vankxr/icyradio/software/driver/README.md

# Kernel driver
This folder contains the Linux kernel driver sources
