vankxr/icyradio/software/pmc/README.md

# Power Management Controller
This folder contains the software for the UPD301C power management controller
