vankxr/icyradio/software/exp/template/README.md

# Expansion Board Template Controller
This folder contains the software for the SAMD21 MCU in the expansion board template PCB
