vankxr/icyradio/docs/pm-block-diagram.png

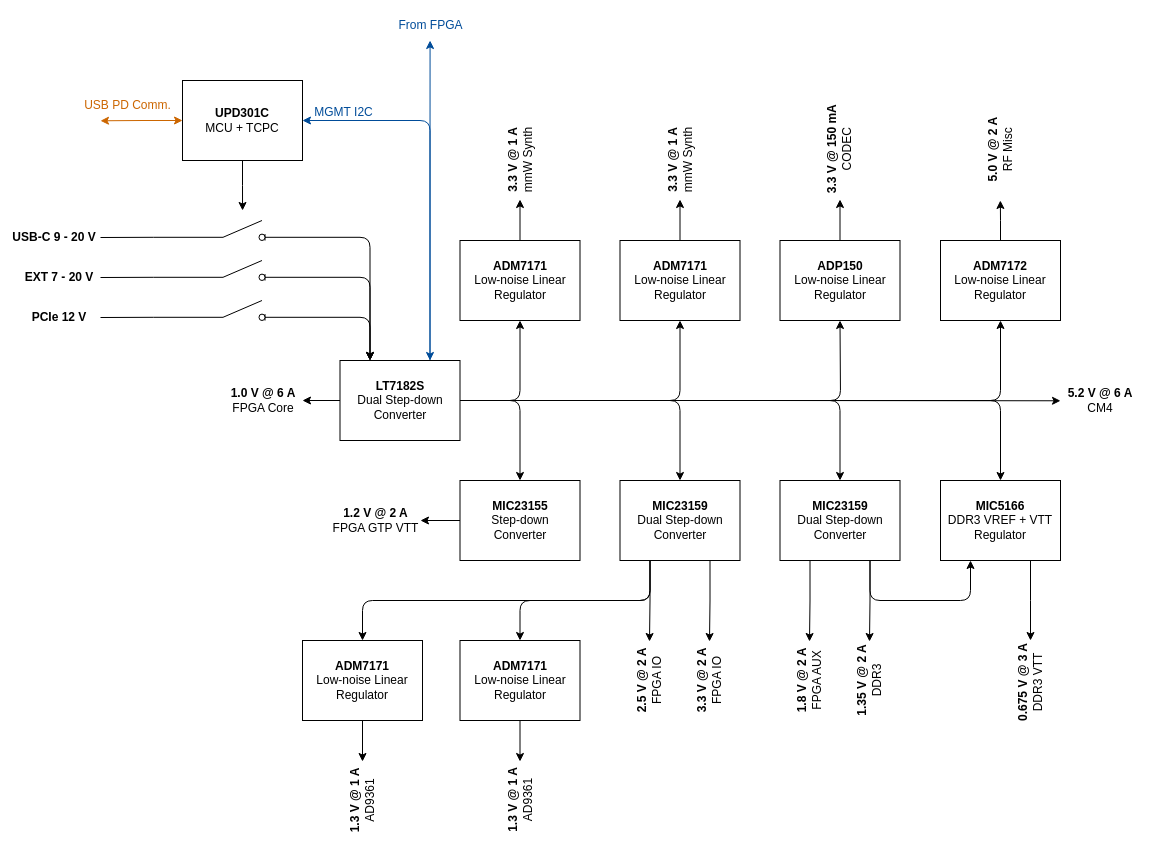
docs/pm-block-diagram.png
