vankxr/icyradio/pcb/exp-template/icyradio-exp-template-bot.png

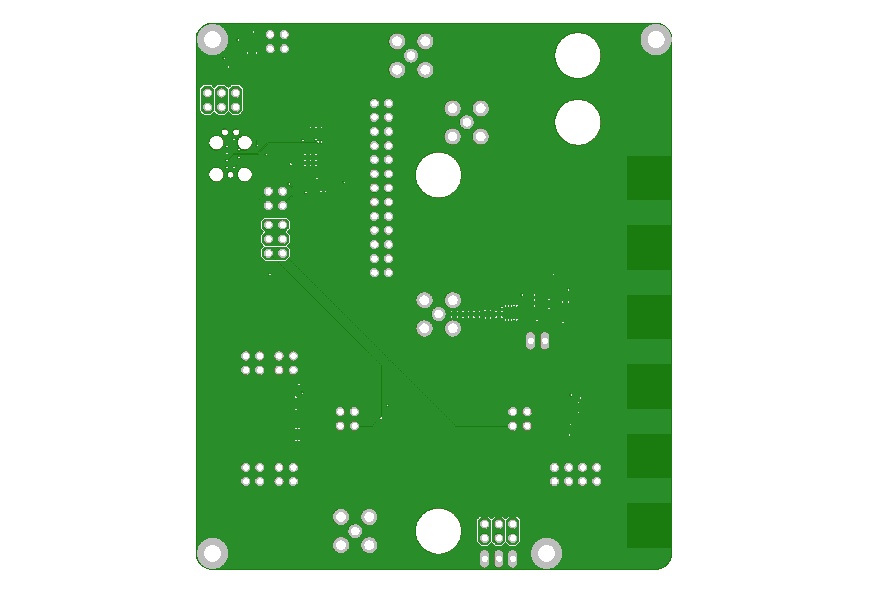
pcb/exp-template/icyradio-exp-template-bot.png
