vankxr/icyradio/pcb/exp-template/icyradio-exp-template-top.png

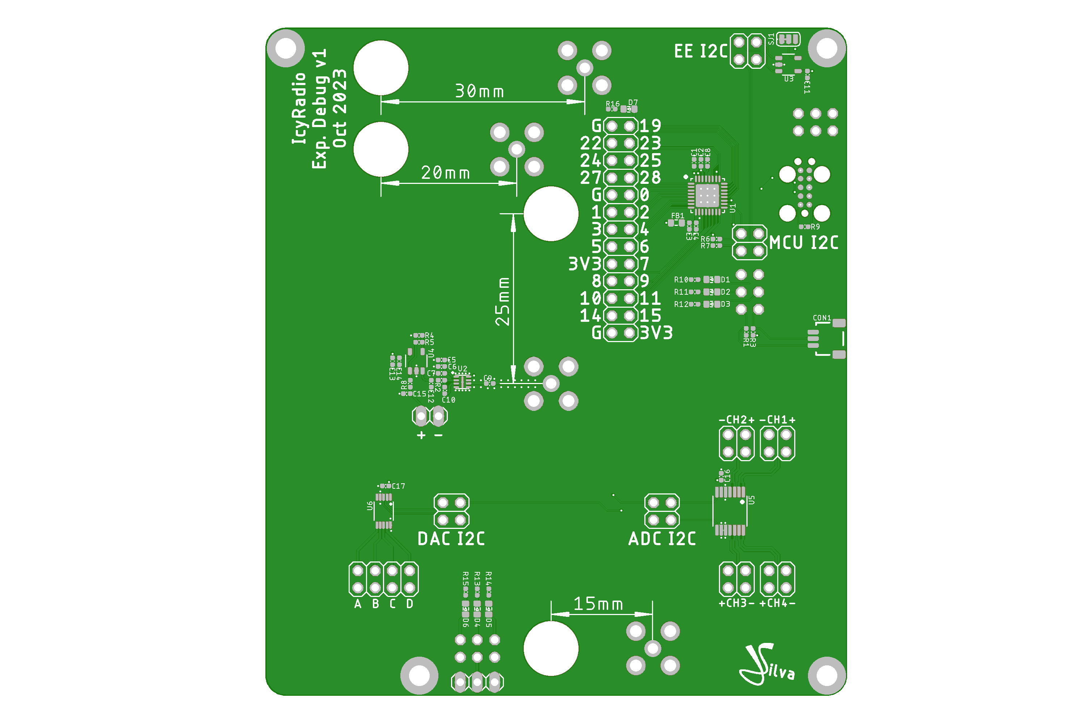
pcb/exp-template/icyradio-exp-template-top.png
