vankxr/icyradio/pcb/lna/icyradio-lna.bot.png

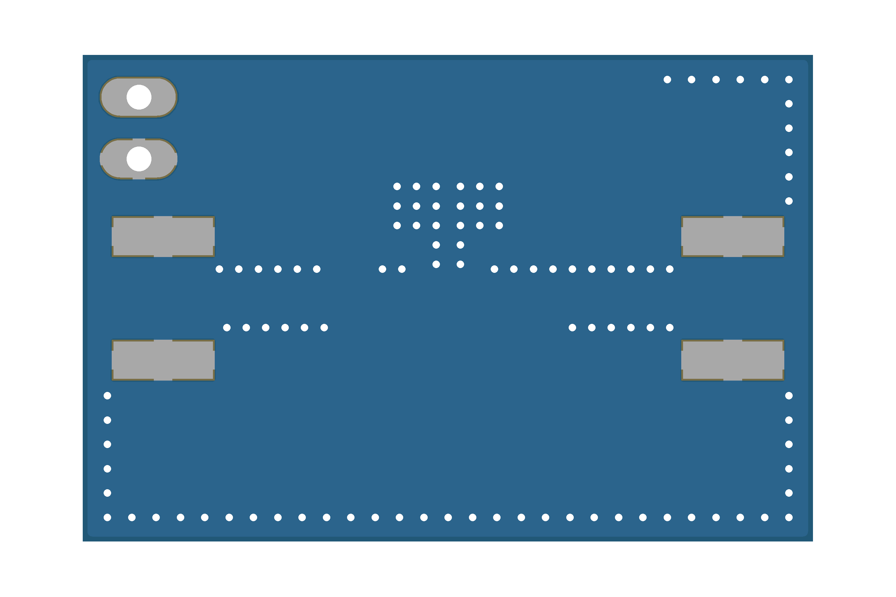
pcb/lna/icyradio-lna.bot.png
