vankxr/icyradio/pcb/lna/icyradio-lna.top.png

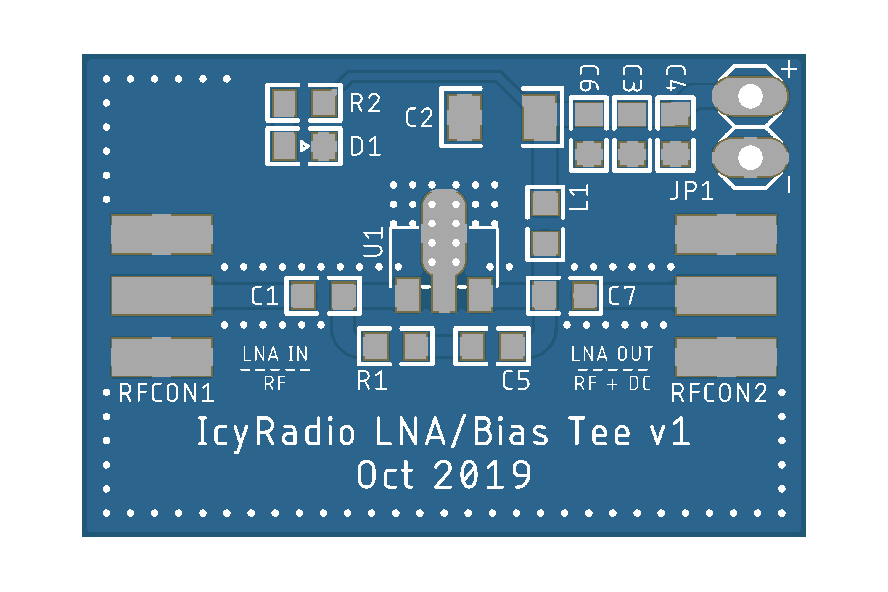
pcb/lna/icyradio-lna.top.png
