vankxr/icyradio/pcb/main/icyradio-main.bot.png

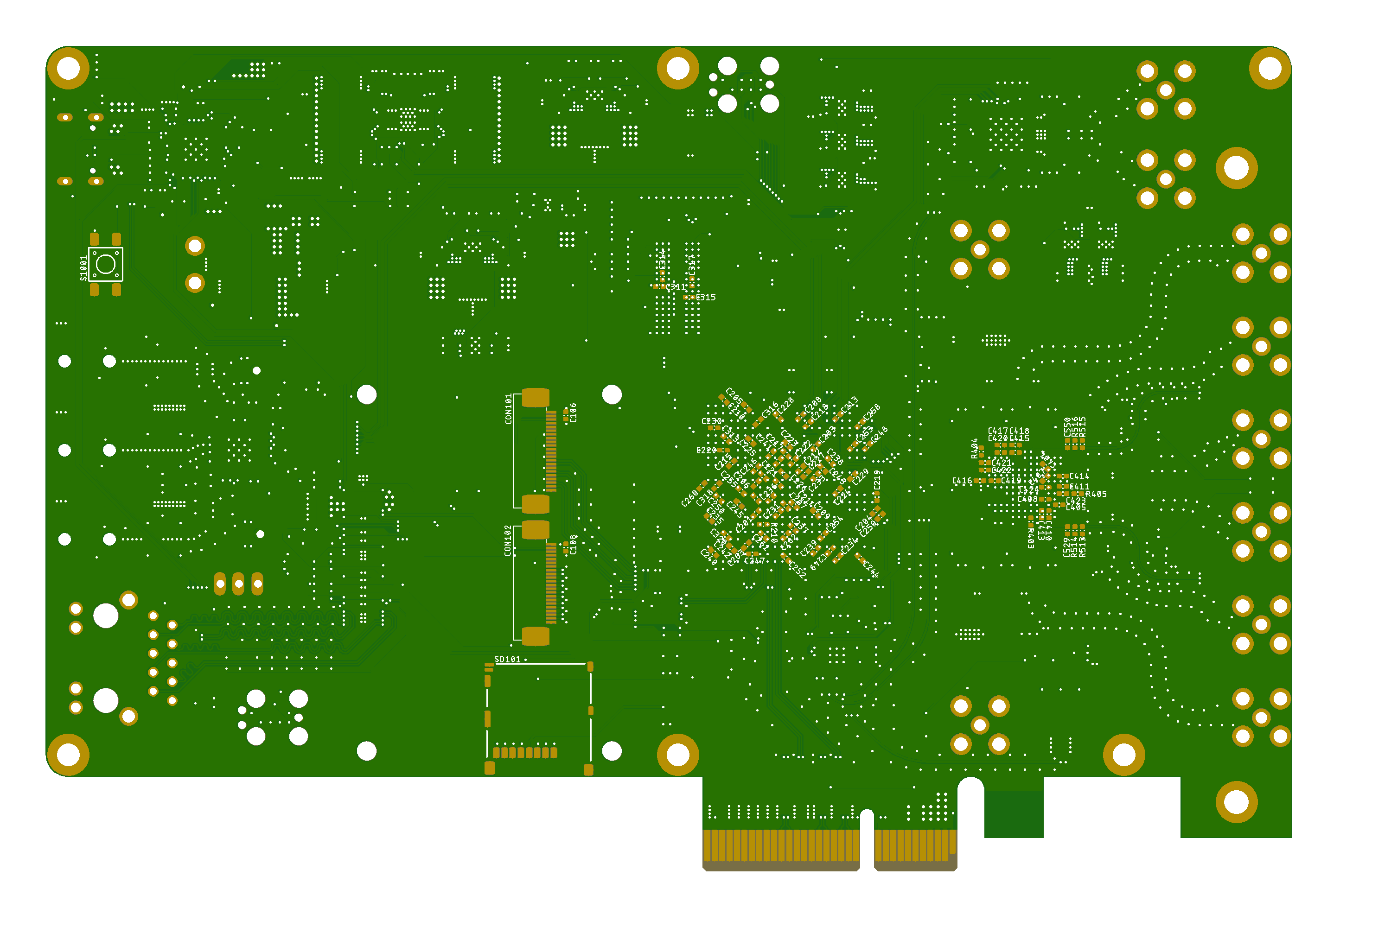
pcb/main/icyradio-main.bot.png
