vankxr/icyradio/pcb/main/icyradio-main.pdf

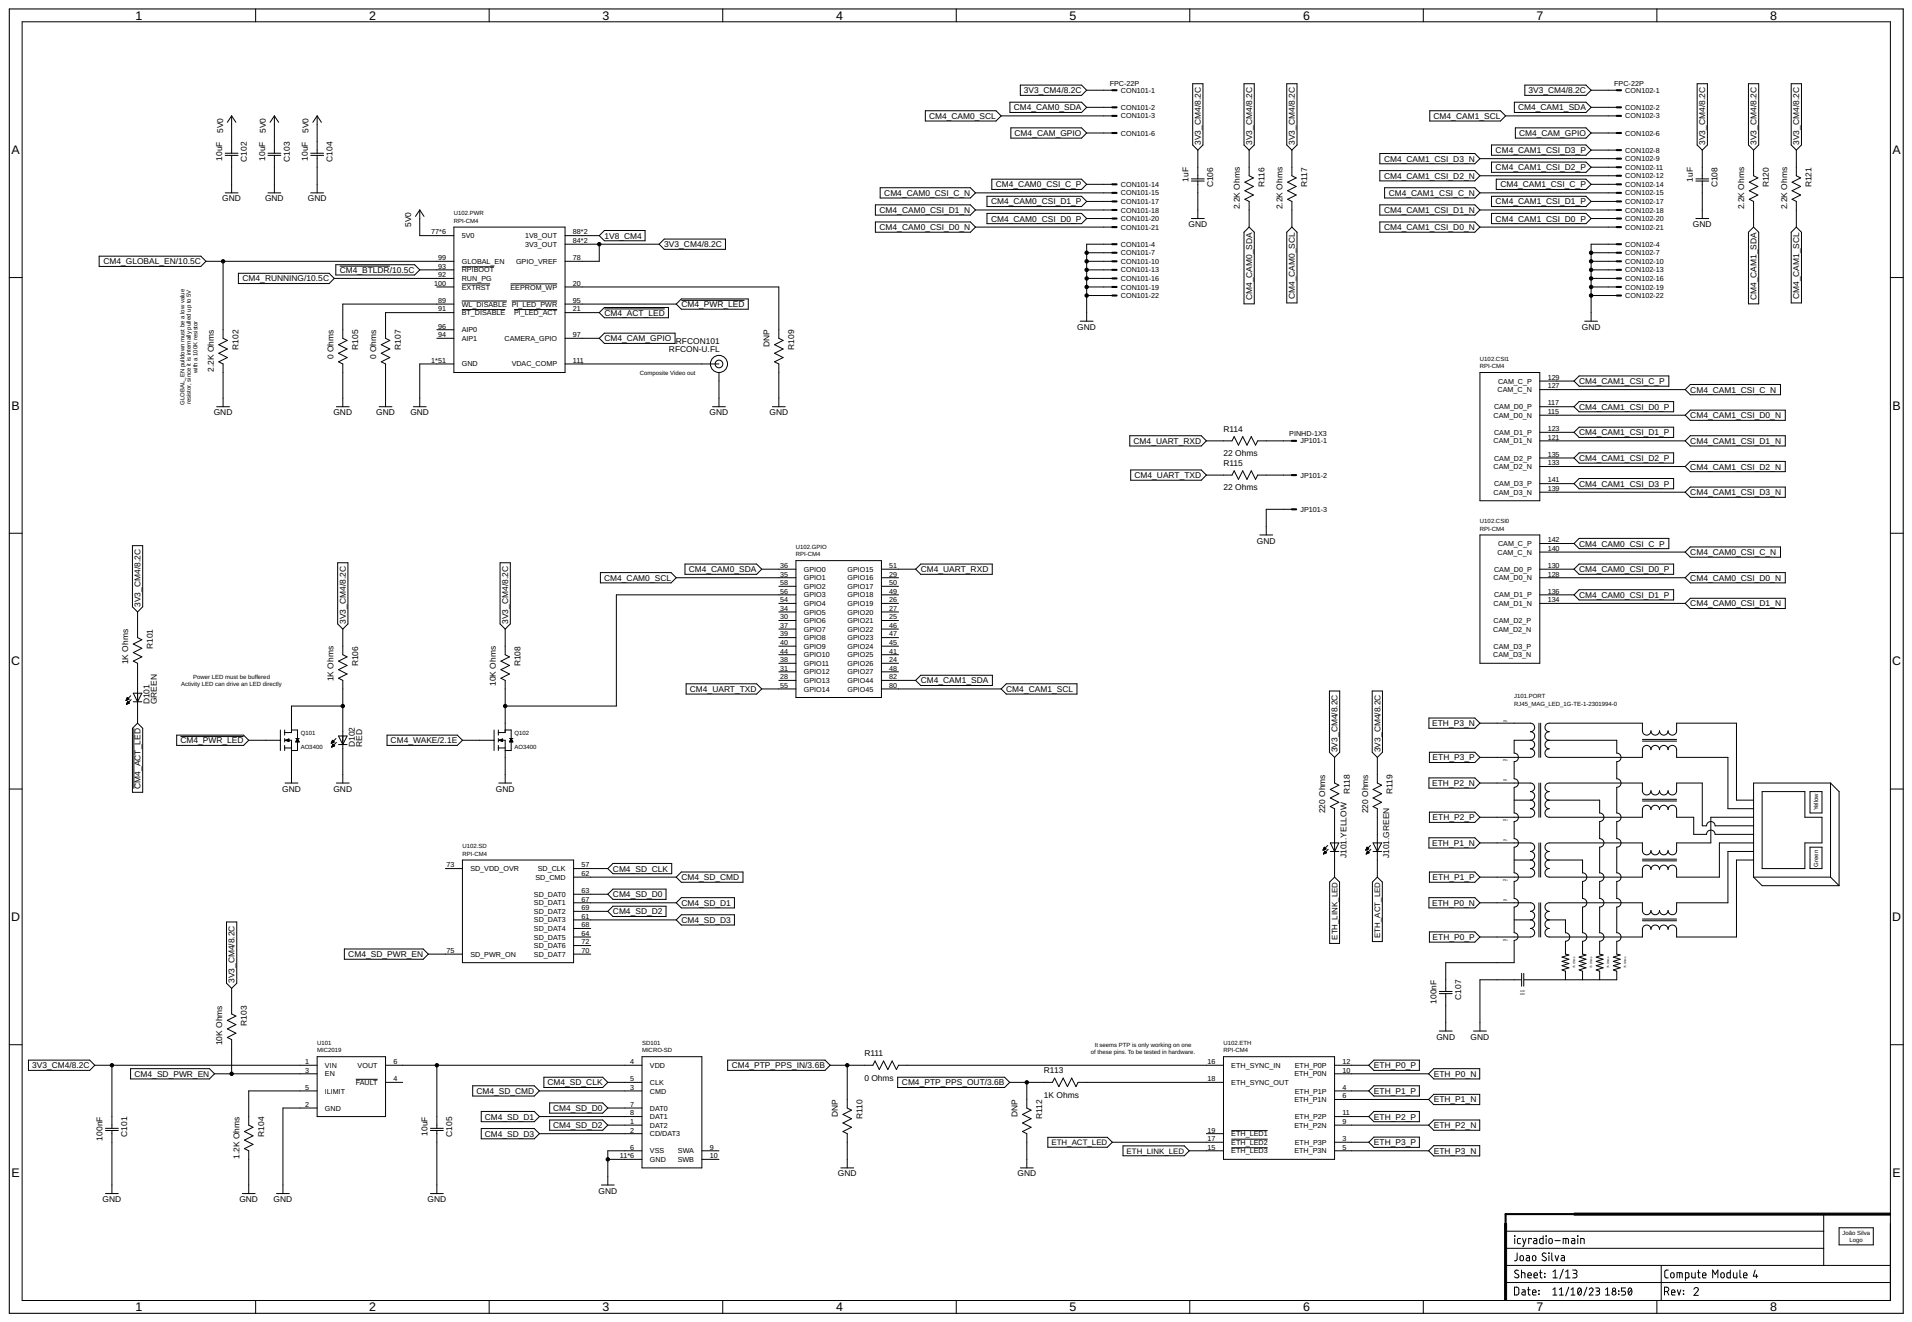
[picture p11: page 1]

GLOBAL_EN pulldown must be a low value

resistor, since it is internally pulled up to 5V with a 100K resistor

Power LED must be buffered Activity LED can drive an LED directly

It seems PTP is only working on one
of these pins. To be tested in hardware.

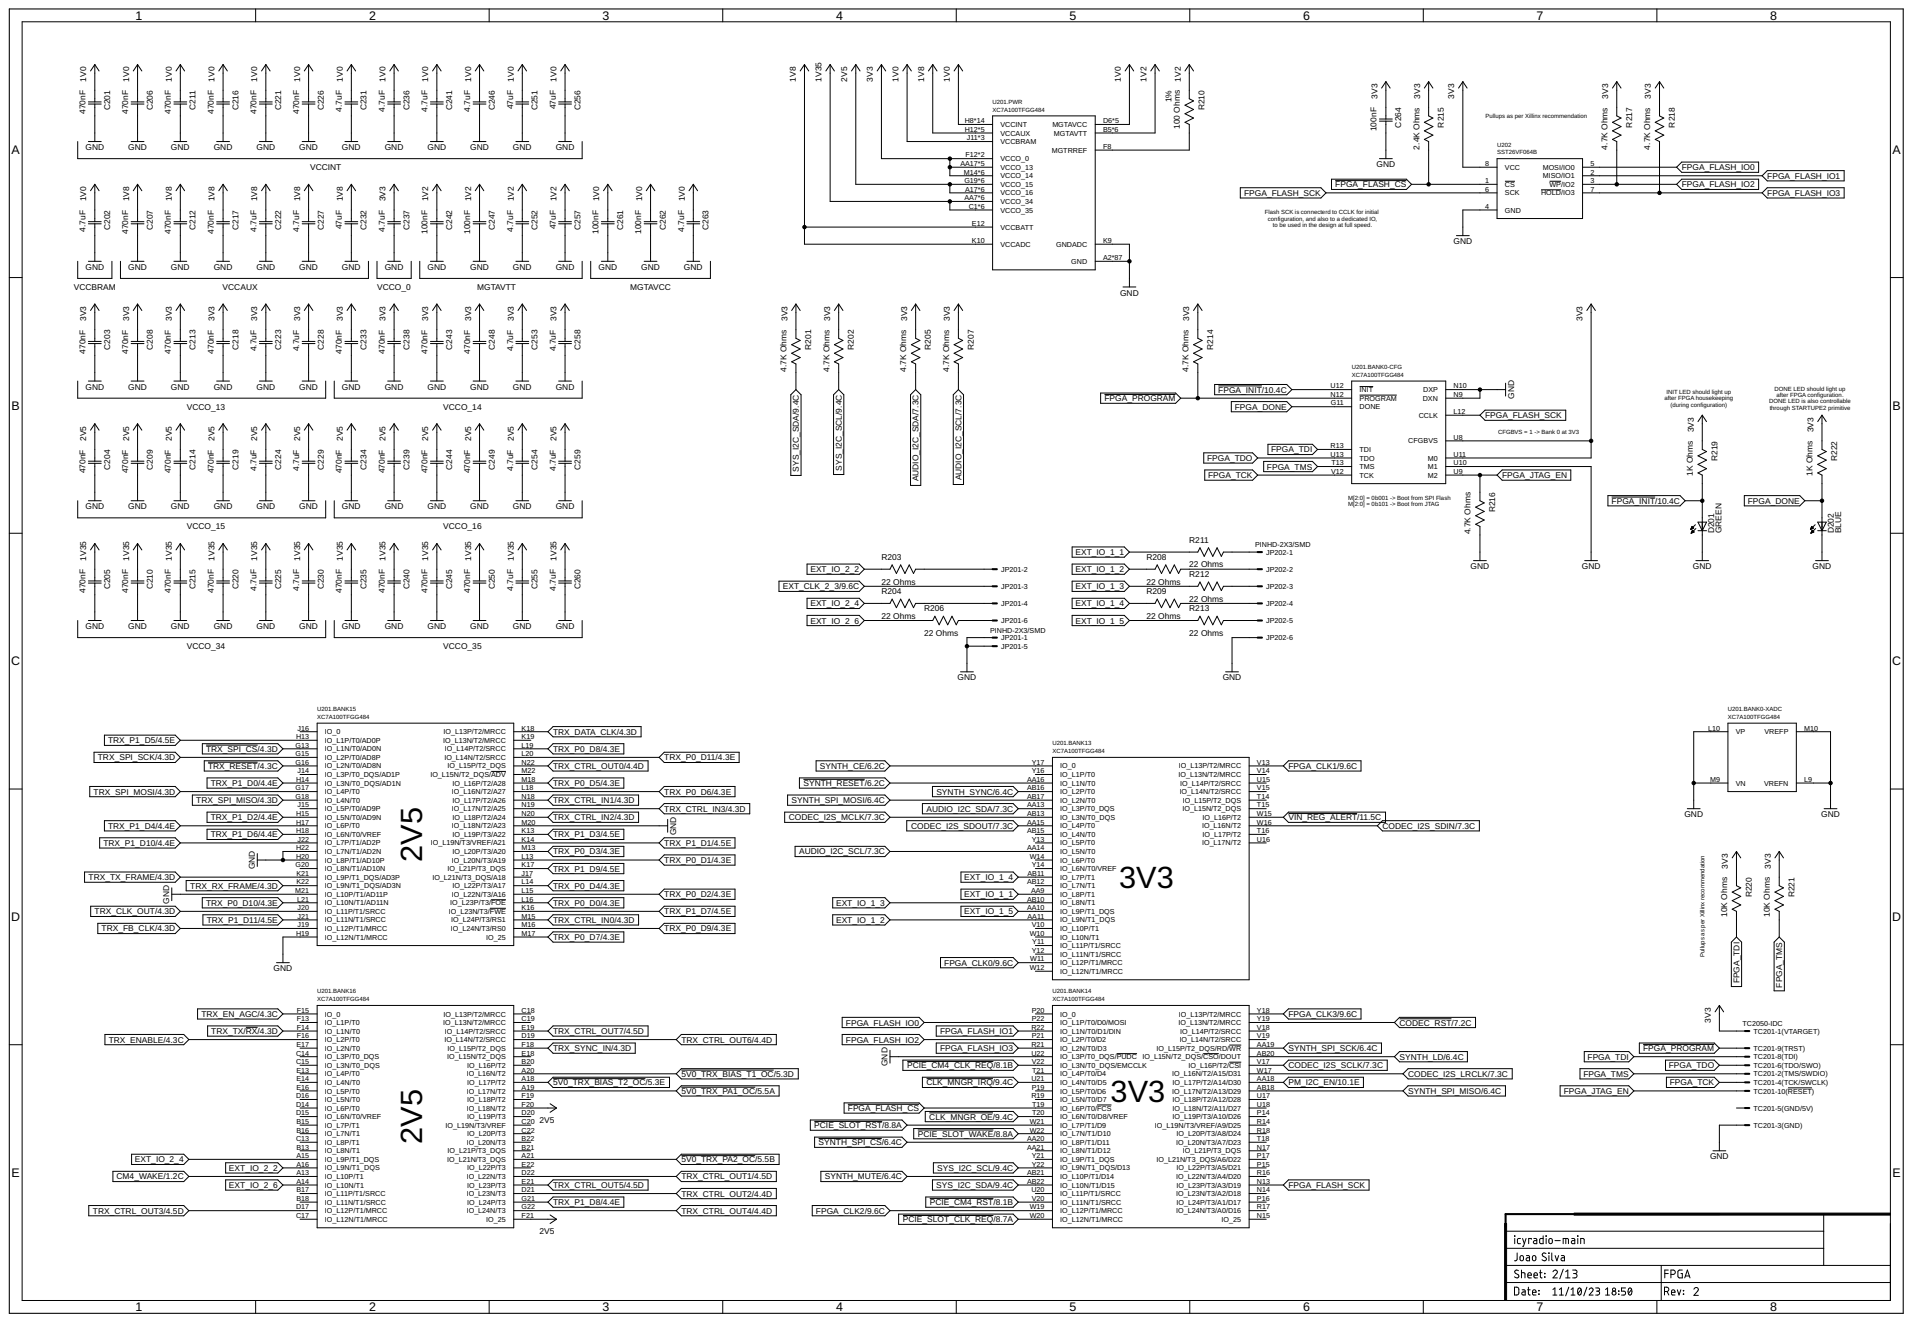
[picture p12: page 2]

Pullups as per Xillinx recommendation

Flash SCK is connecterd to CCLK for initial configuration, and also to a dedicated IO,

to be used in the design at full speed.

INIT LED should light up
after FPGA housekeeping

after FPGA configuration. DONE LED is also controllable

M[2:0] = 0b001 -> Boot from SPI Flash M[2:0] = 0b101 -> Boot from JTAG

22 Ohms 22 Ohms 22 Ohms 22 Ohms 22 Ohms GND

TC2050-IDC
TC201-1(VTARGET) TC201-2(TMS/SWDIO) TC201-3(GND)

TC201-9(TRST)
TC201-6(TDO/SWO) TC201-10(RESET) TC201-8(TDI)

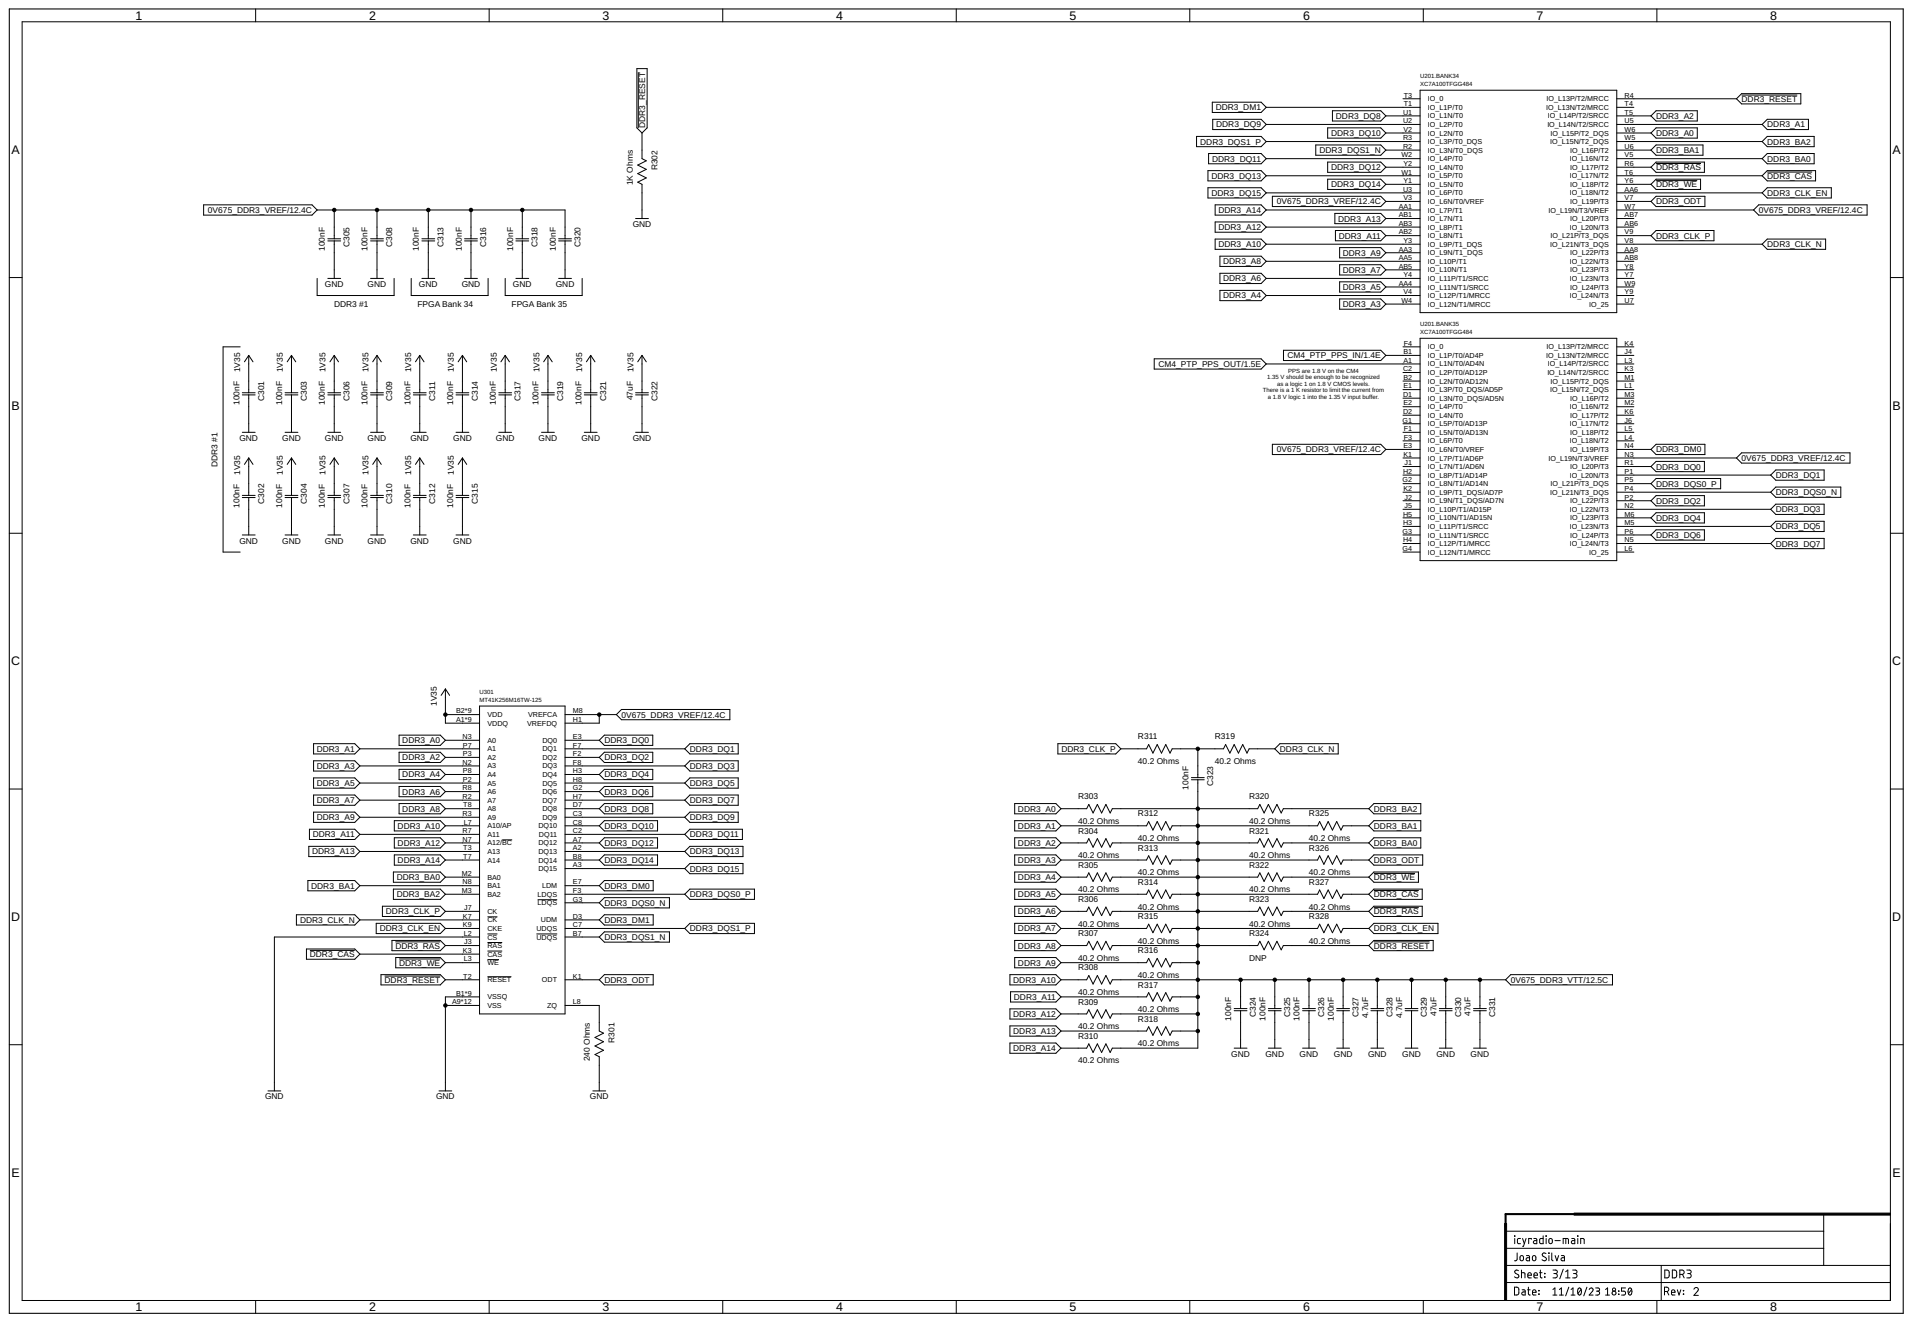
[picture p13: page 3]

1.35 V should be enough to be recognized
as a logic 1 on 1.8 V CMOS levels. There is a 1 K resistor to limit the current from

PPS are 1.8 V on the CM4

a 1.8 V logic 1 into the 1.35 V input buffer.

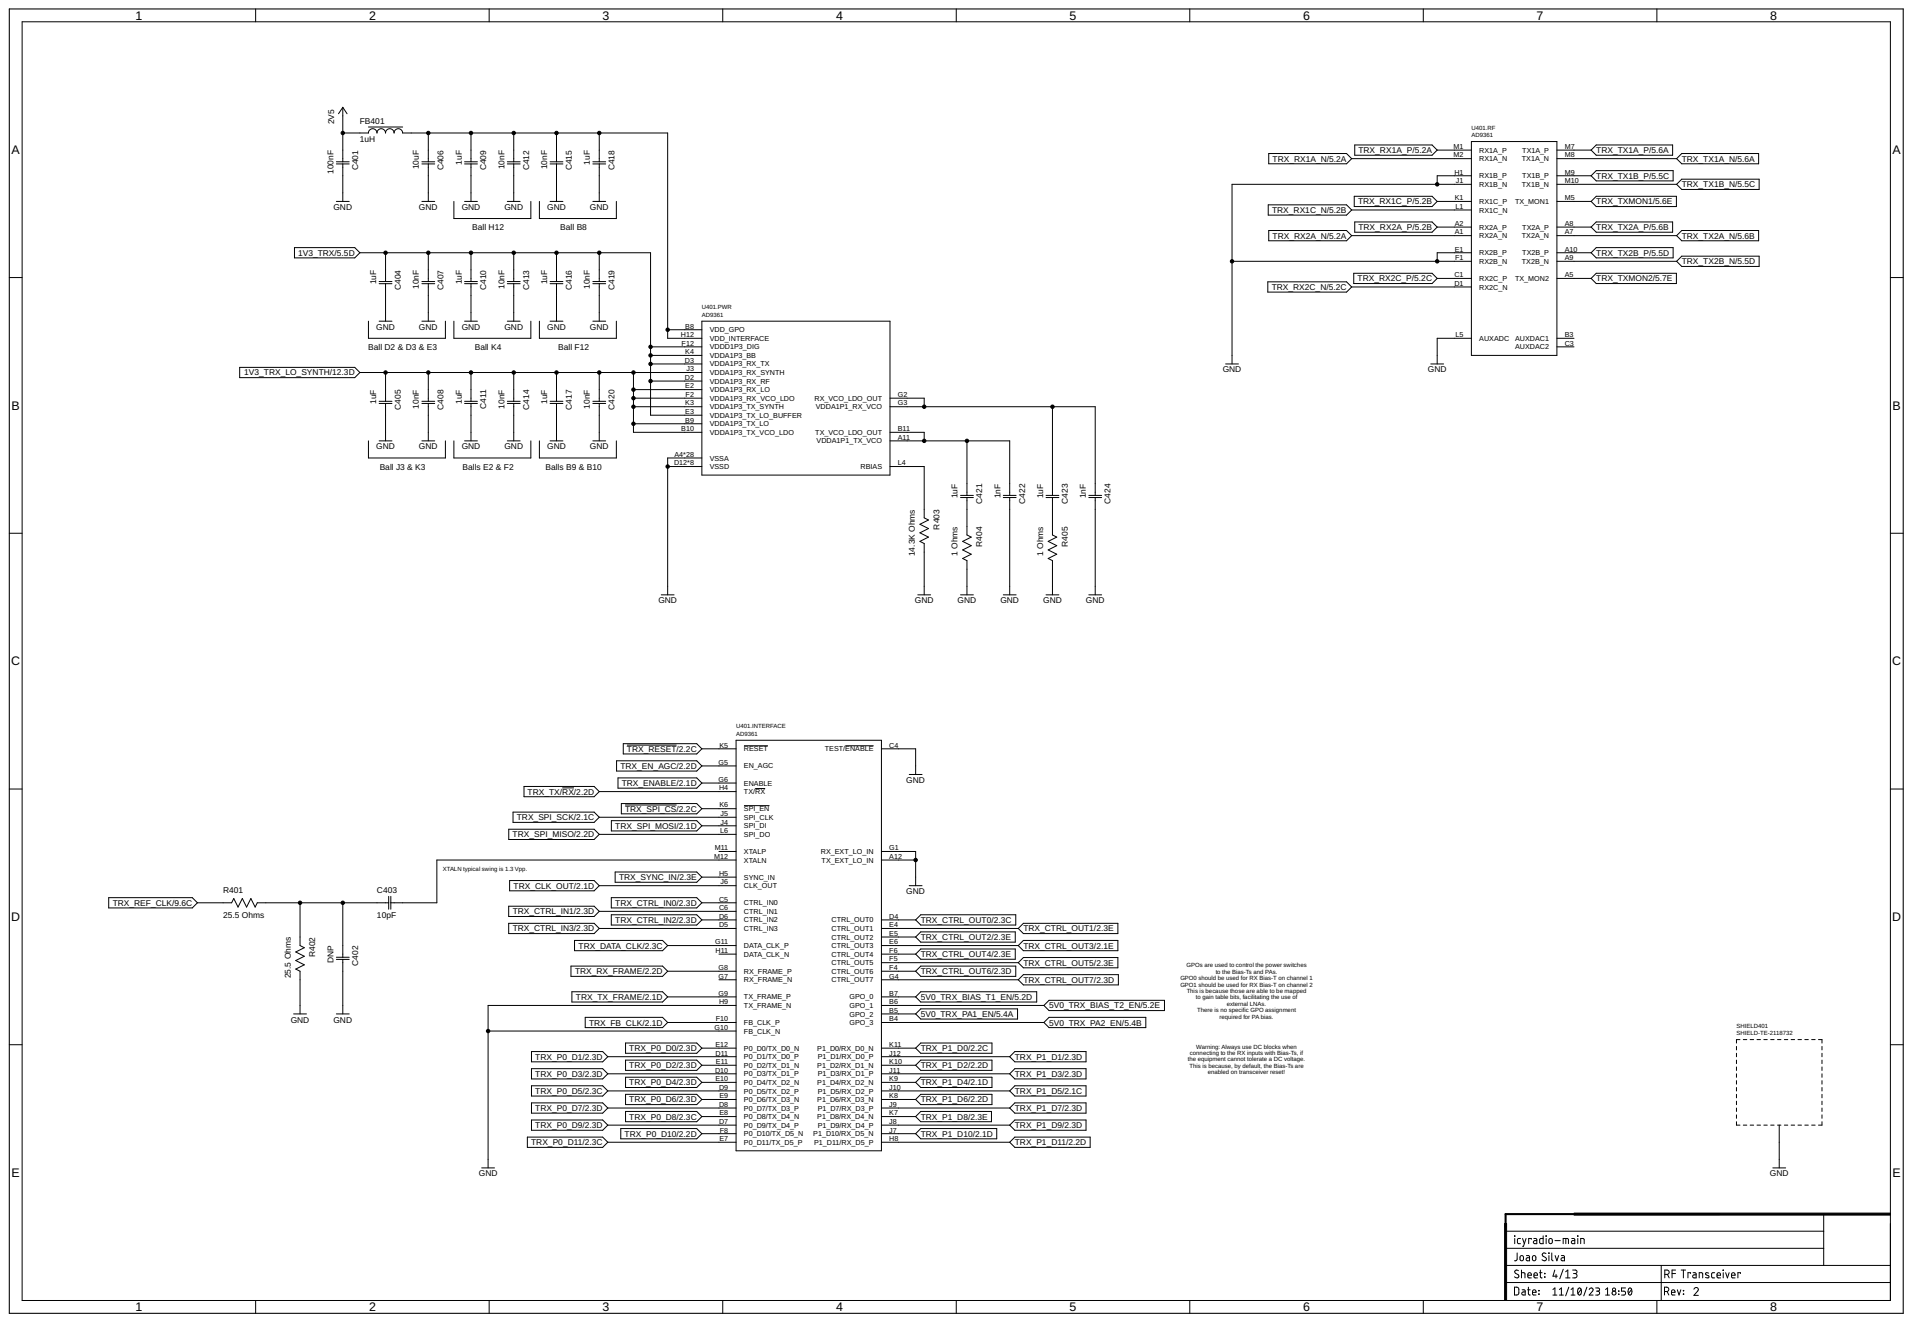
[picture p14: page 4]

XTALN typical swing is 1.3 Vpp.

GPOs are used to control the power switches
to the Bias-Ts and PAs. GPO0 should be used for RX Bias-T on channel 1 GPO1 should be used for RX Bias-T on channel 2 This is because those are able to be mapped

to gain table bits, facilitating the use of external LNAs. There is no specific GPO assignment required for PA bias. Warning: Always use DC blocks when

connecting to the RX inputs with Bias-Ts, if
the equipment cannot tolerate a DC voltage. This is because, by default, the Bias-Ts are

enabled on transceiver reset!

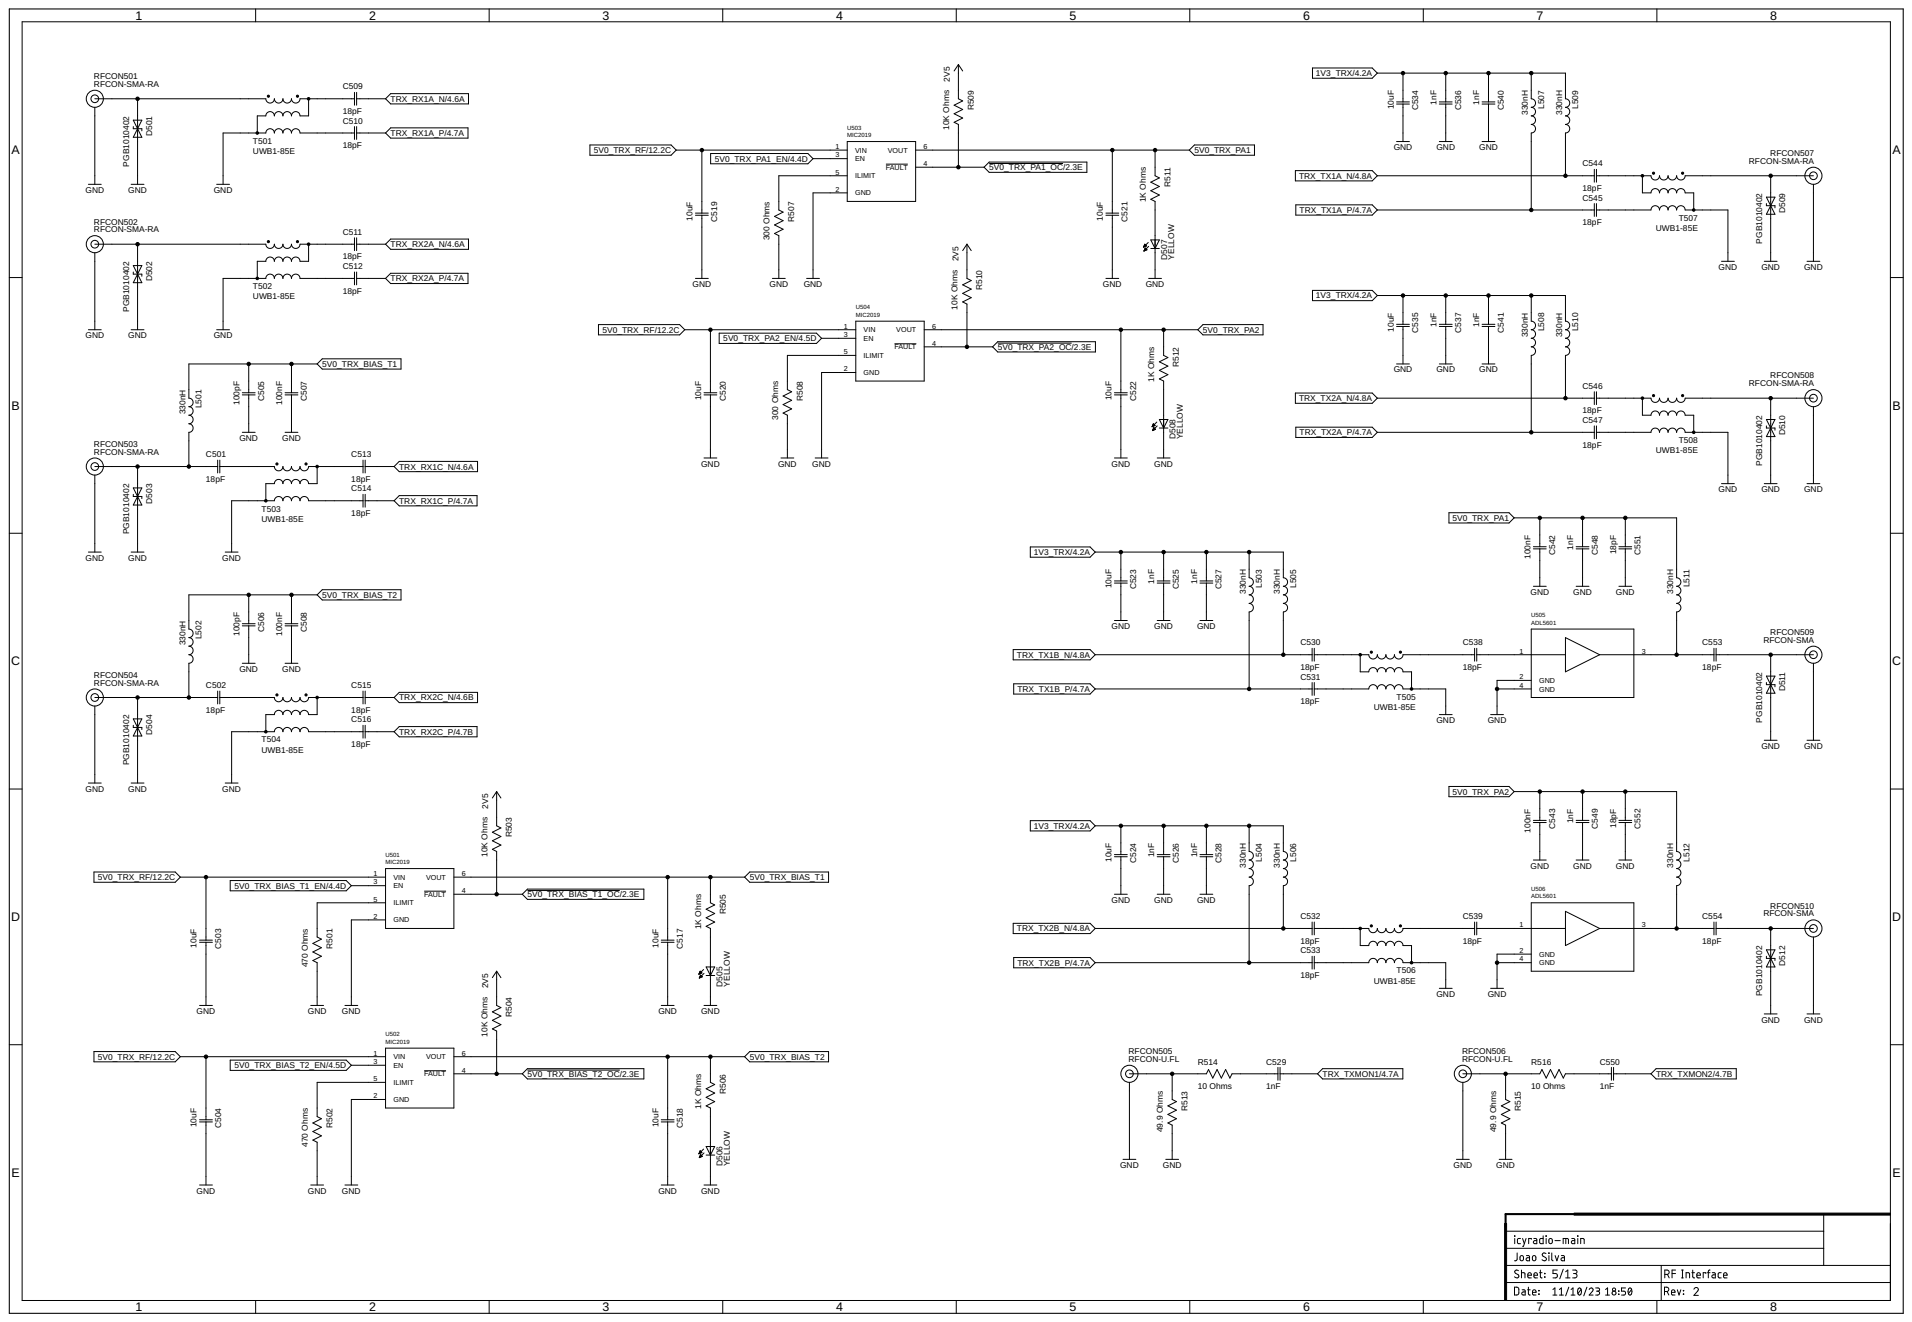
[picture p15: page 5]

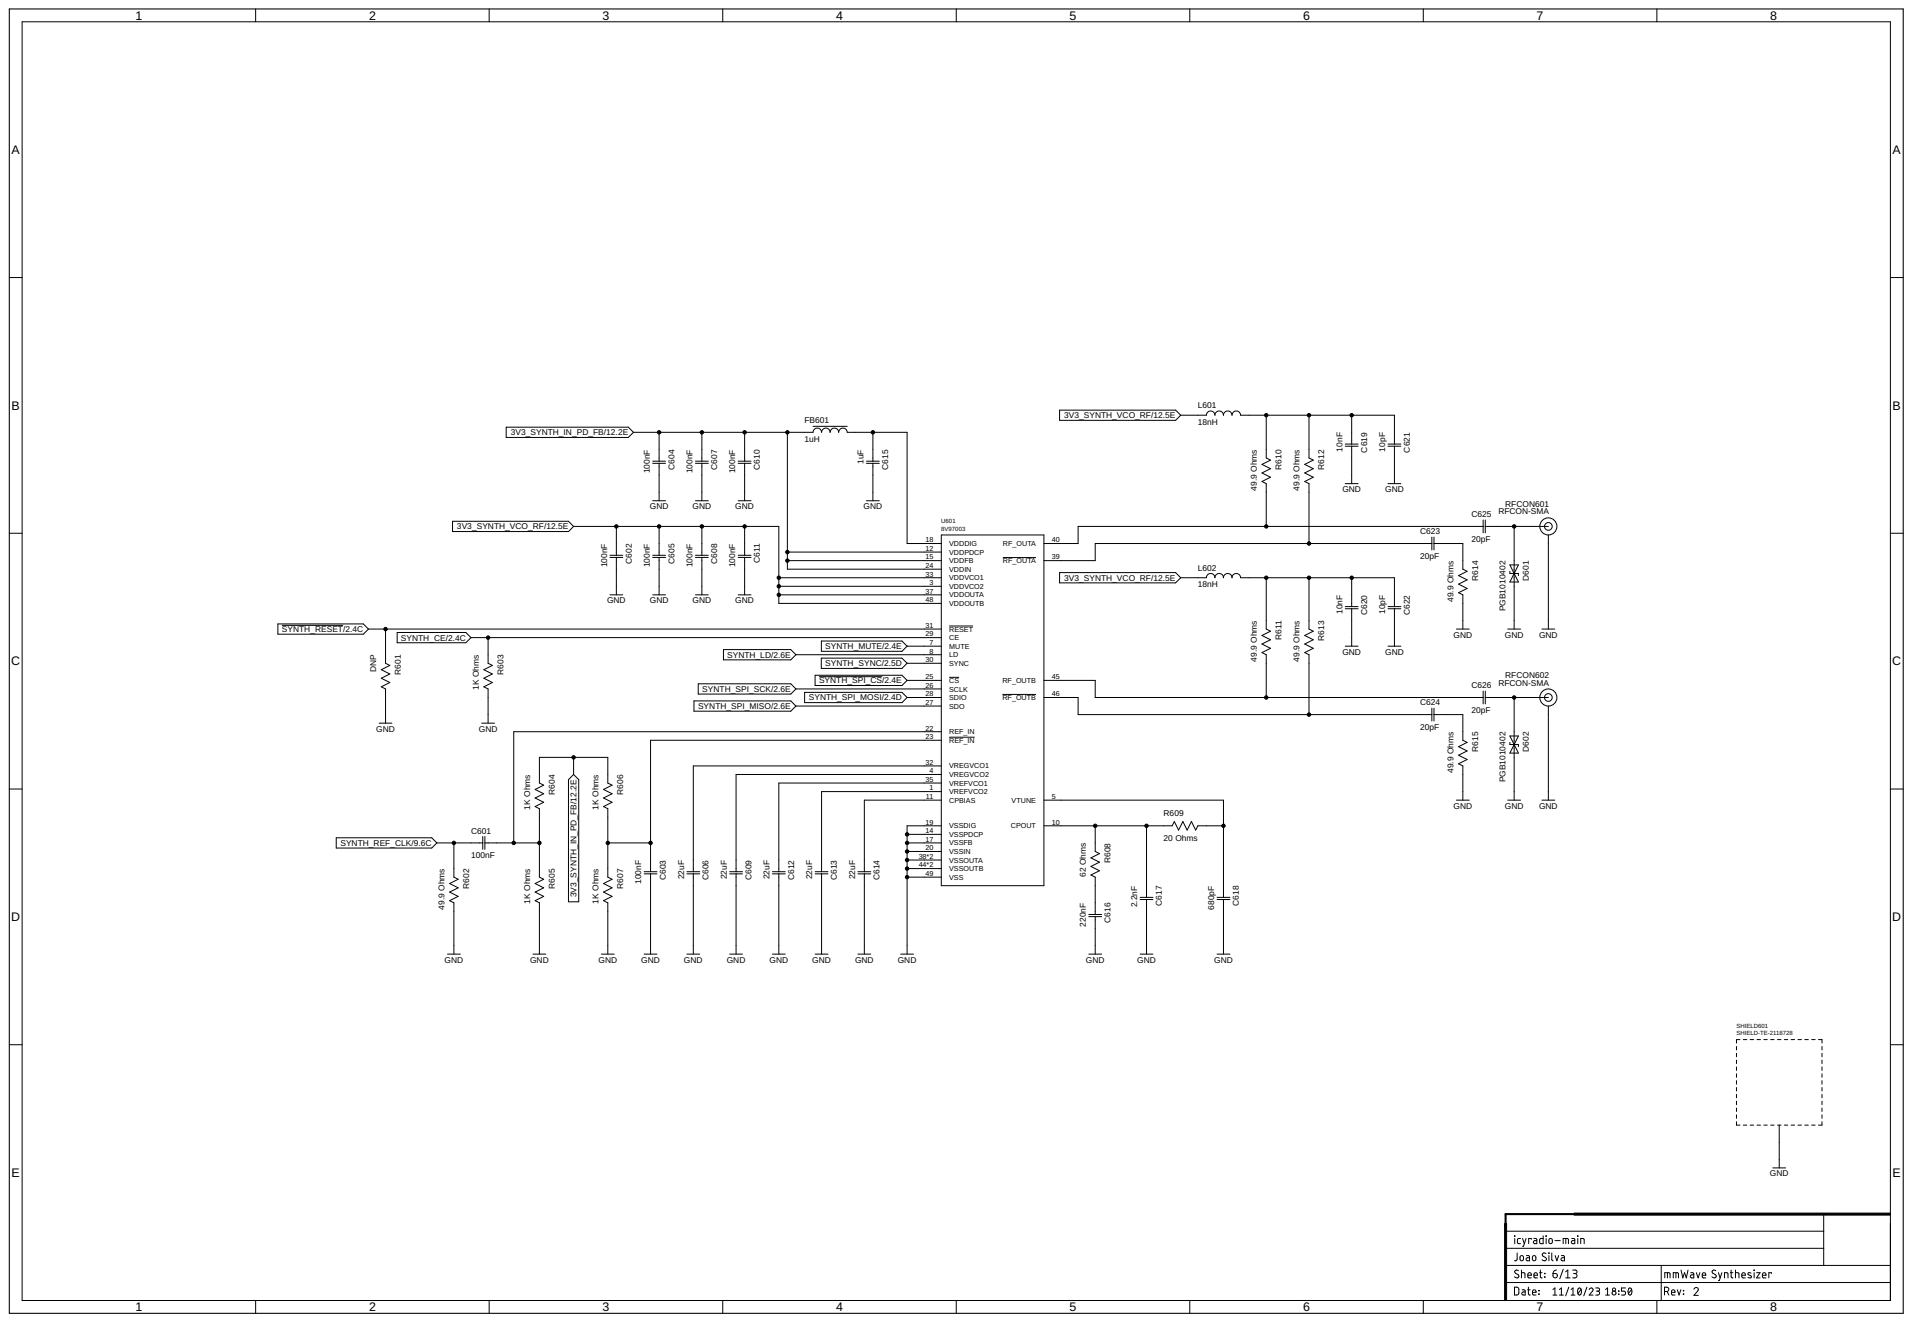
[picture p16: page 6]

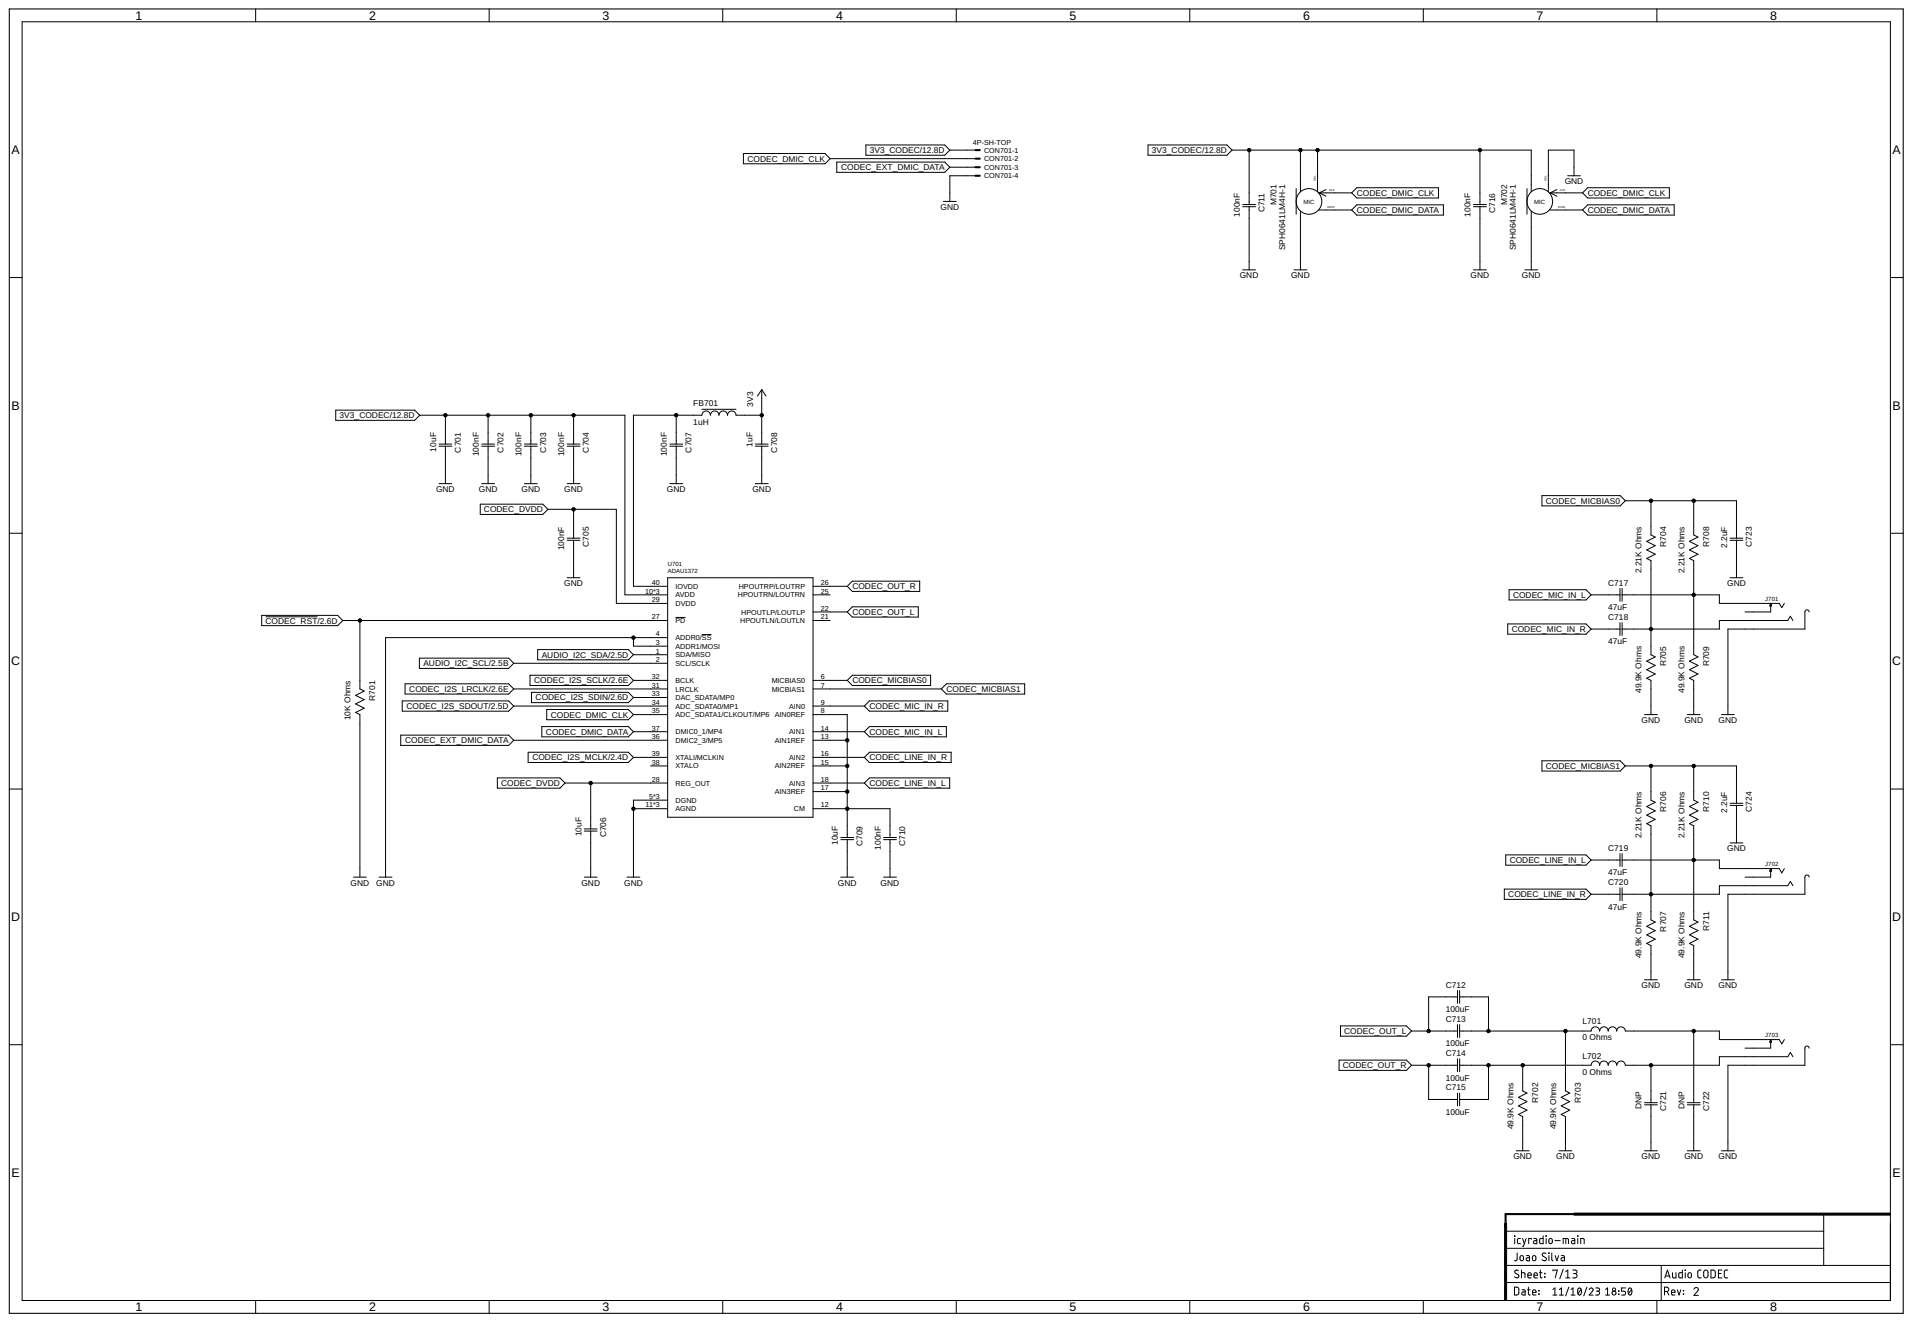
[picture p17: page 7]

100nF GND GND GND GND

49.9K Ohms GND GND GND

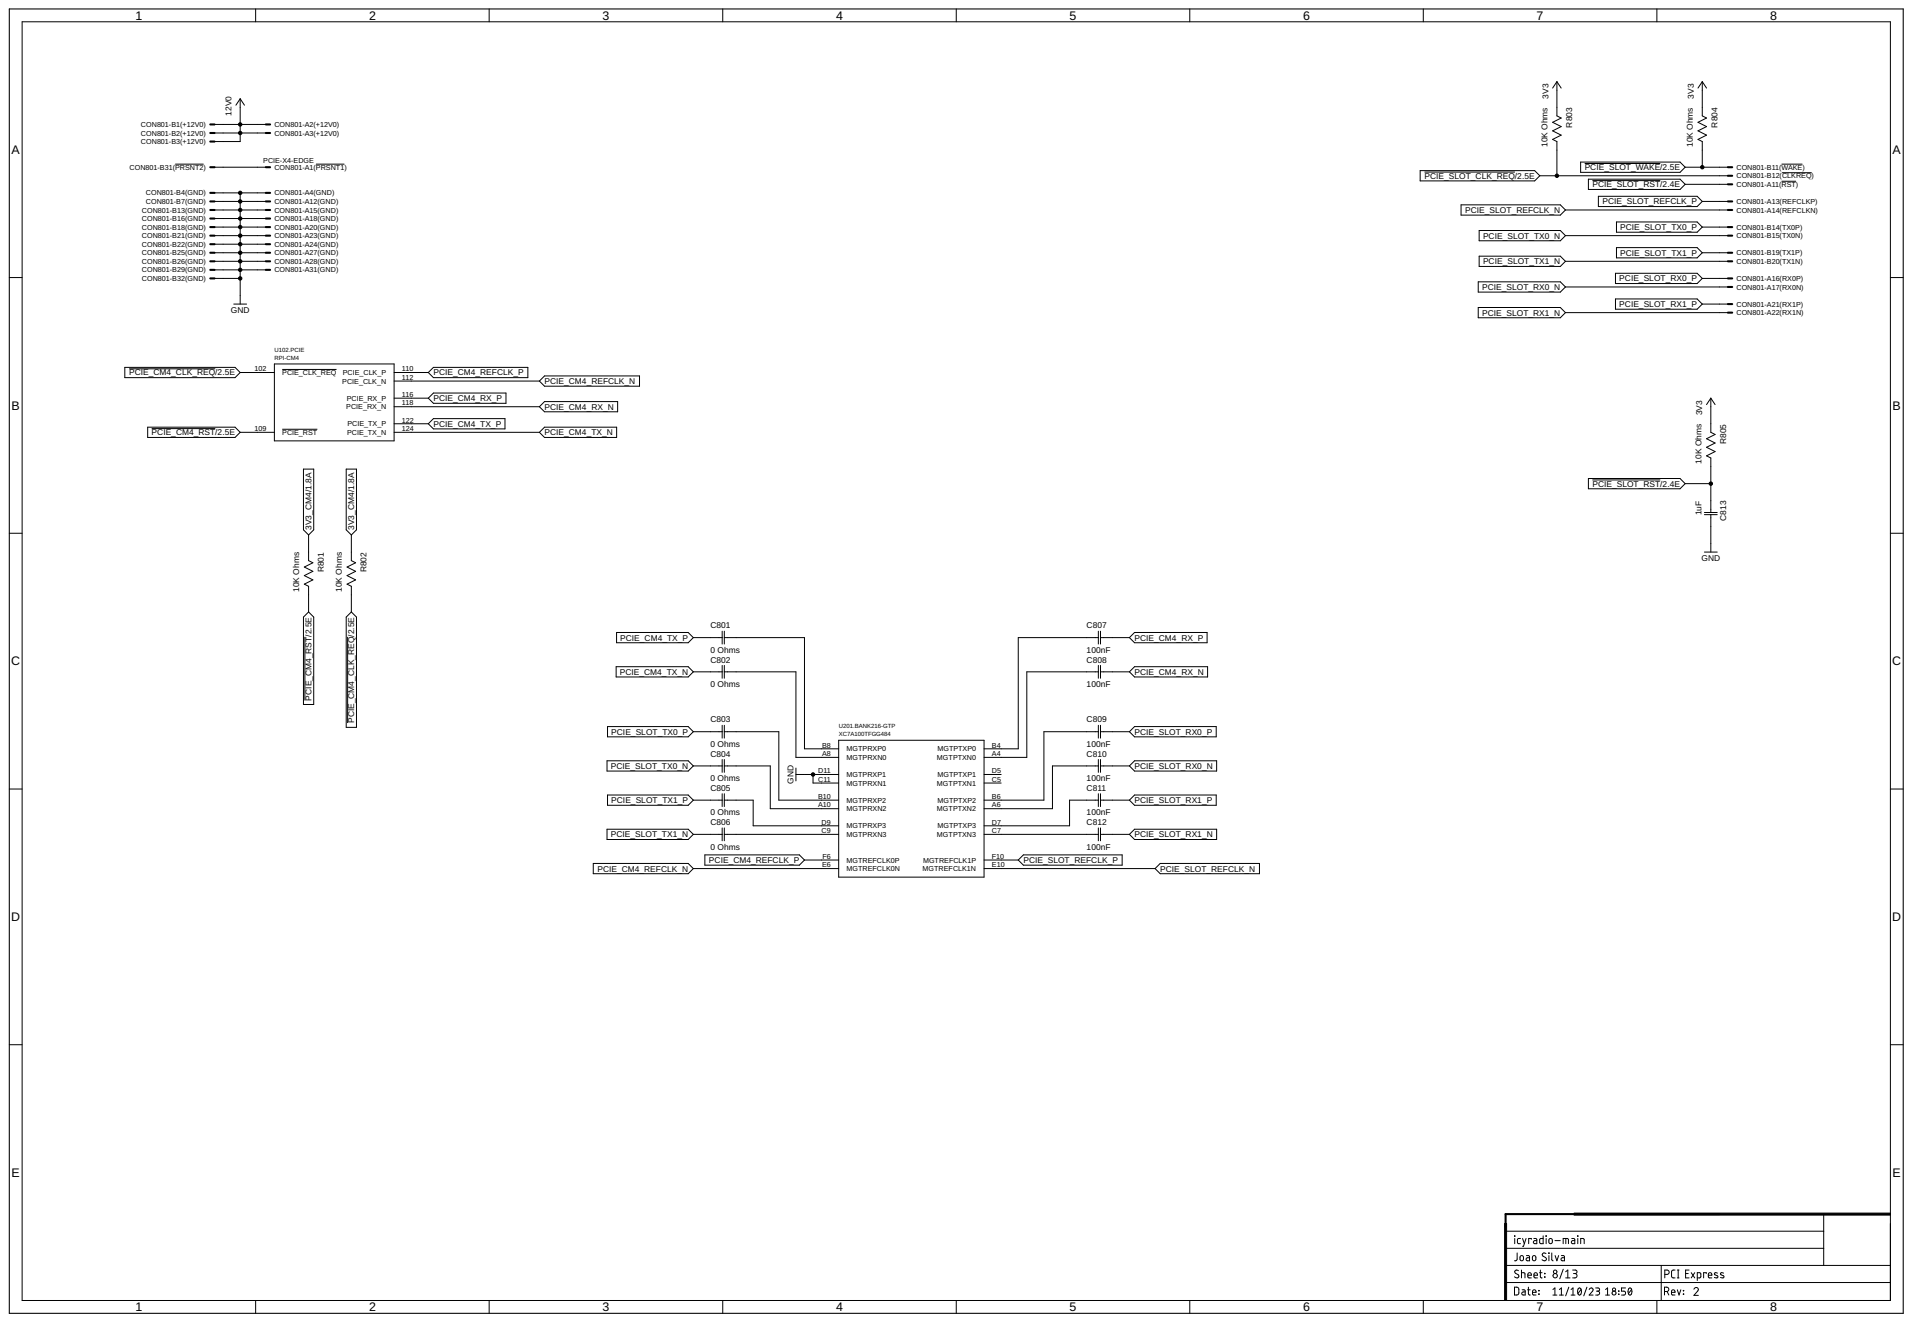
[picture p18: page 8]

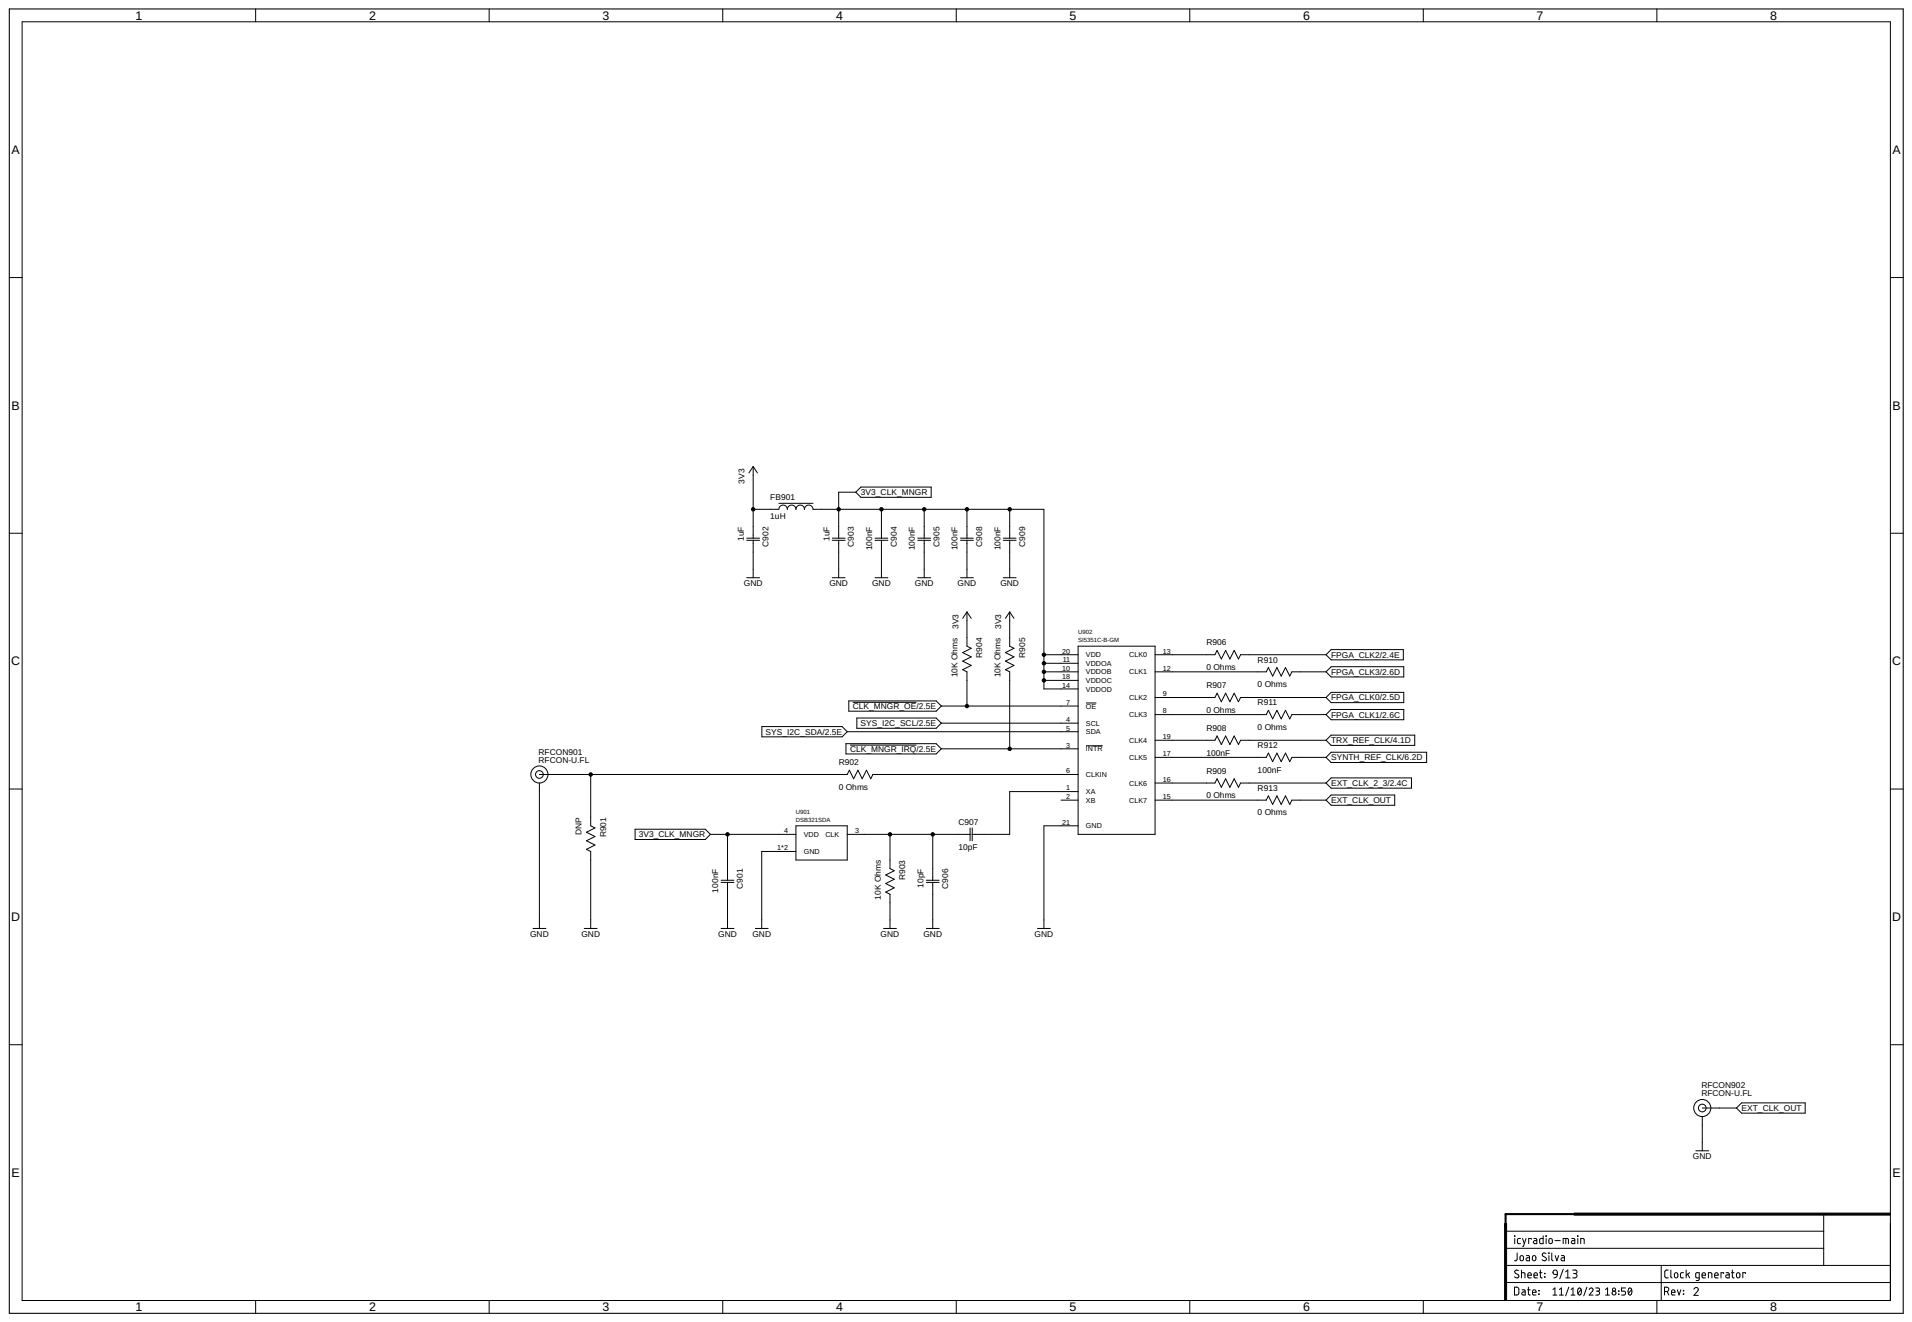
[picture p19: page 9]

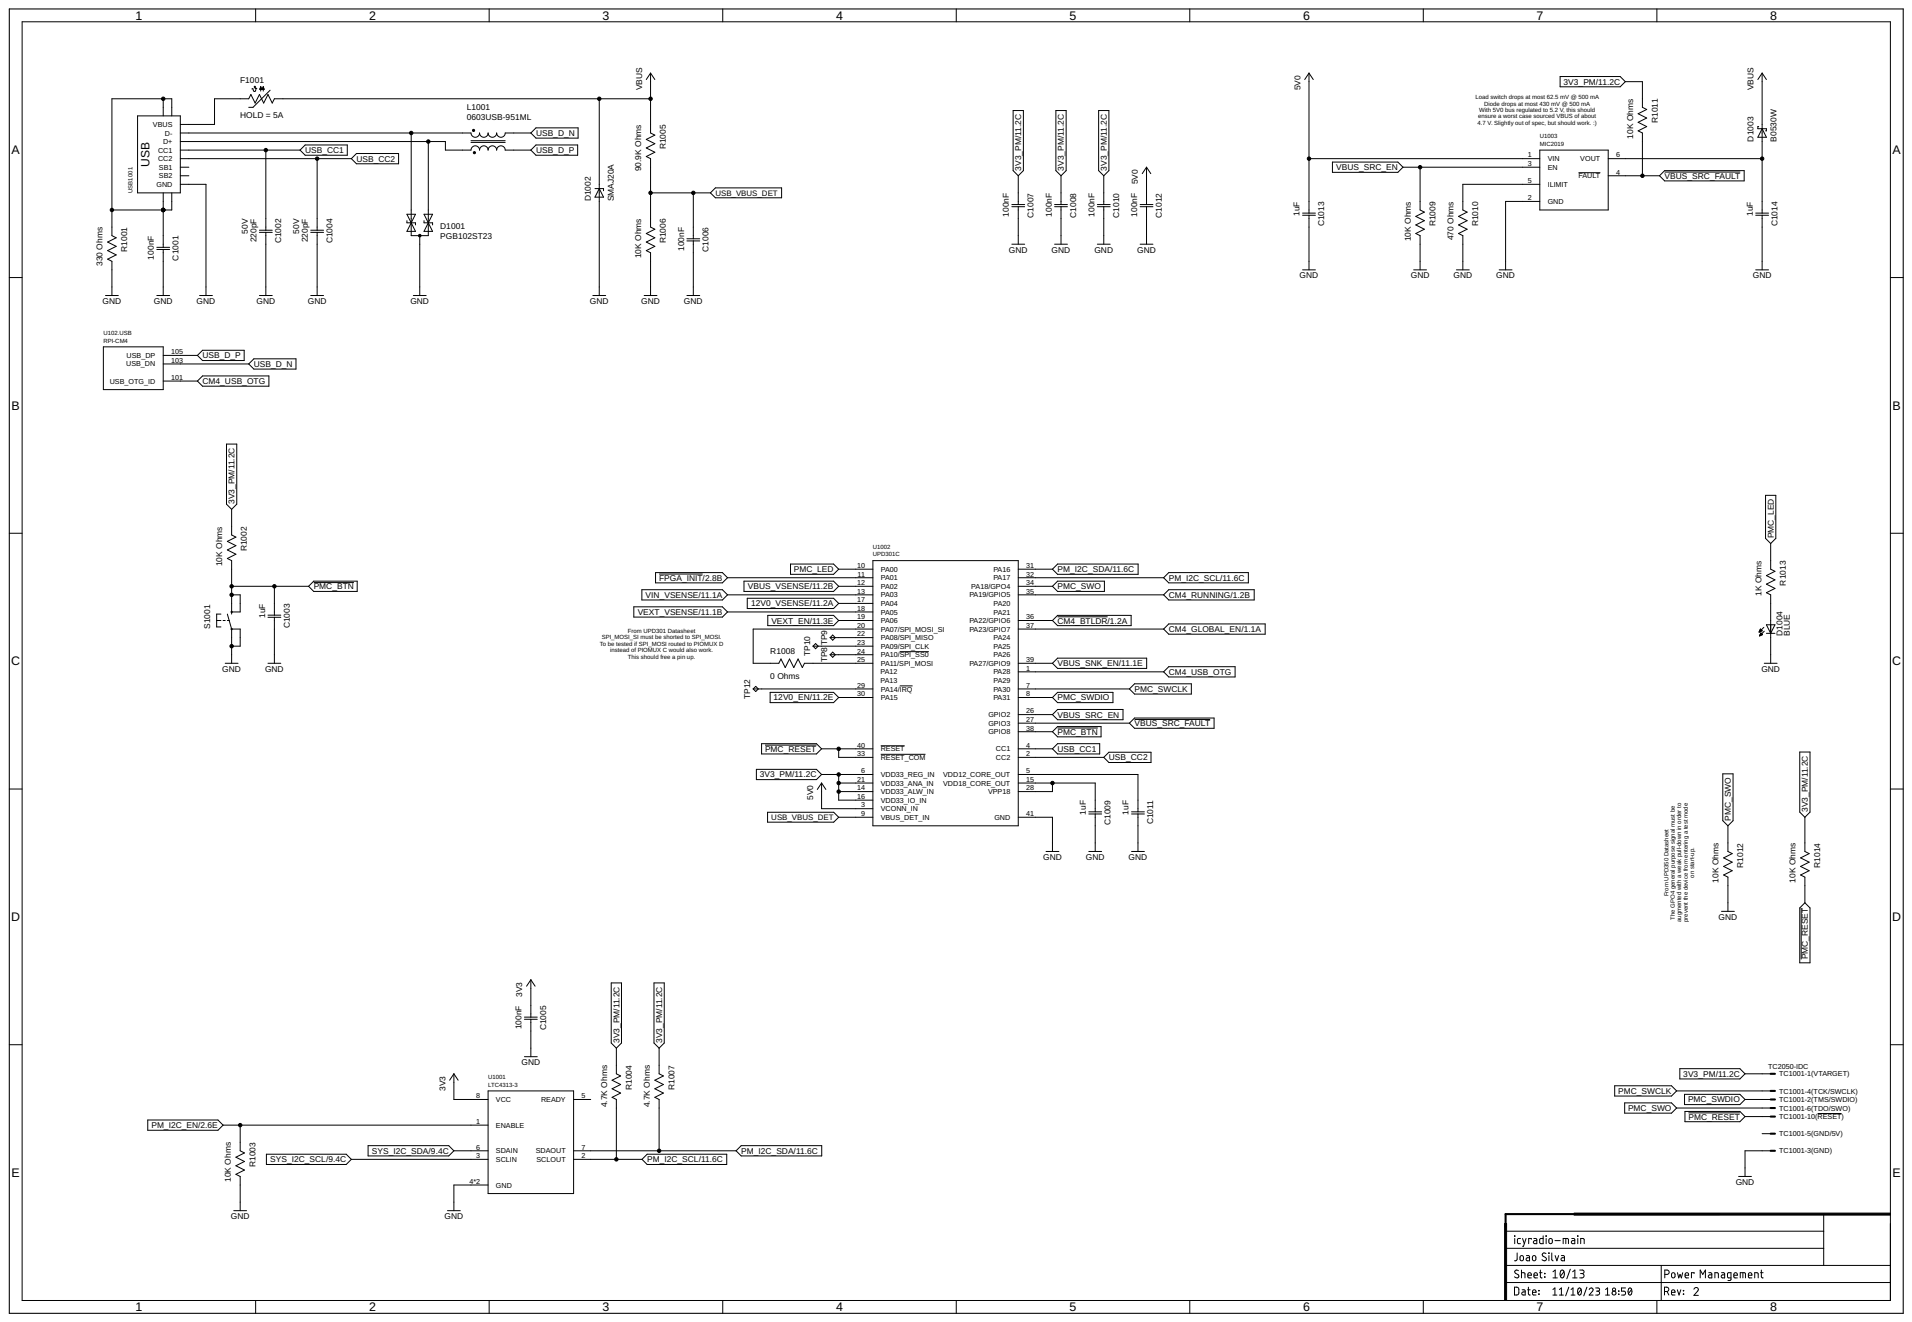
[picture p20: page 10]

Load switch drops at most 62.5 mV @ 500 mA Diode drops at most 430 mV @ 500 mA With 5V0 bus regulated to 5.2 V, this should

ensure a worst case sourced VBUS of about 4.7 V. Slightly out of spec, but should work. :)

From UPD301 Datasheet SPI_MOSI_SI must be shorted to SPI_MOSI. To be tested if SPI_MOSI routed to PIOMUX D

instead of PIOMUX C would also work. This should free a pin up.

augmented with a weak pull-down in order to

prevent the device from entering a test mode

From UPD350 Datasheet The GPO4 general purpose signal must be

TC2050-IDC
TC1001-1(VTARGET) TC1001-2(TMS/SWDIO) TC1001-3(GND)

TC1001-4(TCK/SWCLK) TC1001-5(GND/5V) TC1001-6(TDO/SWO) TC1001-10(RESET)

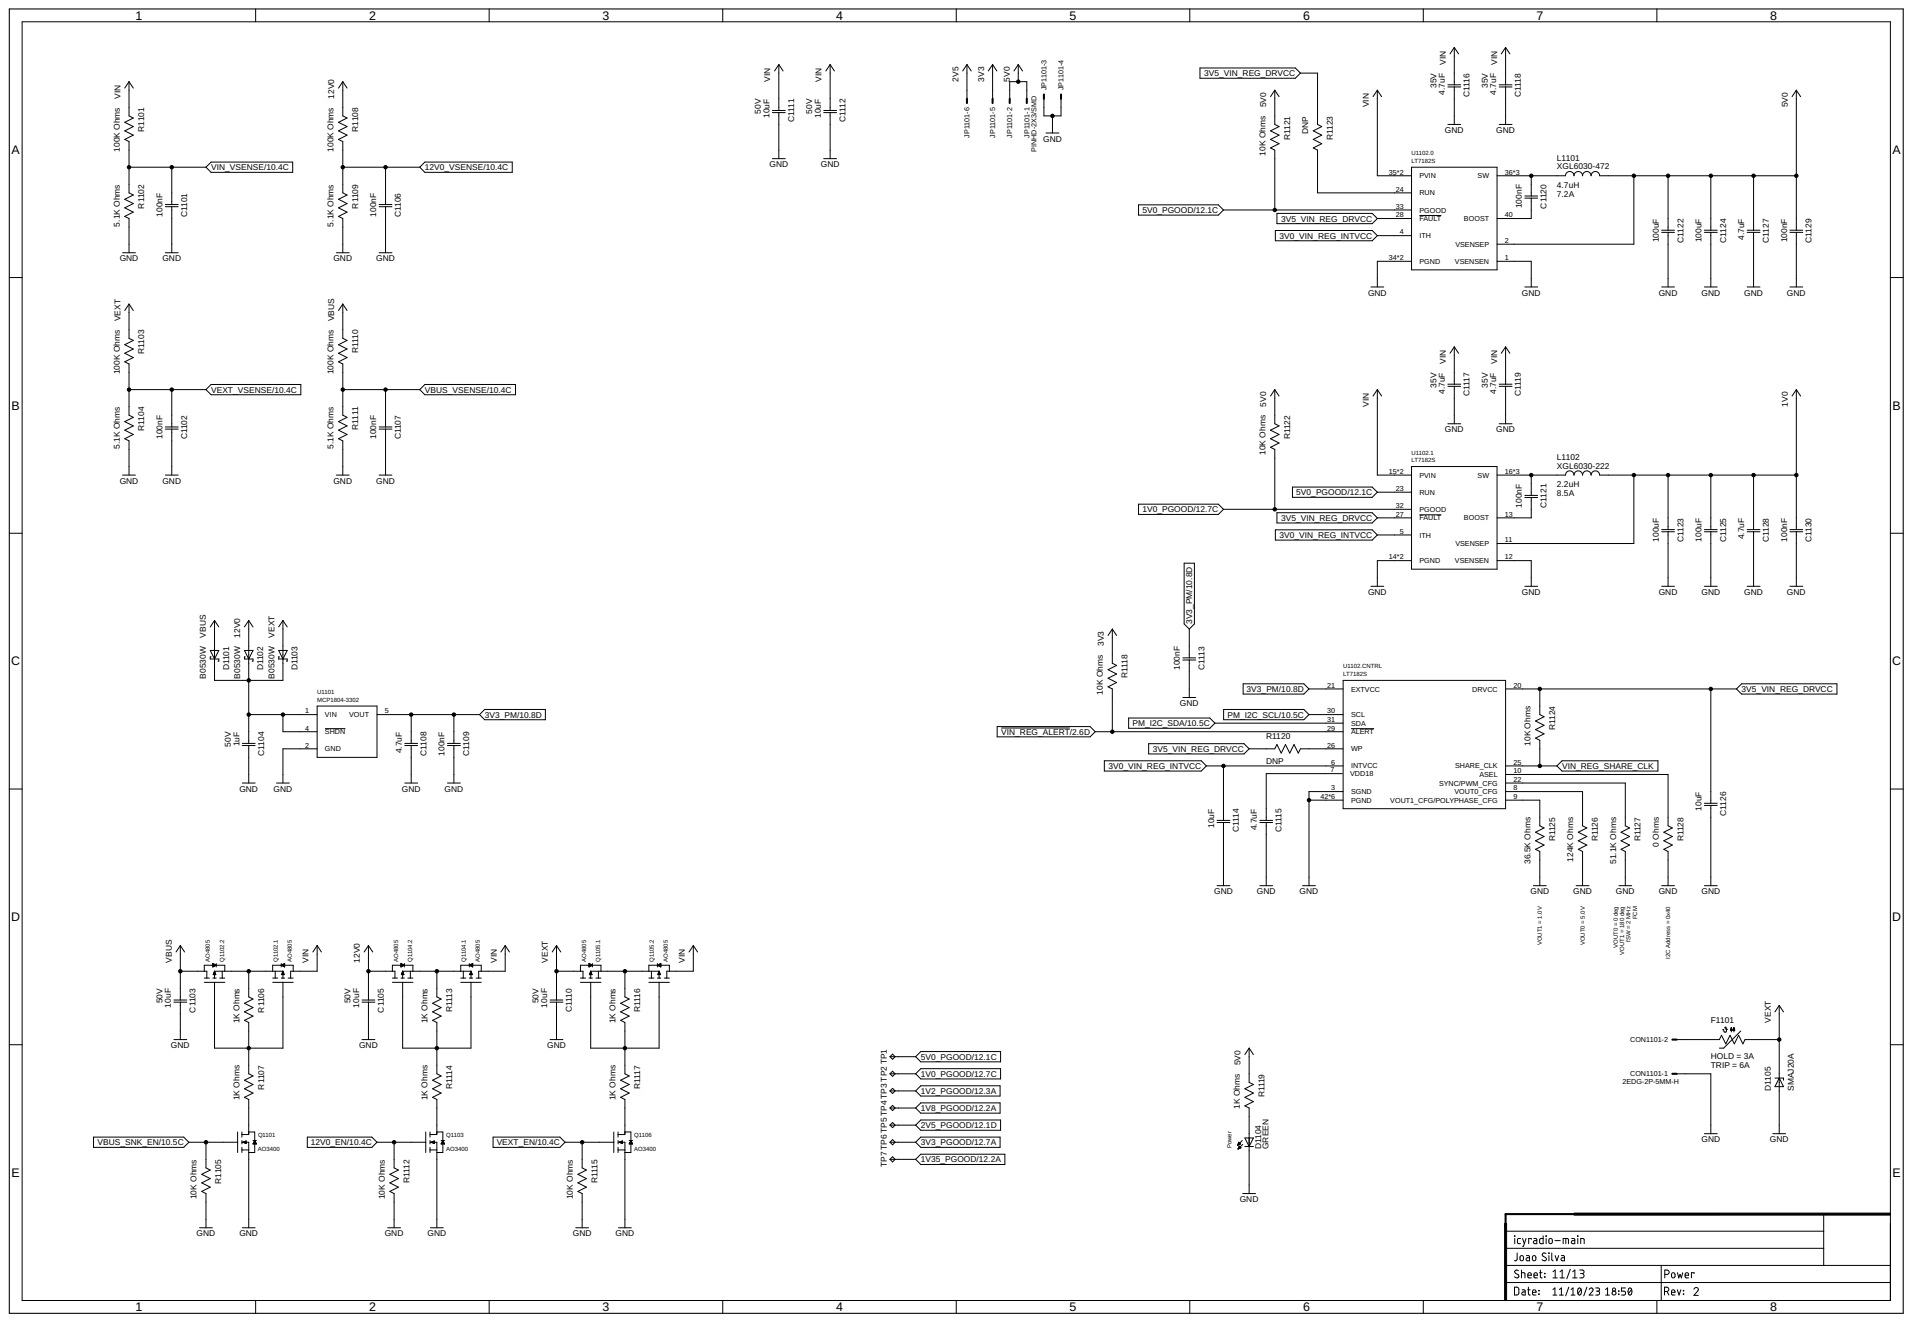
[picture p21: page 11]

VIN 100K Ohms 5.1K Ohms GND

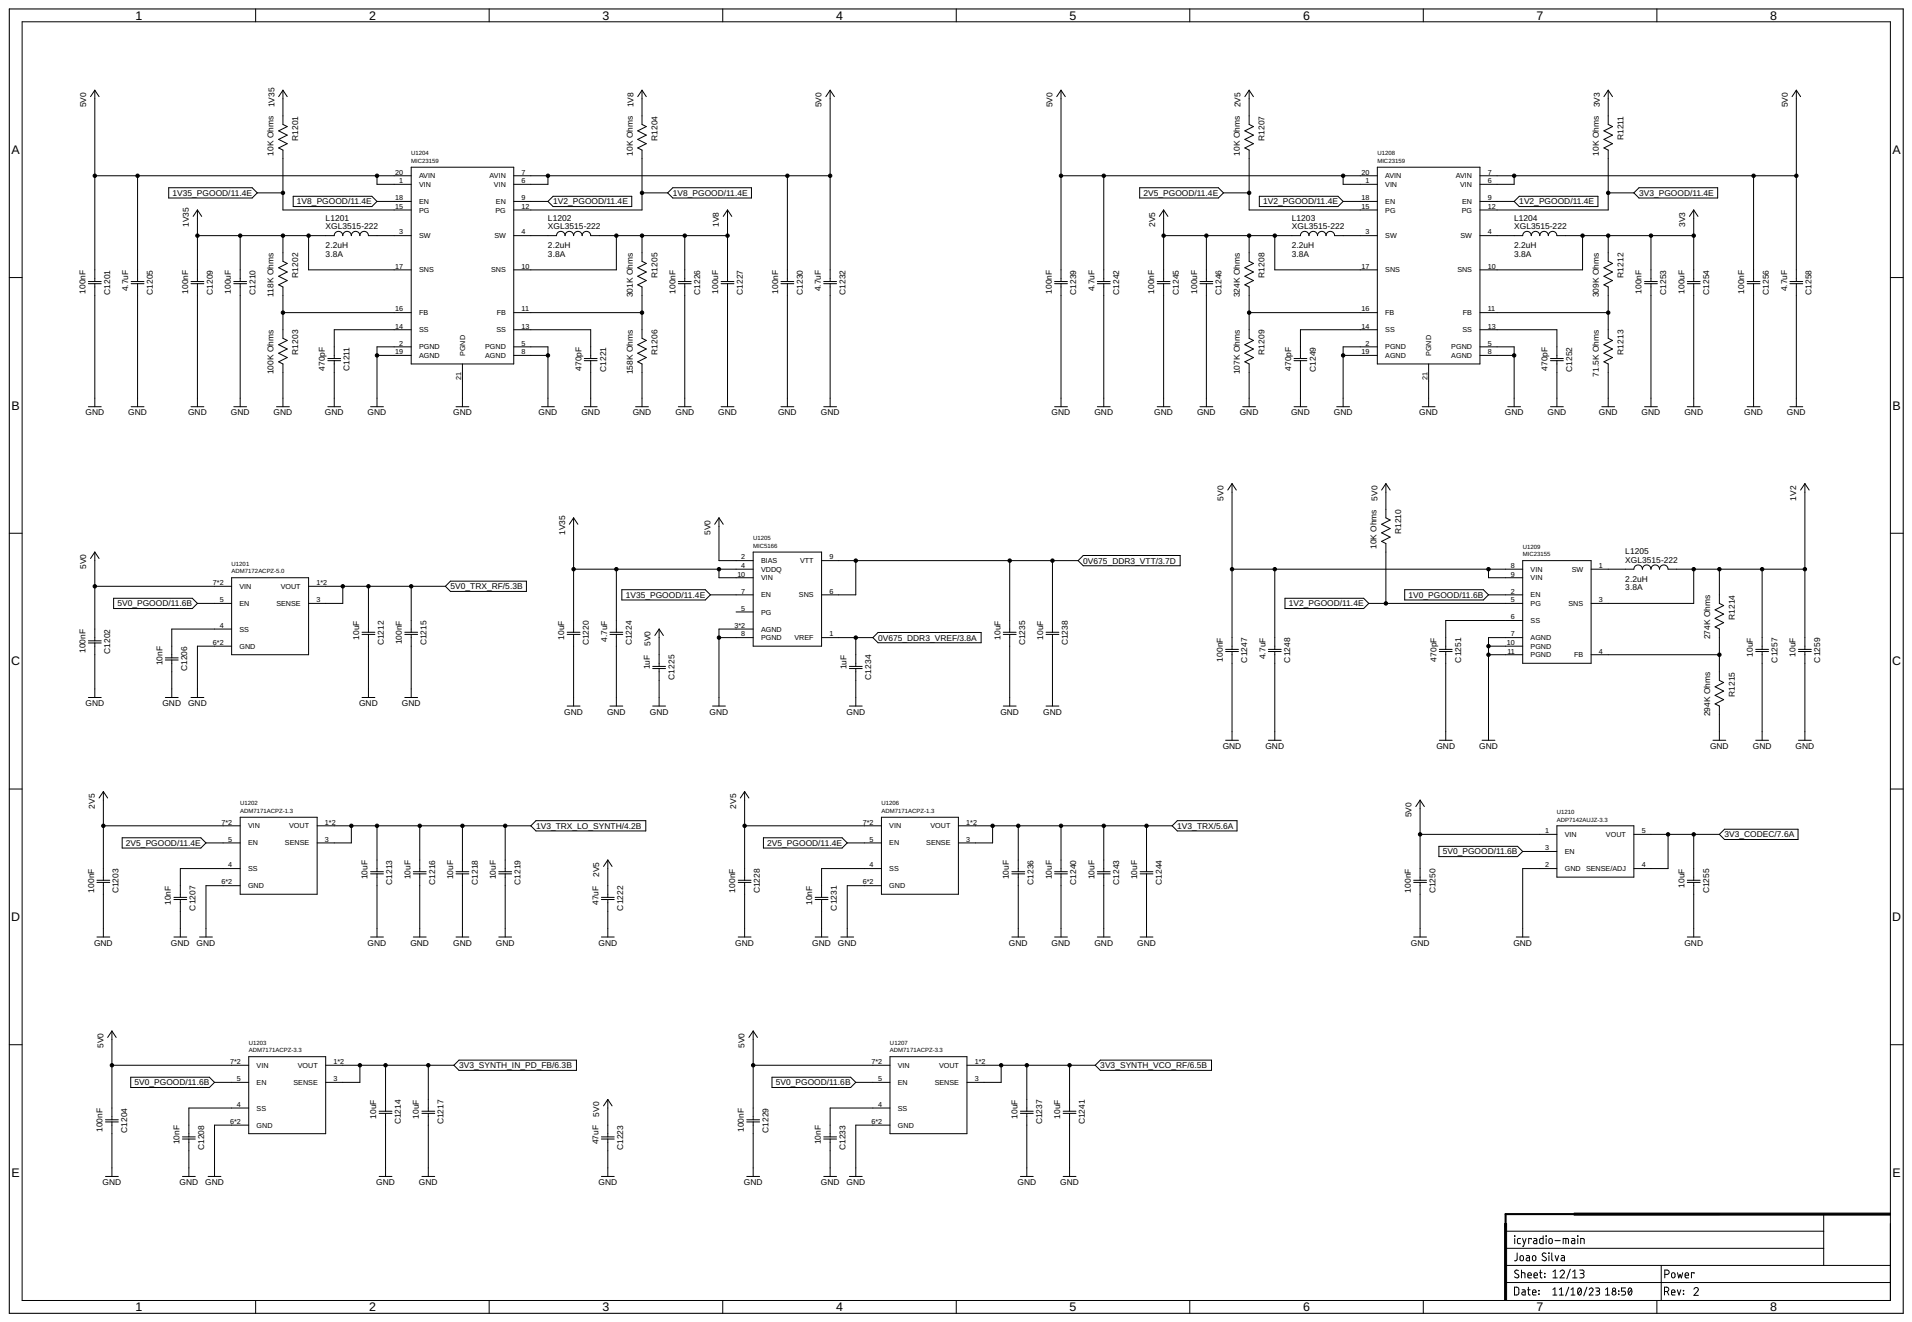
[picture p22: page 12]

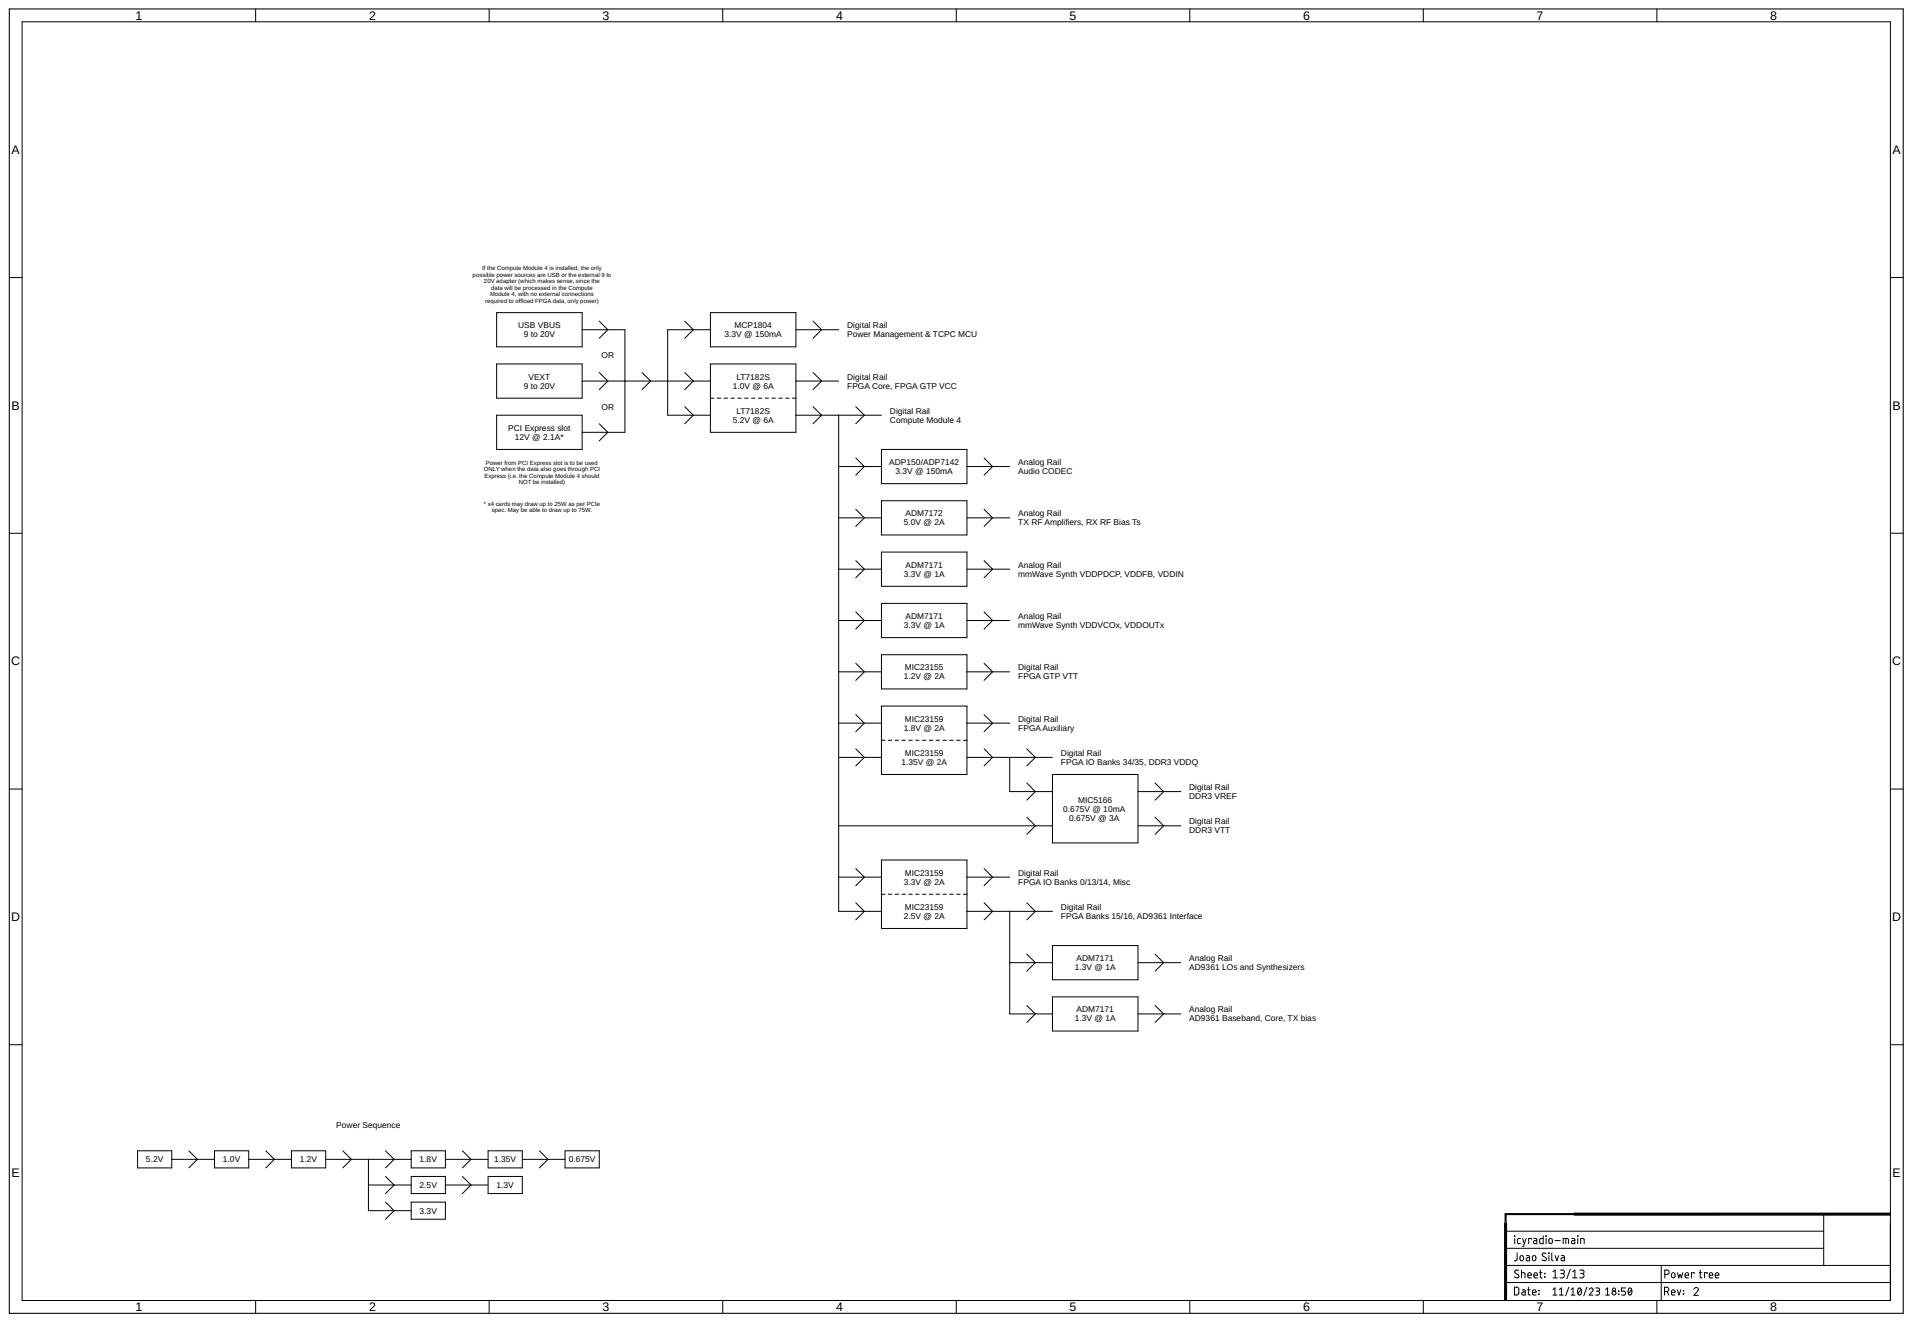
[picture p23: page 13]

If the Compute Module 4 is installed, the only possible power sources are USB or the external 9 to

20V adapter (which makes sense, since the
data will be processed in the Compute Module 4, with no external connections

required to offload FPGA data, only power)

Digital Rail
Power Management & TCPC MCU

FPGA Core, FPGA GTP VCC

Power from PCI Express slot is to be used ONLY when the data also goes through PCI Express (i.e. the Compute Module 4 should NOT be installed) * x4 cards may draw up to 25W as per PCIe

spec. May be able to draw up to 75W.

Analog Rail
TX RF Amplifiers, RX RF Bias Ts

Analog Rail mmWave Synth VDDPDCP, VDDFB, VDDIN

Analog Rail mmWave Synth VDDVCOx, VDDOUTx

FPGA IO Banks 34/35, DDR3 VDDQ

FPGA IO Banks 0/13/14, Misc

AD9361 Baseband, Core, TX bias
