vankxr/icyradio/pcb/exp-template/icyradio-exp-template.pdf

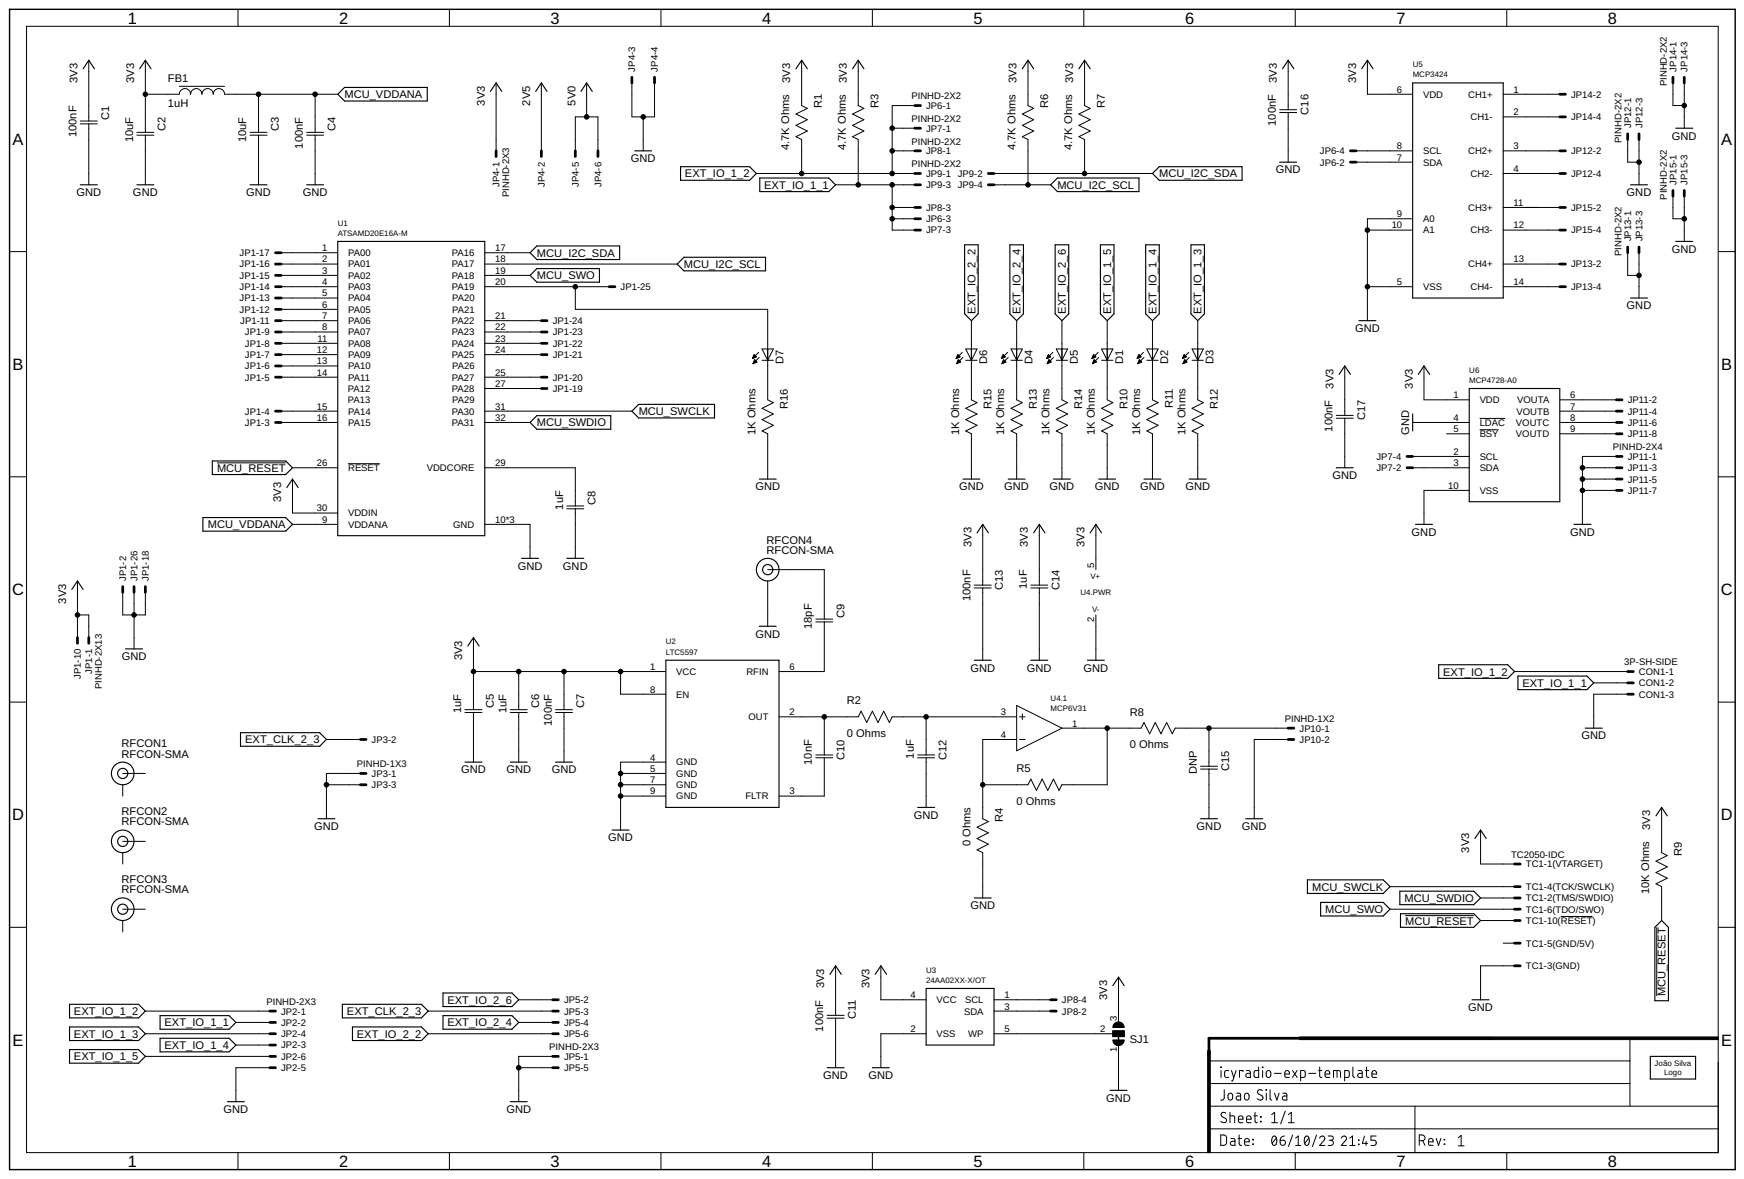
[picture p24: page 1]

PINHD-2X2 PINHD-2X2 PINHD-2X2 PINHD-2X2 GND

TC2050-IDC
TC1-1(VTARGET) TC1-2(TMS/SWDIO) TC1-3(GND)

TC1-4(TCK/SWCLK) TC1-5(GND/5V) TC1-6(TDO/SWO) TC1-10(RESET) C11
