vankxr/icyradio/pcb/lna/icyradio-lna.pdf

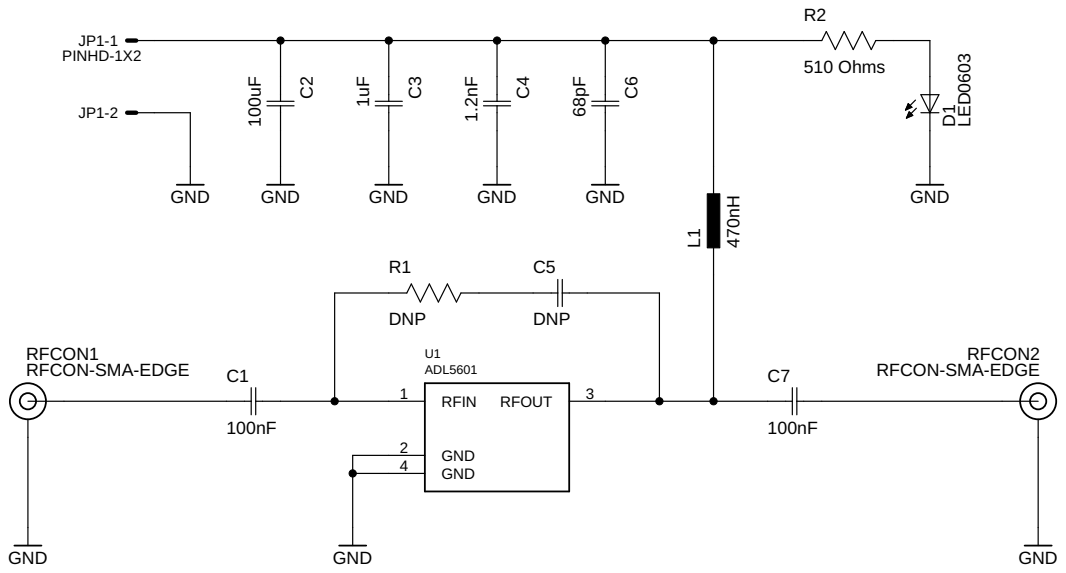
[picture p25: page 1]
