vankxr/icyradio/pcb/exp-template/icyradio-exp-template.brd

## EAGLE design pcb/exp-template/icyradio-exp-template.brd (2023-10-06)

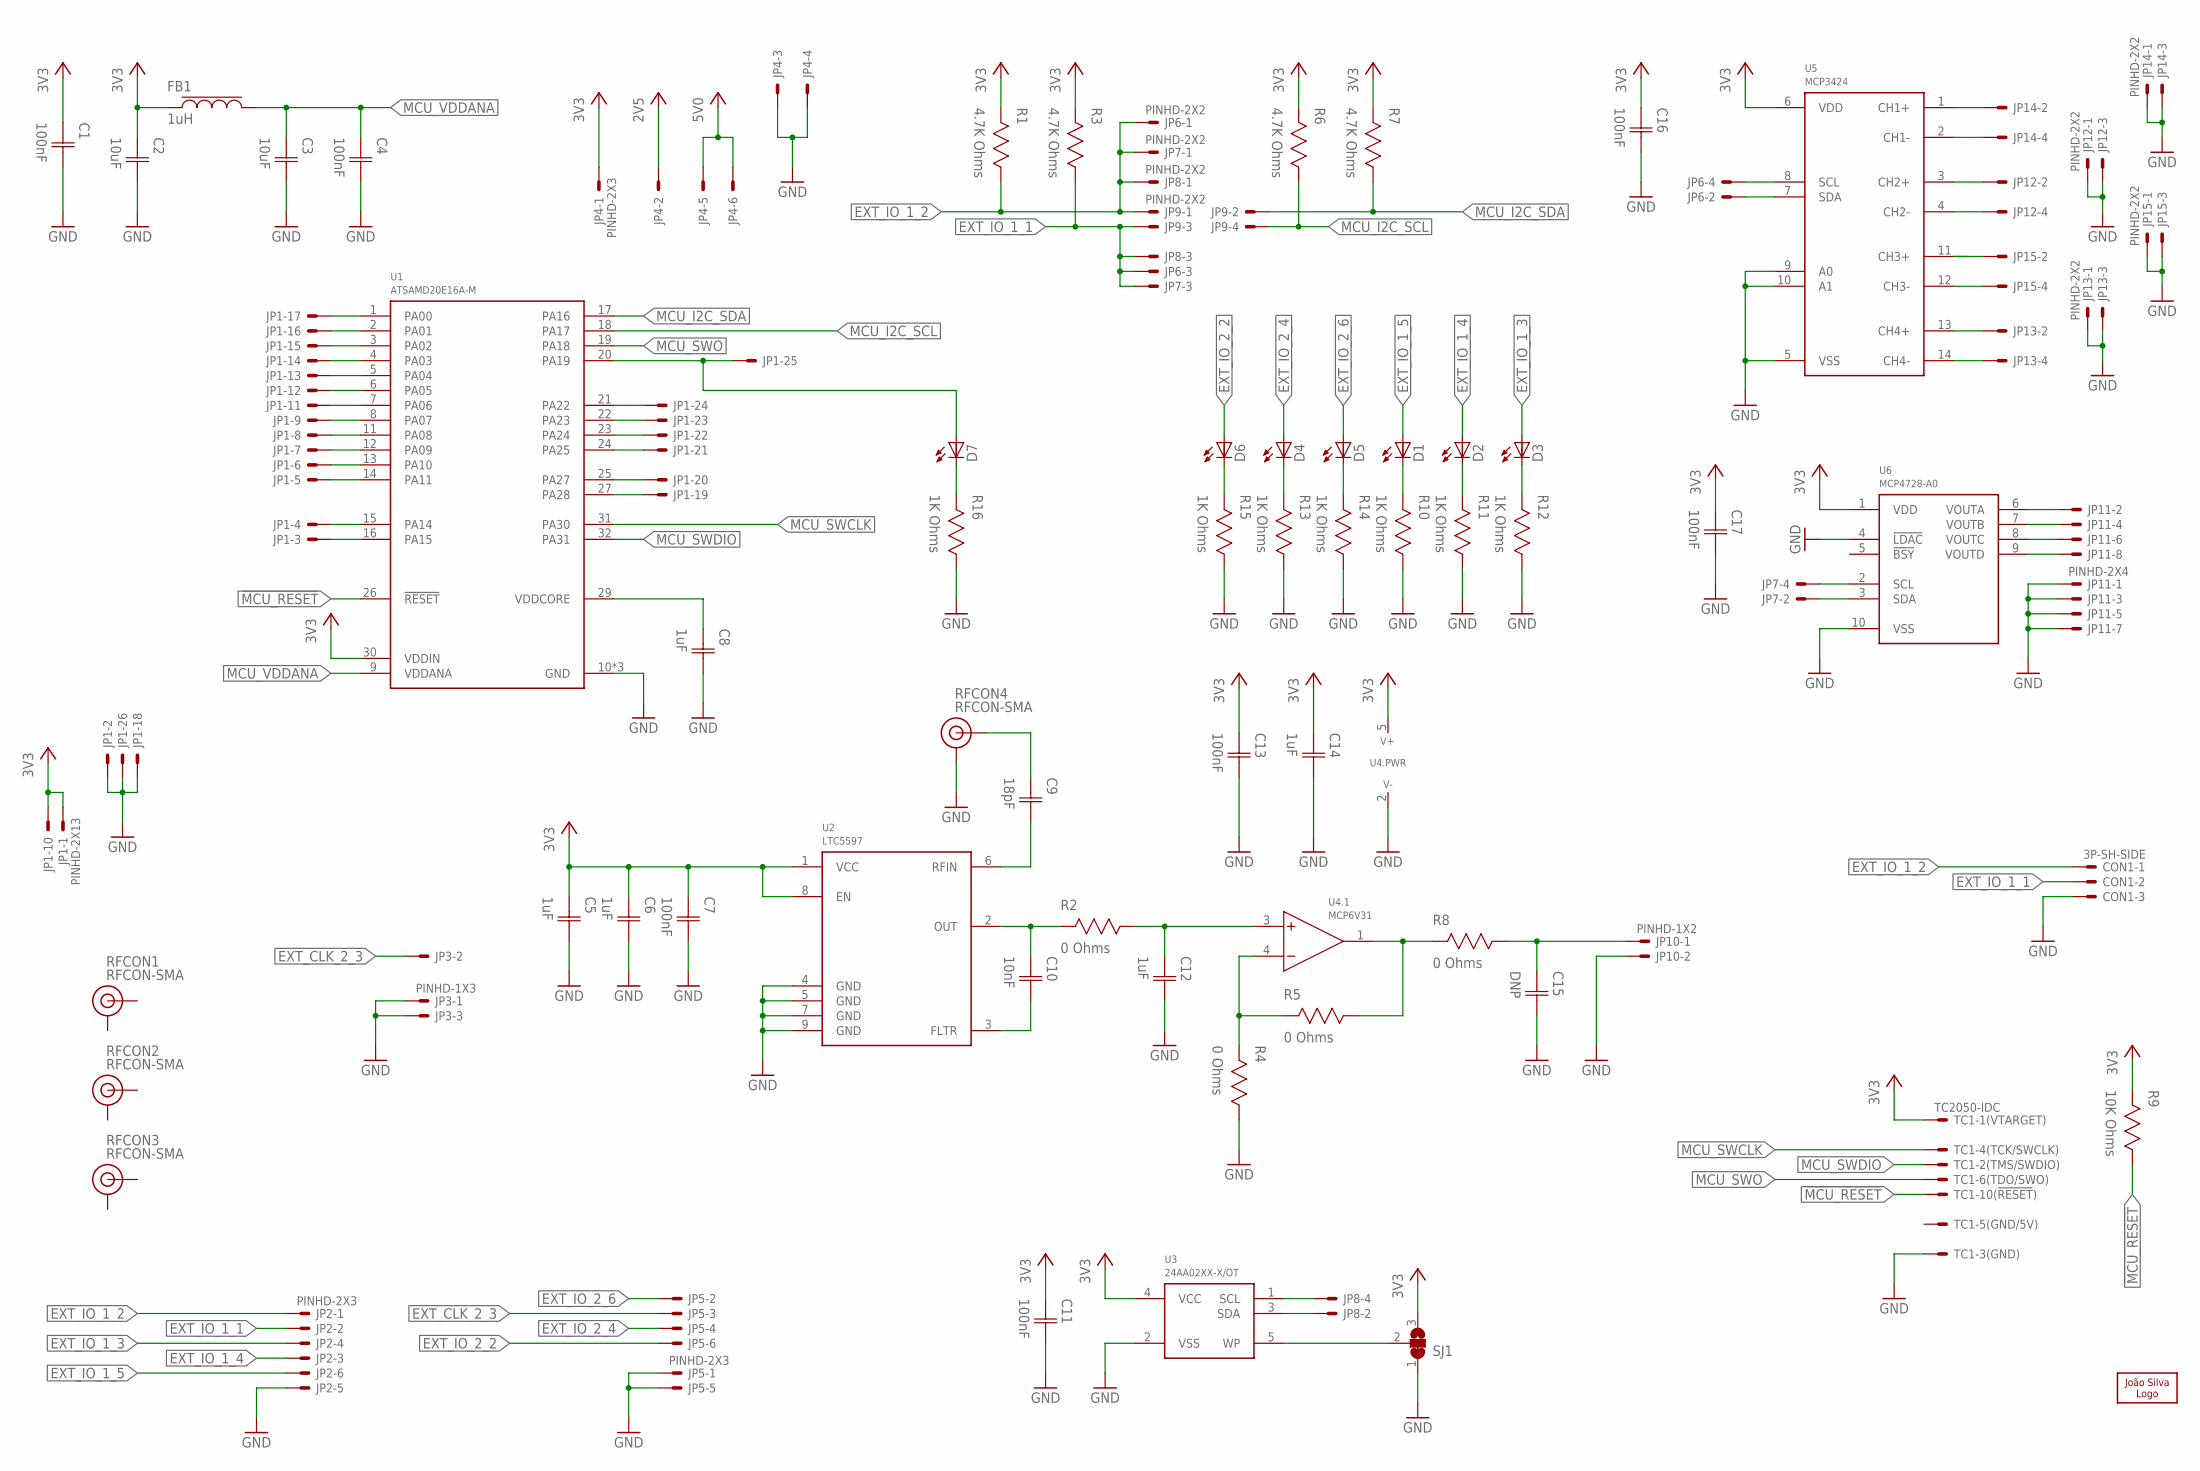
[picture p26: schematic icyradio-exp-template.sch]

Parts:
C1, C4, C7, C11, C13, C16, C17: 100nF; CAP0402
C2, C3: 10uF; CAP0402
C5, C6, C8, C12, C14: 1uF; CAP0402
C9: 18pF; CAP0402
C10: 10nF; CAP0402
C15: DNP; CAP0402
CON1: 3P-SH-SIDE; SH-03-SIDE
D1, D2, D3, D4, D5, D6, D7: LED0603; 0603
FB1: 1uH; IND0603
JP1: PINHD-2X13; 2X13
JP2, JP4, JP5: PINHD-2X3; 2X03
JP3: PINHD-1X3; 1X03
JP6, JP7, JP8, JP9, JP12, JP13, JP14, JP15: PINHD-2X2; 2X02
JP10: PINHD-1X2; 1X02
JP11: PINHD-2X4; 2X04
LOGO1: JSILVA-5MM; JSILVA_5MM
R1, R3, R6, R7: 4.7K Ohms; RES0402
R2, R4, R5, R8: 0 Ohms; RES0402
R9: 10K Ohms; RES0402
R10, R11, R12, R13, R14, R15, R16: 1K Ohms; RES0402
RFCON1, RFCON2, RFCON3, RFCON4: RFCON-SMA; SMA
SJ1: SJ2CS; SJ2C_S
TC1: TC2050-IDC
U1: ATSAMD20E16A-M; QFN32
U2: LTC5597; DFN8_2X2
U3: 24AA02XX-X/OT; SOT23-5
U4: MCP6V31; SOT23-5
U5: MCP3424; TSSOP14
U6: MCP4728-A0; MSOP10

Connections:
2V5: JP4.2
3V3: C1.1 (C1), C2.1 (C1), C5.1 (C1), C6.1 (C1), C7.1 (C1), C11.1 (C1), C13.1 (C1), C14.1 (C1), C16.1 (C1), C17.1 (C1), FB1.1, JP1.1, JP1.10, JP4.1, R1.2, R3.2, R6.2, R7.2, R9.2, SJ1.3, TC1.1, U1.30 (VDDIN), U2.1 (VCC), U2.8 (EN), U3.4 (VCC), U4.5 (V+), U5.6 (VDD), U6.1 (VDD)
5V0: JP4.5, JP4.6
!MCU_RESET: R9.1, TC1.10, U1.26 (!RESET)
ADC_C1_N: JP14.4, U5.2 (CH1-)
ADC_C1_P: JP14.2, U5.1 (CH1+)
ADC_C2_N: JP12.4, U5.4 (CH2-)
ADC_C2_P: JP12.2, U5.3 (CH2+)
ADC_C3_N: JP15.4, U5.12 (CH3-)
ADC_C3_P: JP15.2, U5.11 (CH3+)
ADC_C4_N: JP13.4, U5.14 (CH4-)
ADC_C4_P: JP13.2, U5.13 (CH4+)
ADC_I2C_SCL: JP6.4, U5.8 (SCL)
ADC_I2C_SDA: JP6.2, U5.7 (SDA)
DAC_I2C_SCL: JP7.4, U6.2 (SCL)
DAC_I2C_SDA: JP7.2, U6.3 (SDA)
DAC_VA: JP11.2, U6.6 (VOUTA)
DAC_VB: JP11.4, U6.7 (VOUTB)
DAC_VC: JP11.6, U6.8 (VOUTC)
DAC_VD: JP11.8, U6.9 (VOUTD)
EE_I2C_SCL: JP8.4, U3.1 (SCL)
EE_I2C_SDA: JP8.2, U3.3 (SDA)
EE_WP: SJ1.2, U3.5 (WP)
EXT_CLK_2_3: JP3.2, JP5.3
EXT_IO_1_1: CON1.2, JP2.2, JP6.3, JP7.3, JP8.3, JP9.3, R3.1
EXT_IO_1_2: CON1.1, JP2.1, JP6.1, JP7.1, JP8.1, JP9.1, R1.1
EXT_IO_1_3: D3.A, JP2.4
EXT_IO_1_4: D2.A, JP2.3
EXT_IO_1_5: D1.A, JP2.6
EXT_IO_2_2: D6.A, JP5.6
EXT_IO_2_4: D4.A, JP5.4
EXT_IO_2_6: D5.A, JP5.2
GND: C1.2 (C2), C2.2 (C2), C3.2 (C2), C4.2 (C2), C5.2 (C2), C6.2 (C2), C7.2 (C2), C8.2 (C2), C11.2 (C2), C12.2 (C2), C13.2 (C2), C14.2 (C2), C15.2 (C2), C16.2 (C2), C17.2 (C2), CON1.3, JP1.2, JP1.18, JP1.26, JP2.5, JP3.1, JP3.3, JP4.3, JP4.4, JP5.1, JP5.5, JP10.2, JP11.1, JP11.3, JP11.5, JP11.7, JP12.1, JP12.3, JP13.1, JP13.3, JP14.1, JP14.3, JP15.1, JP15.3, R4.1, R10.1, R11.1, R12.1, R13.1, R14.1, R15.1, R16.1, RFCON4.GND@0 (GND), RFCON4.GND@1 (GND), RFCON4.GND@2 (GND), RFCON4.GND@3 (GND), SJ1.1, TC1.3, U1.10 (GND), U1.28 (GND), U1.33 (GND), U2.4 (GND), U2.5 (GND), U2.7 (GND), U2.9 (GND), U3.2 (VSS), U4.2 (V-), U5.5 (VSS), U5.9 (A0), U5.10 (A1), U6.4 (!LDAC), U6.10 (VSS)
MCU_I2C_SCL: JP9.4, R6.1, U1.18 (PA17)
MCU_I2C_SDA: JP9.2, R7.1, U1.17 (PA16)
MCU_SWCLK: TC1.4, U1.31 (PA30)
MCU_SWDIO: TC1.2, U1.32 (PA31)
MCU_SWO: TC1.6, U1.19 (PA18)
MCU_VDDANA: C3.1 (C1), C4.1 (C1), FB1.2, U1.9 (VDDANA)
unnamed: C8.1 (C1), U1.29 (VDDCORE)
unnamed: D1.C, R10.2
unnamed: D2.C, R11.2
unnamed: D3.C, R12.2
unnamed: D4.C, R13.2
unnamed: D5.C, R14.2
unnamed: D6.C, R15.2
unnamed: D7.C, R16.2
unnamed: R5.1, R8.2, U4.1 (OUT)
unnamed: C10.2 (C2), U2.3 (FLTR)
unnamed: C10.1 (C1), R2.2, U2.2 (OUT)
unnamed: C12.1 (C1), R2.1, U4.3 (+IN)
unnamed: R4.2, R5.2, U4.4 (-IN)
unnamed: C9.1 (C1), RFCON4.SIGNAL
unnamed: C9.2 (C2), U2.6 (RFIN)
unnamed: C15.1 (C1), JP10.1, R8.1
P0: JP1.17, U1.1 (PA00)
P1: JP1.16, U1.2 (PA01)
P2: JP1.15, U1.3 (PA02)
P3: JP1.14, U1.4 (PA03)
P4: JP1.13, U1.5 (PA04)
P5: JP1.12, U1.6 (PA05)
P6: JP1.11, U1.7 (PA06)
P7: JP1.9, U1.8 (PA07)
P8: JP1.8, U1.11 (PA08)
P9: JP1.7, U1.12 (PA09)
P10: JP1.6, U1.13 (PA10)
P11: JP1.5, U1.14 (PA11)
P14: JP1.4, U1.15 (PA14)
P15: JP1.3, U1.16 (PA15)
P19: D7.A, JP1.25, U1.20 (PA19)
P22: JP1.24, U1.21 (PA22)
P23: JP1.23, U1.22 (PA23)
P24: JP1.22, U1.23 (PA24)
P25: JP1.21, U1.24 (PA25)
P27: JP1.20, U1.25 (PA27)
P28: JP1.19, U1.27 (PA28)

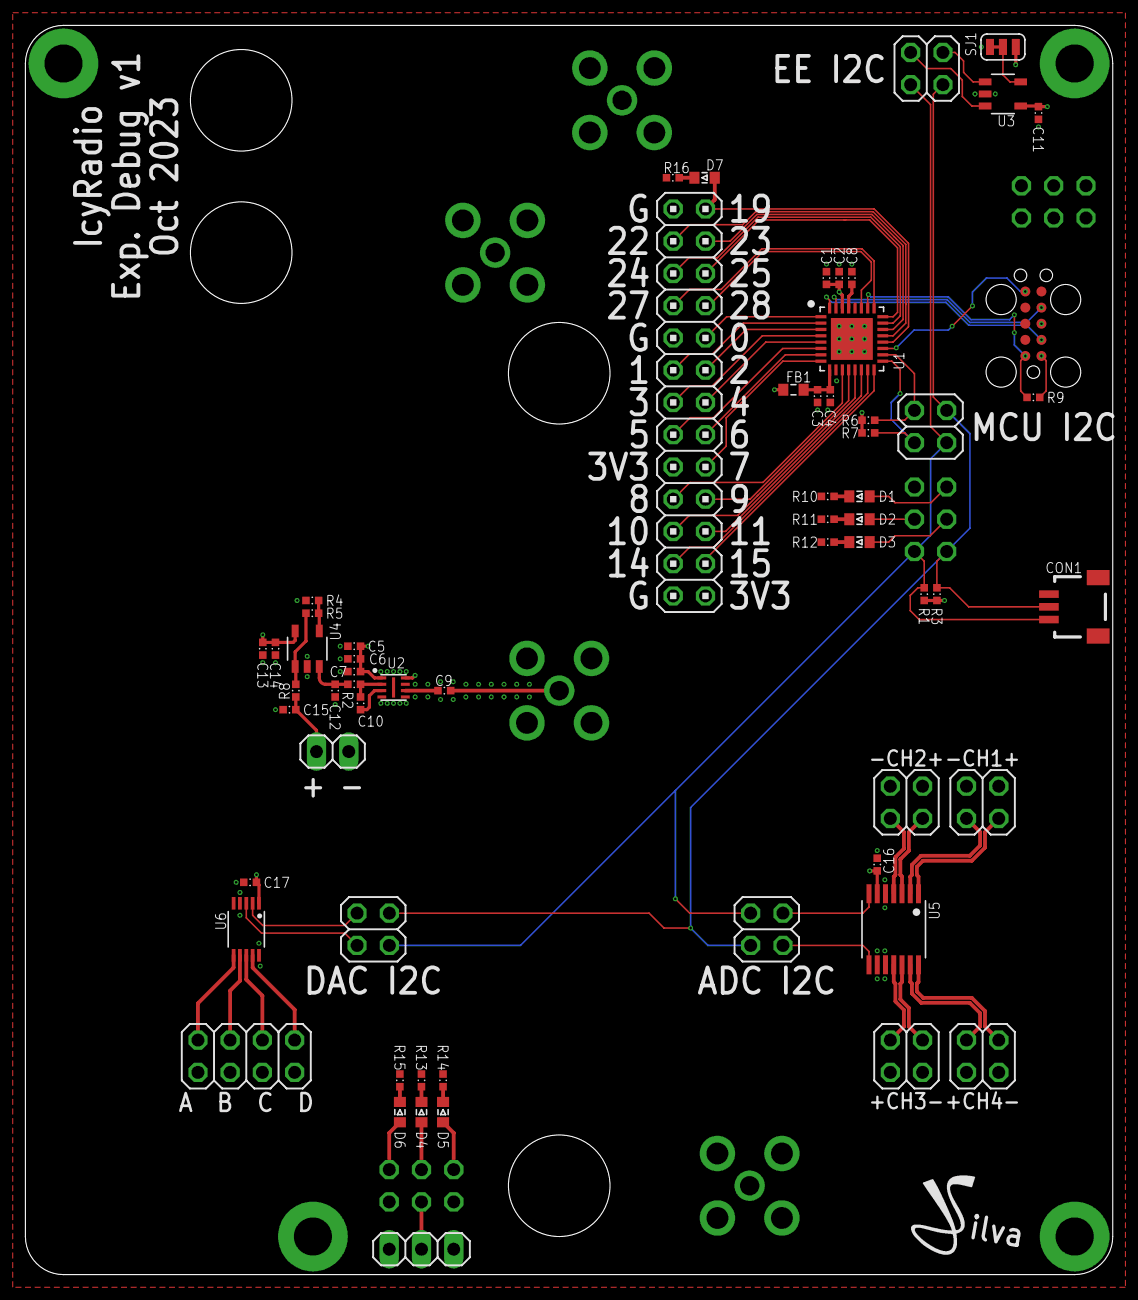
[picture p27: board icyradio-exp-template.brd from above]

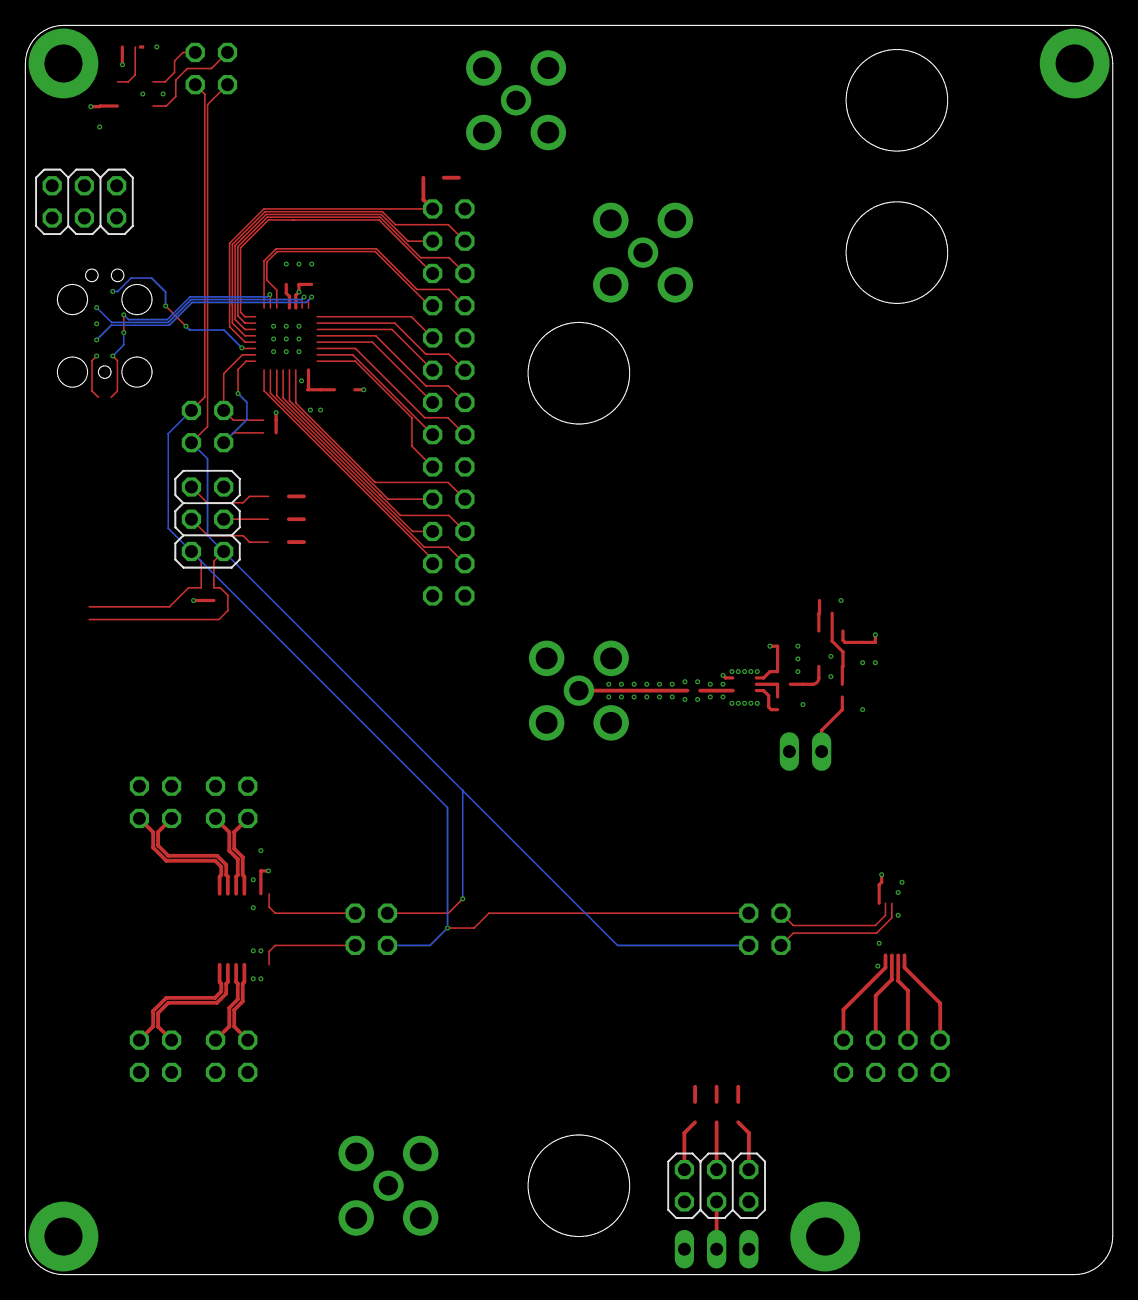
[picture p28: board icyradio-exp-template.brd from below]

Board: 4 copper layers, 85.7 x 98.4 mm, 70 parts (3 on the bottom side), 75 nets.
