vankxr/icyradio/pcb/main/icyradio-main.brd

## EAGLE design pcb/main/icyradio-main.brd (2023-10-06)

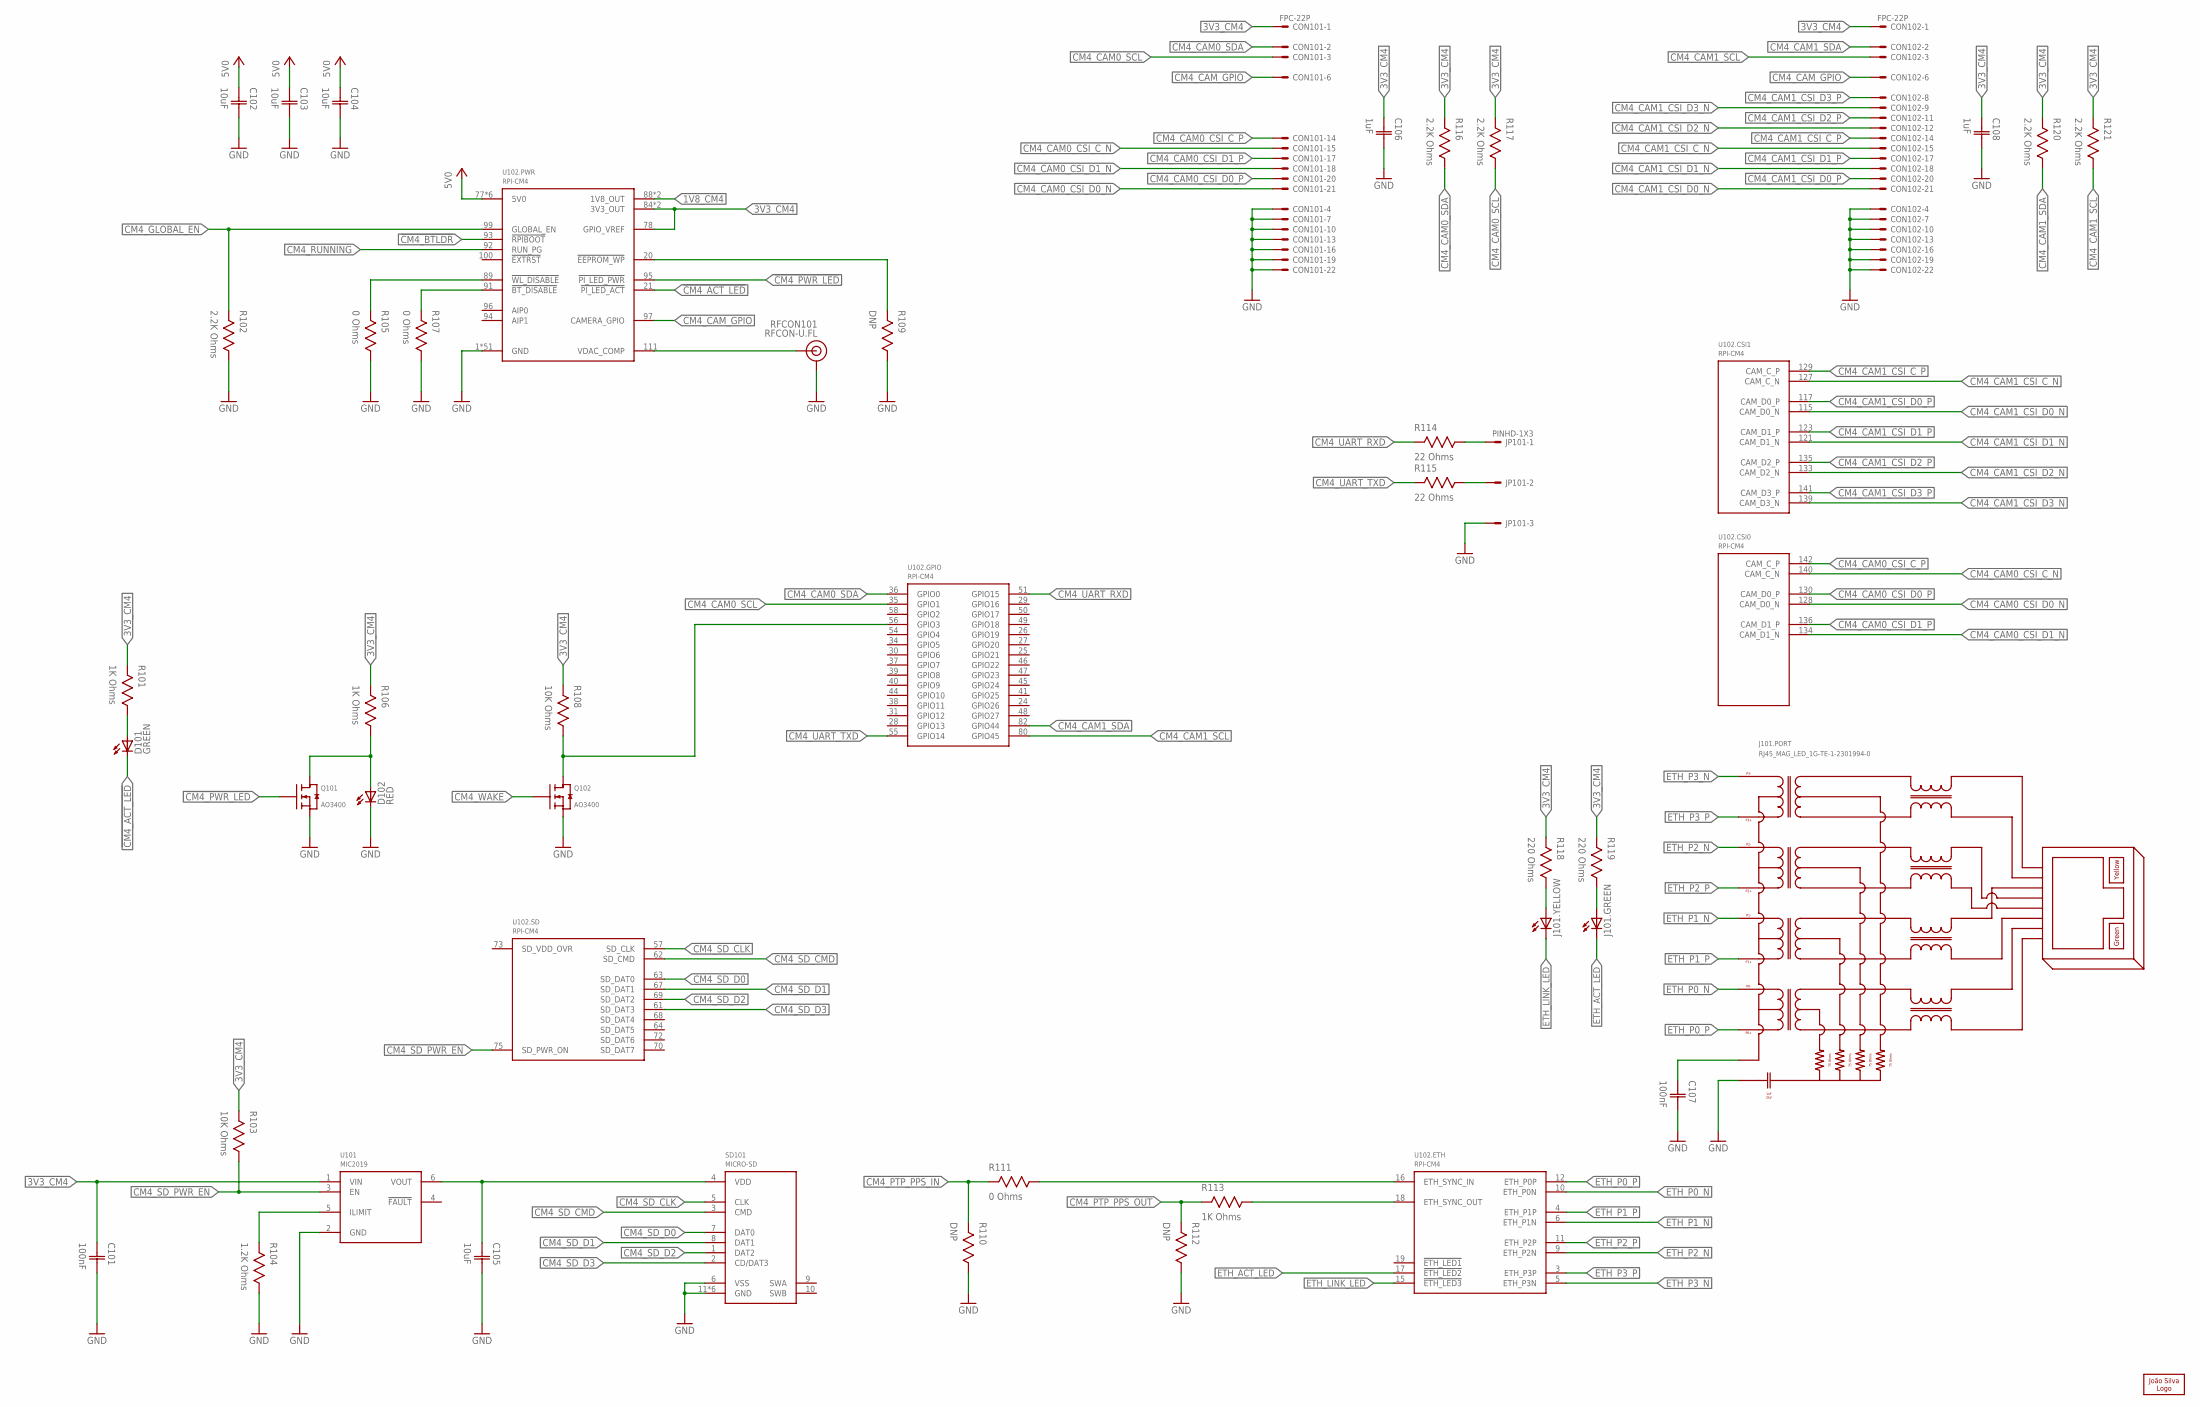
[picture p29: schematic icyradio-main.sch, sheet 1, Compute Module 4]

Parts:
C101, C107: 100nF; CAP0402
C102, C103, C104: 10uF; CAP0603
C105: 10uF; CAP0402
C106, C108: 1uF; CAP0402
CON101, CON102: FPC-22P
D101, D102: LED0603; 0603
J101: RJ45_MAG_LED_1G-TE-1-2301994-0; TE-1-2301994-0
JP101: PINHD-1X3; 1X03
LOGO101: JS-10MM; JS_10MM
Q101, Q102: AO3400; SOT23
R101, R106, R113: 1K Ohms; RES0402
R102, R116, R117, R120, R121: 2.2K Ohms; RES0402
R103, R108: 10K Ohms; RES0402
R104: 1.2K Ohms; RES0402
R105, R107, R111: 0 Ohms; RES0402
R109, R110, R112: DNP; RES0402
R114, R115: 22 Ohms; RES0402
R118, R119: 220 Ohms; RES0402
RFCON101: RFCON-U.FL; U.FL
SD101: MICRO-SD; TE-2201778-1
U101: MIC2019; SOT23-6
U102: RPI-CM4

Connections:
1V8_CM4: U102.88 (1V8_OUT), U102.90 (1V8_OUT)
3V3_CM4: C101.1 (C1), C106.1 (C1), C108.1 (C1), CON101.1, CON102.1, R101.2, R103.2, R106.2, R108.2, R116.2, R117.2, R118.2, R119.2, R120.2, R121.2, U101.1 (VIN), U102.78 (GPIO_VREF), U102.84 (3V3_OUT), U102.86 (3V3_OUT); also elsewhere on the board
3V3_CM4_SD: C105.1 (C1), SD101.4 (VDD), U101.6 (VOUT)
5V0: C102.1 (C1), C103.1 (C1), C104.1 (C1), U102.77 (5V0), U102.79 (5V0), U102.81 (5V0), U102.83 (5V0), U102.85 (5V0), U102.87 (5V0); also elsewhere on the board
!CM4_ACT_LED: D101.C, U102.21 (!PI_LED_ACT)
!CM4_BTLDR: U102.93 (!RPIBOOT); also elsewhere on the board
!CM4_BT_DIS: R107.2, U102.91 (!BT_DISABLE)
!CM4_EE_WP: R109.2, U102.20 (!EEPROM_WP)
!CM4_PWR_LED: Q101.1 (G), U102.95 (!PI_LED_PWR)
!CM4_WL_DIS: R105.2, U102.89 (!WL_DISABLE)
CM4_CAM0_CSI_C_N: CON101.15, U102.140 (CAM_C_N)
CM4_CAM0_CSI_C_P: CON101.14, U102.142 (CAM_C_P)
CM4_CAM0_CSI_D0_N: CON101.21, U102.128 (CAM_D0_N)
CM4_CAM0_CSI_D0_P: CON101.20, U102.130 (CAM_D0_P)
CM4_CAM0_CSI_D1_N: CON101.18, U102.134 (CAM_D1_N)
CM4_CAM0_CSI_D1_P: CON101.17, U102.136 (CAM_D1_P)
CM4_CAM0_SCL: CON101.3, R117.1, U102.35 (GPIO1)
CM4_CAM0_SDA: CON101.2, R116.1, U102.36 (GPIO0)
CM4_CAM1_CSI_C_N: CON102.15, U102.127 (CAM_C_N)
CM4_CAM1_CSI_C_P: CON102.14, U102.129 (CAM_C_P)
CM4_CAM1_CSI_D0_N: CON102.21, U102.115 (CAM_D0_N)
CM4_CAM1_CSI_D0_P: CON102.20, U102.117 (CAM_D0_P)
CM4_CAM1_CSI_D1_N: CON102.18, U102.121 (CAM_D1_N)
CM4_CAM1_CSI_D1_P: CON102.17, U102.123 (CAM_D1_P)
CM4_CAM1_CSI_D2_N: CON102.12, U102.133 (CAM_D2_N)
CM4_CAM1_CSI_D2_P: CON102.11, U102.135 (CAM_D2_P)
CM4_CAM1_CSI_D3_N: CON102.9, U102.139 (CAM_D3_N)
CM4_CAM1_CSI_D3_P: CON102.8, U102.141 (CAM_D3_P)
CM4_CAM1_SCL: CON102.3, R121.1, U102.80 (GPIO45)
CM4_CAM1_SDA: CON102.2, R120.1, U102.82 (GPIO44)
CM4_CAM_GPIO: CON101.6, CON102.6, U102.97 (CAMERA_GPIO)
CM4_CVBS: RFCON101.P$3 (SIGNAL), U102.111 (VDAC_COMP)
CM4_GLOBAL_EN: R102.2, U102.99 (GLOBAL_EN); also elsewhere on the board
CM4_GPIO3: Q102.3 (D), R108.1, U102.56 (GPIO3)
CM4_PTP_PPS_IN: R110.2, R111.2; also elsewhere on the board
CM4_PTP_PPS_OUT: R112.2, R113.2; also elsewhere on the board
CM4_RUNNING: U102.92 (RUN_PG); also elsewhere on the board
CM4_SD_CLK: SD101.5 (CLK), U102.57 (SD_CLK)
CM4_SD_CMD: SD101.3 (CMD), U102.62 (SD_CMD)
CM4_SD_D0: SD101.7 (DAT0), U102.63 (SD_DAT0)
CM4_SD_D1: SD101.8 (DAT1), U102.67 (SD_DAT1)
CM4_SD_D2: SD101.1 (DAT2), U102.69 (SD_DAT2)
CM4_SD_D3: SD101.2 (CD/DAT3), U102.61 (SD_DAT3)
CM4_SD_PWR_EN: R103.1, U101.3 (EN), U102.75 (SD_PWR_ON)
CM4_UART_RXD: R114.2, U102.51 (GPIO15)
CM4_UART_TXD: R115.2, U102.55 (GPIO14)
CM4_WAKE: Q102.1 (G); also elsewhere on the board
ETH_ACT_LED: J101.12 (C), U102.17 (!ETH_LED2)
ETH_LINK_LED: J101.14 (C), U102.15 (!ETH_LED3)
ETH_P0_N: J101.3 (P0-), U102.10 (ETH_P0N)
ETH_P0_P: J101.2 (P0+), U102.12 (ETH_P0P)
ETH_P1_N: J101.7 (P1-), U102.6 (ETH_P1N)
ETH_P1_P: J101.4 (P1+), U102.4 (ETH_P1P)
ETH_P2_N: J101.6 (P2-), U102.9 (ETH_P2N)
ETH_P2_P: J101.5 (P2+), U102.11 (ETH_P2P)
ETH_P3_N: J101.9 (P3-), U102.5 (ETH_P3N)
ETH_P3_P: J101.8 (P3+), U102.3 (ETH_P3P)
ETH_SYNC_IN: R111.1, U102.16 (ETH_SYNC_IN)
ETH_SYNC_OUT: R113.1, U102.18 (ETH_SYNC_OUT)
GND: C101.2 (C2), C102.2 (C2), C103.2 (C2), C104.2 (C2), C105.2 (C2), C106.2 (C2), C107.2 (C2), C108.2 (C2), CON101.4, CON101.7, CON101.10, CON101.13, CON101.16, CON101.19, CON101.22, CON102.4, CON102.7, CON102.10, CON102.13, CON102.16, CON102.19, CON102.22, D102.C, J101.10 (CHS_GND), J101.SHIELD@0 (CHS_GND), J101.SHIELD@1 (CHS_GND), JP101.3, Q101.2 (S), Q102.2 (S), R102.1, R104.1, R105.1, R107.1, R109.1, R110.1, R112.1, RFCON101.P$1 (GND), RFCON101.P$2 (GND), SD101.6 (VSS), SD101.11 (GND), SD101.12 (GND), SD101.13 (GND), SD101.14 (GND), SD101.15 (GND), SD101.16 (GND), U101.2 (GND), U102.1 (GND), U102.2 (GND), U102.7 (GND), U102.8 (GND), U102.13 (GND), U102.14 (GND), U102.22 (GND), U102.23 (GND), U102.32 (GND), U102.33 (GND), U102.42 (GND), U102.43 (GND), U102.52 (GND), U102.53 (GND), U102.59 (GND), U102.60 (GND), U102.65 (GND), U102.66 (GND), U102.71 (GND), U102.74 (GND), U102.98 (GND), U102.107 (GND), U102.108 (GND), U102.113 (GND), U102.114 (GND), U102.119 (GND), U102.120 (GND), U102.125 (GND), U102.126 (GND), U102.131 (GND), U102.132 (GND), U102.137 (GND), U102.138 (GND), U102.144 (GND), U102.150 (GND), U102.155 (GND), U102.156 (GND), U102.161 (GND), U102.162 (GND), U102.167 (GND), U102.168 (GND), U102.173 (GND), U102.174 (GND), U102.179 (GND), U102.180 (GND), U102.185 (GND), U102.186 (GND), U102.191 (GND), U102.192 (GND), U102.197 (GND), U102.198 (GND); also elsewhere on the board
unnamed: JP101.1, R114.1
unnamed: JP101.2, R115.1
unnamed: C107.1 (C1), J101.1 (CT)
unnamed: J101.11 (A), R119.1
unnamed: J101.13 (A), R118.1
unnamed: R104.2, U101.5 (ILIMIT)
unnamed: D101.A, R101.1
unnamed: D102.A, Q101.3 (D), R106.1
