vankxr/icyradio/pcb/main/icyradio-main.brd

## EAGLE design pcb/main/icyradio-main.brd (continued)

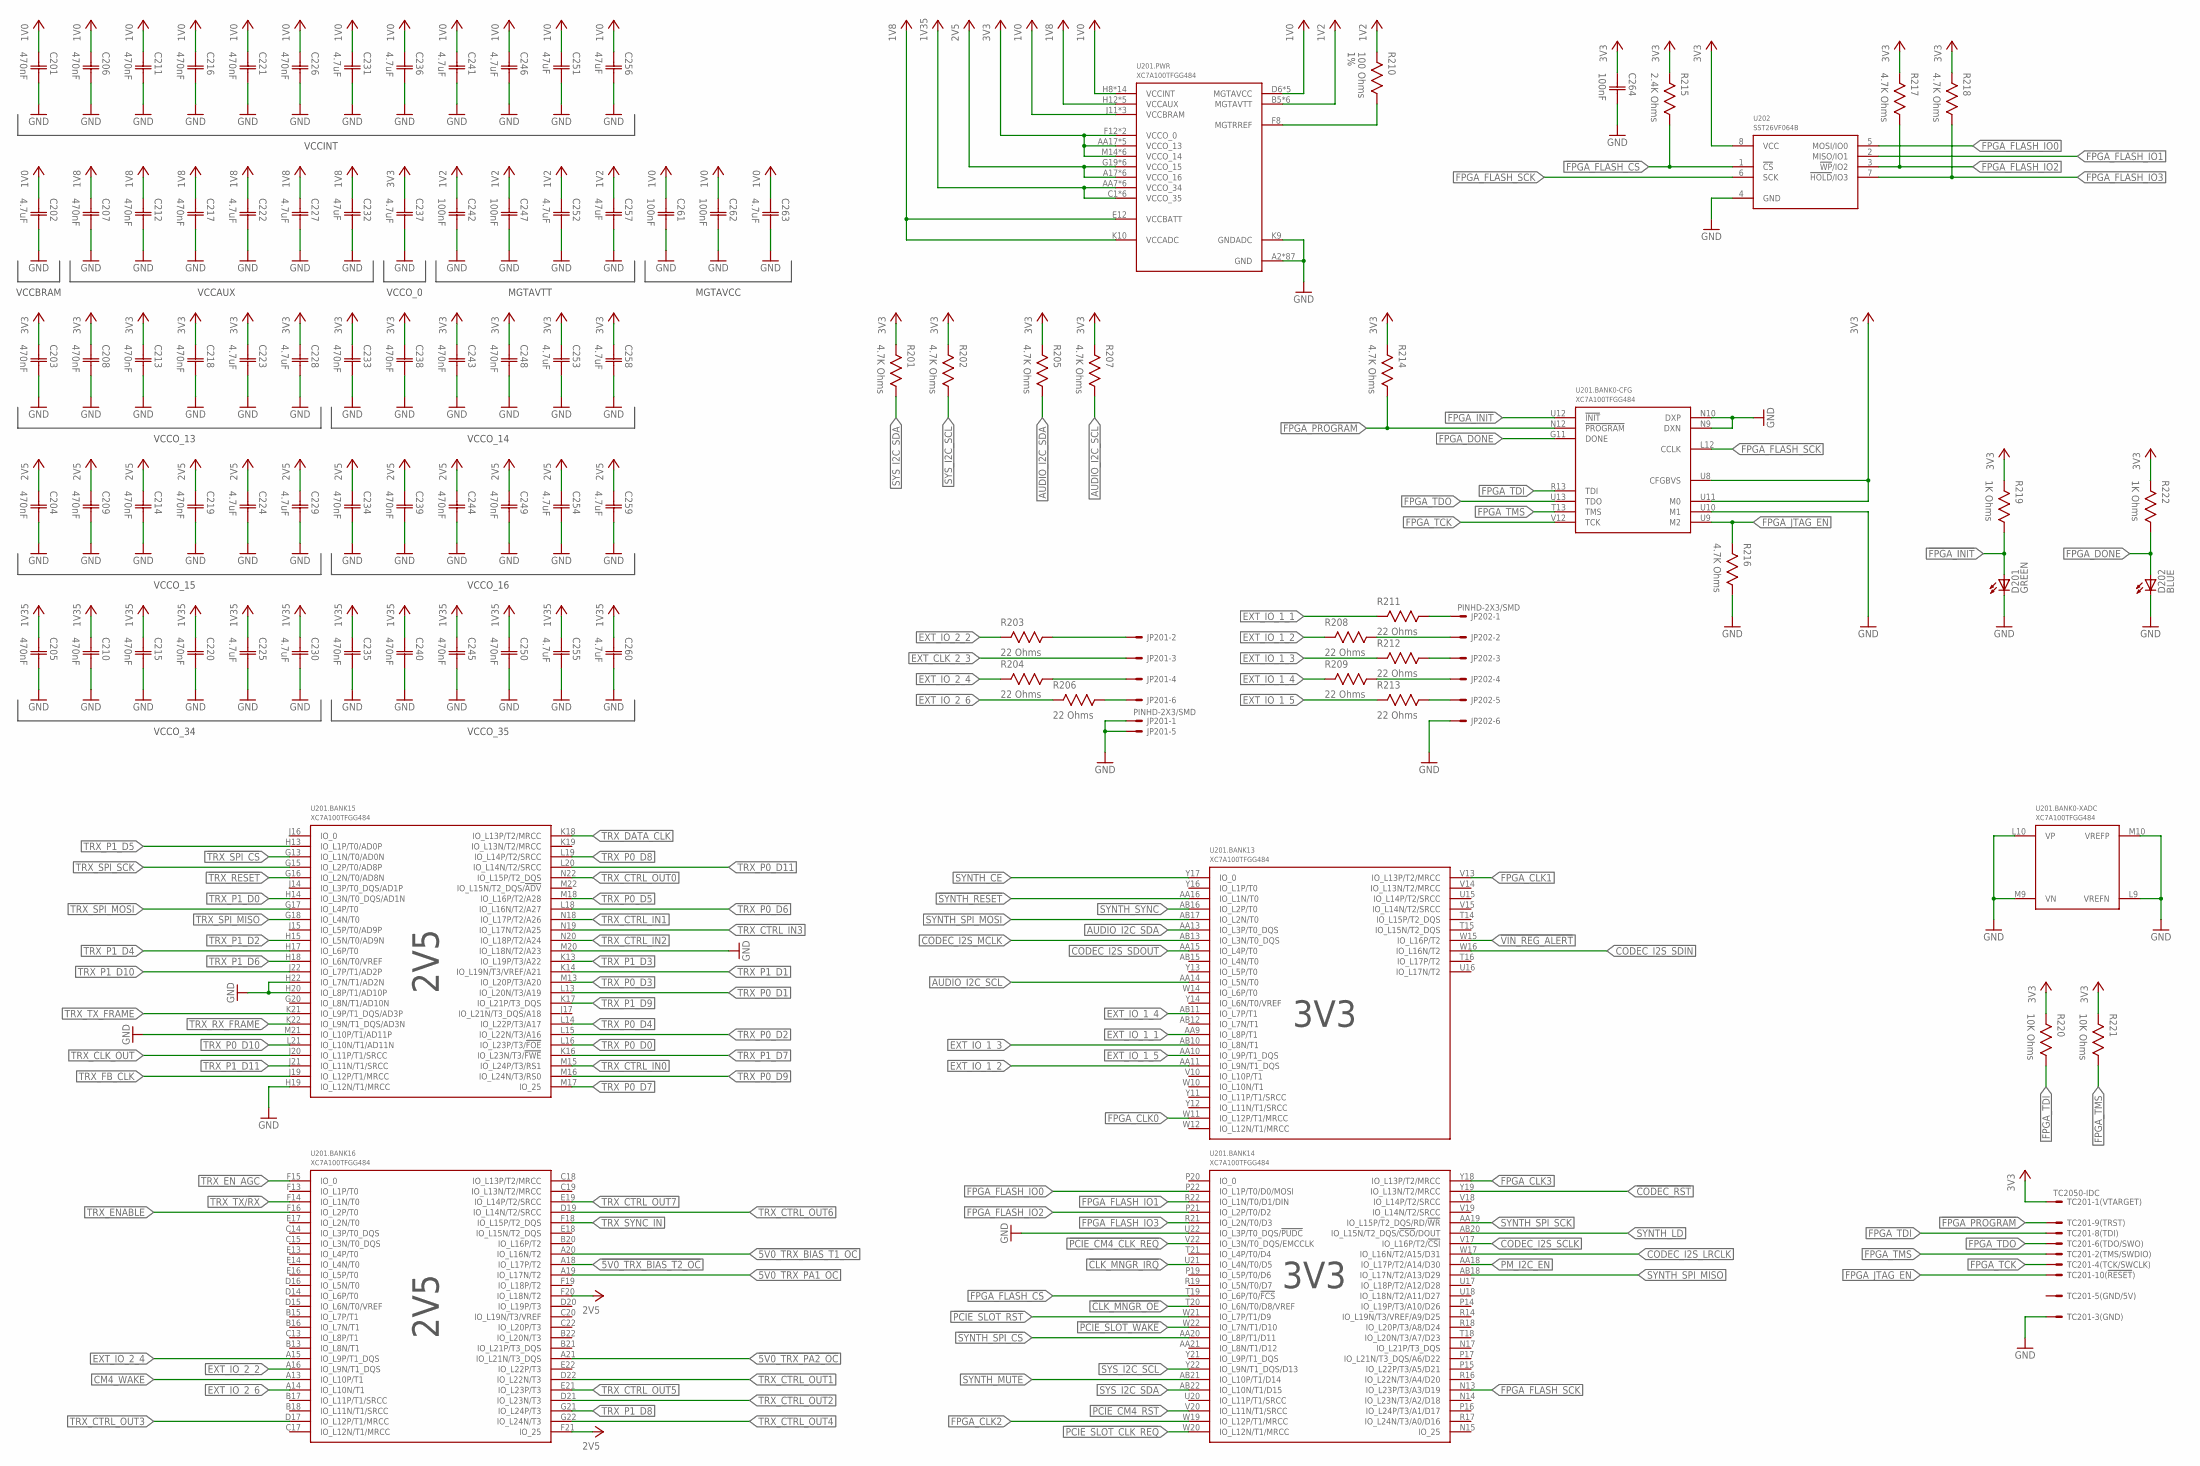
[picture p30: schematic icyradio-main.sch, sheet 2, FPGA]

Parts:
C201, C203, C204, C205, C206, C207, C208, C209, C210, C211, C212, C213, C214, C215, C216, C217, C218, C219, C220, C221, C226, C233, C234, C235, C238, C239, C240, C243, C244, C245, C248, C249, C250: 470nF; CAP0402
C202, C222, C223, C224, C225, C227, C228, C229, C230, C231, C236, C237, C241, C246, C252, C253, C254, C255, C258, C259, C260, C263: 4.7uF; CAP0402
C232, C251, C256, C257: 47uF; CAP0603
C242, C247, C261, C262, C264: 100nF; CAP0402
D201, D202: LED0603; 0603
JP201, JP202: PINHD-2X3/SMD; 2X03/SMD
R201, R202, R205, R207, R214, R216, R217, R218: 4.7K Ohms; RES0402
R203, R204, R206, R208, R209, R211, R212, R213: 22 Ohms; RES0402
R210: 100 Ohms; RES0402; TOLERANCE 1%
R215: 2.4K Ohms; RES0402
R219, R222: 1K Ohms; RES0402
R220, R221: 10K Ohms; RES0402
TC201: TC2050-IDC
U201: XC7A100TFGG484; FGG484
U202: SST26VF064B; WSOIC8

Connections:
1V0: C201.1 (C1), C202.1 (C1), C206.1 (C1), C211.1 (C1), C216.1 (C1), C221.1 (C1), C226.1 (C1), C231.1 (C1), C236.1 (C1), C241.1 (C1), C246.1 (C1), C251.1 (C1), C256.1 (C1), C261.1 (C1), C262.1 (C1), C263.1 (C1), U201.D6 (MGTAVCC), U201.D10 (MGTAVCC), U201.E8 (MGTAVCC), U201.F7 (MGTAVCC), U201.F9 (MGTAVCC), U201.H8 (VCCINT), U201.H10 (VCCINT), U201.J7 (VCCINT), U201.J9 (VCCINT), U201.J11 (VCCBRAM), U201.K8 (VCCINT), U201.L7 (VCCINT), U201.L11 (VCCBRAM), U201.M8 (VCCINT), U201.N7 (VCCINT), U201.N11 (VCCBRAM), U201.P8 (VCCINT), U201.P10 (VCCINT), U201.R7 (VCCINT), U201.R9 (VCCINT), U201.T8 (VCCINT), U201.T10 (VCCINT); also elsewhere on the board
1V2: C242.1 (C1), C247.1 (C1), C252.1 (C1), C257.1 (C1), R210.2, U201.B5 (MGTAVTT), U201.B7 (MGTAVTT), U201.B9 (MGTAVTT), U201.B11 (MGTAVTT), U201.C4 (MGTAVTT), U201.C8 (MGTAVTT); also elsewhere on the board
1V8: C207.1 (C1), C212.1 (C1), C217.1 (C1), C222.1 (C1), C227.1 (C1), C232.1 (C1), U201.E12 (VCCBATT), U201.H12 (VCCAUX), U201.K10 (VCCADC), U201.K12 (VCCAUX), U201.M12 (VCCAUX), U201.P12 (VCCAUX), U201.R11 (VCCAUX); also elsewhere on the board
1V35: C205.1 (C1), C210.1 (C1), C215.1 (C1), C220.1 (C1), C225.1 (C1), C230.1 (C1), C235.1 (C1), C240.1 (C1), C245.1 (C1), C250.1 (C1), C255.1 (C1), C260.1 (C1), U201.AA7 (VCCO_34), U201.AB4 (VCCO_34), U201.C1 (VCCO_35), U201.F2 (VCCO_35), U201.H6 (VCCO_35), U201.J3 (VCCO_35), U201.M4 (VCCO_35), U201.N1 (VCCO_35), U201.R5 (VCCO_34), U201.T2 (VCCO_34), U201.V6 (VCCO_34), U201.W3 (VCCO_34); also elsewhere on the board
2V5: C204.1 (C1), C209.1 (C1), C214.1 (C1), C219.1 (C1), C224.1 (C1), C229.1 (C1), C234.1 (C1), C239.1 (C1), C244.1 (C1), C249.1 (C1), C254.1 (C1), C259.1 (C1), U201.A17 (VCCO_16), U201.B14 (VCCO_16), U201.C21 (VCCO_16), U201.D18 (VCCO_16), U201.E15 (VCCO_16), U201.F20 (IO_L18N/T2), U201.F21 (IO_25), U201.F22 (VCCO_16), U201.G19 (VCCO_15), U201.H16 (VCCO_15), U201.J13 (VCCO_15), U201.K20 (VCCO_15), U201.L17 (VCCO_15), U201.N21 (VCCO_15); also elsewhere on the board
3V3: C203.1 (C1), C208.1 (C1), C213.1 (C1), C218.1 (C1), C223.1 (C1), C228.1 (C1), C233.1 (C1), C237.1 (C1), C238.1 (C1), C243.1 (C1), C248.1 (C1), C253.1 (C1), C258.1 (C1), C264.1 (C1), R201.2, R202.2, R205.2, R207.2, R214.2, R215.2, R217.2, R218.2, R219.2, R220.2, R221.2, R222.2, TC201.1, U201.AA17 (VCCO_13), U201.AB14 (VCCO_13), U201.F12 (VCCO_0), U201.M14 (VCCO_14), U201.P18 (VCCO_14), U201.R15 (VCCO_14), U201.T12 (VCCO_0), U201.T22 (VCCO_14), U201.U8 (CFGBVS), U201.U11 (M0), U201.U19 (VCCO_14), U201.V16 (VCCO_13), U201.W13 (VCCO_13), U201.Y10 (VCCO_13), U201.Y20 (VCCO_14), U202.8 (VCC); also elsewhere on the board
!5V0_TRX_BIAS_T1_OC: U201.A20 (IO_L16N/T2); also elsewhere on the board
!5V0_TRX_BIAS_T2_OC: U201.A18 (IO_L17P/T2); also elsewhere on the board
!5V0_TRX_PA1_OC: U201.A19 (IO_L17N/T2); also elsewhere on the board
!5V0_TRX_PA2_OC: U201.A21 (IO_L21N/T3_DQS); also elsewhere on the board
!CLK_MNGR_IRQ: U201.U21 (IO_L4N/T0/D5); also elsewhere on the board
!CLK_MNGR_OE: U201.T20 (IO_L6N/T0/D8/VREF); also elsewhere on the board
!CODEC_RST: U201.Y19 (IO_L13N/T2/MRCC); also elsewhere on the board
!FPGA_FLASH_CS: R215.1, U201.T19 (IO_L6P/T0/!FCS), U202.1 (!CS!)
!FPGA_INIT: D201.A, R219.1, U201.U12 (!INIT); also elsewhere on the board
!FPGA_PROGRAM: R214.1, TC201.9, U201.N12 (!PROGRAM)
!PCIE_CM4_CLK_REQ: U201.V22 (IO_L3N/T0_DQS/EMCCLK); also elsewhere on the board
!PCIE_CM4_RST: U201.V20 (IO_L11N/T1/SRCC); also elsewhere on the board
!PCIE_SLOT_CLK_REQ: U201.W20 (IO_L12N/T1/MRCC); also elsewhere on the board
!PCIE_SLOT_RST: U201.W21 (IO_L7P/T1/D9); also elsewhere on the board
!PCIE_SLOT_WAKE: U201.W22 (IO_L7N/T1/D10); also elsewhere on the board
!SYNTH_RESET: U201.AA16 (IO_L1N/T0); also elsewhere on the board
!SYNTH_SPI_CS: U201.AA20 (IO_L8P/T1/D11); also elsewhere on the board
!TRX_RESET: U201.G16 (IO_L2N/T0/AD8N); also elsewhere on the board
!TRX_SPI_CS: U201.G13 (IO_L1N/T0/AD0N); also elsewhere on the board
!VIN_REG_ALERT: U201.W15 (IO_L16P/T2); also elsewhere on the board
AUDIO_I2C_SCL: R207.1, U201.AA14 (IO_L5N/T0); also elsewhere on the board
AUDIO_I2C_SDA: R205.1, U201.AA13 (IO_L3P/T0_DQS); also elsewhere on the board
CM4_WAKE: U201.A13 (IO_L10P/T1); also elsewhere on the board
CODEC_I2S_LRCLK: U201.W17 (IO_L16N/T2/A15/D31); also elsewhere on the board
CODEC_I2S_MCLK: U201.AB13 (IO_L3N/T0_DQS); also elsewhere on the board
CODEC_I2S_SCLK: U201.V17 (IO_L16P/T2/!CSI); also elsewhere on the board
CODEC_I2S_SDIN: U201.W16 (IO_L16N/T2); also elsewhere on the board
CODEC_I2S_SDOUT: U201.AA15 (IO_L4P/T0); also elsewhere on the board
EXT_CLK_2_3: JP201.3; also elsewhere on the board
EXT_IO_1_1: R211.2, U201.AA9 (IO_L8P/T1)
EXT_IO_1_2: R208.2, U201.AA11 (IO_L9N/T1_DQS)
EXT_IO_1_3: R212.2, U201.AB10 (IO_L8N/T1)
EXT_IO_1_4: R209.2, U201.AB11 (IO_L7P/T1)
EXT_IO_1_5: R213.2, U201.AA10 (IO_L9P/T1_DQS)
EXT_IO_2_2: R203.2, U201.A16 (IO_L9N/T1_DQS)
EXT_IO_2_4: R204.2, U201.A15 (IO_L9P/T1_DQS)
EXT_IO_2_6: R206.2, U201.A14 (IO_L10N/T1)
FPGA_CLK0: U201.W11 (IO_L12P/T1/MRCC); also elsewhere on the board
FPGA_CLK1: U201.V13 (IO_L13P/T2/MRCC); also elsewhere on the board
FPGA_CLK2: U201.W19 (IO_L12P/T1/MRCC); also elsewhere on the board
FPGA_CLK3: U201.Y18 (IO_L13P/T2/MRCC); also elsewhere on the board
FPGA_DONE: D202.A, R222.1, U201.G11 (DONE)
FPGA_FLASH_IO0: U201.P22 (IO_L1P/T0/D0/MOSI), U202.5 (MOSI/IO0)
FPGA_FLASH_IO1: U201.R22 (IO_L1N/T0/D1/DIN), U202.2 (MISO/IO1)
FPGA_FLASH_IO2: R217.1, U201.P21 (IO_L2P/T0/D2), U202.3 (!WP!/IO2)
FPGA_FLASH_IO3: R218.1, U201.R21 (IO_L2N/T0/D3), U202.7 (!HOLD!/IO3)
FPGA_FLASH_SCK: U201.L12 (CCLK), U201.N13 (IO_L23P/T3/A3/D19), U202.6 (SCK)
FPGA_JTAG_EN: R216.2, TC201.10, U201.U9 (M2)
FPGA_TCK: TC201.4, U201.V12 (TCK)
FPGA_TDI: R220.1, TC201.8, U201.R13 (TDI)
FPGA_TDO: TC201.6, U201.U13 (TDO)
FPGA_TMS: R221.1, TC201.2, U201.T13 (TMS)
GND: C201.2 (C2), C202.2 (C2), C203.2 (C2), C204.2 (C2), C205.2 (C2), C206.2 (C2), C207.2 (C2), C208.2 (C2), C209.2 (C2), C210.2 (C2), C211.2 (C2), C212.2 (C2), C213.2 (C2), C214.2 (C2), C215.2 (C2), C216.2 (C2), C217.2 (C2), C218.2 (C2), C219.2 (C2), C220.2 (C2), C221.2 (C2), C222.2 (C2), C223.2 (C2), C224.2 (C2), C225.2 (C2), C226.2 (C2), C227.2 (C2), C228.2 (C2), C229.2 (C2), C230.2 (C2), C231.2 (C2), C232.2 (C2), C233.2 (C2), C234.2 (C2), C235.2 (C2), C236.2 (C2), C237.2 (C2), C238.2 (C2), C239.2 (C2), C240.2 (C2), C241.2 (C2), C242.2 (C2), C243.2 (C2), C244.2 (C2), C245.2 (C2), C246.2 (C2), C247.2 (C2), C248.2 (C2), C249.2 (C2), C250.2 (C2), C251.2 (C2), C252.2 (C2), C253.2 (C2), C254.2 (C2), C255.2 (C2), C256.2 (C2), C257.2 (C2), C258.2 (C2), C259.2 (C2), C260.2 (C2), C261.2 (C2), C262.2 (C2), C263.2 (C2), C264.2 (C2), D201.C, D202.C, JP201.1, JP201.5, JP202.6, R216.1, TC201.3, U201.A2 (GND), U201.A3 (GND), U201.A5 (GND), U201.A7 (GND), U201.A9 (GND), U201.A11 (GND), U201.A12 (GND), U201.A22 (GND), U201.AA2 (GND), U201.AA12 (GND), U201.AA22 (GND), U201.AB9 (GND), U201.AB19 (GND), U201.B3 (GND), U201.B12 (GND), U201.B19 (GND), U201.C3 (GND), U201.C6 (GND), U201.C10 (GND), U201.C12 (GND), U201.C16 (GND), U201.D3 (GND), U201.D4 (GND), U201.D8 (GND), U201.D12 (GND), U201.D13 (GND), U201.E4 (GND), U201.E5 (GND), U201.E7 (GND), U201.E9 (GND), U201.E11 (GND), U201.E20 (GND), U201.F5 (GND), U201.F11 (GND), U201.F17 (GND), U201.G5 (GND), U201.G6 (GND), U201.G7 (GND), U201.G8 (GND), U201.G9 (GND), U201.G10 (GND), U201.G12 (GND), U201.G14 (GND), U201.H1 (GND), U201.H7 (GND), U201.H9 (GND), U201.H11 (GND), U201.H19 (IO_L12N/T1/MRCC), U201.H20 (IO_L8P/T1/AD10P), U201.H21 (GND), U201.H22 (IO_L7N/T1/AD2N), U201.J8 (GND), U201.J10 (GND), U201.J12 (GND), U201.J18 (GND), U201.K5 (GND), U201.K7 (GND), U201.K9 (GNDADC), U201.K11 (GND), U201.K15 (GND), U201.L2 (GND), U201.L8 (GND), U201.L9 (VREFN), U201.L10 (VP), U201.L22 (GND), U201.M7 (GND), U201.M9 (VN), U201.M10 (VREFP), U201.M11 (GND), U201.M19 (GND), U201.M20 (IO_L18N/T2/A23), U201.M21 (IO_L10P/T1/AD11P), U201.N6 (GND), U201.N8 (GND), U201.N9 (DXN), U201.N10 (DXP), U201.N16 (GND), U201.P3 (GND), U201.P7 (GND), U201.P9 (GND), U201.P11 (GND), U201.P13 (GND), U201.R8 (GND), U201.R10 (GND), U201.R12 (GND), U201.R20 (GND), U201.T7 (GND), U201.T9 (GND), U201.T11 (GND), U201.T17 (GND), U201.U4 (GND), U201.U10 (M1), U201.U14 (GND), U201.U22 (IO_L3P/T0_DQS/!PUDC), U201.V1 (GND), U201.V11 (GND), U201.V21 (GND), U201.W8 (GND), U201.W18 (GND), U201.Y5 (GND), U201.Y15 (GND), U202.4 (GND); also elsewhere on the board
unnamed: R210.1, U201.F8 (MGTRREF)
unnamed: JP202.5, R213.1
unnamed: JP201.6, R206.1
unnamed: JP202.4, R209.1
unnamed: JP202.3, R212.1
unnamed: JP202.2, R208.1
unnamed: JP202.1, R211.1
unnamed: JP201.4, R204.1
unnamed: JP201.2, R203.1
PM_I2C_EN: U201.AA18 (IO_L17P/T2/A14/D30); also elsewhere on the board
SYNTH_CE: U201.Y17 (IO_0); also elsewhere on the board
SYNTH_LD: U201.AB20 (IO_L15N/T2_DQS/!CSO!/DOUT); also elsewhere on the board
SYNTH_MUTE: U201.AB21 (IO_L10P/T1/D14); also elsewhere on the board
SYNTH_SPI_MISO: U201.AB18 (IO_L17N/T2/A13/D29); also elsewhere on the board
SYNTH_SPI_MOSI: U201.AB17 (IO_L2N/T0); also elsewhere on the board
SYNTH_SPI_SCK: U201.AA19 (IO_L15P/T2_DQS/RD/!WR); also elsewhere on the board
SYNTH_SYNC: U201.AB16 (IO_L2P/T0); also elsewhere on the board
SYS_I2C_SCL: R202.1, U201.Y22 (IO_L9N/T1_DQS/D13); also elsewhere on the board
SYS_I2C_SDA: R201.1, U201.AB22 (IO_L10N/T1/D15); also elsewhere on the board
TRX_CLK_OUT: U201.J20 (IO_L11P/T1/SRCC); also elsewhere on the board
TRX_CTRL_IN0: U201.M15 (IO_L24P/T3/RS1); also elsewhere on the board
TRX_CTRL_IN1: U201.N18 (IO_L17P/T2/A26); also elsewhere on the board
TRX_CTRL_IN2: U201.N20 (IO_L18P/T2/A24); also elsewhere on the board
TRX_CTRL_IN3: U201.N19 (IO_L17N/T2/A25); also elsewhere on the board
TRX_CTRL_OUT0: U201.N22 (IO_L15P/T2_DQS); also elsewhere on the board
TRX_CTRL_OUT1: U201.D22 (IO_L22N/T3); also elsewhere on the board
TRX_CTRL_OUT2: U201.D21 (IO_L23N/T3); also elsewhere on the board
TRX_CTRL_OUT3: U201.D17 (IO_L12P/T1/MRCC); also elsewhere on the board
TRX_CTRL_OUT4: U201.G22 (IO_L24N/T3); also elsewhere on the board
TRX_CTRL_OUT5: U201.E21 (IO_L23P/T3); also elsewhere on the board
TRX_CTRL_OUT6: U201.D19 (IO_L14N/T2/SRCC); also elsewhere on the board
TRX_CTRL_OUT7: U201.E19 (IO_L14P/T2/SRCC); also elsewhere on the board
TRX_DATA_CLK: U201.K18 (IO_L13P/T2/MRCC); also elsewhere on the board
TRX_ENABLE: U201.F16 (IO_L2P/T0); also elsewhere on the board
TRX_EN_AGC: U201.F15 (IO_0); also elsewhere on the board
TRX_FB_CLK: U201.J19 (IO_L12P/T1/MRCC); also elsewhere on the board
TRX_P0_D0: U201.L16 (IO_L23P/T3/!FOE); also elsewhere on the board
TRX_P0_D1: U201.L13 (IO_L20N/T3/A19); also elsewhere on the board
TRX_P0_D2: U201.L15 (IO_L22N/T3/A16); also elsewhere on the board
TRX_P0_D3: U201.M13 (IO_L20P/T3/A20); also elsewhere on the board
TRX_P0_D4: U201.L14 (IO_L22P/T3/A17); also elsewhere on the board
TRX_P0_D5: U201.M18 (IO_L16P/T2/A28); also elsewhere on the board
TRX_P0_D6: U201.L18 (IO_L16N/T2/A27); also elsewhere on the board
TRX_P0_D7: U201.M17 (IO_25); also elsewhere on the board
TRX_P0_D8: U201.L19 (IO_L14P/T2/SRCC); also elsewhere on the board
TRX_P0_D9: U201.M16 (IO_L24N/T3/RS0); also elsewhere on the board
TRX_P0_D10: U201.L21 (IO_L10N/T1/AD11N); also elsewhere on the board
TRX_P0_D11: U201.L20 (IO_L14N/T2/SRCC); also elsewhere on the board
TRX_P1_D0: U201.H14 (IO_L3N/T0_DQS/AD1N); also elsewhere on the board
TRX_P1_D1: U201.K14 (IO_L19N/T3/VREF/A21); also elsewhere on the board
TRX_P1_D2: U201.H15 (IO_L5N/T0/AD9N); also elsewhere on the board
TRX_P1_D3: U201.K13 (IO_L19P/T3/A22); also elsewhere on the board
TRX_P1_D4: U201.H17 (IO_L6P/T0); also elsewhere on the board
TRX_P1_D5: U201.H13 (IO_L1P/T0/AD0P); also elsewhere on the board
TRX_P1_D6: U201.H18 (IO_L6N/T0/VREF); also elsewhere on the board
TRX_P1_D7: U201.K16 (IO_L23N/T3/!FWE); also elsewhere on the board
TRX_P1_D8: U201.G21 (IO_L24P/T3); also elsewhere on the board
TRX_P1_D9: U201.K17 (IO_L21P/T3_DQS); also elsewhere on the board
TRX_P1_D10: U201.J22 (IO_L7P/T1/AD2P); also elsewhere on the board
TRX_P1_D11: U201.J21 (IO_L11N/T1/SRCC); also elsewhere on the board
TRX_RX_FRAME: U201.K22 (IO_L9N/T1_DQS/AD3N); also elsewhere on the board
TRX_SPI_MISO: U201.G18 (IO_L4N/T0); also elsewhere on the board
TRX_SPI_MOSI: U201.G17 (IO_L4P/T0); also elsewhere on the board
TRX_SPI_SCK: U201.G15 (IO_L2P/T0/AD8P); also elsewhere on the board
TRX_SYNC_IN: U201.F18 (IO_L15P/T2_DQS); also elsewhere on the board
TRX_TX/!RX: U201.F14 (IO_L1N/T0); also elsewhere on the board
TRX_TX_FRAME: U201.K21 (IO_L9P/T1_DQS/AD3P); also elsewhere on the board

Notes on the sheet:
2V5
3V3
VCCINT
VCCBRAM
VCCAUX
VCCO_0
VCCO_13
VCCO_14
VCCO_15
VCCO_16
VCCO_34
VCCO_35
MGTAVTT
MGTAVCC

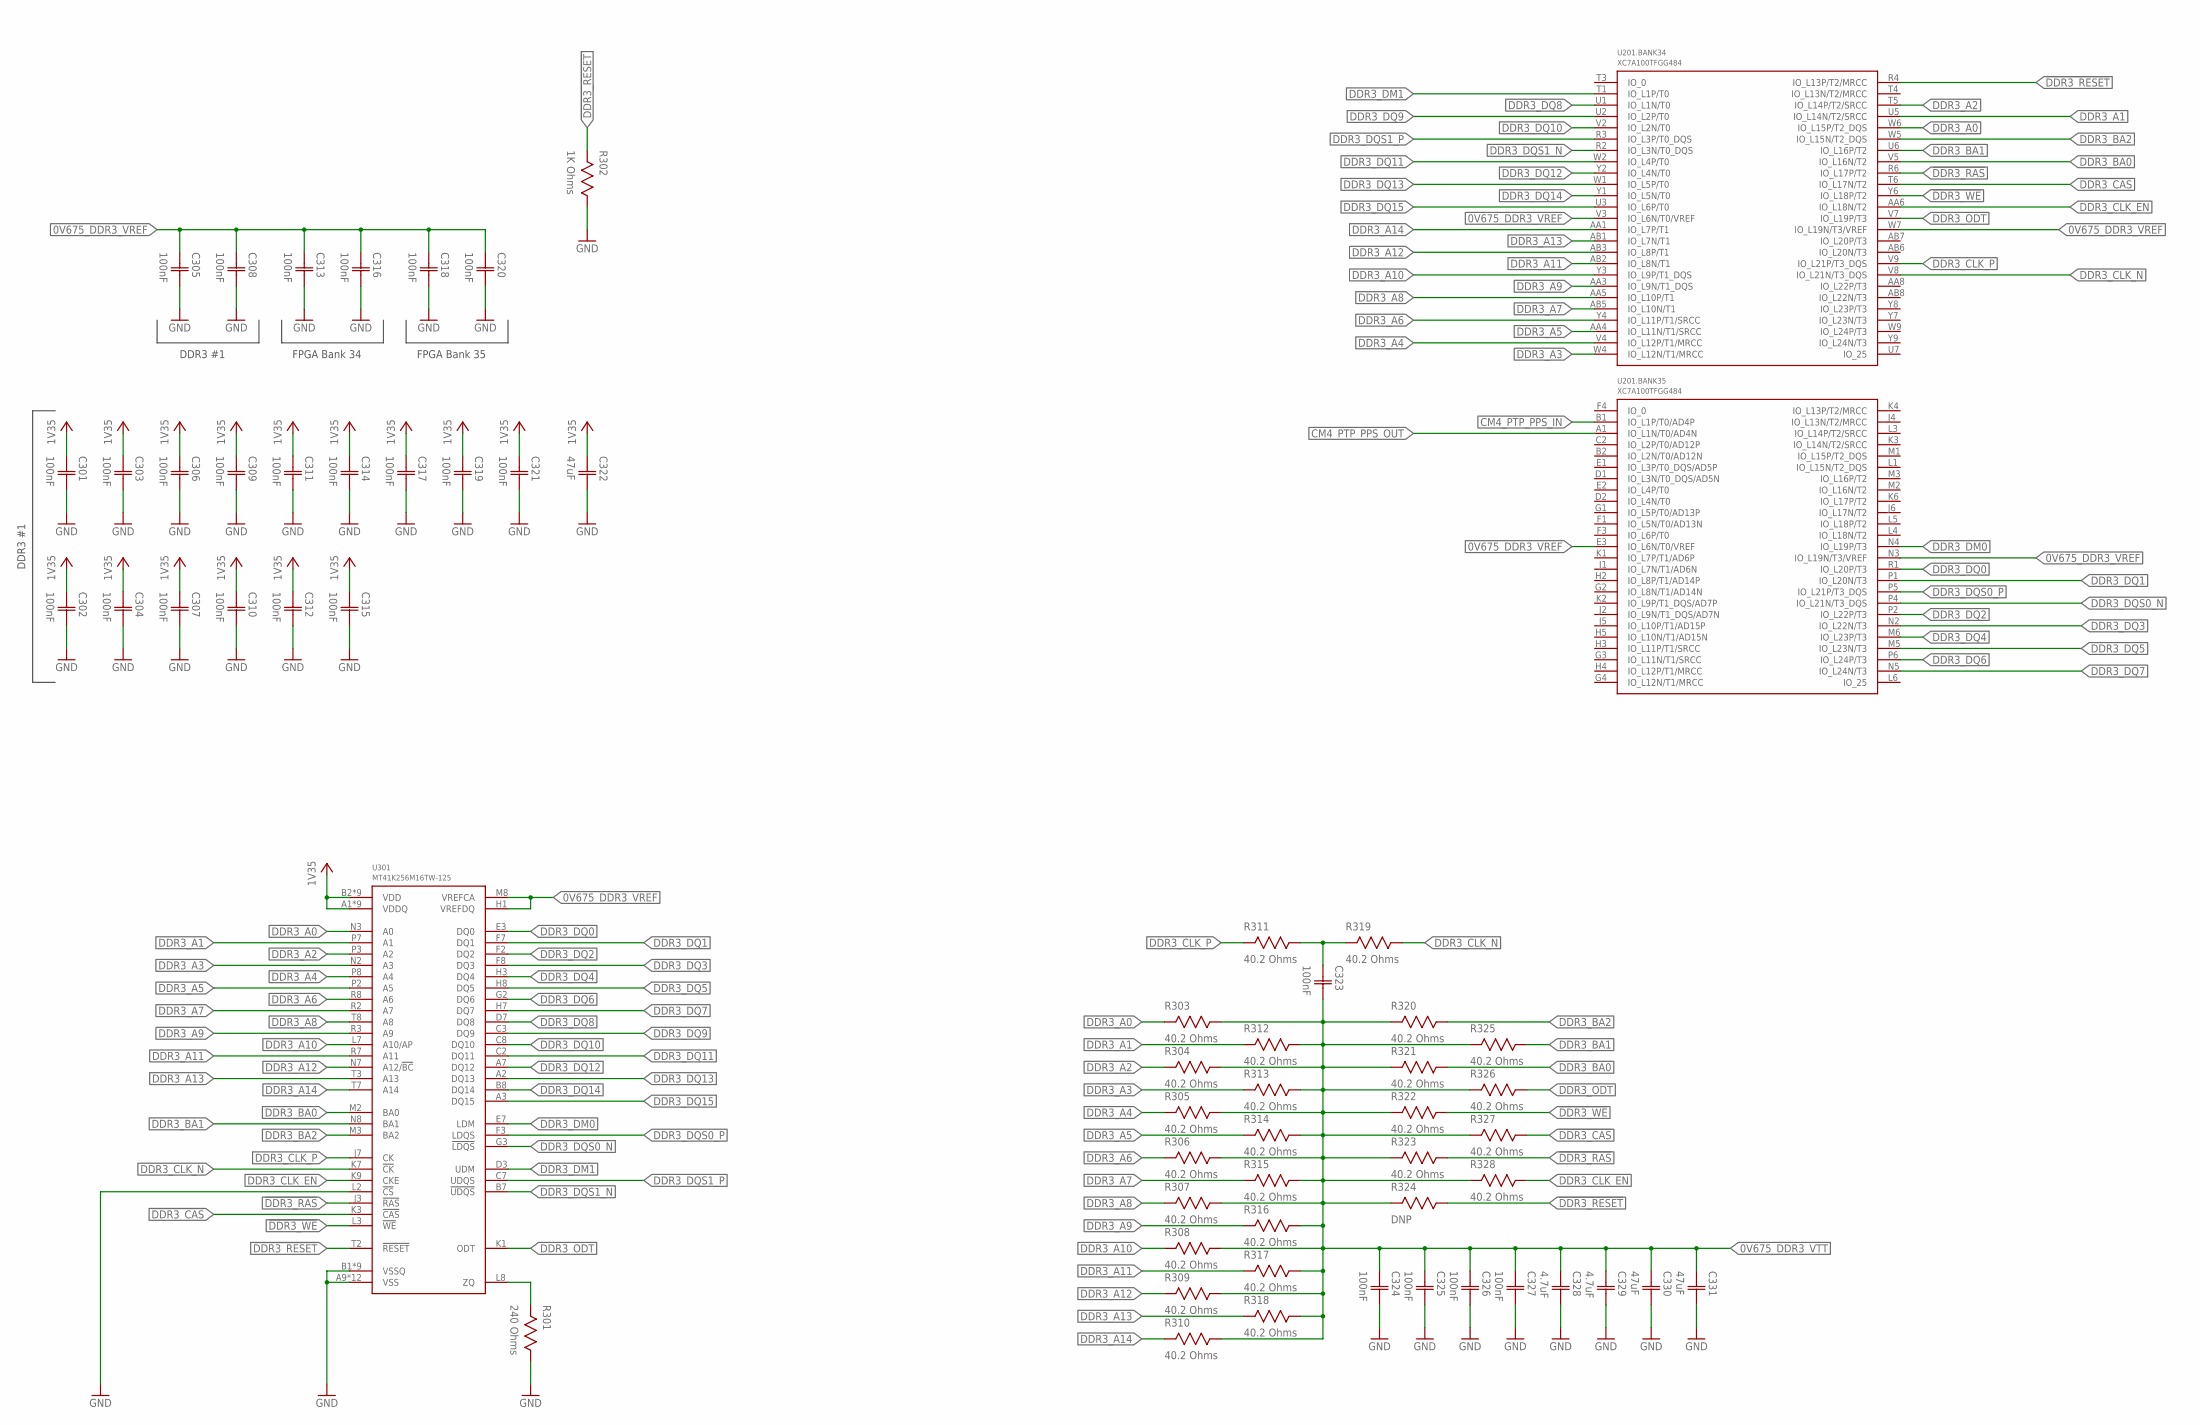
[picture p31: schematic icyradio-main.sch, sheet 3, DDR3]

Parts:
C301, C302, C303, C304, C305, C306, C307, C308, C309, C310, C311, C312, C313, C314, C315, C316, C317, C318, C319, C320, C321, C323, C324, C325, C326, C327: 100nF; CAP0402
C322, C330, C331: 47uF; CAP0603
C328, C329: 4.7uF; CAP0402
R301: 240 Ohms; RES0402
R302: 1K Ohms; RES0402
R303, R304, R305, R306, R307, R308, R309, R310, R311, R312, R313, R314, R315, R316, R317, R318, R319, R320, R321, R322, R323, R325, R326, R327, R328: 40.2 Ohms; RES0402
R324: DNP; RES0402
U201: XC7A100TFGG484; FGG484
U301: MT41K256M16TW-125; FBGA96_14X8

Connections:
0V675_DDR3_VREF: C305.1 (C1), C308.1 (C1), C313.1 (C1), C316.1 (C1), C318.1 (C1), C320.1 (C1), U201.E3 (IO_L6N/T0/VREF), U201.N3 (IO_L19N/T3/VREF), U201.V3 (IO_L6N/T0/VREF), U201.W7 (IO_L19N/T3/VREF), U301.H1 (VREFDQ), U301.M8 (VREFCA); also elsewhere on the board
0V675_DDR3_VTT: C323.2 (C2), C324.1 (C1), C325.1 (C1), C326.1 (C1), C327.1 (C1), C328.1 (C1), C329.1 (C1), C330.1 (C1), C331.1 (C1), R303.1, R304.1, R305.1, R306.1, R307.1, R308.1, R309.1, R310.1, R312.1, R313.1, R314.1, R315.1, R316.1, R317.1, R318.1, R320.2, R321.2, R322.2, R323.2, R324.2, R325.2, R326.2, R327.2, R328.2; also elsewhere on the board
1V35: C301.1 (C1), C302.1 (C1), C303.1 (C1), C304.1 (C1), C306.1 (C1), C307.1 (C1), C309.1 (C1), C310.1 (C1), C311.1 (C1), C312.1 (C1), C314.1 (C1), C315.1 (C1), C317.1 (C1), C319.1 (C1), C321.1 (C1), C322.1 (C1), U301.A1 (VDDQ), U301.A8 (VDDQ), U301.B2 (VDD), U301.C1 (VDDQ), U301.C9 (VDDQ), U301.D2 (VDDQ), U301.D9 (VDD), U301.E9 (VDDQ), U301.F1 (VDDQ), U301.G7 (VDD), U301.H2 (VDDQ), U301.H9 (VDDQ), U301.K2 (VDD), U301.K8 (VDD), U301.N1 (VDD), U301.N9 (VDD), U301.R1 (VDD), U301.R9 (VDD); also elsewhere on the board
!DDR3_CAS: R327.1, U201.T6 (IO_L17N/T2), U301.K3 (!CAS)
!DDR3_RAS: R323.1, U201.R6 (IO_L17P/T2), U301.J3 (!RAS)
!DDR3_RESET: R302.2, R324.1, U201.R4 (IO_L13P/T2/MRCC), U301.T2 (!RESET)
!DDR3_WE: R322.1, U201.Y6 (IO_L18P/T2), U301.L3 (!WE)
CM4_PTP_PPS_IN: U201.B1 (IO_L1P/T0/AD4P); also elsewhere on the board
CM4_PTP_PPS_OUT: U201.A1 (IO_L1N/T0/AD4N); also elsewhere on the board
DDR3_A0: R303.2, U201.W6 (IO_L15P/T2_DQS), U301.N3 (A0)
DDR3_A1: R312.2, U201.U5 (IO_L14N/T2/SRCC), U301.P7 (A1)
DDR3_A2: R304.2, U201.T5 (IO_L14P/T2/SRCC), U301.P3 (A2)
DDR3_A3: R313.2, U201.W4 (IO_L12N/T1/MRCC), U301.N2 (A3)
DDR3_A4: R305.2, U201.V4 (IO_L12P/T1/MRCC), U301.P8 (A4)
DDR3_A5: R314.2, U201.AA4 (IO_L11N/T1/SRCC), U301.P2 (A5)
DDR3_A6: R306.2, U201.Y4 (IO_L11P/T1/SRCC), U301.R8 (A6)
DDR3_A7: R315.2, U201.AB5 (IO_L10N/T1), U301.R2 (A7)
DDR3_A8: R307.2, U201.AA5 (IO_L10P/T1), U301.T8 (A8)
DDR3_A9: R316.2, U201.AA3 (IO_L9N/T1_DQS), U301.R3 (A9)
DDR3_A10: R308.2, U201.Y3 (IO_L9P/T1_DQS), U301.L7 (A10/AP)
DDR3_A11: R317.2, U201.AB2 (IO_L8N/T1), U301.R7 (A11)
DDR3_A12: R309.2, U201.AB3 (IO_L8P/T1), U301.N7 (A12/!BC)
DDR3_A13: R318.2, U201.AB1 (IO_L7N/T1), U301.T3 (A13)
DDR3_A14: R310.2, U201.AA1 (IO_L7P/T1), U301.T7 (A14)
DDR3_BA0: R321.1, U201.V5 (IO_L16N/T2), U301.M2 (BA0)
DDR3_BA1: R325.1, U201.U6 (IO_L16P/T2), U301.N8 (BA1)
DDR3_BA2: R320.1, U201.W5 (IO_L15N/T2_DQS), U301.M3 (BA2)
DDR3_CLK_EN: R328.1, U201.AA6 (IO_L18N/T2), U301.K9 (CKE)
DDR3_CLK_N: R319.1, U201.V8 (IO_L21N/T3_DQS), U301.K7 (!CK)
DDR3_CLK_P: R311.2, U201.V9 (IO_L21P/T3_DQS), U301.J7 (CK)
DDR3_DM0: U201.N4 (IO_L19P/T3), U301.E7 (LDM)
DDR3_DM1: U201.T1 (IO_L1P/T0), U301.D3 (UDM)
DDR3_DQ0: U201.R1 (IO_L20P/T3), U301.E3 (DQ0)
DDR3_DQ1: U201.P1 (IO_L20N/T3), U301.F7 (DQ1)
DDR3_DQ2: U201.P2 (IO_L22P/T3), U301.F2 (DQ2)
DDR3_DQ3: U201.N2 (IO_L22N/T3), U301.F8 (DQ3)
DDR3_DQ4: U201.M6 (IO_L23P/T3), U301.H3 (DQ4)
DDR3_DQ5: U201.M5 (IO_L23N/T3), U301.H8 (DQ5)
DDR3_DQ6: U201.P6 (IO_L24P/T3), U301.G2 (DQ6)
DDR3_DQ7: U201.N5 (IO_L24N/T3), U301.H7 (DQ7)
DDR3_DQ8: U201.U1 (IO_L1N/T0), U301.D7 (DQ8)
DDR3_DQ9: U201.U2 (IO_L2P/T0), U301.C3 (DQ9)
DDR3_DQ10: U201.V2 (IO_L2N/T0), U301.C8 (DQ10)
DDR3_DQ11: U201.W2 (IO_L4P/T0), U301.C2 (DQ11)
DDR3_DQ12: U201.Y2 (IO_L4N/T0), U301.A7 (DQ12)
DDR3_DQ13: U201.W1 (IO_L5P/T0), U301.A2 (DQ13)
DDR3_DQ14: U201.Y1 (IO_L5N/T0), U301.B8 (DQ14)
DDR3_DQ15: U201.U3 (IO_L6P/T0), U301.A3 (DQ15)
DDR3_DQS0_N: U201.P4 (IO_L21N/T3_DQS), U301.G3 (!LDQS)
DDR3_DQS0_P: U201.P5 (IO_L21P/T3_DQS), U301.F3 (LDQS)
DDR3_DQS1_N: U201.R2 (IO_L3N/T0_DQS), U301.B7 (!UDQS)
DDR3_DQS1_P: U201.R3 (IO_L3P/T0_DQS), U301.C7 (UDQS)
DDR3_ODT: R326.1, U201.V7 (IO_L19P/T3), U301.K1 (ODT)
GND: C301.2 (C2), C302.2 (C2), C303.2 (C2), C304.2 (C2), C305.2 (C2), C306.2 (C2), C307.2 (C2), C308.2 (C2), C309.2 (C2), C310.2 (C2), C311.2 (C2), C312.2 (C2), C313.2 (C2), C314.2 (C2), C315.2 (C2), C316.2 (C2), C317.2 (C2), C318.2 (C2), C319.2 (C2), C320.2 (C2), C321.2 (C2), C322.2 (C2), C324.2 (C2), C325.2 (C2), C326.2 (C2), C327.2 (C2), C328.2 (C2), C329.2 (C2), C330.2 (C2), C331.2 (C2), R301.1, R302.1, U301.A9 (VSS), U301.B1 (VSSQ), U301.B3 (VSS), U301.B9 (VSSQ), U301.D1 (VSSQ), U301.D8 (VSSQ), U301.E1 (VSS), U301.E2 (VSSQ), U301.E8 (VSSQ), U301.F9 (VSSQ), U301.G1 (VSSQ), U301.G8 (VSS), U301.G9 (VSSQ), U301.J2 (VSS), U301.J8 (VSS), U301.L2 (!CS), U301.M1 (VSS), U301.M9 (VSS), U301.P1 (VSS), U301.P9 (VSS), U301.T1 (VSS), U301.T9 (VSS); also elsewhere on the board
unnamed: R301.2, U301.L8 (ZQ)
unnamed: C323.1 (C1), R311.1, R319.2

Notes on the sheet:
DDR3 #1
FPGA Bank 34
FPGA Bank 35
