vankxr/icyradio/pcb/main/icyradio-main.brd

## EAGLE design pcb/main/icyradio-main.brd (continued)

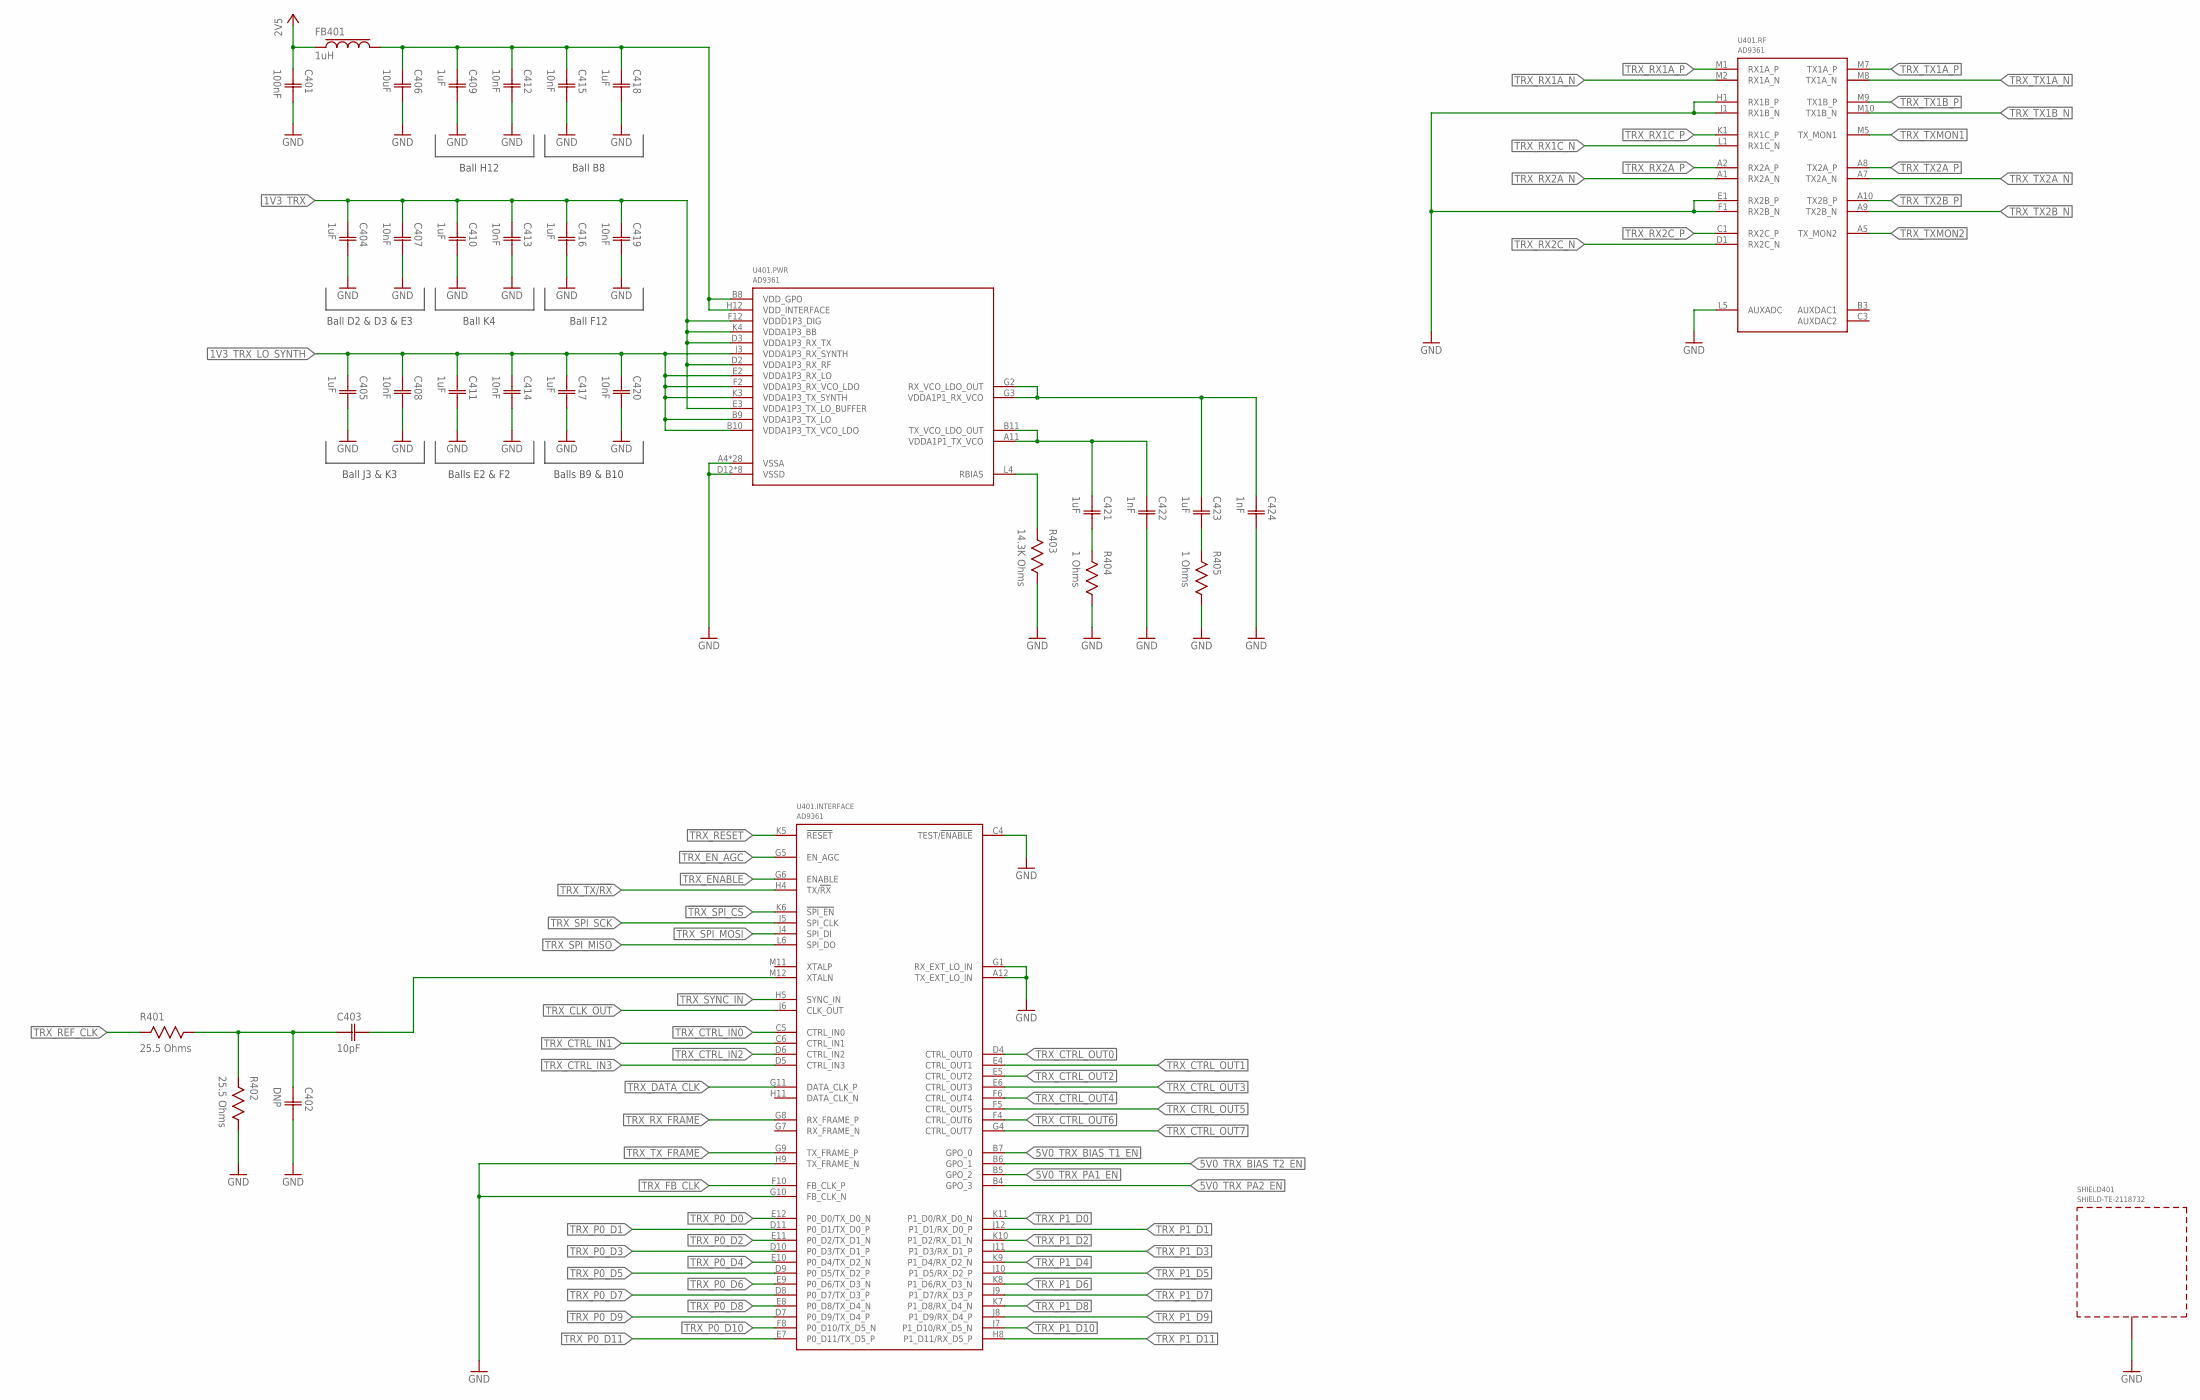
[picture p32: schematic icyradio-main.sch, sheet 4, RF Transceiver]

Parts:
C401: 100nF; CAP0402
C402: DNP; CAP0402
C403: 10pF; CAP0402
C404, C405, C409, C410, C411, C416, C417, C418, C421, C423: 1uF; CAP0402
C406: 10uF; CAP0402
C407, C408, C412, C413, C414, C415, C419, C420: 10nF; CAP0402
C422, C424: 1nF; CAP0402
FB401: 1uH; IND0603
R401, R402: 25.5 Ohms; RES0402
R403: 14.3K Ohms; RES0402
R404, R405: 1 Ohms; RES0402
SHIELD401: SHIELD-TE-2118732; 2118732
U401: AD9361; BGA144

Connections:
1V1_TRX_RX_VCO: C423.1 (C1), C424.1 (C1), U401.G2 (RX_VCO_LDO_OUT), U401.G3 (VDDA1P1_RX_VCO)
1V1_TRX_TX_VCO: C421.1 (C1), C422.1 (C1), U401.A11 (VDDA1P1_TX_VCO), U401.B11 (TX_VCO_LDO_OUT)
1V3_TRX: C404.1 (C1), C407.1 (C1), C410.1 (C1), C413.1 (C1), C416.1 (C1), C419.1 (C1), U401.D2 (VDDA1P3_RX_RF), U401.D3 (VDDA1P3_RX_TX), U401.E3 (VDDA1P3_TX_LO_BUFFER), U401.F12 (VDDD1P3_DIG), U401.K4 (VDDA1P3_BB); also elsewhere on the board
1V3_TRX_LO_SYNTH: C405.1 (C1), C408.1 (C1), C411.1 (C1), C414.1 (C1), C417.1 (C1), C420.1 (C1), U401.B9 (VDDA1P3_TX_LO), U401.B10 (VDDA1P3_TX_VCO_LDO), U401.E2 (VDDA1P3_RX_LO), U401.F2 (VDDA1P3_RX_VCO_LDO), U401.J3 (VDDA1P3_RX_SYNTH), U401.K3 (VDDA1P3_TX_SYNTH); also elsewhere on the board
2V5: C401.1 (C1), FB401.1; also elsewhere on the board
2V5_TRX_INTF_GPO_AUXDAC: C406.1 (C1), C409.1 (C1), C412.1 (C1), C415.1 (C1), C418.1 (C1), FB401.2, U401.B8 (VDD_GPO), U401.H12 (VDD_INTERFACE)
5V0_TRX_BIAS_T1_EN: U401.B7 (GPO_0); also elsewhere on the board
5V0_TRX_BIAS_T2_EN: U401.B6 (GPO_1); also elsewhere on the board
5V0_TRX_PA1_EN: U401.B5 (GPO_2); also elsewhere on the board
5V0_TRX_PA2_EN: U401.B4 (GPO_3); also elsewhere on the board
!TRX_RESET: U401.K5 (!RESET); also elsewhere on the board
!TRX_SPI_CS: U401.K6 (!SPI_EN); also elsewhere on the board
GND: C401.2 (C2), C402.2 (C2), C404.2 (C2), C405.2 (C2), C406.2 (C2), C407.2 (C2), C408.2 (C2), C409.2 (C2), C410.2 (C2), C411.2 (C2), C412.2 (C2), C413.2 (C2), C414.2 (C2), C415.2 (C2), C416.2 (C2), C417.2 (C2), C418.2 (C2), C419.2 (C2), C420.2 (C2), C422.2 (C2), C424.2 (C2), R402.1, R403.1, R404.1, R405.1, SHIELD401.1, SHIELD401.2, SHIELD401.3, SHIELD401.4, SHIELD401.5, SHIELD401.6, SHIELD401.7, SHIELD401.8, SHIELD401.9, SHIELD401.10, SHIELD401.11, SHIELD401.12, SHIELD401.13, SHIELD401.14, SHIELD401.15, SHIELD401.16, SHIELD401.17, SHIELD401.18, SHIELD401.19, SHIELD401.20, SHIELD401.21, SHIELD401.22, SHIELD401.23, SHIELD401.24, SHIELD401.25, SHIELD401.26, SHIELD401.27, SHIELD401.28, SHIELD401.29, SHIELD401.30, SHIELD401.31, SHIELD401.32, U401.A4 (VSSA), U401.A6 (VSSA), U401.A12 (TX_EXT_LO_IN), U401.B1 (VSSA), U401.B2 (VSSA), U401.B12 (VSSA), U401.C2 (VSSA), U401.C4 (TEST/!ENABLE), U401.C7 (VSSA), U401.C8 (VSSA), U401.C9 (VSSA), U401.C10 (VSSA), U401.C11 (VSSA), U401.C12 (VSSA), U401.D12 (VSSD), U401.E1 (RX2B_P), U401.F1 (RX2B_N), U401.F3 (VSSA), U401.F7 (VSSD), U401.F9 (VSSD), U401.F11 (VSSD), U401.G1 (RX_EXT_LO_IN), U401.G10 (FB_CLK_N), U401.G12 (VSSD), U401.H1 (RX1B_P), U401.H2 (VSSA), U401.H3 (VSSA), U401.H6 (VSSA), U401.H7 (VSSD), U401.H9 (TX_FRAME_N), U401.H10 (VSSD), U401.J1 (RX1B_N), U401.J2 (VSSA), U401.K2 (VSSA), U401.K12 (VSSD), U401.L2 (VSSA), U401.L3 (VSSA), U401.L5 (AUXADC), U401.L7 (VSSA), U401.L8 (VSSA), U401.L9 (VSSA), U401.L10 (VSSA), U401.L11 (VSSA), U401.L12 (VSSA), U401.M4 (VSSA), U401.M6 (VSSA); also elsewhere on the board
unnamed: R403.2, U401.L4 (RBIAS)
unnamed: C421.2 (C2), R404.2
unnamed: C423.2 (C2), R405.2
TRX_CLK_OUT: U401.J6 (CLK_OUT); also elsewhere on the board
TRX_CTRL_IN0: U401.C5 (CTRL_IN0); also elsewhere on the board
TRX_CTRL_IN1: U401.C6 (CTRL_IN1); also elsewhere on the board
TRX_CTRL_IN2: U401.D6 (CTRL_IN2); also elsewhere on the board
TRX_CTRL_IN3: U401.D5 (CTRL_IN3); also elsewhere on the board
TRX_CTRL_OUT0: U401.D4 (CTRL_OUT0); also elsewhere on the board
TRX_CTRL_OUT1: U401.E4 (CTRL_OUT1); also elsewhere on the board
TRX_CTRL_OUT2: U401.E5 (CTRL_OUT2); also elsewhere on the board
TRX_CTRL_OUT3: U401.E6 (CTRL_OUT3); also elsewhere on the board
TRX_CTRL_OUT4: U401.F6 (CTRL_OUT4); also elsewhere on the board
TRX_CTRL_OUT5: U401.F5 (CTRL_OUT5); also elsewhere on the board
TRX_CTRL_OUT6: U401.F4 (CTRL_OUT6); also elsewhere on the board
TRX_CTRL_OUT7: U401.G4 (CTRL_OUT7); also elsewhere on the board
TRX_DATA_CLK: U401.G11 (DATA_CLK_P); also elsewhere on the board
TRX_ENABLE: U401.G6 (ENABLE); also elsewhere on the board
TRX_EN_AGC: U401.G5 (EN_AGC); also elsewhere on the board
TRX_FB_CLK: U401.F10 (FB_CLK_P); also elsewhere on the board
TRX_P0_D0: U401.E12 (P0_D0/TX_D0_N); also elsewhere on the board
TRX_P0_D1: U401.D11 (P0_D1/TX_D0_P); also elsewhere on the board
TRX_P0_D2: U401.E11 (P0_D2/TX_D1_N); also elsewhere on the board
TRX_P0_D3: U401.D10 (P0_D3/TX_D1_P); also elsewhere on the board
TRX_P0_D4: U401.E10 (P0_D4/TX_D2_N); also elsewhere on the board
TRX_P0_D5: U401.D9 (P0_D5/TX_D2_P); also elsewhere on the board
TRX_P0_D6: U401.E9 (P0_D6/TX_D3_N); also elsewhere on the board
TRX_P0_D7: U401.D8 (P0_D7/TX_D3_P); also elsewhere on the board
TRX_P0_D8: U401.E8 (P0_D8/TX_D4_N); also elsewhere on the board
TRX_P0_D9: U401.D7 (P0_D9/TX_D4_P); also elsewhere on the board
TRX_P0_D10: U401.F8 (P0_D10/TX_D5_N); also elsewhere on the board
TRX_P0_D11: U401.E7 (P0_D11/TX_D5_P); also elsewhere on the board
TRX_P1_D0: U401.K11 (P1_D0/RX_D0_N); also elsewhere on the board
TRX_P1_D1: U401.J12 (P1_D1/RX_D0_P); also elsewhere on the board
TRX_P1_D2: U401.K10 (P1_D2/RX_D1_N); also elsewhere on the board
TRX_P1_D3: U401.J11 (P1_D3/RX_D1_P); also elsewhere on the board
TRX_P1_D4: U401.K9 (P1_D4/RX_D2_N); also elsewhere on the board
TRX_P1_D5: U401.J10 (P1_D5/RX_D2_P); also elsewhere on the board
TRX_P1_D6: U401.K8 (P1_D6/RX_D3_N); also elsewhere on the board
TRX_P1_D7: U401.J9 (P1_D7/RX_D3_P); also elsewhere on the board
TRX_P1_D8: U401.K7 (P1_D8/RX_D4_N); also elsewhere on the board
TRX_P1_D9: U401.J8 (P1_D9/RX_D4_P); also elsewhere on the board
TRX_P1_D10: U401.J7 (P1_D10/RX_D5_N); also elsewhere on the board
TRX_P1_D11: U401.H8 (P1_D11/RX_D5_P); also elsewhere on the board
TRX_REF_CLK: R401.2; also elsewhere on the board
TRX_REF_CLK_DIV: C402.1 (C1), C403.1 (C1), R401.1, R402.2
TRX_RX1A_N: U401.M2 (RX1A_N); also elsewhere on the board
TRX_RX1A_P: U401.M1 (RX1A_P); also elsewhere on the board
TRX_RX1C_N: U401.L1 (RX1C_N); also elsewhere on the board
TRX_RX1C_P: U401.K1 (RX1C_P); also elsewhere on the board
TRX_RX2A_N: U401.A1 (RX2A_N); also elsewhere on the board
TRX_RX2A_P: U401.A2 (RX2A_P); also elsewhere on the board
TRX_RX2C_N: U401.D1 (RX2C_N); also elsewhere on the board
TRX_RX2C_P: U401.C1 (RX2C_P); also elsewhere on the board
TRX_RX_FRAME: U401.G8 (RX_FRAME_P); also elsewhere on the board
TRX_SPI_MISO: U401.L6 (SPI_DO); also elsewhere on the board
TRX_SPI_MOSI: U401.J4 (SPI_DI); also elsewhere on the board
TRX_SPI_SCK: U401.J5 (SPI_CLK); also elsewhere on the board
TRX_SYNC_IN: U401.H5 (SYNC_IN); also elsewhere on the board
TRX_TX1A_N: U401.M8 (TX1A_N); also elsewhere on the board
TRX_TX1A_P: U401.M7 (TX1A_P); also elsewhere on the board
TRX_TX1B_N: U401.M10 (TX1B_N); also elsewhere on the board
TRX_TX1B_P: U401.M9 (TX1B_P); also elsewhere on the board
TRX_TX2A_N: U401.A7 (TX2A_N); also elsewhere on the board
TRX_TX2A_P: U401.A8 (TX2A_P); also elsewhere on the board
TRX_TX2B_N: U401.A9 (TX2B_N); also elsewhere on the board
TRX_TX2B_P: U401.A10 (TX2B_P); also elsewhere on the board
TRX_TX/!RX: U401.H4 (TX/!RX); also elsewhere on the board
TRX_TXMON1: U401.M5 (TX_MON1); also elsewhere on the board
TRX_TXMON2: U401.A5 (TX_MON2); also elsewhere on the board
TRX_TX_FRAME: U401.G9 (TX_FRAME_P); also elsewhere on the board
TRX_XTALN: C403.2 (C2), U401.M12 (XTALN)

Notes on the sheet:
Ball J3 & K3
Balls E2 & F2
Balls B9 & B10
Ball D2 & D3 & E3
Ball K4
Ball F12
Ball H12
Ball B8

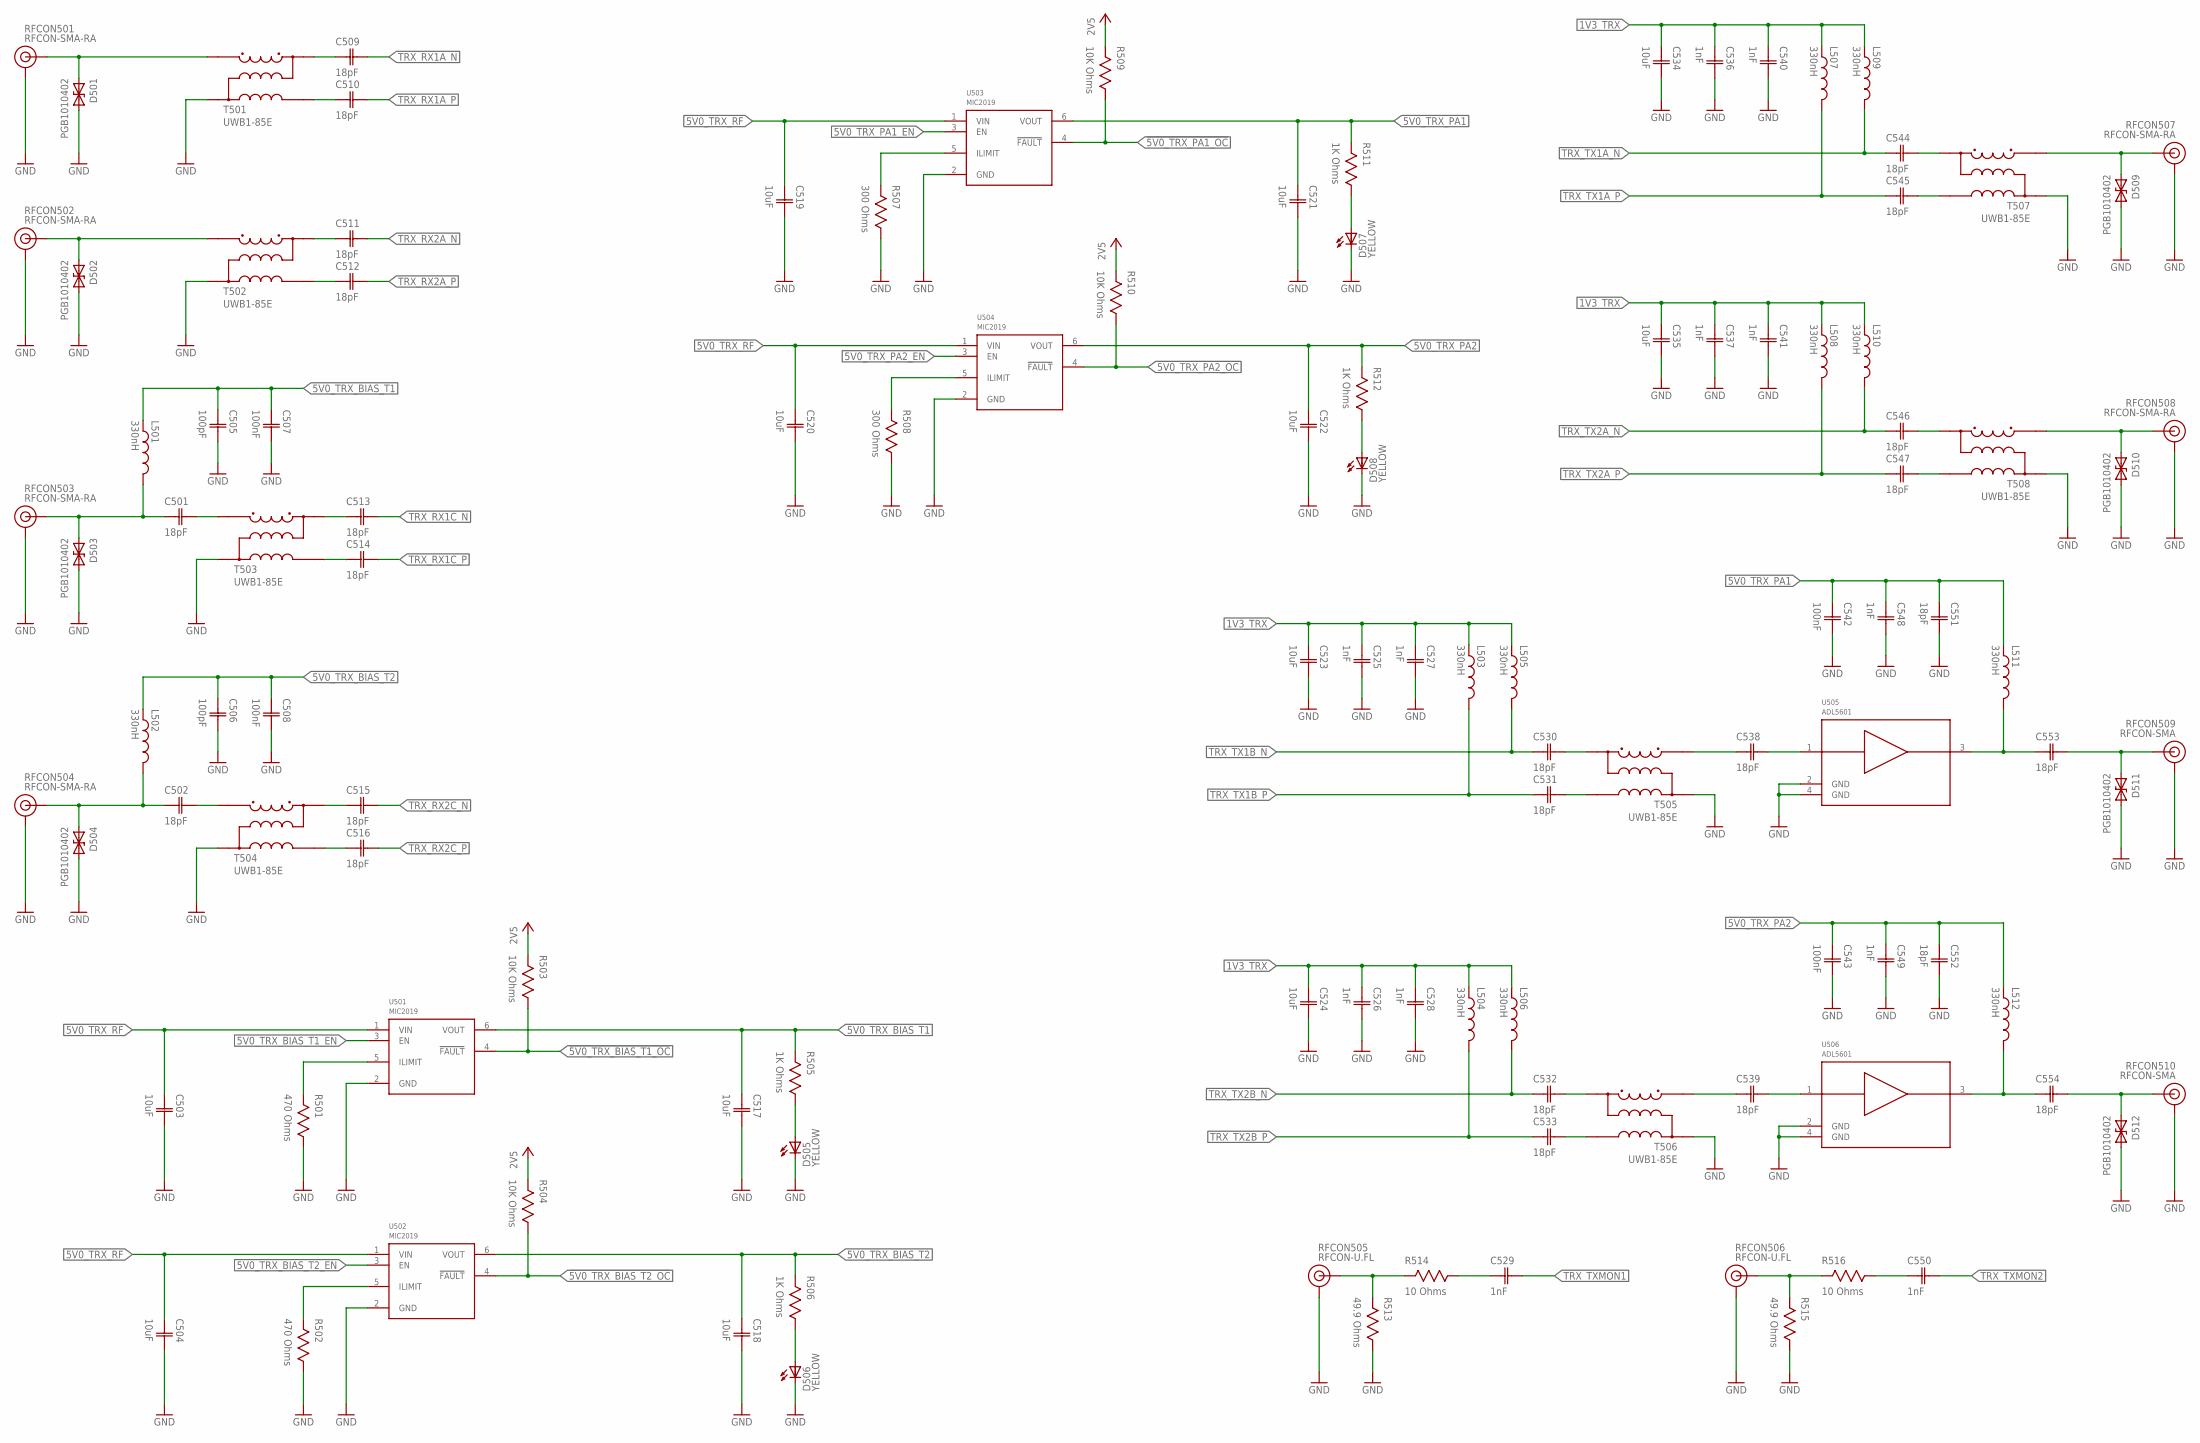
[picture p33: schematic icyradio-main.sch, sheet 5, RF Interface]

Parts:
C501, C502, C509, C510, C511, C512, C513, C514, C515, C516, C530, C531, C532, C533, C538, C539, C544, C545, C546, C547, C551, C552, C553, C554: 18pF; CAP0402
C503, C504, C517, C518, C519, C520, C521, C522: 10uF; CAP0603
C505, C506: 100pF; CAP0402
C507, C508, C542, C543: 100nF; CAP0402
C523, C524, C534, C535: 10uF; CAP0402
C525, C526, C527, C528, C529, C536, C537, C540, C541, C548, C549, C550: 1nF; CAP0402
D501, D502, D503, D504, D509, D510, D511, D512: PGB1010402; TVS0402
D505, D506, D507, D508: LED0603; 0603
L501, L502: 330nH; IND0805
L503, L504, L505, L506, L507, L508, L509, L510, L511, L512: 330nH; IND0603
R501, R502: 470 Ohms; RES0402
R503, R504, R509, R510: 10K Ohms; RES0402
R505, R506, R511, R512: 1K Ohms; RES0402
R507, R508: 300 Ohms; RES0402
R513, R515: 49.9 Ohms; RES0402
R514, R516: 10 Ohms; RES0402
RFCON501, RFCON502, RFCON503, RFCON504, RFCON507, RFCON508: RFCON-SMA-RA; SMA-RA
RFCON505, RFCON506: RFCON-U.FL; U.FL
RFCON509, RFCON510: RFCON-SMA; SMA
T501, T502, T503, T504, T505, T506, T507, T508: UWB1-85E; UWB1
U501, U502, U503, U504: MIC2019; SOT23-6
U505, U506: ADL5601; SOT89

Connections:
1V3_TRX: C523.1 (C1), C524.1 (C1), C525.1 (C1), C526.1 (C1), C527.1 (C1), C528.1 (C1), C534.1 (C1), C535.1 (C1), C536.1 (C1), C537.1 (C1), C540.1 (C1), C541.1 (C1), L503.1, L504.1, L505.1, L506.1, L507.1, L508.1, L509.1, L510.1; also elsewhere on the board
2V5: R503.2, R504.2, R509.2, R510.2; also elsewhere on the board
5V0_TRX_BIAS_T1: C505.1 (C1), C507.1 (C1), C517.1 (C1), L501.1, R505.2, U501.6 (VOUT)
5V0_TRX_BIAS_T1_EN: U501.3 (EN); also elsewhere on the board
5V0_TRX_BIAS_T2: C506.1 (C1), C508.1 (C1), C518.1 (C1), L502.1, R506.2, U502.6 (VOUT)
5V0_TRX_BIAS_T2_EN: U502.3 (EN); also elsewhere on the board
5V0_TRX_PA1: C521.1 (C1), C542.1 (C1), C548.1 (C1), C551.1 (C1), L511.1, R511.2, U503.6 (VOUT)
5V0_TRX_PA1_EN: U503.3 (EN); also elsewhere on the board
5V0_TRX_PA2: C522.1 (C1), C543.1 (C1), C549.1 (C1), C552.1 (C1), L512.1, R512.2, U504.6 (VOUT)
5V0_TRX_PA2_EN: U504.3 (EN); also elsewhere on the board
5V0_TRX_RF: C503.1 (C1), C504.1 (C1), C519.1 (C1), C520.1 (C1), U501.1 (VIN), U502.1 (VIN), U503.1 (VIN), U504.1 (VIN); also elsewhere on the board
!5V0_TRX_BIAS_T1_OC: R503.1, U501.4 (!FAULT); also elsewhere on the board
!5V0_TRX_BIAS_T2_OC: R504.1, U502.4 (!FAULT); also elsewhere on the board
!5V0_TRX_PA1_OC: R509.1, U503.4 (!FAULT); also elsewhere on the board
!5V0_TRX_PA2_OC: R510.1, U504.4 (!FAULT); also elsewhere on the board
GND: C503.2 (C2), C504.2 (C2), C505.2 (C2), C506.2 (C2), C507.2 (C2), C508.2 (C2), C517.2 (C2), C518.2 (C2), C519.2 (C2), C520.2 (C2), C521.2 (C2), C522.2 (C2), C523.2 (C2), C524.2 (C2), C525.2 (C2), C526.2 (C2), C527.2 (C2), C528.2 (C2), C534.2 (C2), C535.2 (C2), C536.2 (C2), C537.2 (C2), C540.2 (C2), C541.2 (C2), C542.2 (C2), C543.2 (C2), C548.2 (C2), C549.2 (C2), C551.2 (C2), C552.2 (C2), D501.2, D502.2, D503.2, D504.2, D505.C, D506.C, D507.C, D508.C, D509.2, D510.2, D511.2, D512.2, R501.1, R502.1, R507.1, R508.1, R513.1, R515.1, RFCON501.GND@0 (GND), RFCON501.GND@1 (GND), RFCON501.GND@2 (GND), RFCON501.GND@3 (GND), RFCON502.GND@0 (GND), RFCON502.GND@1 (GND), RFCON502.GND@2 (GND), RFCON502.GND@3 (GND), RFCON503.GND@0 (GND), RFCON503.GND@1 (GND), RFCON503.GND@2 (GND), RFCON503.GND@3 (GND), RFCON504.GND@0 (GND), RFCON504.GND@1 (GND), RFCON504.GND@2 (GND), RFCON504.GND@3 (GND), RFCON505.P$1 (GND), RFCON505.P$2 (GND), RFCON506.P$1 (GND), RFCON506.P$2 (GND), RFCON507.GND@0 (GND), RFCON507.GND@1 (GND), RFCON507.GND@2 (GND), RFCON507.GND@3 (GND), RFCON508.GND@0 (GND), RFCON508.GND@1 (GND), RFCON508.GND@2 (GND), RFCON508.GND@3 (GND), RFCON509.GND@0 (GND), RFCON509.GND@1 (GND), RFCON509.GND@2 (GND), RFCON509.GND@3 (GND), RFCON510.GND@0 (GND), RFCON510.GND@1 (GND), RFCON510.GND@2 (GND), RFCON510.GND@3 (GND), T501.2 (PRI2), T502.2 (PRI2), T503.2 (PRI2), T504.2 (PRI2), T505.2 (PRI2), T506.2 (PRI2), T507.2 (PRI2), T508.2 (PRI2), U501.2 (GND), U502.2 (GND), U503.2 (GND), U504.2 (GND), U505.2 (GND), U505.4 (GND), U506.2 (GND), U506.4 (GND); also elsewhere on the board
unnamed: C533.2 (C2), T506.4 (SEC2)
unnamed: C532.2 (C2), T506.5 (SEC1)
unnamed: D508.A, R512.1
unnamed: C529.1 (C1), R514.1
unnamed: D507.A, R511.1
unnamed: C550.1 (C1), R516.1
unnamed: C545.2 (C2), T507.4 (SEC2)
unnamed: C544.2 (C2), T507.5 (SEC1)
unnamed: C547.2 (C2), T508.4 (SEC2)
unnamed: C546.2 (C2), T508.5 (SEC1)
unnamed: C510.1 (C1), T501.4 (SEC2)
unnamed: C509.1 (C1), T501.5 (SEC1)
unnamed: C512.1 (C1), T502.4 (SEC2)
unnamed: C511.1 (C1), T502.5 (SEC1)
unnamed: D505.A, R505.1
unnamed: D506.A, R506.1
unnamed: C516.1 (C1), T504.4 (SEC2)
unnamed: C515.1 (C1), T504.5 (SEC1)
unnamed: R507.2, U503.5 (ILIMIT)
unnamed: C514.1 (C1), T503.4 (SEC2)
unnamed: C513.1 (C1), T503.5 (SEC1)
unnamed: C531.2 (C2), T505.4 (SEC2)
unnamed: C530.2 (C2), T505.5 (SEC1)
unnamed: R508.2, U504.5 (ILIMIT)
unnamed: R501.2, U501.5 (ILIMIT)
unnamed: R502.2, U502.5 (ILIMIT)
TRX_RX1A: D501.1, RFCON501.SIGNAL, T501.3 (PRI1)
TRX_RX1A_N: C509.2 (C2); also elsewhere on the board
TRX_RX1A_P: C510.2 (C2); also elsewhere on the board
TRX_RX1C_ACC: C501.2 (C2), T503.3 (PRI1)
TRX_RX1C_DCC: C501.1 (C1), D503.1, L501.2, RFCON503.SIGNAL
TRX_RX1C_N: C513.2 (C2); also elsewhere on the board
TRX_RX1C_P: C514.2 (C2); also elsewhere on the board
TRX_RX2A: D502.1, RFCON502.SIGNAL, T502.3 (PRI1)
TRX_RX2A_N: C511.2 (C2); also elsewhere on the board
TRX_RX2A_P: C512.2 (C2); also elsewhere on the board
TRX_RX2C_ACC: C502.2 (C2), T504.3 (PRI1)
TRX_RX2C_DCC: C502.1 (C1), D504.1, L502.2, RFCON504.SIGNAL
TRX_RX2C_N: C515.2 (C2); also elsewhere on the board
TRX_RX2C_P: C516.2 (C2); also elsewhere on the board
TRX_TX1A: D509.1, RFCON507.SIGNAL, T507.3 (PRI1)
TRX_TX1A_N: C544.1 (C1), L509.2; also elsewhere on the board
TRX_TX1A_P: C545.1 (C1), L507.2; also elsewhere on the board
TRX_TX1B: C538.1 (C1), T505.3 (PRI1)
TRX_TX1B_AMP_ACC: C553.2 (C2), D511.1, RFCON509.SIGNAL
TRX_TX1B_AMP_DCC: C553.1 (C1), L511.2, U505.3 (RFOUT)
TRX_TX1B_DCC: C538.2 (C2), U505.1 (RFIN)
TRX_TX1B_N: C530.1 (C1), L505.2; also elsewhere on the board
TRX_TX1B_P: C531.1 (C1), L503.2; also elsewhere on the board
TRX_TX2A: D510.1, RFCON508.SIGNAL, T508.3 (PRI1)
TRX_TX2A_N: C546.1 (C1), L510.2; also elsewhere on the board
TRX_TX2A_P: C547.1 (C1), L508.2; also elsewhere on the board
TRX_TX2B: C539.1 (C1), T506.3 (PRI1)
TRX_TX2B_AMP: C554.2 (C2), D512.1, RFCON510.SIGNAL
TRX_TX2B_AMP_DCC: C554.1 (C1), L512.2, U506.3 (RFOUT)
TRX_TX2B_DCC: C539.2 (C2), U506.1 (RFIN)
TRX_TX2B_N: C532.1 (C1), L506.2; also elsewhere on the board
TRX_TX2B_P: C533.1 (C1), L504.2; also elsewhere on the board
TRX_TXMON1: C529.2 (C2); also elsewhere on the board
TRX_TXMON1_Z50: R513.2, R514.2, RFCON505.P$3 (SIGNAL)
TRX_TXMON2: C550.2 (C2); also elsewhere on the board
TRX_TXMON2_Z50: R515.2, R516.2, RFCON506.P$3 (SIGNAL)

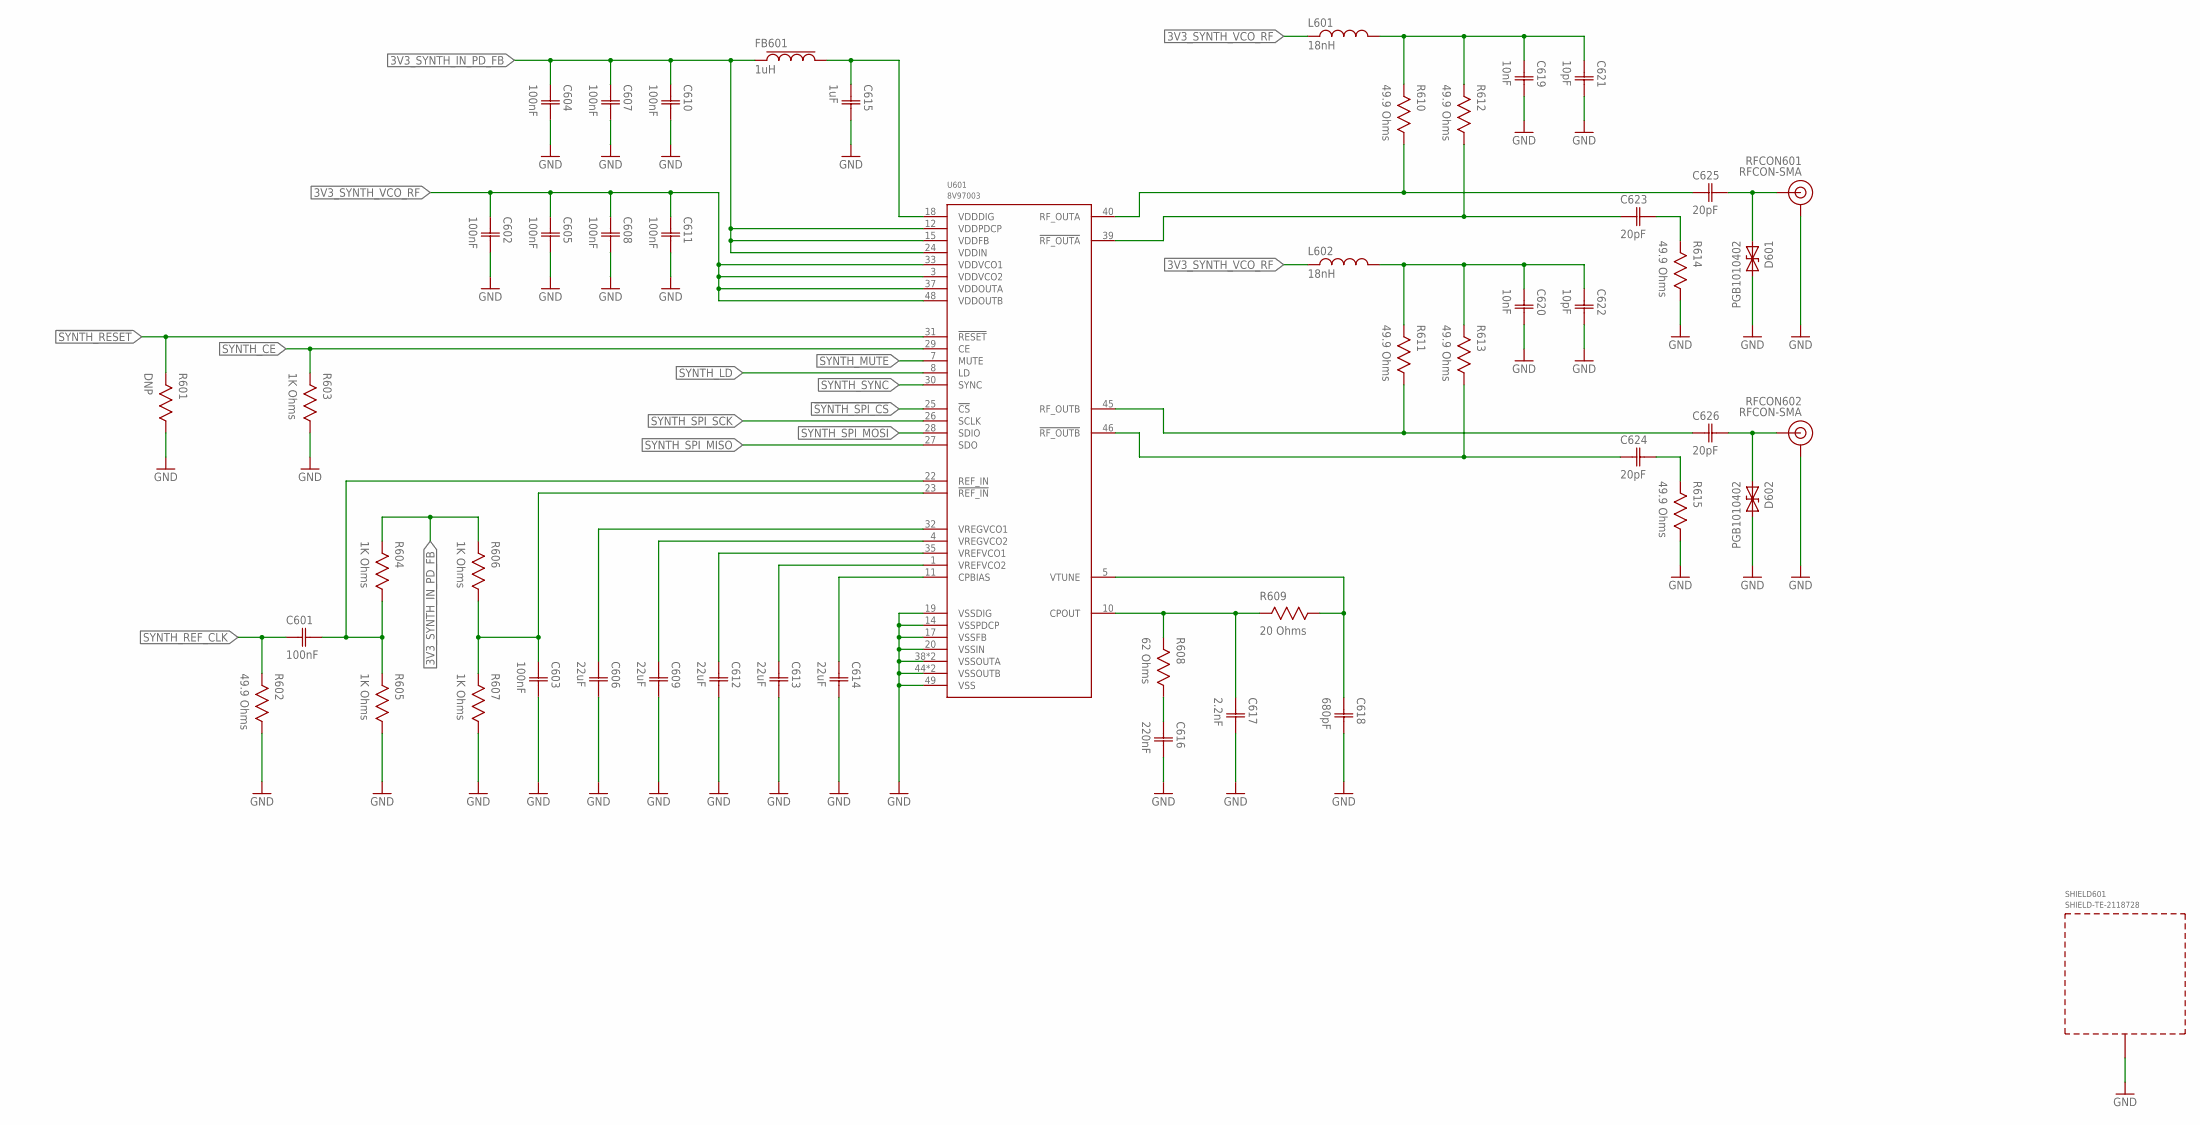
[picture p34: schematic icyradio-main.sch, sheet 6, mmWave Synthesizer]

Parts:
C601, C602, C603, C604, C605, C607, C608, C610, C611: 100nF; CAP0402
C606, C609, C612, C613, C614: 22uF; CAP0402
C615: 1uF; CAP0402
C616: 220nF; CAP0402
C617: 2.2nF; CAP0402
C618: 680pF; CAP0402
C619, C620: 10nF; CAP0402
C621, C622: 10pF; CAP0402
C623, C624, C625, C626: 20pF; CAP0402
D601, D602: PGB1010402; TVS0402
FB601: 1uH; IND0603
L601, L602: 18nH; IND0402
R601: DNP; RES0402
R602, R610, R611, R612, R613, R614, R615: 49.9 Ohms; RES0402
R603, R604, R605, R606, R607: 1K Ohms; RES0402
R608: 62 Ohms; RES0402
R609: 20 Ohms; RES0402
RFCON601, RFCON602: RFCON-SMA; SMA
SHIELD601: SHIELD-TE-2118728; 2118728
U601: 8V97003; VFQFPN48

Connections:
3V3_SYNTH_IN_PD_FB: C604.1 (C1), C607.1 (C1), C610.1 (C1), FB601.1, R604.2, R606.2, U601.12 (VDDPDCP), U601.15 (VDDFB), U601.24 (VDDIN); also elsewhere on the board
3V3_SYNTH_VCO_RF: C602.1 (C1), C605.1 (C1), C608.1 (C1), C611.1 (C1), L601.1, L602.1, U601.3 (VDDVCO2), U601.33 (VDDVCO1), U601.37 (VDDOUTA), U601.48 (VDDOUTB); also elsewhere on the board
!SYNTH_RESET: R601.2, U601.31 (!RESET); also elsewhere on the board
!SYNTH_SPI_CS: U601.25 (!CS); also elsewhere on the board
GND: C602.2 (C2), C603.2 (C2), C604.2 (C2), C605.2 (C2), C606.2 (C2), C607.2 (C2), C608.2 (C2), C609.2 (C2), C610.2 (C2), C611.2 (C2), C612.2 (C2), C613.2 (C2), C614.2 (C2), C615.2 (C2), C616.2 (C2), C617.2 (C2), C618.2 (C2), C619.2 (C2), C620.2 (C2), C621.2 (C2), C622.2 (C2), D601.2, D602.2, R601.1, R602.1, R603.1, R605.1, R607.1, R614.1, R615.1, RFCON601.GND@0 (GND), RFCON601.GND@1 (GND), RFCON601.GND@2 (GND), RFCON601.GND@3 (GND), RFCON602.GND@0 (GND), RFCON602.GND@1 (GND), RFCON602.GND@2 (GND), RFCON602.GND@3 (GND), SHIELD601.1, SHIELD601.2, SHIELD601.3, SHIELD601.4, SHIELD601.5, SHIELD601.6, SHIELD601.7, SHIELD601.8, SHIELD601.9, SHIELD601.10, SHIELD601.11, SHIELD601.12, SHIELD601.13, SHIELD601.14, SHIELD601.15, SHIELD601.16, U601.14 (VSSPDCP), U601.17 (VSSFB), U601.19 (VSSDIG), U601.20 (VSSIN), U601.38 (VSSOUTA), U601.41 (VSSOUTA), U601.44 (VSSOUTB), U601.47 (VSSOUTB), U601.49 (VSS); also elsewhere on the board
unnamed: C615.1 (C1), FB601.2, U601.18 (VDDDIG)
unnamed: C616.1 (C1), R608.1
SYNTH_CE: R603.2, U601.29 (CE); also elsewhere on the board
SYNTH_CPBIAS: C614.1 (C1), U601.11 (CPBIAS)
SYNTH_CPOUT: C617.1 (C1), R608.2, R609.2, U601.10 (CPOUT)
SYNTH_LD: U601.8 (LD); also elsewhere on the board
SYNTH_MUTE: U601.7 (MUTE); also elsewhere on the board
SYNTH_REFIN_N: C603.1 (C1), R606.1, R607.2, U601.23 (!REF_IN)
SYNTH_REFIN_P: C601.2 (C2), R604.1, R605.2, U601.22 (REF_IN)
SYNTH_REF_CLK: C601.1 (C1), R602.2; also elsewhere on the board
SYNTH_RFOUTA_ACC_N: C623.2 (C2), R614.2
SYNTH_RFOUTA_ACC_P: C625.2 (C2), D601.1, RFCON601.SIGNAL
SYNTH_RFOUTA_BIAS: C619.1 (C1), C621.1 (C1), L601.2, R610.2, R612.2
SYNTH_RFOUTA_N: C623.1 (C1), R612.1, U601.39 (!RF_OUTA)
SYNTH_RFOUTA_P: C625.1 (C1), R610.1, U601.40 (RF_OUTA)
SYNTH_RFOUTB_ACC_N: C624.2 (C2), R615.2
SYNTH_RFOUTB_ACC_P: C626.2 (C2), D602.1, RFCON602.SIGNAL
SYNTH_RFOUTB_BIAS: C620.1 (C1), C622.1 (C1), L602.2, R611.2, R613.2
SYNTH_RFOUTB_N: C624.1 (C1), R613.1, U601.46 (!RF_OUTB)
SYNTH_RFOUTB_P: C626.1 (C1), R611.1, U601.45 (RF_OUTB)
SYNTH_SPI_MISO: U601.27 (SDO); also elsewhere on the board
SYNTH_SPI_MOSI: U601.28 (SDIO); also elsewhere on the board
SYNTH_SPI_SCK: U601.26 (SCLK); also elsewhere on the board
SYNTH_SYNC: U601.30 (SYNC); also elsewhere on the board
SYNTH_VREFVCO1: C612.1 (C1), U601.35 (VREFVCO1)
SYNTH_VREFVCO2: C613.1 (C1), U601.1 (VREFVCO2)
SYNTH_VREGVCO1: C606.1 (C1), U601.32 (VREGVCO1)
SYNTH_VREGVCO2: C609.1 (C1), U601.4 (VREGVCO2)
SYNTH_VTUNE: C618.1 (C1), R609.1, U601.5 (VTUNE)
