vankxr/icyradio/pcb/main/icyradio-main.brd

## EAGLE design pcb/main/icyradio-main.brd (continued)

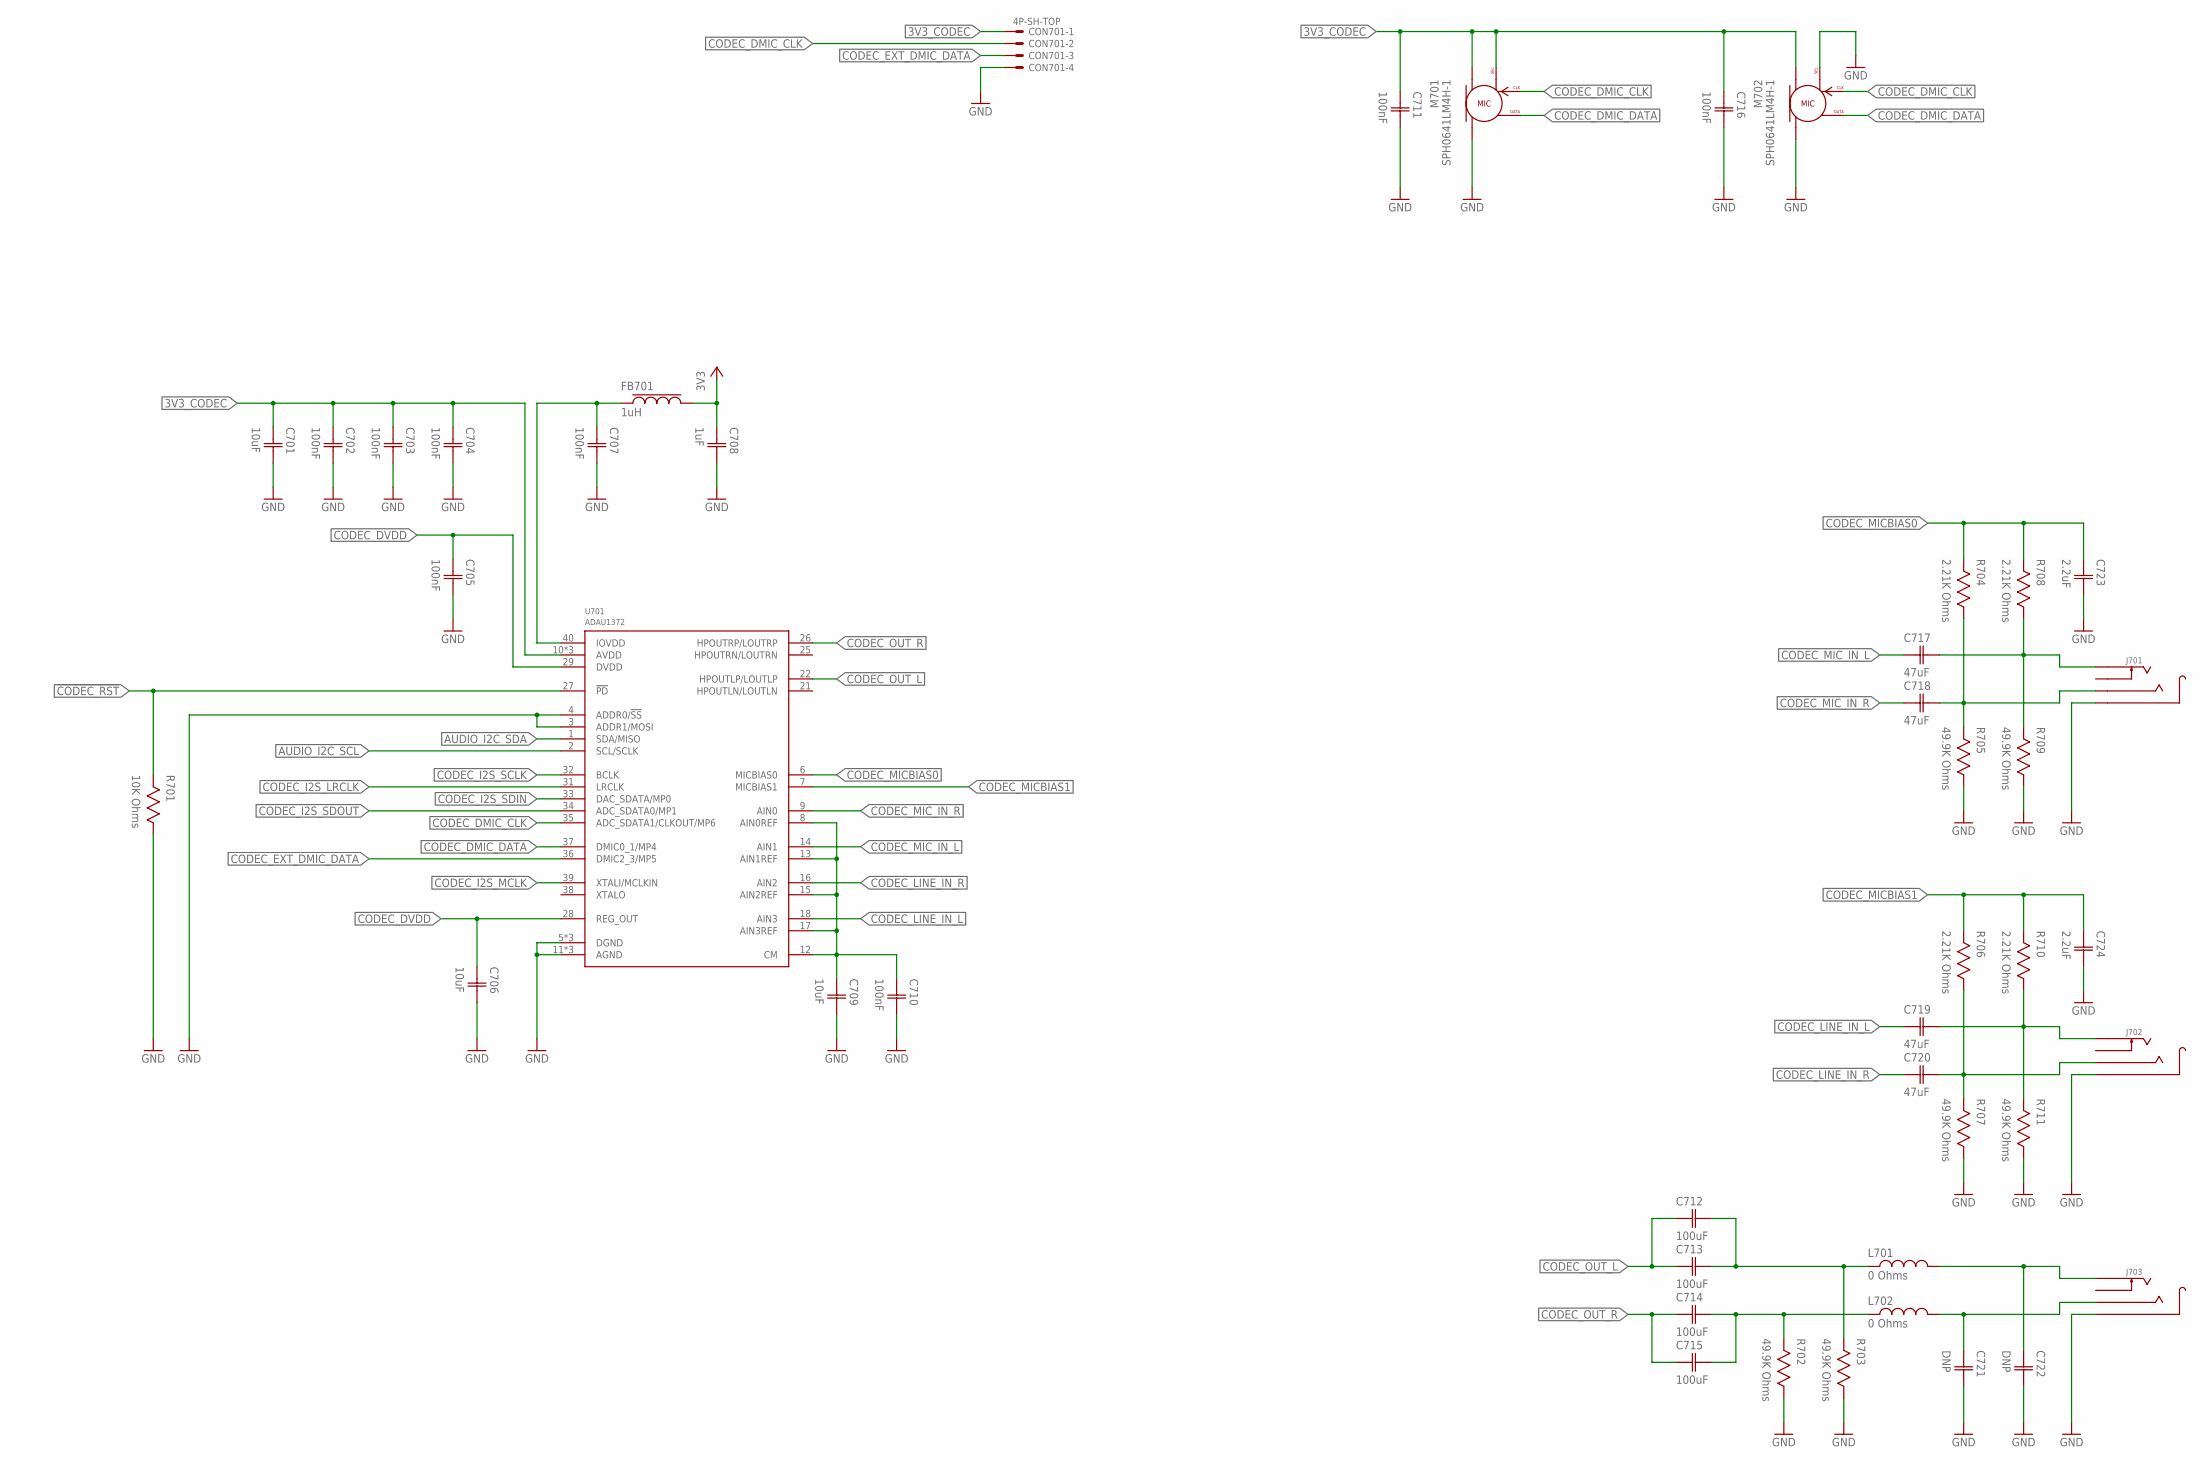
[picture p35: schematic icyradio-main.sch, sheet 7, Audio CODEC]

Parts:
C701, C706, C709: 10uF; CAP0402
C702, C703, C704, C705, C707, C710, C711, C716: 100nF; CAP0402
C708: 1uF; CAP0402
C712, C713, C714, C715: 100uF; CAP0805
C717, C718, C719, C720: 47uF; CAP0603
C721, C722: DNP; CAP0402
C723, C724: 2.2uF; CAP0402
CON701: 4P-SH-TOP; SH-04-TOP
FB701: 1uH; IND0603
J701, J702, J703: TRSJACK; 3.5TRSJACK
L701, L702: 0 Ohms; IND0603
M701, M702: SPH0641LM4H-1
R701: 10K Ohms; RES0402
R702, R703, R705, R707, R709, R711: 49.9K Ohms; RES0402
R704, R706, R708, R710: 2.21K Ohms; RES0402
U701: ADAU1372; QFN40

Connections:
3V3: C708.1 (C1), FB701.2; also elsewhere on the board
3V3_CODEC: C701.1 (C1), C702.1 (C1), C703.1 (C1), C704.1 (C1), C711.1 (C1), C716.1 (C1), CON701.1, M701.2 (SEL), M701.5 (VCC), M702.5 (VCC), U701.10 (AVDD), U701.19 (AVDD), U701.24 (AVDD); also elsewhere on the board
3V3_CODEC_DIG: C707.1 (C1), FB701.1, U701.40 (IOVDD)
!CODEC_RST: R701.2, U701.27 (!PD); also elsewhere on the board
AUDIO_I2C_SCL: U701.2 (SCL/SCLK); also elsewhere on the board
AUDIO_I2C_SDA: U701.1 (SDA/MISO); also elsewhere on the board
CODEC_CM: C709.1 (C1), C710.1 (C1), U701.8 (AIN0REF), U701.12 (CM), U701.13 (AIN1REF), U701.15 (AIN2REF), U701.17 (AIN3REF)
CODEC_DMIC_CLK: CON701.2, M701.4 (CLK), M702.4 (CLK), U701.35 (ADC_SDATA1/CLKOUT/MP6)
CODEC_DMIC_DATA: M701.1 (DAT), M702.1 (DAT), U701.37 (DMIC0_1/MP4)
CODEC_DVDD: C705.1 (C1), C706.1 (C1), U701.28 (REG_OUT), U701.29 (DVDD)
CODEC_EXT_DMIC_DATA: CON701.3, U701.36 (DMIC2_3/MP5)
CODEC_I2S_LRCLK: U701.31 (LRCLK); also elsewhere on the board
CODEC_I2S_MCLK: U701.39 (XTALI/MCLKIN); also elsewhere on the board
CODEC_I2S_SCLK: U701.32 (BCLK); also elsewhere on the board
CODEC_I2S_SDIN: U701.33 (DAC_SDATA/MP0); also elsewhere on the board
CODEC_I2S_SDOUT: U701.34 (ADC_SDATA0/MP1); also elsewhere on the board
CODEC_LINE_IN_L: C719.1 (C1), U701.18 (AIN3)
CODEC_LINE_IN_R: C720.1 (C1), U701.16 (AIN2)
CODEC_MICBIAS0: C723.1 (C1), R704.2, R708.2, U701.6 (MICBIAS0)
CODEC_MICBIAS1: C724.1 (C1), R706.2, R710.2, U701.7 (MICBIAS1)
CODEC_MIC_IN_L: C717.1 (C1), U701.14 (AIN1)
CODEC_MIC_IN_R: C718.1 (C1), U701.9 (AIN0)
CODEC_OUT_L: C712.1 (C1), C713.1 (C1), U701.22 (HPOUTLP/LOUTLP)
CODEC_OUT_R: C714.1 (C1), C715.1 (C1), U701.26 (HPOUTRP/LOUTRP)
GND: C701.2 (C2), C702.2 (C2), C703.2 (C2), C704.2 (C2), C705.2 (C2), C706.2 (C2), C707.2 (C2), C708.2 (C2), C709.2 (C2), C710.2 (C2), C711.2 (C2), C716.2 (C2), C721.2 (C2), C722.2 (C2), C723.2 (C2), C724.2 (C2), CON701.4, J701.1 (S), J702.1 (S), J703.1 (S), M701.3 (GND), M702.2 (SEL), M702.3 (GND), R701.1, R702.1, R703.1, R705.1, R707.1, R709.1, R711.1, U701.3 (ADDR1/MOSI), U701.4 (ADDR0/!SS), U701.5 (DGND), U701.11 (AGND), U701.20 (AGND), U701.23 (AGND), U701.30 (DGND), U701.41 (DGND); also elsewhere on the board
unnamed: C720.2 (C2), J702.3 (R), R706.1, R707.2
unnamed: C719.2 (C2), J702.2 (T), R710.1, R711.2
unnamed: C718.2 (C2), J701.3 (R), R704.1, R705.2
unnamed: C717.2 (C2), J701.2 (T), R708.1, R709.2
unnamed: C714.2 (C2), C715.2 (C2), L702.1, R702.2
unnamed: C712.2 (C2), C713.2 (C2), L701.1, R703.2
unnamed: C721.1 (C1), J703.3 (R), L702.2
unnamed: C722.1 (C1), J703.2 (T), L701.2

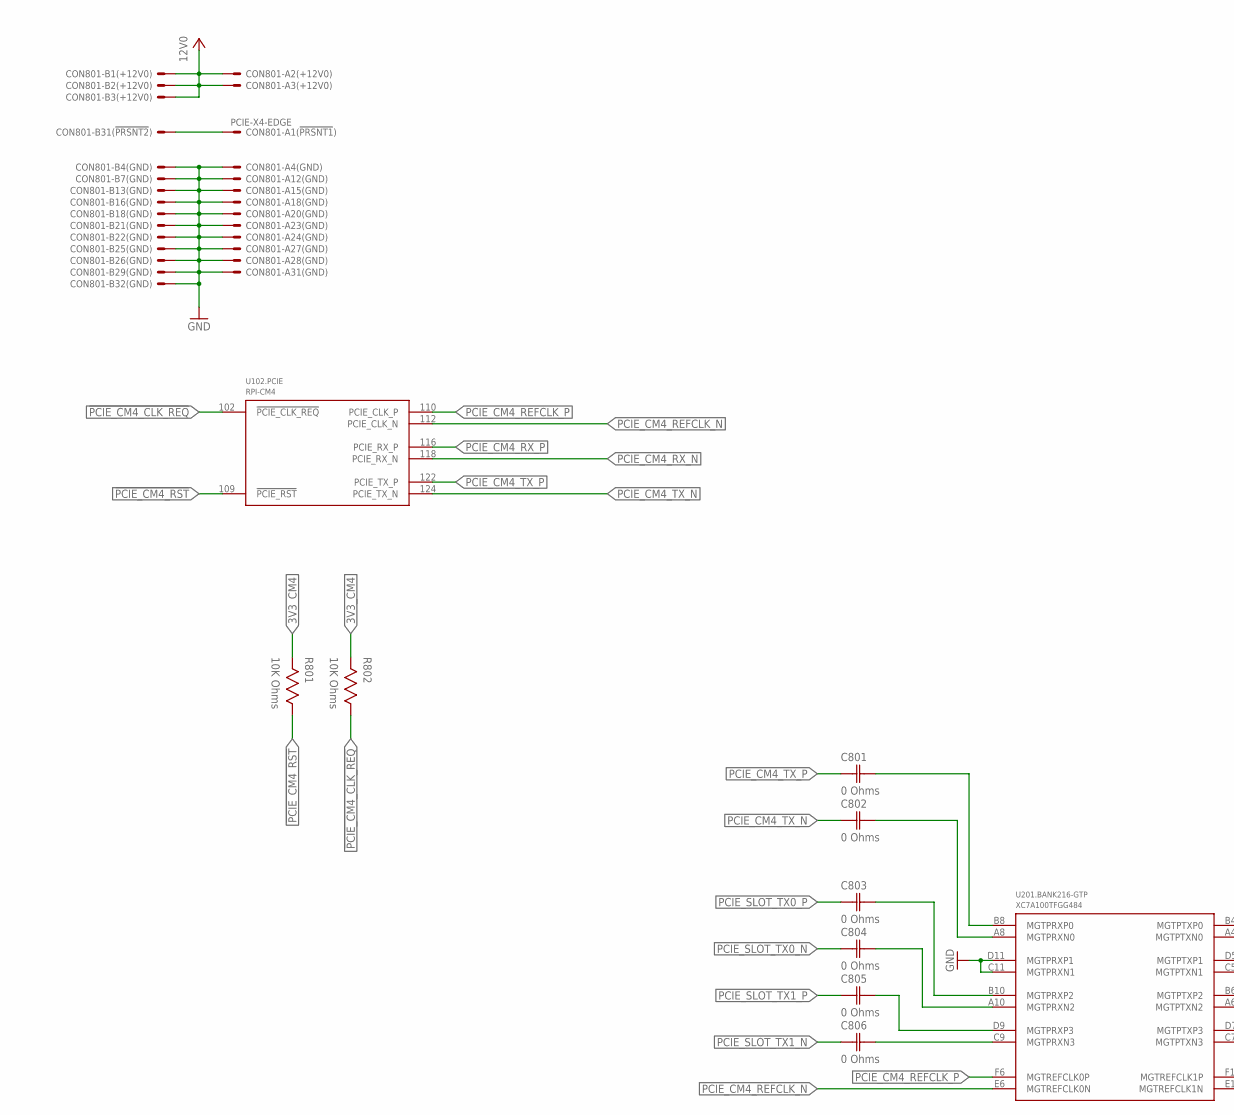
[picture p36: schematic icyradio-main.sch, sheet 8, PCI Express, part in row 1, column 1]

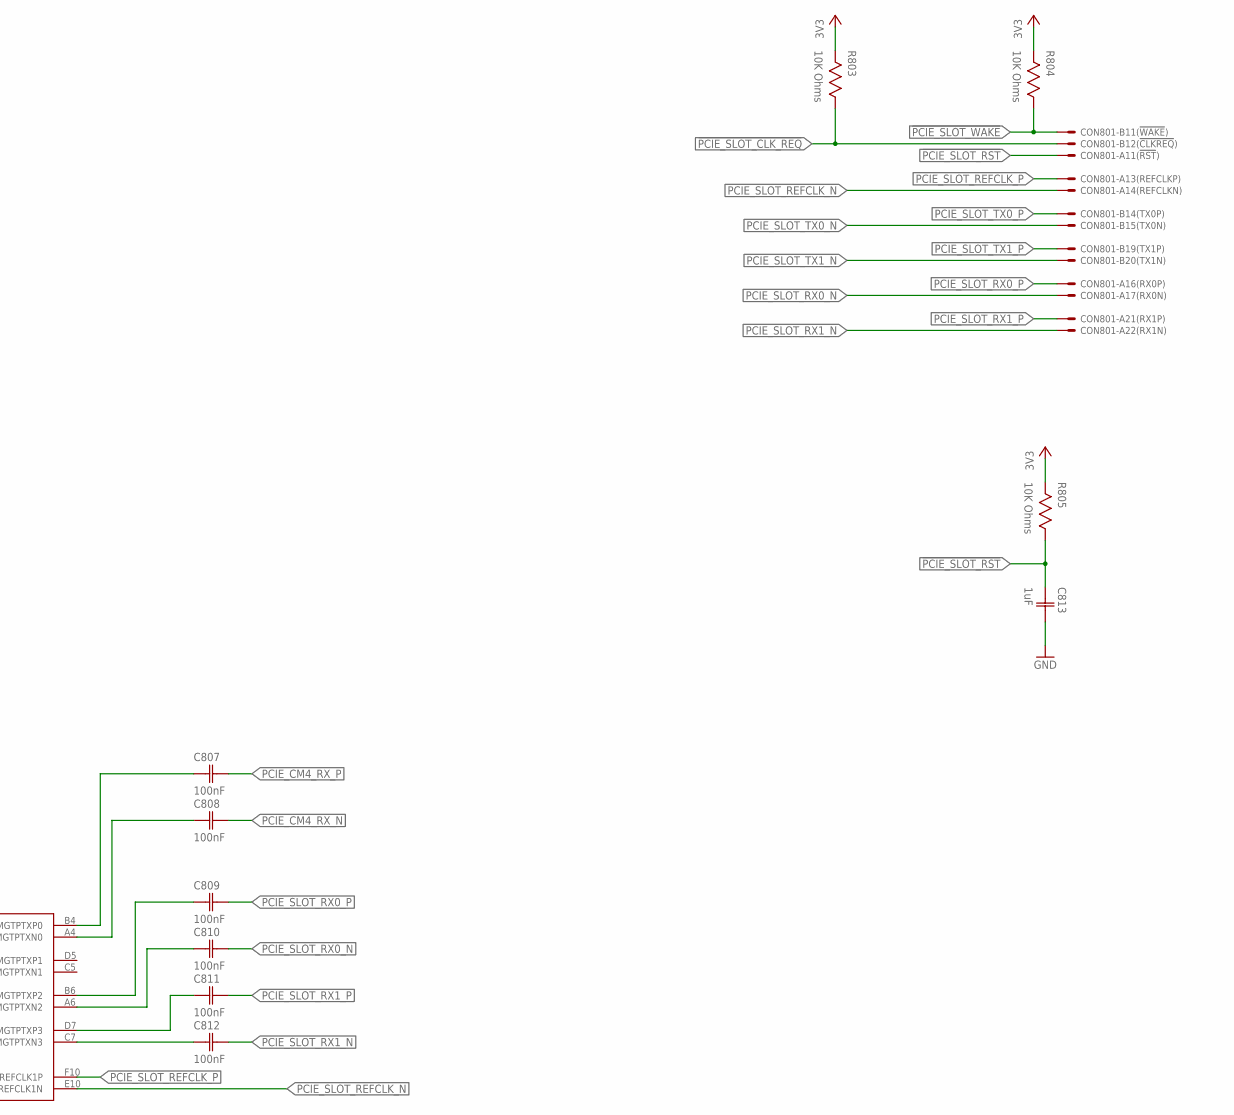
[picture p37: schematic icyradio-main.sch, sheet 8, PCI Express, part in row 1, column 2]

Parts:
C801, C802, C803, C804, C805, C806: 0 Ohms; CAP0402
C807, C808, C809, C810, C811, C812: 100nF; CAP0402
C813: 1uF; CAP0402
CON801: PCIE-X4-EDGE
R801, R802, R803, R804, R805: 10K Ohms; RES0402
U102: RPI-CM4
U201: XC7A100TFGG484; FGG484

Connections:
3V3: R803.2, R804.2, R805.2; also elsewhere on the board
3V3_CM4: R801.2, R802.2; also elsewhere on the board
12V0: CON801.A2, CON801.A3, CON801.B1, CON801.B2, CON801.B3; also elsewhere on the board
!PCIE_CM4_CLK_REQ: R802.1, U102.102 (!PCIE_CLK_REQ); also elsewhere on the board
!PCIE_CM4_RST: R801.1, U102.109 (!PCIE_RST); also elsewhere on the board
!PCIE_SLOT_CLK_REQ: CON801.B12, R803.1; also elsewhere on the board
!PCIE_SLOT_PRSNT: CON801.A1, CON801.B31
!PCIE_SLOT_RST: C813.1 (C1), CON801.A11, R805.1; also elsewhere on the board
!PCIE_SLOT_WAKE: CON801.B11, R804.1; also elsewhere on the board
GND: C813.2 (C2), CON801.A4, CON801.A12, CON801.A15, CON801.A18, CON801.A20, CON801.A23, CON801.A24, CON801.A27, CON801.A28, CON801.A31, CON801.B4, CON801.B7, CON801.B13, CON801.B16, CON801.B18, CON801.B21, CON801.B22, CON801.B25, CON801.B26, CON801.B29, CON801.B32, U201.C11 (MGTPRXN1), U201.D11 (MGTPRXP1); also elsewhere on the board
PCIE_CM4_REFCLK_N: U102.112 (PCIE_CLK_N), U201.E6 (MGTREFCLK0N)
PCIE_CM4_REFCLK_P: U102.110 (PCIE_CLK_P), U201.F6 (MGTREFCLK0P)
PCIE_CM4_RX_ACC_N: C808.1 (C1), U201.A4 (MGTPTXN0)
PCIE_CM4_RX_ACC_P: C807.1 (C1), U201.B4 (MGTPTXP0)
PCIE_CM4_RX_N: C808.2 (C2), U102.118 (PCIE_RX_N)
PCIE_CM4_RX_P: C807.2 (C2), U102.116 (PCIE_RX_P)
PCIE_CM4_TX_ACC_N: C802.2 (C2), U201.A8 (MGTPRXN0)
PCIE_CM4_TX_ACC_P: C801.2 (C2), U201.B8 (MGTPRXP0)
PCIE_CM4_TX_N: C802.1 (C1), U102.124 (PCIE_TX_N)
PCIE_CM4_TX_P: C801.1 (C1), U102.122 (PCIE_TX_P)
PCIE_SLOT_REFCLK_N: CON801.A14, U201.E10 (MGTREFCLK1N)
PCIE_SLOT_REFCLK_P: CON801.A13, U201.F10 (MGTREFCLK1P)
PCIE_SLOT_RX0_ACC_N: C810.1 (C1), U201.A6 (MGTPTXN2)
PCIE_SLOT_RX0_ACC_P: C809.1 (C1), U201.B6 (MGTPTXP2)
PCIE_SLOT_RX0_N: C810.2 (C2), CON801.A17
PCIE_SLOT_RX0_P: C809.2 (C2), CON801.A16
PCIE_SLOT_RX1_ACC_N: C812.1 (C1), U201.C7 (MGTPTXN3)
PCIE_SLOT_RX1_ACC_P: C811.1 (C1), U201.D7 (MGTPTXP3)
PCIE_SLOT_RX1_N: C812.2 (C2), CON801.A22
PCIE_SLOT_RX1_P: C811.2 (C2), CON801.A21
PCIE_SLOT_TX0_ACC_N: C804.2 (C2), U201.A10 (MGTPRXN2)
PCIE_SLOT_TX0_ACC_P: C803.2 (C2), U201.B10 (MGTPRXP2)
PCIE_SLOT_TX0_N: C804.1 (C1), CON801.B15
PCIE_SLOT_TX0_P: C803.1 (C1), CON801.B14
PCIE_SLOT_TX1_ACC_N: C806.2 (C2), U201.C9 (MGTPRXN3)
PCIE_SLOT_TX1_ACC_P: C805.2 (C2), U201.D9 (MGTPRXP3)
PCIE_SLOT_TX1_N: C806.1 (C1), CON801.B20
PCIE_SLOT_TX1_P: C805.1 (C1), CON801.B19

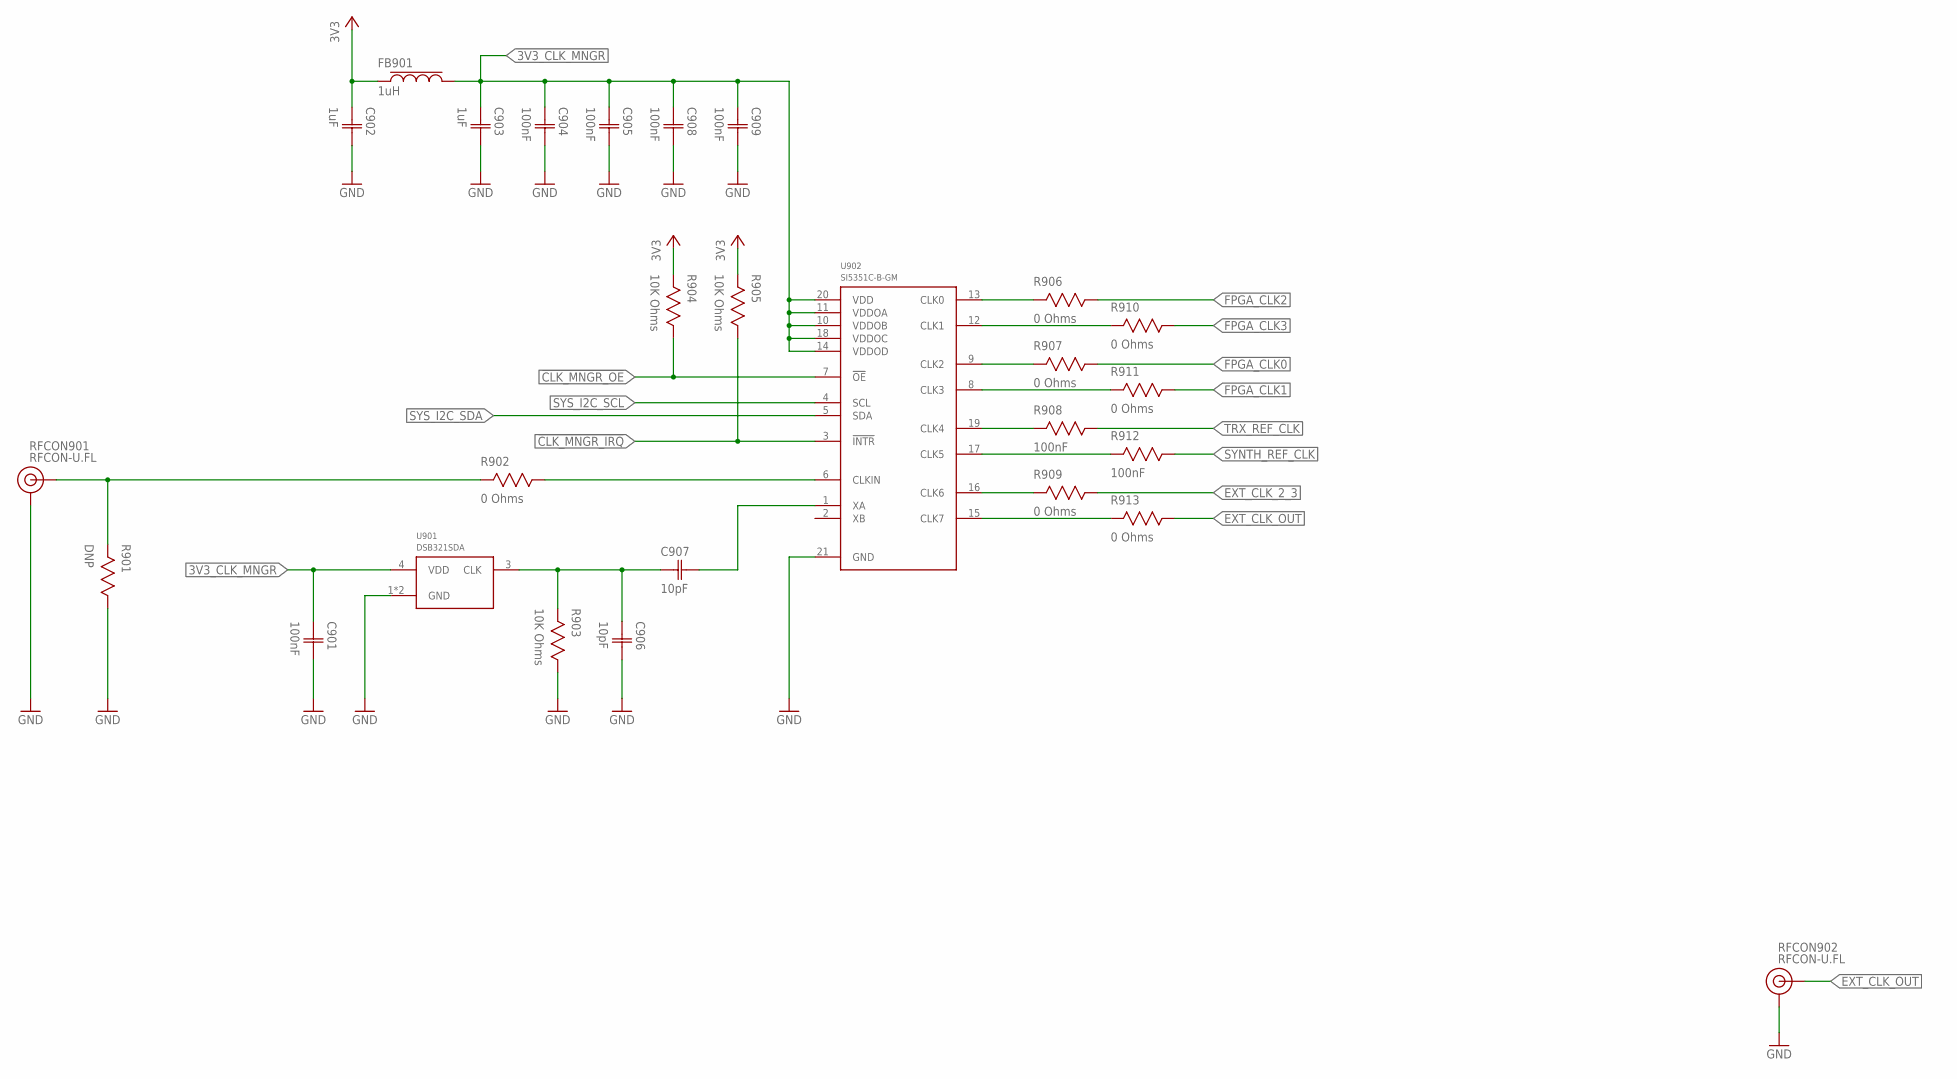
[picture p38: schematic icyradio-main.sch, sheet 9, Clock generator]

Parts:
C901, C904, C905, C908, C909: 100nF; CAP0402
C902, C903: 1uF; CAP0402
C906, C907: 10pF; CAP0402
FB901: 1uH; IND0603
R901: DNP; RES0402
R902, R906, R907, R909, R910, R911, R913: 0 Ohms; RES0402
R903, R904, R905: 10K Ohms; RES0402
R908, R912: 100nF; RES0402
RFCON901, RFCON902: RFCON-U.FL; U.FL
U901: DSB321SDA; TCXO-3225
U902: SI5351C-B-GM; QFN20

Connections:
3V3: C902.1 (C1), FB901.1, R904.2, R905.2; also elsewhere on the board
3V3_CLK_MNGR: C901.1 (C1), C903.1 (C1), C904.1 (C1), C905.1 (C1), C908.1 (C1), C909.1 (C1), FB901.2, U901.4 (VDD), U902.10 (VDDOB), U902.11 (VDDOA), U902.14 (VDDOD), U902.18 (VDDOC), U902.20 (VDD)
!CLK_MNGR_IRQ: R905.1, U902.3 (!INTR); also elsewhere on the board
!CLK_MNGR_OE: R904.1, U902.7 (!OE); also elsewhere on the board
CLK_MNGR_CLK0: R906.2, U902.13 (CLK0)
CLK_MNGR_CLK1: R910.2, U902.12 (CLK1)
CLK_MNGR_CLK2: R907.2, U902.9 (CLK2)
CLK_MNGR_CLK3: R911.2, U902.8 (CLK3)
CLK_MNGR_CLK4: R908.2, U902.19 (CLK4)
CLK_MNGR_CLK5: R912.2, U902.17 (CLK5)
CLK_MNGR_CLK6: R909.2, U902.16 (CLK6)
CLK_MNGR_CLK7: R913.2, U902.15 (CLK7)
CLK_MNGR_CLKIN: R902.1, U902.6 (CLKIN)
CLK_MNGR_EXT_REF: R901.2, R902.2, RFCON901.P$3 (SIGNAL)
CLK_MNGR_REF_ACC: C907.2 (C2), U902.1 (XA)
CLK_MNGR_REF_DCC: C906.1 (C1), C907.1 (C1), R903.2, U901.3 (CLK)
EXT_CLK_2_3: R909.1; also elsewhere on the board
EXT_CLK_OUT: R913.1, RFCON902.P$3 (SIGNAL)
FPGA_CLK0: R907.1; also elsewhere on the board
FPGA_CLK1: R911.1; also elsewhere on the board
FPGA_CLK2: R906.1; also elsewhere on the board
FPGA_CLK3: R910.1; also elsewhere on the board
GND: C901.2 (C2), C902.2 (C2), C903.2 (C2), C904.2 (C2), C905.2 (C2), C906.2 (C2), C908.2 (C2), C909.2 (C2), R901.1, R903.1, RFCON901.P$1 (GND), RFCON901.P$2 (GND), RFCON902.P$1 (GND), RFCON902.P$2 (GND), U901.1 (GND), U901.2 (GND), U902.21 (GND); also elsewhere on the board
SYNTH_REF_CLK: R912.1; also elsewhere on the board
SYS_I2C_SCL: U902.4 (SCL); also elsewhere on the board
SYS_I2C_SDA: U902.5 (SDA); also elsewhere on the board
TRX_REF_CLK: R908.1; also elsewhere on the board

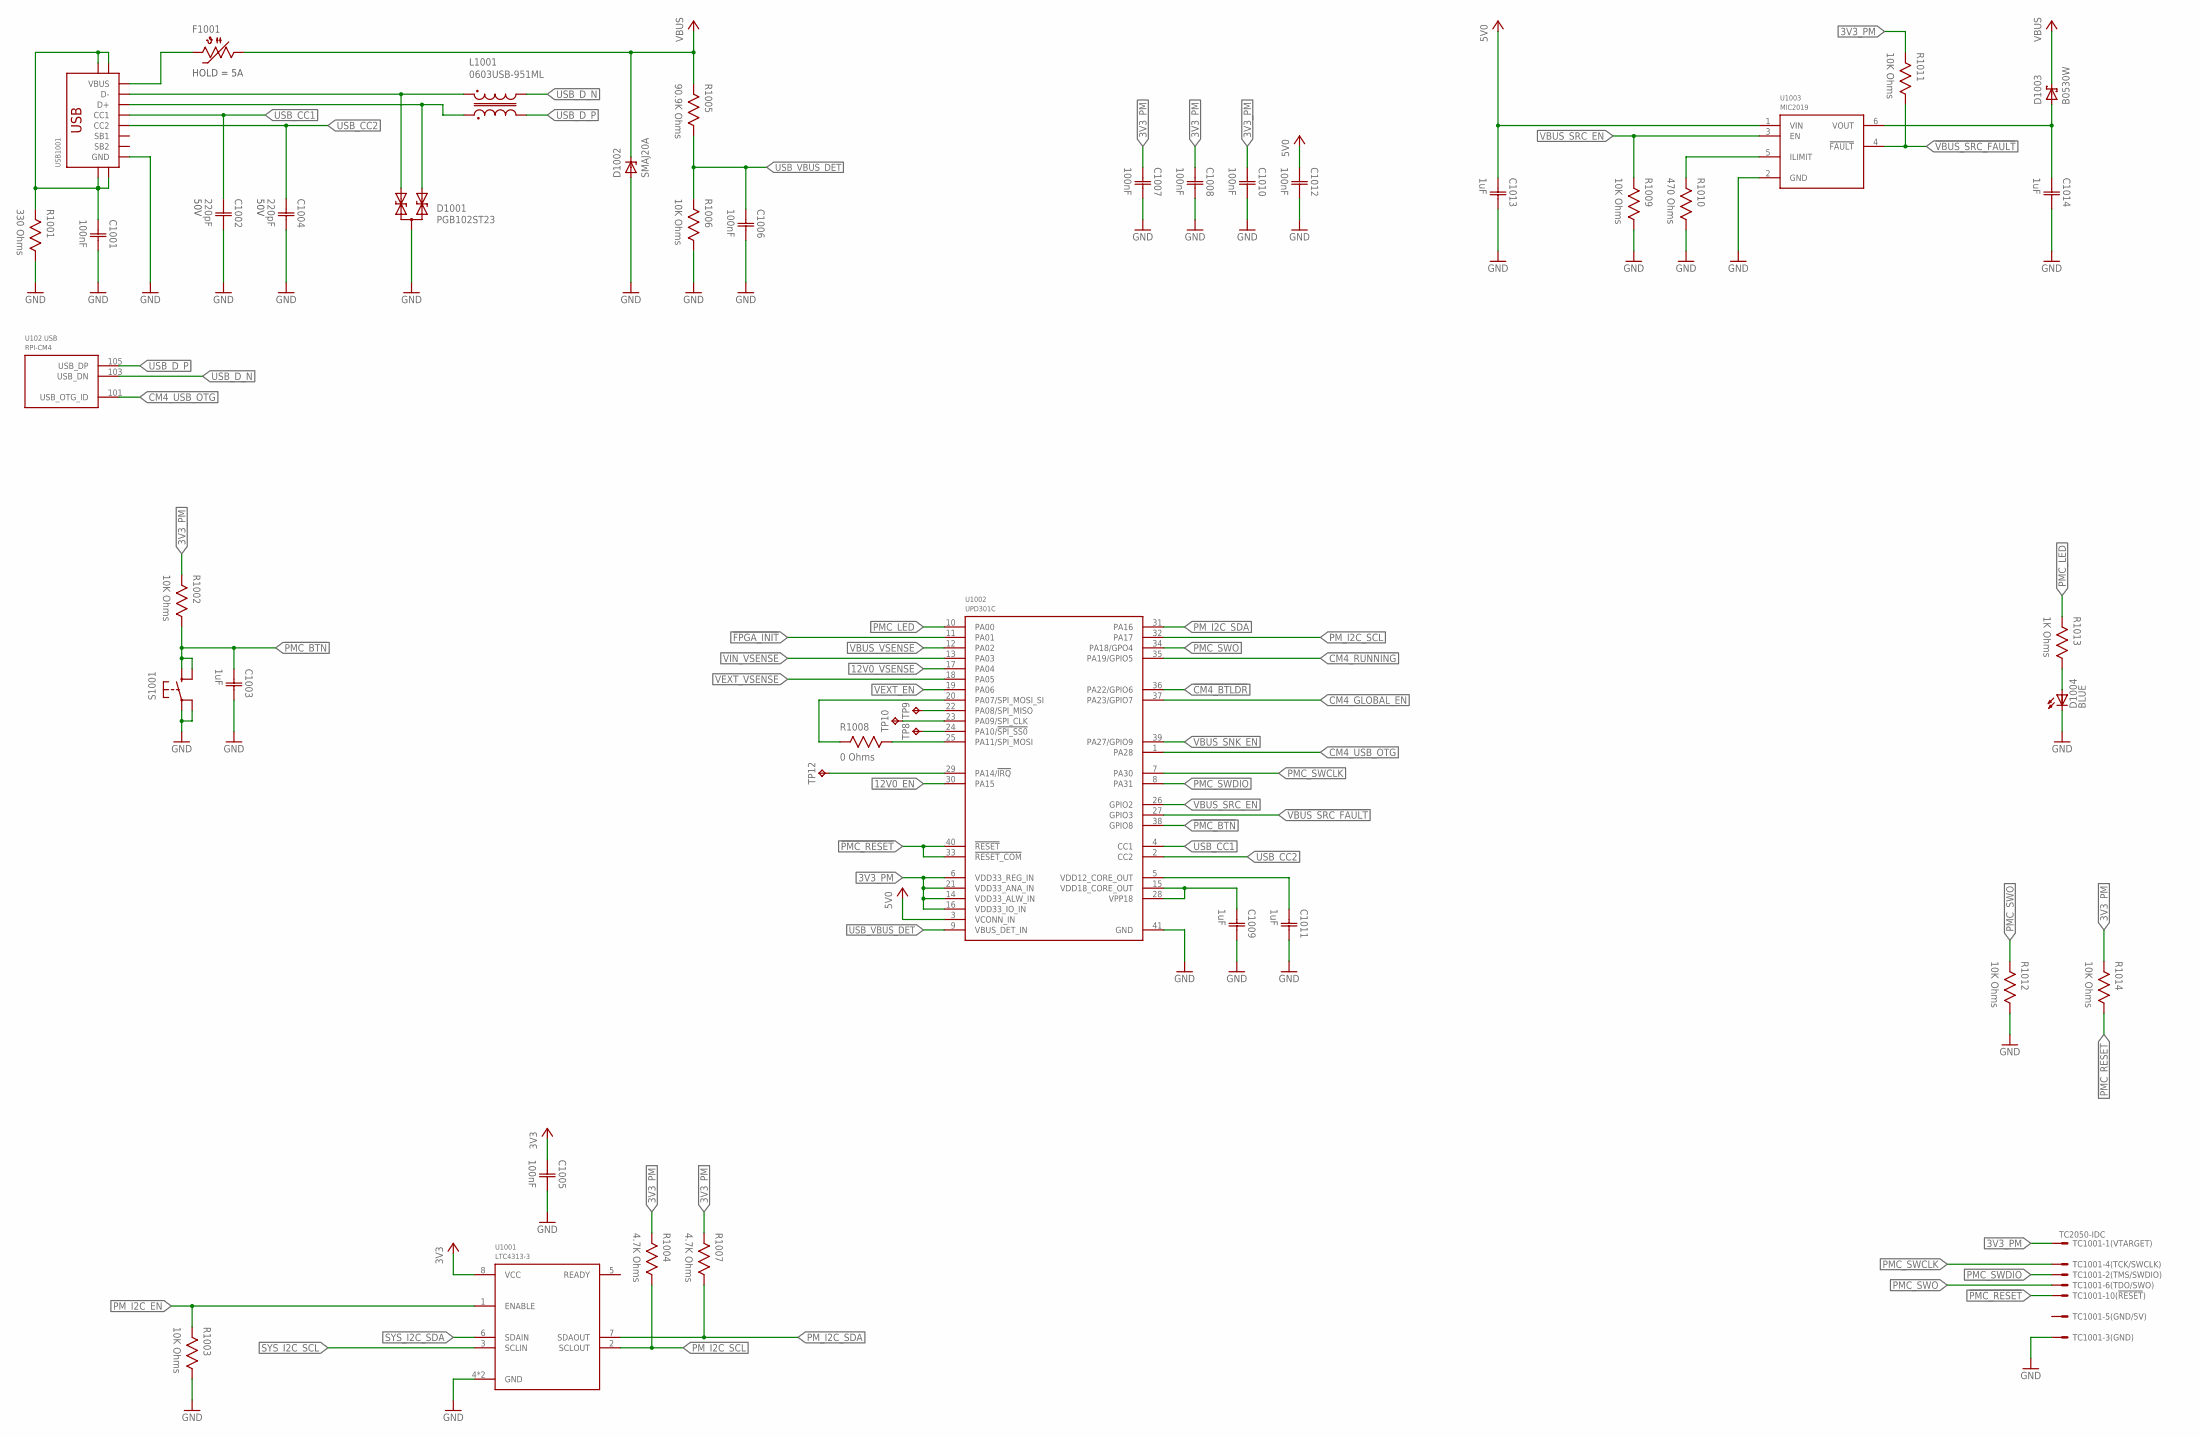
[picture p39: schematic icyradio-main.sch, sheet 10, Power Management]

Parts:
C1001, C1005, C1006, C1007, C1008, C1010, C1012: 100nF; CAP0402
C1002, C1004: 220pF; CAP0402; VOLTAGE 50V
C1003, C1009, C1011, C1013, C1014: 1uF; CAP0402
D1001: PGB102ST23; SOT23
D1002: SMAJ20A; DO214AC
D1003: B0530W; SOD-123
D1004: LED0603; 0603
F1001: PTC1206; 1206
L1001: 0603USB-951ML; 0603USB
R1001: 330 Ohms; RES0402
R1002, R1003, R1006, R1009, R1011, R1012, R1014: 10K Ohms; RES0402
R1004, R1007: 4.7K Ohms; RES0402
R1005: 90.9K Ohms; RES0402
R1008: 0 Ohms; RES0402
R1010: 470 Ohms; RES0402
R1013: 1K Ohms; RES0402
S1001: TAC_SWITCHSMD_4.5X4.5; TAC_SW_SMD_4.5X4.5
TC1001: TC2050-IDC
TP8, TP9, TP10, TP12: TESTPOINT-0.7MM; PAD0.7MM
U102: RPI-CM4
U1001: LTC4313-3; DFN8
U1002: UPD301C; VQFN40
U1003: MIC2019; SOT23-6
USB1001: USB-C-16P-SMD-FLAT-SIDE-TYPE-2

Connections:
3V3: C1005.1 (C1), U1001.8 (VCC); also elsewhere on the board
3V3_PM: C1007.1 (C1), C1008.1 (C1), C1010.1 (C1), R1002.2, R1004.2, R1007.2, R1011.2, R1014.2, TC1001.1, U1002.6 (VDD33_REG_IN), U1002.14 (VDD33_ALW_IN), U1002.16 (VDD33_IO_IN), U1002.21 (VDD33_ANA_IN); also elsewhere on the board
5V0: C1012.1 (C1), C1013.1 (C1), U1002.3 (VCONN_IN), U1003.1 (VIN); also elsewhere on the board
12V0_EN: U1002.30 (PA15); also elsewhere on the board
12V0_VSENSE: U1002.17 (PA04); also elsewhere on the board
!CM4_BTLDR: U1002.36 (PA22/GPIO6); also elsewhere on the board
!FPGA_INIT: U1002.11 (PA01); also elsewhere on the board
!PMC_BTN: C1003.1 (C1), R1002.1, S1001.3, S1001.4, U1002.38 (GPIO8)
!PMC_RESET: R1014.1, TC1001.10, U1002.33 (!RESET_COM), U1002.40 (!RESET)
!PM_SPI_CS: TP8.TP, U1002.24 (PA10/!SPI_SS0!)
!PM_SPI_IRQ: TP12.TP, U1002.29 (PA14/!IRQ!)
!VBUS_SRC_FAULT: R1011.1, U1002.27 (GPIO3), U1003.4 (!FAULT)
CM4_GLOBAL_EN: U1002.37 (PA23/GPIO7); also elsewhere on the board
CM4_RUNNING: U1002.35 (PA19/GPIO5); also elsewhere on the board
CM4_USB_OTG: U102.101 (USB_OTG_ID), U1002.1 (PA28)
GND: C1001.2 (C2), C1002.2 (C2), C1003.2 (C2), C1004.2 (C2), C1005.2 (C2), C1006.2 (C2), C1007.2 (C2), C1008.2 (C2), C1009.2 (C2), C1010.2 (C2), C1011.2 (C2), C1012.2 (C2), C1013.2 (C2), C1014.2 (C2), D1001.3 (A), D1002.A, D1004.C, R1001.1, R1003.1, R1006.1, R1009.1, R1010.1, R1012.1, S1001.1, S1001.2, TC1001.3, U1001.4 (GND), U1001.9 (GND), U1002.41 (GND), U1003.2 (GND), USB1001.A1/B12 (GND), USB1001.B1/A12 (GND); also elsewhere on the board
unnamed: C1001.1 (C1), R1001.2, USB1001.SHIELD@0 (SHIELD), USB1001.SHIELD@1 (SHIELD), USB1001.SHIELD@2 (SHIELD), USB1001.SHIELD@3 (SHIELD)
unnamed: D1004.A, R1013.1
unnamed: C1009.1 (C1), U1002.15 (VDD18_CORE_OUT), U1002.28 (VPP18)
unnamed: C1011.1 (C1), U1002.5 (VDD12_CORE_OUT)
unnamed: C1014.1 (C1), D1003.A, U1003.6 (VOUT)
unnamed: R1010.2, U1003.5 (ILIMIT)
PMC_LED: R1013.2, U1002.10 (PA00)
PMC_SWCLK: TC1001.4, U1002.7 (PA30)
PMC_SWDIO: TC1001.2, U1002.8 (PA31)
PMC_SWO: R1012.2, TC1001.6, U1002.34 (PA18/GPO4)
PM_I2C_EN: R1003.2, U1001.1 (ENABLE); also elsewhere on the board
PM_I2C_SCL: R1004.1, U1001.2 (SCLOUT), U1002.32 (PA17); also elsewhere on the board
PM_I2C_SDA: R1007.1, U1001.7 (SDAOUT), U1002.31 (PA16); also elsewhere on the board
PM_SPI_CLK: TP10.TP, U1002.23 (PA09/SPI_CLK)
PM_SPI_MISO: TP9.TP, U1002.22 (PA08/SPI_MISO)
PM_SPI_MOSI: R1008.1, U1002.25 (PA11/SPI_MOSI)
PM_SPI_MOSI_SI: R1008.2, U1002.20 (PA07/SPI_MOSI_SI)
SYS_I2C_SCL: U1001.3 (SCLIN); also elsewhere on the board
SYS_I2C_SDA: U1001.6 (SDAIN); also elsewhere on the board
USB_CC1: C1002.1 (C1), U1002.4 (CC1), USB1001.A5 (CC1)
USB_CC2: C1004.1 (C1), U1002.2 (CC2), USB1001.B5 (CC2)
USB_D_N: L1001.2, U102.103 (USB_DN)
USB_D_P: L1001.3, U102.105 (USB_DP)
USB_D_UNFILT_N: D1001.1 (C1), L1001.1, USB1001.A7 (D-), USB1001.B7 (D-)
USB_D_UNFILT_P: D1001.2 (C2), L1001.4, USB1001.A6 (D+), USB1001.B6 (D+)
USB_VBUS_DET: C1006.1 (C1), R1005.1, R1006.2, U1002.9 (VBUS_DET_IN)
VBUS: D1002.C, D1003.C, F1001.1, R1005.2; also elsewhere on the board
VBUS_SNK_EN: U1002.39 (PA27/GPIO9); also elsewhere on the board
VBUS_SRC_EN: R1009.2, U1002.26 (GPIO2), U1003.3 (EN)
VBUS_UNFUSED: F1001.2, USB1001.A4/B9 (VBUS), USB1001.B4/A9 (VBUS)
VBUS_VSENSE: U1002.12 (PA02); also elsewhere on the board
VEXT_EN: U1002.19 (PA06); also elsewhere on the board
VEXT_VSENSE: U1002.18 (PA05); also elsewhere on the board
VIN_VSENSE: U1002.13 (PA03); also elsewhere on the board
