vankxr/icyradio/pcb/main/icyradio-main.brd

## EAGLE design pcb/main/icyradio-main.brd (continued)

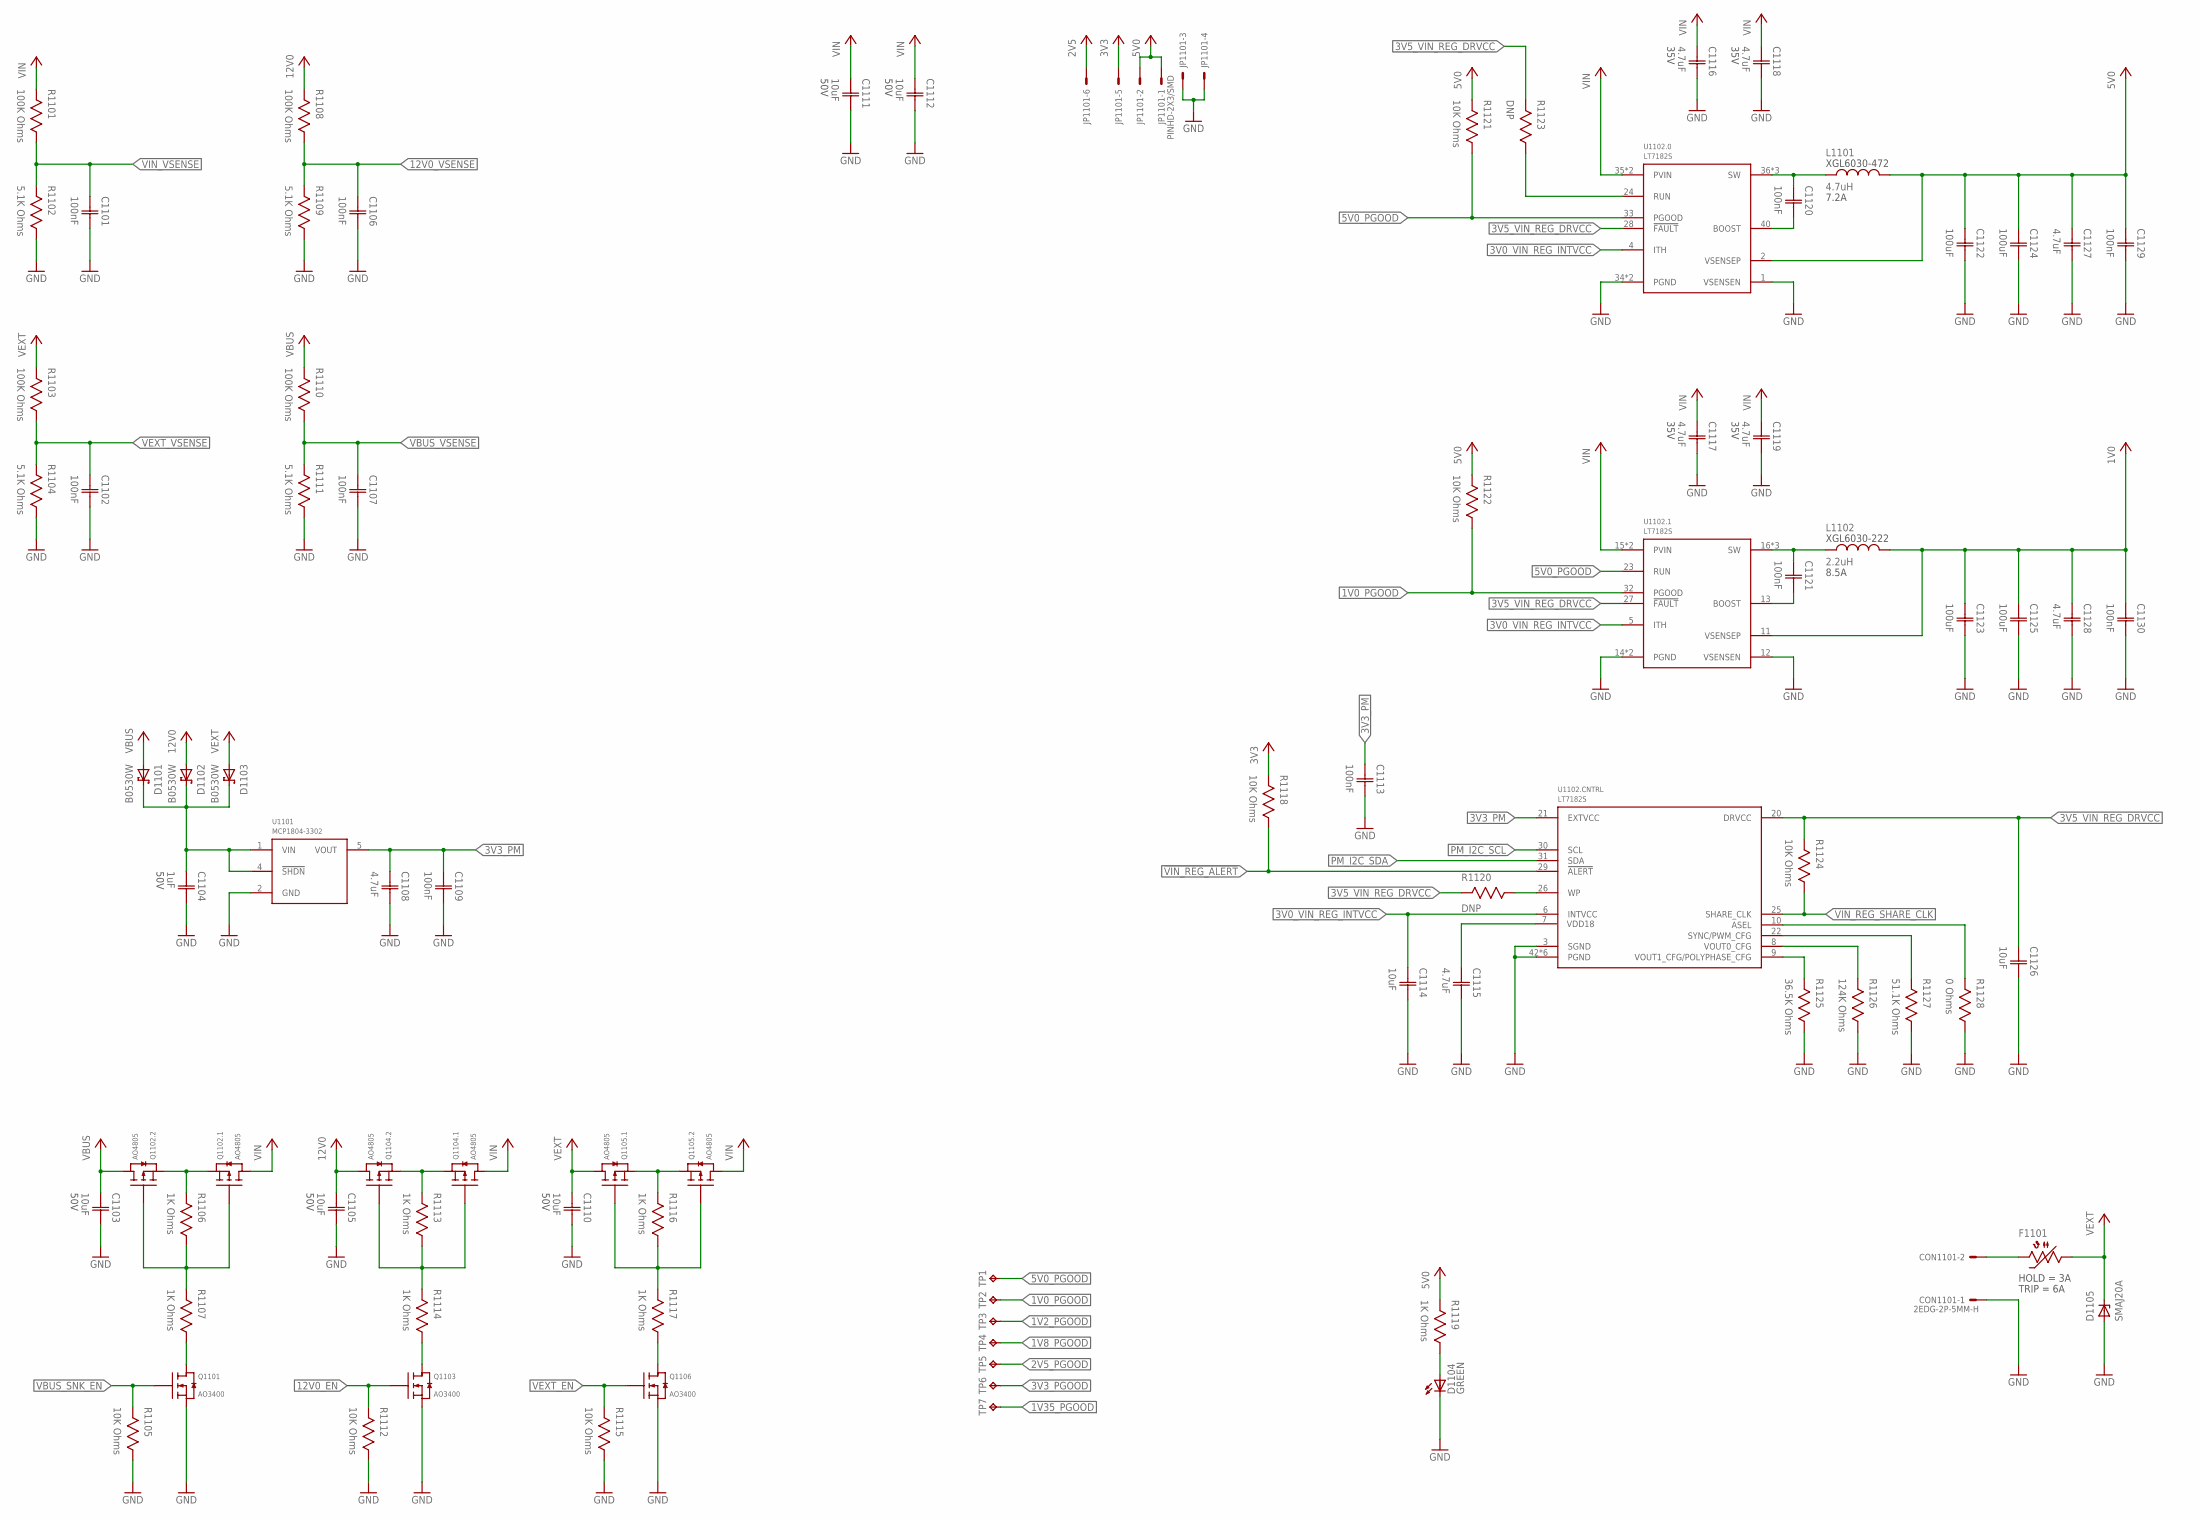
[picture p40: schematic icyradio-main.sch, sheet 11, Power]

Parts:
C1101, C1102, C1106, C1107, C1109, C1113, C1120, C1121, C1129, C1130: 100nF; CAP0402
C1103, C1105, C1110, C1111, C1112: 10uF; CAP1206; VOLTAGE 50V
C1104: 1uF; CAP0603; VOLTAGE 50V
C1108, C1115, C1128: 4.7uF; CAP0402
C1114, C1126: 10uF; CAP0402
C1116, C1117, C1118, C1119: 4.7uF; CAP0603; VOLTAGE 35V
C1122, C1123, C1124, C1125: 100uF; CAP1206
C1127: 4.7uF; CAP0603
CON1101: 2EDG-2P-5MM-H
D1101, D1102, D1103: B0530W; SOD-123
D1104: LED0603; 0603
D1105: SMAJ20A; DO214AC
F1101: 2.6A Hold; 1206
JP1101: PINHD-2X3/SMD; 2X03/SMD
L1101: 4.7uH; XGL6030
L1102: 2.2uH; XGL6030
Q1101, Q1103, Q1106: AO3400; SOT23
Q1102, Q1104, Q1105: AO4805; SOIC8
R1101, R1103, R1108, R1110: 100K Ohms; RES0402
R1102, R1104, R1109, R1111: 5.1K Ohms; RES0402
R1105, R1112, R1115, R1118, R1121, R1122, R1124: 10K Ohms; RES0402
R1106, R1107, R1113, R1114, R1116, R1117, R1119: 1K Ohms; RES0402
R1120, R1123: DNP; RES0402
R1125: 36.5K Ohms; RES0402
R1126: 124K Ohms; RES0402
R1127: 51.1K Ohms; RES0402
R1128: 0 Ohms; RES0402
TP1, TP2, TP3, TP4, TP5, TP6, TP7: TESTPOINT-0.7MM; PAD0.7MM
U1101: MCP1804-3302; SOT23-5
U1102: LT7182S; LQFN40_ASYM_CORNER

Connections:
1V0: C1123.1 (C1), C1125.1 (C1), C1128.1 (C1), C1130.1 (C1), L1102.2, U1102.11 (VSENSEP); also elsewhere on the board
1V0_BOOST: C1121.2 (C2), U1102.13 (BOOST)
1V0_PGOOD: R1122.1, TP2.TP, U1102.32 (PGOOD); also elsewhere on the board
1V0_SW: C1121.1 (C1), L1102.1, U1102.16 (SW), U1102.17 (SW), U1102.44 (SW)
1V2_PGOOD: TP3.TP; also elsewhere on the board
1V8_PGOOD: TP4.TP; also elsewhere on the board
1V8_VIN_REG_VDD: C1115.1 (C1), U1102.7 (VDD18)
1V35_PGOOD: TP7.TP; also elsewhere on the board
2V5: JP1101.6; also elsewhere on the board
2V5_PGOOD: TP5.TP; also elsewhere on the board
3V0_VIN_REG_INTVCC: C1114.1 (C1), U1102.4 (ITH), U1102.5 (ITH), U1102.6 (INTVCC)
3V3: JP1101.5, R1118.2; also elsewhere on the board
3V3_PGOOD: TP6.TP; also elsewhere on the board
3V3_PM: C1108.1 (C1), C1109.1 (C1), C1113.1 (C1), U1101.5 (VOUT), U1102.21 (EXTVCC); also elsewhere on the board
3V5_VIN_REG_DRVCC: C1126.1 (C1), R1120.2, R1123.2, R1124.2, U1102.20 (DRVCC), U1102.27 (!FAULT), U1102.28 (!FAULT)
5V0: C1122.1 (C1), C1124.1 (C1), C1127.1 (C1), C1129.1 (C1), JP1101.1, JP1101.2, L1101.2, R1119.2, R1121.2, R1122.2, U1102.2 (VSENSEP); also elsewhere on the board
5V0_BOOST: C1120.2 (C2), U1102.40 (BOOST)
5V0_PGOOD: R1121.1, TP1.TP, U1102.23 (RUN), U1102.33 (PGOOD); also elsewhere on the board
5V0_SW: C1120.1 (C1), L1101.1, U1102.36 (SW), U1102.37 (SW), U1102.41 (SW)
12V0: C1105.1 (C1), D1102.A, Q1104.5 (D), Q1104.6 (D), R1108.2; also elsewhere on the board
12V0_EN: Q1103.1 (G), R1112.2; also elsewhere on the board
12V0_VSENSE: C1106.1 (C1), R1108.1, R1109.2; also elsewhere on the board
!VIN_REG_ALERT: R1118.1, U1102.29 (!ALERT); also elsewhere on the board
GND: C1101.2 (C2), C1102.2 (C2), C1103.2 (C2), C1104.2 (C2), C1105.2 (C2), C1106.2 (C2), C1107.2 (C2), C1108.2 (C2), C1109.2 (C2), C1110.2 (C2), C1111.2 (C2), C1112.2 (C2), C1113.2 (C2), C1114.2 (C2), C1115.2 (C2), C1116.2 (C2), C1117.2 (C2), C1118.2 (C2), C1119.2 (C2), C1122.2 (C2), C1123.2 (C2), C1124.2 (C2), C1125.2 (C2), C1126.2 (C2), C1127.2 (C2), C1128.2 (C2), C1129.2 (C2), C1130.2 (C2), CON1101.P$1, D1104.C, D1105.A, JP1101.3, JP1101.4, Q1101.2 (S), Q1103.2 (S), Q1106.2 (S), R1102.1, R1104.1, R1105.1, R1109.1, R1111.1, R1112.1, R1115.1, R1125.1, R1126.1, R1127.1, R1128.1, U1101.2 (GND), U1102.1 (VSENSEN), U1102.3 (SGND), U1102.12 (VSENSEN), U1102.14 (PGND), U1102.19 (PGND), U1102.34 (PGND), U1102.39 (PGND), U1102.42 (PGND), U1102.43 (PGND), U1102.45 (PGND), U1102.46 (PGND), U1102.47 (PGND), U1102.48 (PGND); also elsewhere on the board
unnamed: Q1102.1 (S), Q1102.3 (S), R1106.2
unnamed: Q1102.2 (G), Q1102.4 (G), R1106.1, R1107.2
unnamed: Q1101.3 (D), R1107.1
unnamed: Q1104.1 (S), Q1104.3 (S), R1113.2
unnamed: Q1104.2 (G), Q1104.4 (G), R1113.1, R1114.2
unnamed: Q1103.3 (D), R1114.1
unnamed: Q1105.1 (S), Q1105.3 (S), R1116.2
unnamed: Q1105.2 (G), Q1105.4 (G), R1116.1, R1117.2
unnamed: Q1106.3 (D), R1117.1
unnamed: D1104.A, R1119.1
PM_I2C_SCL: U1102.30 (SCL); also elsewhere on the board
PM_I2C_SDA: U1102.31 (SDA); also elsewhere on the board
VBUS: C1103.1 (C1), D1101.A, Q1102.5 (D), Q1102.6 (D), R1110.2; also elsewhere on the board
VBUS_SNK_EN: Q1101.1 (G), R1105.2; also elsewhere on the board
VBUS_VSENSE: C1107.1 (C1), R1110.1, R1111.2; also elsewhere on the board
VEXT: C1110.1 (C1), D1103.A, D1105.C, F1101.1, Q1105.7 (D), Q1105.8 (D), R1103.2
VEXT_EN: Q1106.1 (G), R1115.2; also elsewhere on the board
VEXT_UNFUSED: CON1101.P$2, F1101.2
VEXT_VSENSE: C1102.1 (C1), R1103.1, R1104.2; also elsewhere on the board
VIN: C1111.1 (C1), C1112.1 (C1), C1116.1 (C1), C1117.1 (C1), C1118.1 (C1), C1119.1 (C1), Q1102.7 (D), Q1102.8 (D), Q1104.7 (D), Q1104.8 (D), Q1105.5 (D), Q1105.6 (D), R1101.2, U1102.15 (PVIN), U1102.18 (PVIN), U1102.35 (PVIN), U1102.38 (PVIN)
VIN_PM: C1104.1 (C1), D1101.C, D1102.C, D1103.C, U1101.1 (VIN), U1101.4 (!SHDN)
VIN_REG_ASEL: R1128.2, U1102.10 (ASEL)
VIN_REG_PWM_CFG: R1127.2, U1102.22 (SYNC/PWM_CFG)
VIN_REG_RUN0: R1123.1, U1102.24 (RUN)
VIN_REG_SHARE_CLK: R1124.1, U1102.25 (SHARE_CLK)
VIN_REG_VOUT0_CFG: R1126.2, U1102.8 (VOUT0_CFG)
VIN_REG_VOUT1_CFG: R1125.2, U1102.9 (VOUT1_CFG/POLYPHASE_CFG)
VIN_REG_WP: R1120.1, U1102.26 (WP)
VIN_VSENSE: C1101.1 (C1), R1101.1, R1102.2; also elsewhere on the board

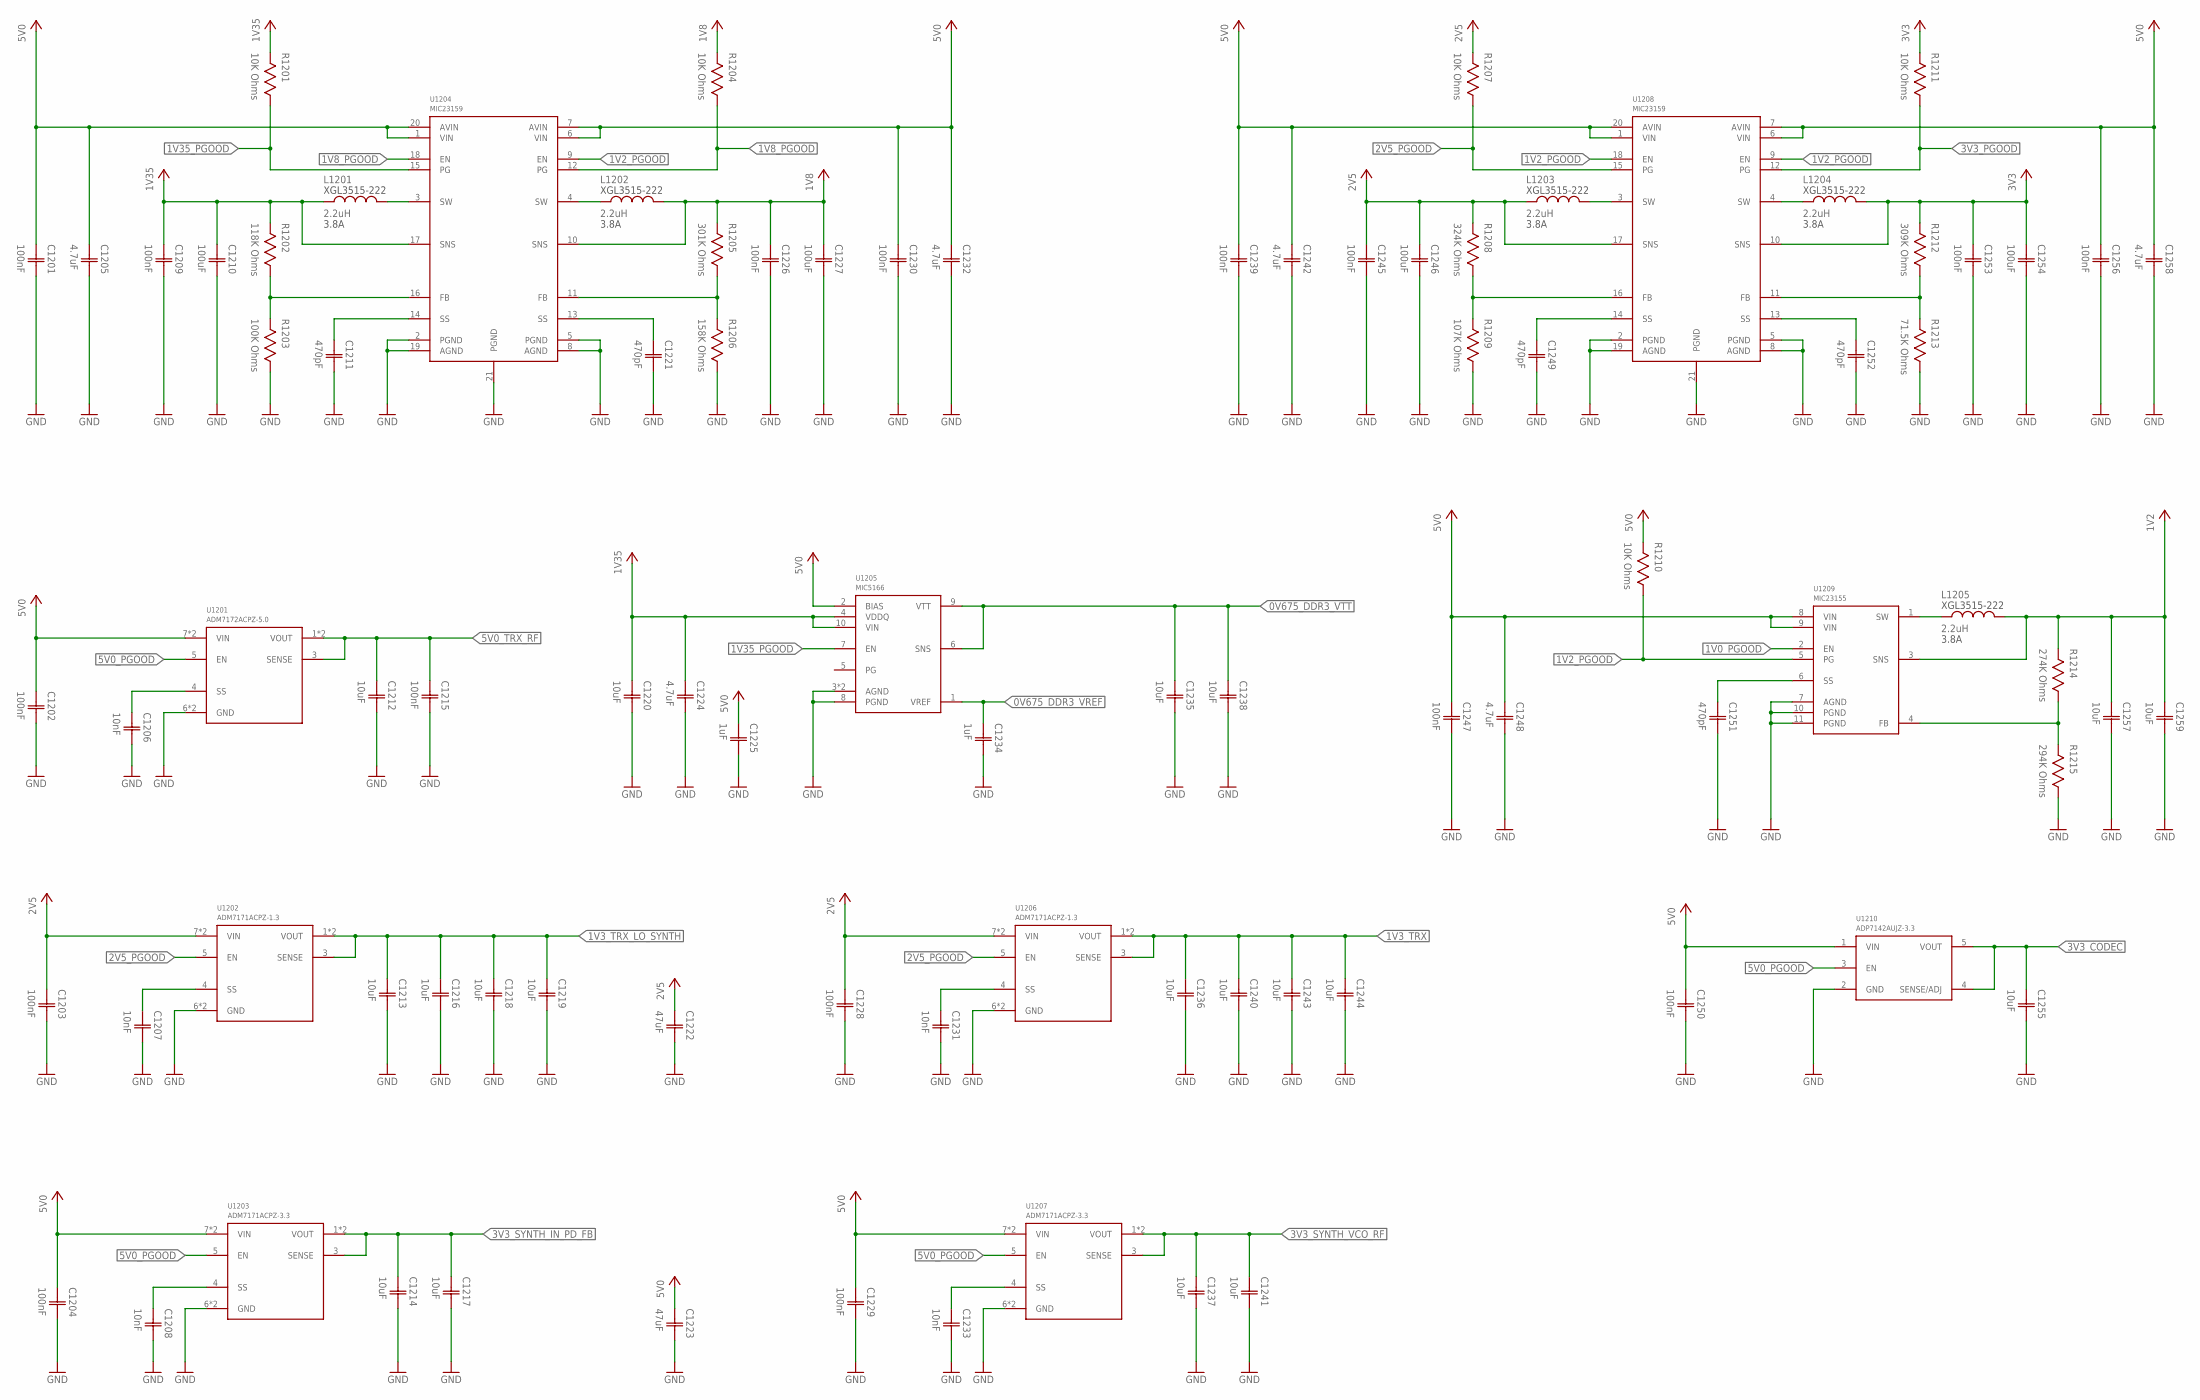
[picture p41: schematic icyradio-main.sch, sheet 12, Power]

Parts:
C1201, C1202, C1203, C1204, C1209, C1215, C1226, C1228, C1229, C1230, C1239, C1245, C1247, C1250, C1253, C1256: 100nF; CAP0402
C1205, C1232, C1242, C1248, C1258: 4.7uF; CAP0603
C1206, C1207, C1208, C1231, C1233: 10nF; CAP0402
C1210, C1227, C1246, C1254: 100uF; CAP1206
C1211, C1221, C1249, C1251, C1252: 470pF; CAP0402
C1212: 10uF; CAP0603
C1213, C1214, C1216, C1217, C1218, C1219, C1220, C1235, C1236, C1237, C1238, C1240, C1241, C1243, C1244, C1255, C1257, C1259: 10uF; CAP0402
C1222, C1223: 47uF; CAP0603
C1224: 4.7uF; CAP0402
C1225, C1234: 1uF; CAP0402
L1201, L1202, L1203, L1204, L1205: 2.2uH; XGL351X
R1201, R1204, R1207, R1210, R1211: 10K Ohms; RES0402
R1202: 118K Ohms; RES0402
R1203: 100K Ohms; RES0402
R1205: 301K Ohms; RES0402
R1206: 158K Ohms; RES0402
R1208: 324K Ohms; RES0402
R1209: 107K Ohms; RES0402
R1212: 309K Ohms; RES0402
R1213: 71.5K Ohms; RES0402
R1214: 274K Ohms; RES0402
R1215: 294K Ohms; RES0402
U1201: ADM7172ACPZ-5.0; LFCSP8_3X3
U1202, U1206: ADM7171ACPZ-1.3; LFCSP8_3X3
U1203, U1207: ADM7171ACPZ-3.3; LFCSP8_3X3
U1204, U1208: MIC23159; VQFN20
U1205: MIC5166; DFN10
U1209: MIC23155; DFN10_0.65P
U1210: ADP7142AUJZ-3.3; SOT23-5

Connections:
0V675_DDR3_VREF: C1234.1 (C1), U1205.1 (VREF); also elsewhere on the board
0V675_DDR3_VTT: C1235.1 (C1), C1238.1 (C1), U1205.6 (SNS), U1205.9 (VTT); also elsewhere on the board
1V0_PGOOD: U1209.2 (EN); also elsewhere on the board
1V2: C1257.1 (C1), C1259.1 (C1), L1205.2, R1214.2, U1209.3 (SNS); also elsewhere on the board
1V2_FB: R1214.1, R1215.2, U1209.4 (FB)
1V2_PGOOD: R1210.1, U1204.9 (EN), U1208.9 (EN), U1208.18 (EN), U1209.5 (PG); also elsewhere on the board
1V2_SS: C1251.1 (C1), U1209.6 (SS)
1V2_SW: L1205.1, U1209.1 (SW)
1V3_TRX: C1236.1 (C1), C1240.1 (C1), C1243.1 (C1), C1244.1 (C1), U1206.1 (VOUT), U1206.2 (VOUT), U1206.3 (SENSE); also elsewhere on the board
1V3_TRX_LO_SYNTH: C1213.1 (C1), C1216.1 (C1), C1218.1 (C1), C1219.1 (C1), U1202.1 (VOUT), U1202.2 (VOUT), U1202.3 (SENSE); also elsewhere on the board
1V8: C1226.1 (C1), C1227.1 (C1), L1202.2, R1204.2, R1205.2, U1204.10 (SNS); also elsewhere on the board
1V8_FB: R1205.1, R1206.2, U1204.11 (FB)
1V8_PGOOD: R1204.1, U1204.12 (PG), U1204.18 (EN); also elsewhere on the board
1V8_SS: C1221.1 (C1), U1204.13 (SS)
1V8_SW: L1202.1, U1204.4 (SW)
1V35: C1209.1 (C1), C1210.1 (C1), C1220.1 (C1), C1224.1 (C1), L1201.1, R1201.2, R1202.2, U1204.17 (SNS), U1205.4 (VDDQ), U1205.10 (VIN); also elsewhere on the board
1V35_FB: R1202.1, R1203.2, U1204.16 (FB)
1V35_PGOOD: R1201.1, U1204.15 (PG), U1205.7 (EN); also elsewhere on the board
1V35_SS: C1211.1 (C1), U1204.14 (SS)
1V35_SW: L1201.2, U1204.3 (SW)
2V5: C1203.1 (C1), C1222.1 (C1), C1228.1 (C1), C1245.1 (C1), C1246.1 (C1), L1203.1, R1207.2, R1208.2, U1202.7 (VIN), U1202.8 (VIN), U1206.7 (VIN), U1206.8 (VIN), U1208.17 (SNS); also elsewhere on the board
2V5_FB: R1208.1, R1209.2, U1208.16 (FB)
2V5_PGOOD: R1207.1, U1202.5 (EN), U1206.5 (EN), U1208.15 (PG); also elsewhere on the board
2V5_SS: C1249.1 (C1), U1208.14 (SS)
2V5_SW: L1203.2, U1208.3 (SW)
3V3: C1253.1 (C1), C1254.1 (C1), L1204.2, R1211.2, R1212.2, U1208.10 (SNS); also elsewhere on the board
3V3_CODEC: C1255.1 (C1), U1210.4 (SENSE/ADJ), U1210.5 (VOUT); also elsewhere on the board
3V3_FB: R1212.1, R1213.2, U1208.11 (FB)
3V3_PGOOD: R1211.1, U1208.12 (PG); also elsewhere on the board
3V3_SS: C1252.1 (C1), U1208.13 (SS)
3V3_SW: L1204.1, U1208.4 (SW)
3V3_SYNTH_IN_PD_FB: C1214.1 (C1), C1217.1 (C1), U1203.1 (VOUT), U1203.2 (VOUT), U1203.3 (SENSE); also elsewhere on the board
3V3_SYNTH_VCO_RF: C1237.1 (C1), C1241.1 (C1), U1207.1 (VOUT), U1207.2 (VOUT), U1207.3 (SENSE); also elsewhere on the board
5V0: C1201.1 (C1), C1202.1 (C1), C1204.1 (C1), C1205.1 (C1), C1223.1 (C1), C1225.1 (C1), C1229.1 (C1), C1230.1 (C1), C1232.1 (C1), C1239.1 (C1), C1242.1 (C1), C1247.1 (C1), C1248.1 (C1), C1250.1 (C1), C1256.1 (C1), C1258.1 (C1), R1210.2, U1201.7 (VIN), U1201.8 (VIN), U1203.7 (VIN), U1203.8 (VIN), U1204.1 (VIN), U1204.6 (VIN), U1204.7 (AVIN), U1204.20 (AVIN), U1205.2 (BIAS), U1207.7 (VIN), U1207.8 (VIN), U1208.1 (VIN), U1208.6 (VIN), U1208.7 (AVIN), U1208.20 (AVIN), U1209.8 (VIN), U1209.9 (VIN), U1210.1 (VIN); also elsewhere on the board
5V0_PGOOD: U1201.5 (EN), U1203.5 (EN), U1207.5 (EN), U1210.3 (EN); also elsewhere on the board
5V0_TRX_RF: C1212.1 (C1), C1215.1 (C1), U1201.1 (VOUT), U1201.2 (VOUT), U1201.3 (SENSE); also elsewhere on the board
GND: C1201.2 (C2), C1202.2 (C2), C1203.2 (C2), C1204.2 (C2), C1205.2 (C2), C1206.2 (C2), C1207.2 (C2), C1208.2 (C2), C1209.2 (C2), C1210.2 (C2), C1211.2 (C2), C1212.2 (C2), C1213.2 (C2), C1214.2 (C2), C1215.2 (C2), C1216.2 (C2), C1217.2 (C2), C1218.2 (C2), C1219.2 (C2), C1220.2 (C2), C1221.2 (C2), C1222.2 (C2), C1223.2 (C2), C1224.2 (C2), C1225.2 (C2), C1226.2 (C2), C1227.2 (C2), C1228.2 (C2), C1229.2 (C2), C1230.2 (C2), C1231.2 (C2), C1232.2 (C2), C1233.2 (C2), C1234.2 (C2), C1235.2 (C2), C1236.2 (C2), C1237.2 (C2), C1238.2 (C2), C1239.2 (C2), C1240.2 (C2), C1241.2 (C2), C1242.2 (C2), C1243.2 (C2), C1244.2 (C2), C1245.2 (C2), C1246.2 (C2), C1247.2 (C2), C1248.2 (C2), C1249.2 (C2), C1250.2 (C2), C1251.2 (C2), C1252.2 (C2), C1253.2 (C2), C1254.2 (C2), C1255.2 (C2), C1256.2 (C2), C1257.2 (C2), C1258.2 (C2), C1259.2 (C2), R1203.1, R1206.1, R1209.1, R1213.1, R1215.1, U1201.6 (GND), U1201.9 (GND), U1202.6 (GND), U1202.9 (GND), U1203.6 (GND), U1203.9 (GND), U1204.2 (PGND), U1204.5 (PGND), U1204.8 (AGND), U1204.19 (AGND), U1204.21 (PGND), U1205.3 (AGND), U1205.8 (PGND), U1205.11 (AGND), U1206.6 (GND), U1206.9 (GND), U1207.6 (GND), U1207.9 (GND), U1208.2 (PGND), U1208.5 (PGND), U1208.8 (AGND), U1208.19 (AGND), U1208.21 (PGND), U1209.7 (AGND), U1209.10 (PGND), U1209.11 (PGND), U1210.2 (GND); also elsewhere on the board
unnamed: C1207.1 (C1), U1202.4 (SS)
unnamed: C1206.1 (C1), U1201.4 (SS)
unnamed: C1231.1 (C1), U1206.4 (SS)
unnamed: C1208.1 (C1), U1203.4 (SS)
unnamed: C1233.1 (C1), U1207.4 (SS)

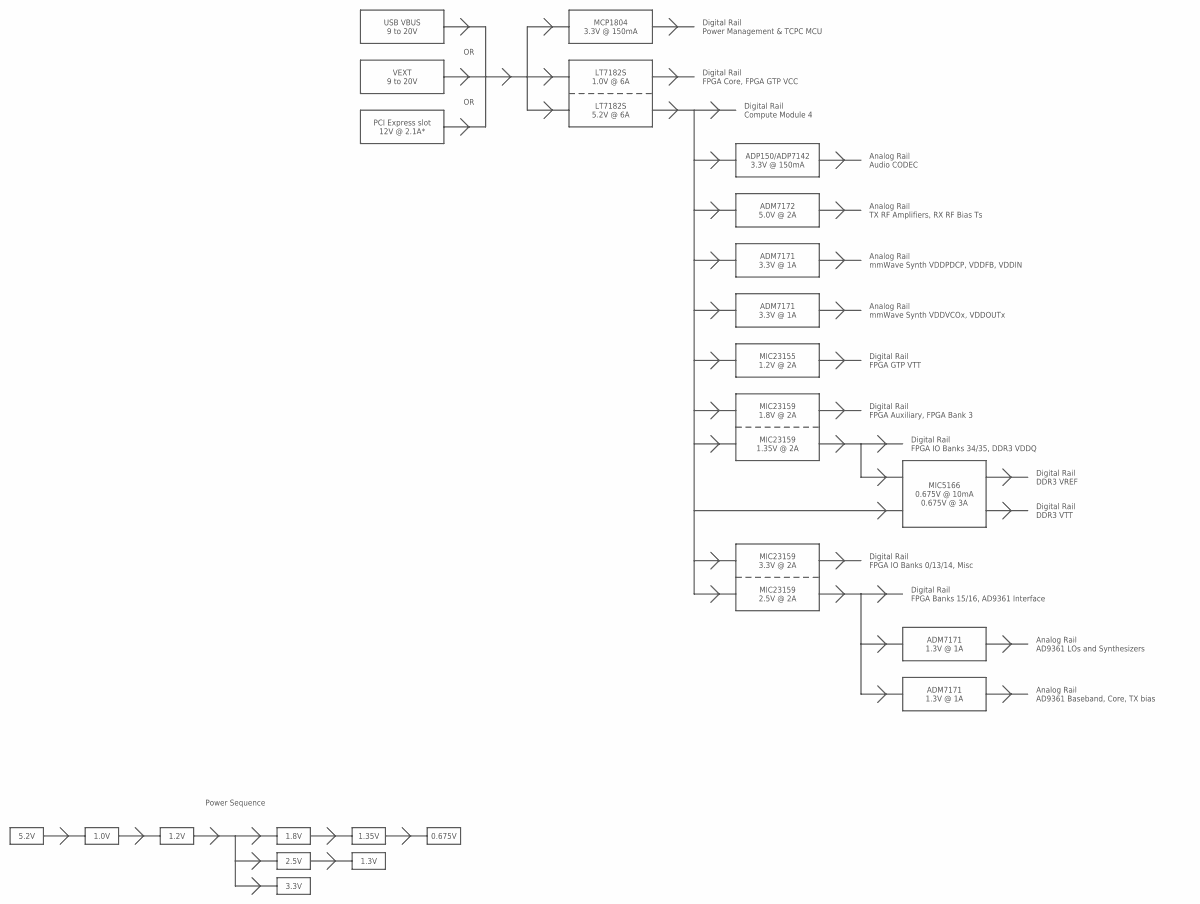
[picture p42: schematic icyradio-main.sch, sheet 13, Power tree]

Notes on the sheet:
LT7182S 5.2V @ 6A
ADP150/ADP7142 3.3V @ 150mA
Analog Rail Audio CODEC
ADM7172 5.0V @ 2A
Analog Rail TX RF Amplifiers, RX RF Bias Ts
Digital Rail Compute Module 4
MIC23159 3.3V @ 2A
MIC23159 2.5V @ 2A
Digital Rail FPGA IO Banks 0/13/14, Misc
MIC23155 1.2V @ 2A
Digital Rail FPGA GTP VTT
Digital Rail FPGA IO Banks 34/35, DDR3 VDDQ
Digital Rail FPGA Auxiliary, FPGA Bank 3
MIC23159 1.35V @ 2A
MIC23159 1.8V @ 2A
MIC5166 0.675V @ 10mA 0.675V @ 3A
Digital Rail DDR3 VREF
Digital Rail DDR3 VTT
Power Sequence
1.0V
1.2V
1.35V
1.8V
1.3V
5.2V
LT7182S 1.0V @ 6A
Digital Rail FPGA Core, FPGA GTP VCC
3.3V
2.5V
0.675V
MCP1804 3.3V @ 150mA
Digital Rail Power Management & TCPC MCU
VEXT 9 to 20V
PCI Express slot 12V @ 2.1A*
USB VBUS 9 to 20V
ADM7171 1.3V @ 1A
Analog Rail AD9361 LOs and Synthesizers
Analog Rail AD9361 Baseband, Core, TX bias
Digital Rail FPGA Banks 15/16, AD9361 Interface
Analog Rail mmWave Synth VDDPDCP, VDDFB, VDDIN
ADM7171 3.3V @ 1A
Analog Rail mmWave Synth VDDVCOx, VDDOUTx

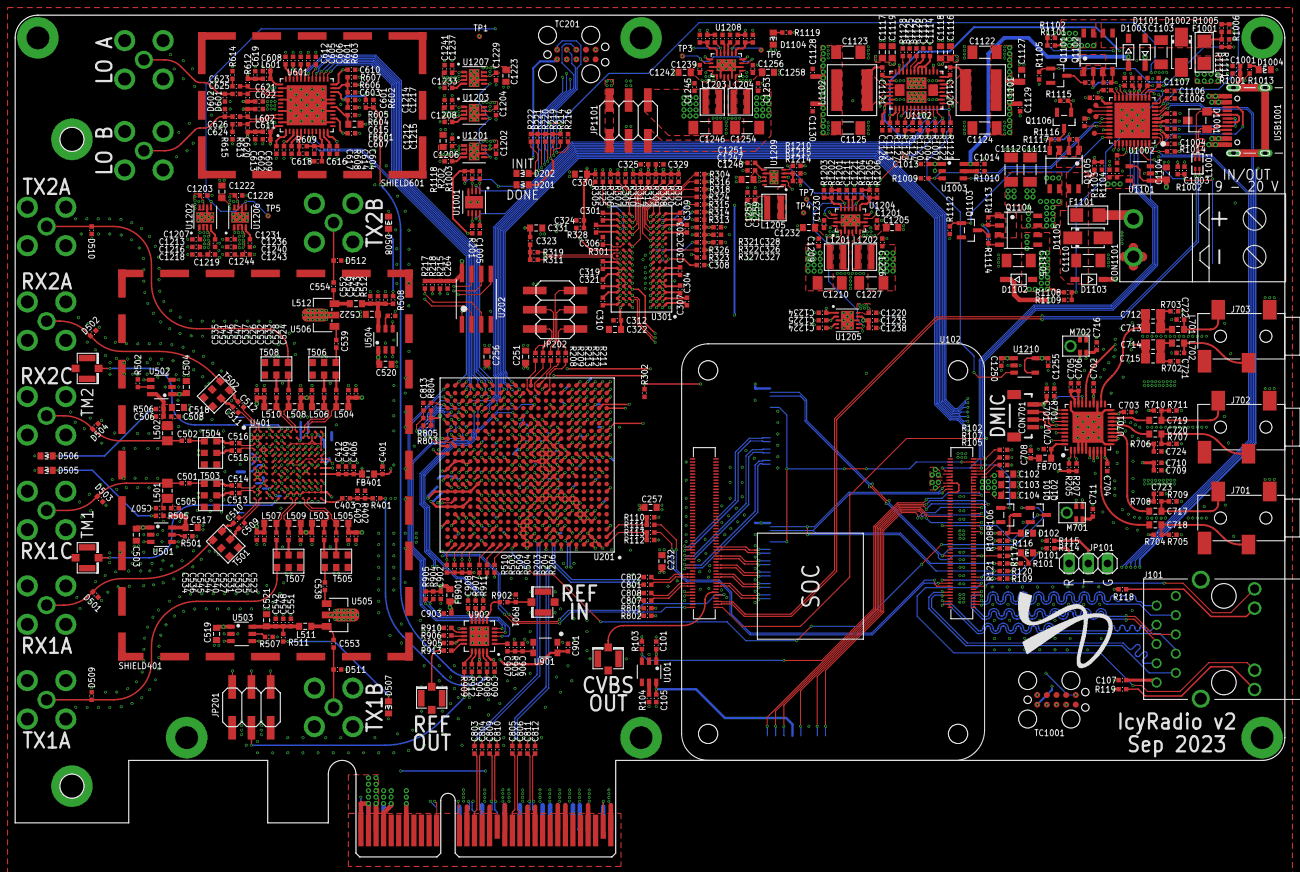
[picture p43: board icyradio-main.brd from above]

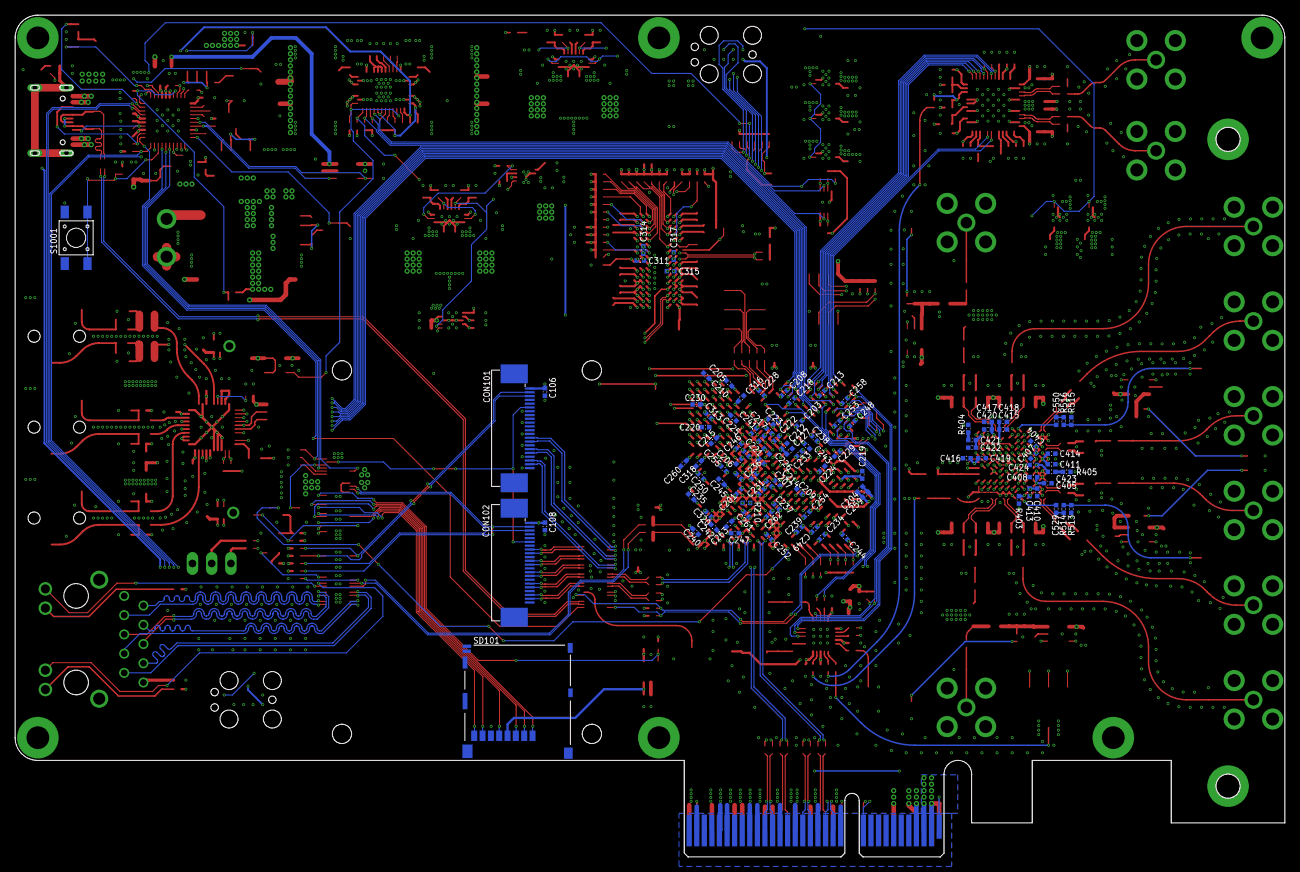
[picture p44: board icyradio-main.brd from below]

Board: 6 copper layers, 167.7 x 111.2 mm, 702 parts (101 on the bottom side), 512 nets.
