vankxr/icyradio/pcb/lna/icyradio-lna.brd

## EAGLE design pcb/lna/icyradio-lna.brd (2020-06-16)

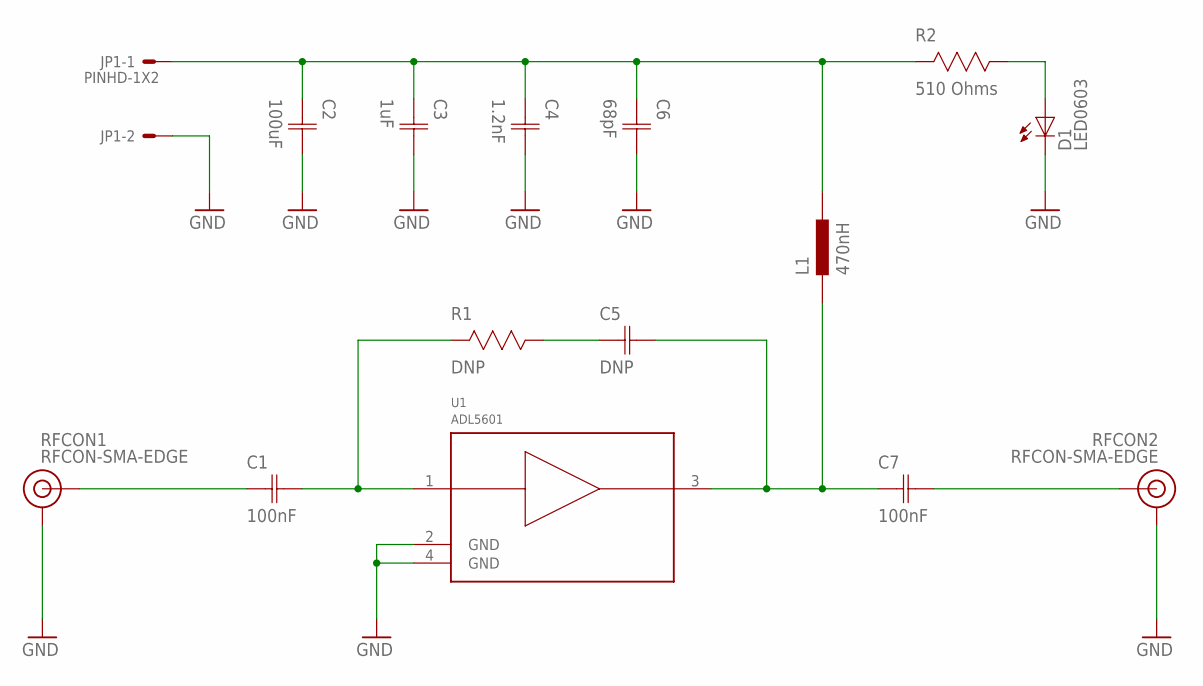
[picture p45: schematic icyradio-lna.sch]

Parts:
C1, C7: 100nF; CAP0603
C2: 100uF; CAP1206
C3: 1uF; CAP0603
C4: 1.2nF; CAP0603
C5: DNP; CAP0603
C6: 68pF; CAP0603
D1: LED0603; 0603
JP1: PINHD-1X2; 1X02
L1: 470nH; IND0603
R1: DNP; RES0603
R2: 510 Ohms; RES0603
RFCON1, RFCON2: RFCON-SMA-EDGE; SMA-EDGE
U1: ADL5601; SOT89

Connections:
GND: C2.2 (C2), C3.2 (C2), C4.2 (C2), C6.2 (C2), D1.C, JP1.2, RFCON1.GND@0 (GND), RFCON1.GND@1 (GND), RFCON1.GND@2 (GND), RFCON1.GND@3 (GND), RFCON2.GND@0 (GND), RFCON2.GND@1 (GND), RFCON2.GND@2 (GND), RFCON2.GND@3 (GND), U1.2 (GND), U1.4 (GND)
unnamed: C5.1 (C1), R1.1
unnamed: D1.A, R2.1
RFIN: C1.1 (C1), RFCON1.SIG (SIGNAL)
RFOUT: C7.2 (C2), RFCON2.SIG (SIGNAL)
TXPA_IN: C1.2 (C2), R1.2, U1.1 (RFIN)
TXPA_OUT: C5.2 (C2), C7.1 (C1), L1.1, U1.3 (RFOUT)
VDD: C2.1 (C1), C3.1 (C1), C4.1 (C1), C6.1 (C1), JP1.1, L1.2, R2.2

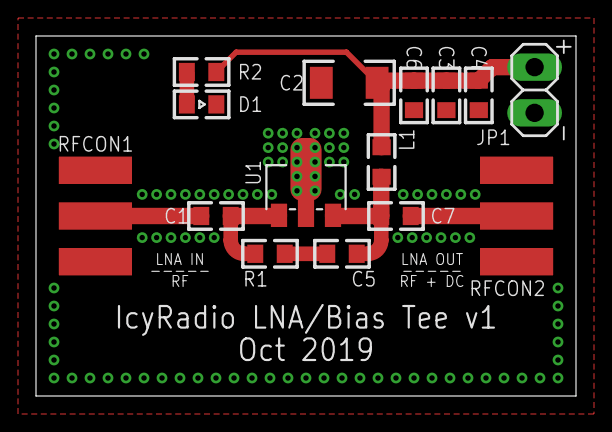
[picture p46: board icyradio-lna.brd from above]

Board: 2 copper layers, 30.0 x 20.0 mm, 15 parts (0 on the bottom side), 8 nets.
