vankxr/icyradio/pcb/icyradio.brd

## EAGLE design pcb/icyradio.brd (2019-10-10)

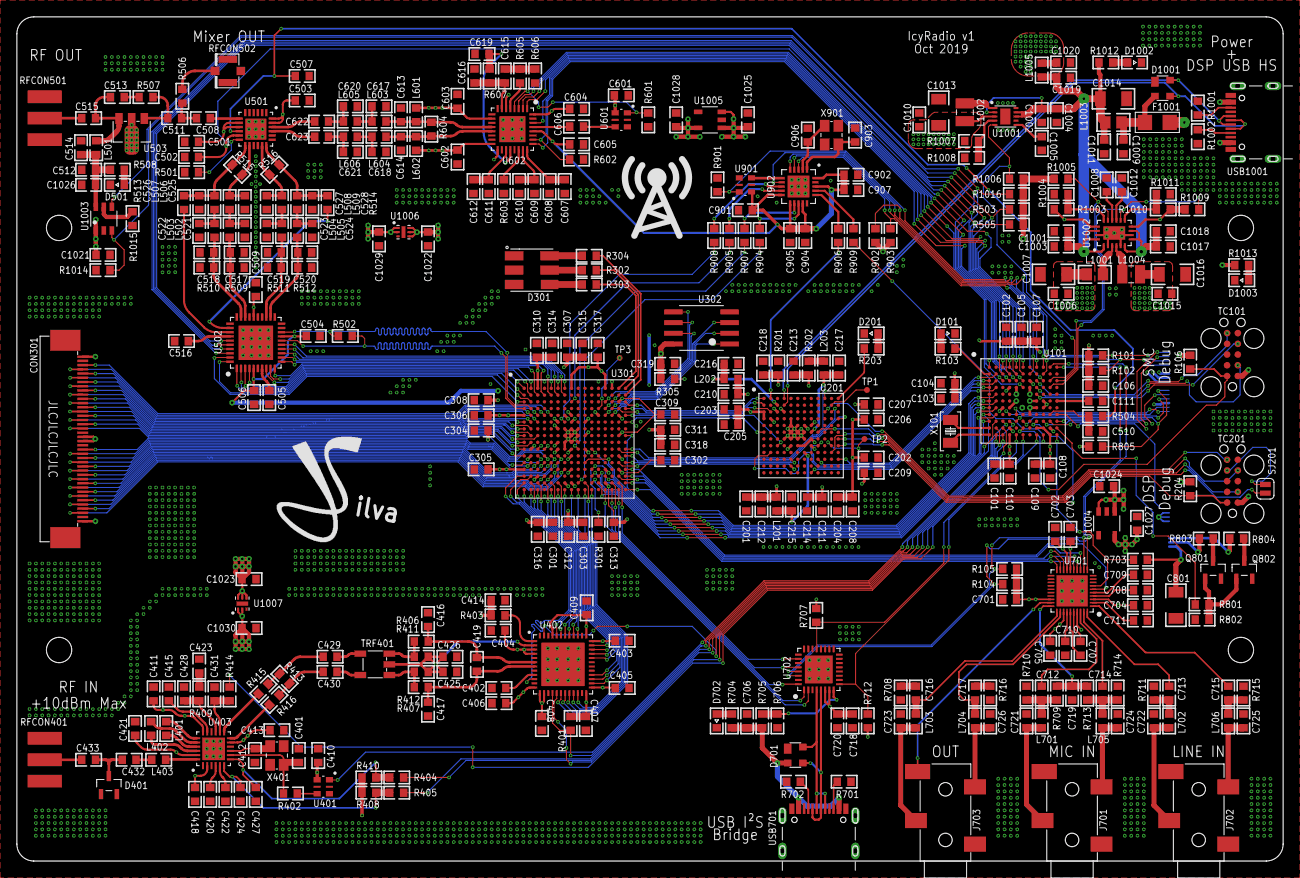
[picture p47: board icyradio.brd from above]

Board: 4 copper layers, 150.0 x 100.0 mm, 386 parts (1 on the bottom side), 340 nets.

Parts:
C101, C102, C103, C104, C105, C106, C107, C108, C109, C110, C202, C203, C204, C205, C206, C207, C208, C209, C210, C211, C212, C213, C214, C215, C216, C301, C302, C303, C304, C305, C306, C307, C308, C309, C310, C311, C312, C313, C314, C315, C316, C317, C318, C319, C401, C402, C403, C404, C405, C406, C407, C408, C409, C411, C413, C415, C418, C421, C422, C426, C429, C430, C431, C501, C502, C503, C504, C506, C507, C508, C509, C510, C511, C515, C516, C601, C602, C603, C604, C605, C606, C607, C609, C611, C622, C623, C701, C702, C703, C704, C705, C706, C720, C901, C902, C904, C905, C907, C1001, C1002, C1006, C1010, C1011, C1015, C1017, C1020: 100nF; CAP0603
C111, C201, C420, C505, C712, C713, C714, C715, C718, C719, C1021, C1024, C1025, C1027, C1028: 1uF; CAP0603
C217, C707, C710, C711, C1003, C1004, C1018, C1022, C1023, C1029, C1030: 4.7uF; CAP0603
C218, C608, C610, C612: 10pF; CAP0603
C410, C412, C513, C903, C906: DNP; CAP0603
C414, C425: 2.2uF; CAP0603
C416, C417, C419: 12pF; CAP0603
C423: 6.8nF; CAP0603
C424, C427: 27pF; CAP0603
C428, C432: 330pF; CAP0603
C433, C708, C709, C1009, C1019: 10nF; CAP0603
C512, C619: 1.2nF; CAP0603
C514: 68pF; CAP0603
C517, C518, C519, C520, C525, C526, C527, C528: 200pF; CAP0603
C521, C522, C523, C524: 620pF; CAP0603
C613, C614, C620, C621: 0.4pF; CAP0603
C615: 39nF; CAP0603
C616: 2.7nF; CAP0603
C617, C618: 1.3pF; CAP0603
C716, C717: 22nF; CAP0603
C721, C722, C723, C724, C725, C726: 220pF; CAP0603
C801, C1007, C1013, C1014, C1016: 100uF; CAP1206
C1005, C1008, C1012: 470pF; CAP0603
C1026: 10uF; CAP0603
CON301: FPC-40P
D101, D201, D501, D702, D1002, D1003: LED0603; 0603
D301: RGBLED; 5050
D401: BAV99; SOT23
D701, D1001: SP0503BAHT; SOT143
F1001: 1206
J701, J702, J703: TRSJACK; 3.5TRSJACK
L201, L202: 470 Ohms; IND0603
L203: 10uH; IND0603
L401, L402: 150nH; IND0603
L403: 8.2nH; IND0603
L501: 470nH; IND0603
L502, L503, L504, L505, L506, L507, L508, L509: 1.3uH; IND0603
L601, L602: 19nH; IND0603
L603, L604, L605, L606: 2.7nH; IND0603
L701, L702, L703, L704, L705, L706: 600 Ohms; IND0603
L1001: 2.2uH; IND0805
L1002, L1004: 2.2uH; IND2520
L1003: 350nH; IND0805
L1005: 350nH; IND0603
Q801, Q802: AO3400; SOT23
R101, R102, R104, R105, R408, R410, R710, R711, R714, R715: 4.7K Ohms; RES0603
R103, R203, R302, R303, R304, R1013: 330 Ohms; RES0603
R106, R204, R414, R513, R514, R703, R707, R712, R802: 10K Ohms; RES0603
R201: 5.62K Ohms; RES0603
R202: 2.2 Ohms; RES0603
R301, R305, R401, R501, R503, R505, R601, R602, R805, R901, R902, R903, R1005, R1006, R1009, R1014, R1016: 100K Ohms; RES0603
R402, R502, R803, R804, R904, R905, R906, R907, R908, R909: 0 Ohms; RES0603
R403: 1K Ohms; RES0603
R404, R405, R415, R416: 220 Ohms; RES0603
R406, R407, R411, R412: 25 Ohms; RES0603
R409: 1.8K Ohms; RES0603
R413, R506, R507, R605: DNP; RES0603
R504: 200 Ohms; RES0603
R508, R704, R1012: 510 Ohms; RES0603
R509, R510, R511, R512: 49.9 Ohms; RES0603
R515, R516, R604, R708, R716: 100 Ohms; RES0603
R603, R701, R702, R1001, R1002: 5.1K Ohms; RES0603
R606: 360 Ohms; RES0603
R607: 680 Ohms; RES0603
R705: 24K Ohms; RES0603
R706: 47K Ohms; RES0603
R709, R713: 2.21K Ohms; RES0603
R801: 22 Ohms; RES0603
R1003: 274K Ohms; RES0603
R1004: 294K Ohms; RES0603
R1007, R1010: 309K Ohms; RES0603
R1008: 64.9K Ohms; RES0603
R1011: 71.5K Ohms; RES0603
R1015: 820 Ohms; RES0603
RFCON401, RFCON501: RFCON-SMA-EDGE; SMA-EDGE
RFCON502: RFCON-U.FL; U.FL
SJ201: SJ_S
TC101, TC201: TC2050-IDC
TP1, TP2, TP3: TESTPOINT-0.7MM; PAD0.7MM
TRF401: ETC1-1T-2TR; TRF-SM-22
U101: EFM32GG11B420F2048GL112; BGA112
U201: ATSAMS70Q21B-C; LFBGA144
U301: ICE40HX8K-CT256; CABGA256
U302: SST26VF064B; WSOIC8
U401: DSC1211DE3-C0017; VDFN6
U402: LTC2206; QFN48
U403: R820T2; QFN24
U501: ADL5385; QFN24
U502: AD9117; QFN40
U503: ADL5601; SOT89
U601, U901: DSC1201DE3-50M00000; VDFN6
U602: ADF4351; QFN32
U701: TSCS25A3X1NDGXZAX; QFN40
U702: CP2615; QFN32
U801: ER-TFT035-6; FPC-50P
U902: SI5351C; QFN20
U1001: MIC23155; DFN10
U1002: MIC23159; VQFN20
U1003: MIC2019; SOT23-6
U1004: ADP150UJZ-1.8; SOT23-5
U1005: ADP150UJZ-3.3; SOT23-5
U1006, U1007: MIC94305; DFN6
U$1: JS_10MM
U$2: RADIO_10MM
USB701, USB1001: USB-C-16P-SMD-FLAT-SIDE-TYPE-2
X101: 32.768 kHz; 2-SMD-3215
X401, X901: DNP; 4-SMD-3225

Connections:
1V2: C303.1, C304.1, C307.1, C308.1, C311.1, C312.1, C315.1, C318.1, C1006.1, C1007.1, L1001.1, R1003.2, U301.A14, U301.E8, U301.F6, U301.F10, U301.K6, U301.K10, U301.L2, U301.L8, U1002.17
1V2_FB: R1003.1, R1004.2, U1002.16
1V2_PGOOD: R1005.1, U101.C11, U1002.15
1V2_SOFTSTART: C1008.1, U1002.14
1V8_CODEC_CLEAN: C702.1, C704.1, C705.1, C1027.1, U701.3, U701.17, U701.33, U701.37, U1004.5
3V3: C101.1, C102.1, C103.1, C104.1, C105.1, C106.1, C107.1, C108.1, C109.1, C110.1, C203.1, C205.1, C207.1, C209.1, C211.1, C213.1, C214.1, C301.1, C302.1, C305.1, C306.1, C309.1, C310.1, C313.1, C314.1, C316.1, C317.1, C319.1, C403.1, C405.1, C407.1, C409.1, C504.1, C506.1, C605.1, C701.1, C703.1, C718.1, C720.1, C801.1, C901.1, C902.1, C904.1, C905.1, C907.1, C1015.1, C1016.1, C1024.1, CON301.1, CON301.20, CON301.21, CON301.40, L1004.2, R101.2, R102.2, R104.2, R105.2, R106.2, R202.2, R204.2, R305.2, R401.2, R408.2, R410.2, R503.2, R505.2, R703.2, R707.2, R712.2, R805.2, R902.2, R903.2, R1005.2, R1006.2, R1009.2, R1010.2, R1013.2, R1016.2, TC101.1, TC201.1, U101.D5, U101.D7, U101.F8, U101.G4, U101.G8, U101.H7, U101.K8, U101.K9, U101.L4, U101.L10, U201.C1, U201.D1, U201.E7, U201.G8, U201.H6, U201.H7, U301.A3, U301.A8, U301.A13, U301.C15, U301.E1, U301.E12, U301.F8, U301.G6, U301.H10, U301.H15, U301.J6, U301.K8, U301.N1, U301.N13, U301.N15, U301.P3, U301.R8, U301.R13, U302.8, U402.24, U402.25, U402.36, U402.37, U402.45, U502.5, U502.17, U602.28, U701.16, U701.28, U702.6, U702.7, U801.1, U801.7, U801.8, U801.9, U801.35, U801.40, U801.41, U801.42, U901.6, U902.10, U902.11, U902.14, U902.18, U902.20, U1002.10, U1004.1, U1004.3
3V3_ANA_RX_CLEAN: C401.1, C404.1, C406.1, C408.1, C411.1, C413.1, C414.1, C418.1, C421.1, C1030.1, R403.1, U401.6, U402.3, U402.4, U402.12, U402.13, U402.14, U403.2, U403.11, U403.18, U403.23, U1007.1, U1007.2
3V3_ANA_TXPLL_CLEAN: C601.1, C602.1, C603.1, C604.1, C1028.1, L601.1, L602.2, U601.6, U602.6, U602.10, U602.16, U602.17, U602.32, U1005.5
3V3_ANA_TX_CLEAN: C509.1, C1029.1, U502.26, U1006.1, U1006.2
3V3_FB: R1010.1, R1011.2, U1002.11
3V3_PGOOD: R1009.1, U101.D10, U1002.12
3V3_SOFTSTART: C1012.1, U1002.13
3V6_ANA: C1010.1, C1013.1, C1022.1, C1023.1, C1025.1, L1002.2, R1007.2, U1001.3, U1005.1, U1005.3, U1006.4, U1006.5, U1006.6, U1007.4, U1007.5, U1007.6
3V6_ANA_FB: R1007.1, R1008.2, U1001.4
3V6_ANA_PGOOD: R1006.1, U101.C10, U1001.5
3V6_ANA_SOFTSTART: C1005.1, U1001.6
5V0: C1001.1, C1002.1, C1003.1, C1004.1, C1011.1, C1014.1, C1017.1, C1018.1, C1019.1, L1003.2, L1005.1, R1012.2, U1001.2, U1001.8, U1001.9, U1002.1, U1002.6, U1002.7, U1002.9, U1002.18, U1002.20
5V0_ANA_TXMIXER_CLEAN: C501.1, C502.1, C503.1, C1020.1, C1021.1, L1005.2, U501.8, U501.9, U501.11, U501.23, U501.24, U1003.1
5V0_ANA_TXPA_CLEAN: C512.1, C514.1, C1026.1, L501.2, R508.2, U1003.6
!CLK_MNGR_IRQ: R903.1, U101.C9, U902.3
!CLK_MNGR_OE: R902.1, U101.A8, U902.7
!CLK_MNGR_REFCLK_STDBY: R901.2, U101.B7, U901.1
!CODEC_RST: R703.1, U101.L11, U701.7
!DSP_IRQ: U101.B2, U201.K12
!DSP_RESET: R204.1, TC201.10, U101.J8, U201.H12
!DSP_SPI_CS: U101.D1, U201.J2
!FPGA_CRESET: R301.2, U101.G2, U301.N11
!FPGA_DSP_IRQ: U201.F1, U301.F16
!FPGA_MEM_CS: R305.1, U301.E14, U302.1
!FPGA_SPI_CS: U101.H1, U301.R12
!FPGA_SRESET: U101.E2, U301.H16
!I2S_BRG_CFG: R707.1, U101.L6, U702.21
!I2S_BRG_RST: R712.1, U101.L8, U702.9
!RXADC_OE: U301.P2, U402.44
!SMC_RESET: R106.1, TC101.10, U101.K6
!TFT_RESET: U101.H11, U801.10
!TFT_SPI_CS: R805.1, U101.J6, U801.38
!TFT_TOUCH_IRQ: U101.J9, U801.46
!TFT_TOUCH_RESET: U101.J10, U801.47
!TXDAC_CS: R503.1, U101.A4, U502.38
!TXPA_OC: R1016.1, U101.B3, U1003.4
!TXPLL_MUTE: R602.2, U101.B6, U602.26
AUDIO_I2C_SCL: R105.1, U101.A11, U701.12, U702.29
AUDIO_I2C_SDA: R104.1, U101.A10, U701.11, U702.30
BRG_I2S_LRCLK: U301.T15, U702.28
BRG_I2S_MCLK: U301.R15, U702.26
BRG_I2S_SCLK: U301.T13, U702.2
BRG_I2S_SDIN: U301.T14, U702.1
BRG_I2S_SDOUT: U301.R14, U702.32
CLK_MNGR_CLK0: R904.2, U902.13
CLK_MNGR_CLK1: R907.2, U902.12
CLK_MNGR_CLK2: R905.2, U902.9
CLK_MNGR_CLK3: R908.2, U902.8
CLK_MNGR_CLK5: R909.2, U902.17
CLK_MNGR_CLK6: R906.2, U902.16
CLK_MNGR_REF: U901.4, U902.6
CLK_MNGR_XTALA: C903.1, U902.1, X901.2
CLK_MNGR_XTALB: C906.1, U902.2, X901.4
CODEC_AFILT1: C709.1, U701.5
CODEC_AFILT2: C708.1, U701.4
CODEC_CAP-: C707.2, U701.35
CODEC_HP_L: C726.1, J703.2, L704.1
CODEC_HP_R: C723.1, J703.3, L703.1
CODEC_I2S_LRCLK: U301.R16, U701.15, U701.19
CODEC_I2S_MCLK: U301.N16, U701.6
CODEC_I2S_SCLK: U301.T16, U701.14, U701.20
CODEC_I2S_SDIN: U301.P15, U701.18
CODEC_I2S_SDOUT: U301.P16, U701.13
CODEC_LINE_L: C725.1, J702.2, L706.1
CODEC_LINE_R: C722.1, J702.3, L702.1
CODEC_MIC_L: C724.1, J701.2, L705.1
CODEC_MIC_R: C721.1, J701.3, L701.1
CODEC_V-: C710.1, U701.34
CODEC_VREF: C711.1, U701.2
CPDEC_CAP+: C707.1, U701.36
DSP_BB_I2S_LRCLK: U201.C2, U301.D15
DSP_BB_I2S_SCLK: U201.H3, U301.E16
DSP_BB_I2S_SDIN: U201.B1, U301.D16
DSP_BB_I2S_SDOUT: U201.A1, U301.C16
DSP_D+: D1001.4, U201.A4, USB1001.A6, USB1001.B6
DSP_D-: D1001.3, U201.B4, USB1001.A7, USB1001.B7
DSP_ERASE: SJ201.1, U201.G12
DSP_I2S_LRCLK: U201.L5, U301.M15
DSP_I2S_MCLK: U201.C11, U301.K15
DSP_I2S_SCLK: U201.D12, U301.L16
DSP_I2S_SDIN: U201.K5, U301.M16
DSP_I2S_SDOUT: U201.A10, U301.K16
DSP_JTAGSEL: TP1.TP, U201.B11
DSP_LED: R203.2, U201.A12
DSP_MAIN_CLK: R906.1, U201.A2
DSP_SPI_MISO: U101.C1, U201.K9
DSP_SPI_MOSI: U101.C2, U201.H9
DSP_SPI_SCK: U101.D2, U201.M8
DSP_SWCLK: TC201.4, U201.F9
DSP_SWDIO: TC201.2, U201.J11
DSP_SWO: TC201.6, U201.C10
DSP_TST: TP2.TP, U201.H11
DSP_VDDOUT: C201.1, C202.1, C204.1, C206.1, C208.1, C210.1, C212.1, L201.1, L202.1, U201.C3, U201.E8, U201.H5, U201.H8
DSP_VDDPLLUSB: C217.1, L203.2, U201.F8
EXP_IO0: CON301.3, U301.E5
EXP_IO1: CON301.4, U301.E4
EXP_IO2: CON301.5, U301.E3
EXP_IO3: CON301.6, U301.E2
EXP_IO4: CON301.7, U301.F3
EXP_IO5: CON301.8, U301.F2
EXP_IO6: CON301.9, U301.F1
EXP_IO7: CON301.10, U301.G2
EXP_IO8: CON301.11, U301.G1
EXP_IO9: CON301.12, U301.H2
EXP_IO10: CON301.13, U301.H1
EXP_IO11: CON301.14, U301.H3
EXP_IO12: CON301.15, U301.J1
EXP_IO13: CON301.16, U301.J2
EXP_IO14: CON301.17, U301.K1
EXP_IO15: CON301.18, U301.L1
EXP_IO16: CON301.23, U301.K3
EXP_IO17: CON301.24, U301.K4
EXP_IO18: CON301.25, U301.L4
EXP_IO19: CON301.26, U301.L3
EXP_IO20: CON301.27, U301.M1
EXP_IO21: CON301.28, U301.M2
EXP_IO22: CON301.29, U301.M3
EXP_IO23: CON301.30, U301.M4
EXP_IO24: CON301.31, U301.M5
EXP_IO25: CON301.32, U301.L5
EXP_IO26: CON301.33, U301.M6
EXP_IO27: CON301.34, U301.P4
EXP_IO28: CON301.35, U301.P5
EXP_IO29: CON301.36, U301.N6
EXP_IO30: CON301.37, U301.L6
EXP_IO31: CON301.38, U301.N7
FPGA_BLED: R304.1, U301.B16
FPGA_CBSEL0: U101.F2, U301.K11
FPGA_CBSEL1\: U101.G1, U301.P13
FPGA_CDONE: U101.F1, U301.M10
FPGA_CLK1: R905.1, U301.C8
FPGA_CLK2: R907.1, U301.K9
FPGA_CLK3: R904.1, U301.R9
FPGA_CLK4: R908.1, U301.F7
FPGA_GLED: R303.1, U301.A15
FPGA_MEM_IO0: U301.C13, U302.5
FPGA_MEM_IO1: U301.E13, U302.2
FPGA_MEM_IO2: U301.D14, U302.3
FPGA_MEM_IO3: U301.D13, U302.7
FPGA_MEM_SCK: U301.C14, U302.6
FPGA_RLED: R302.1, U301.A16
FPGA_SPI_SCK: U101.J2, U301.R11
FPGA_SPI_SDI: U101.J1, U301.P11
FPGA_SPI_SDO: U101.H2, U301.P12
FPGA_VPP_FAST: TP3.TP, U301.D12
GND: C101.2, C102.2, C103.2, C104.2, C105.2, C106.2, C107.2, C108.2, C109.2, C110.2, C111.2, C201.2, C202.2, C203.2, C204.2, C205.2, C206.2, C207.2, C208.2, C209.2, C210.2, C211.2, C212.2, C213.2, C214.2, C215.2, C216.2, C217.2, C218.2, C301.2, C302.2, C303.2, C304.2, C305.2, C306.2, C307.2, C308.2, C309.2, C310.2, C311.2, C312.2, C313.2, C314.2, C315.2, C316.2, C317.2, C318.2, C319.2, C401.2, C402.2, C403.2, C404.2, C405.2, C406.2, C407.2, C408.2, C409.2, C410.2, C411.2, C412.2, C413.2, C414.2, C415.2, C416.2, C417.1, C418.2, C420.2, C421.2, C422.2, C423.2, C424.2, C425.2, C426.2, C427.2, C428.2, C431.2, C501.2, C502.2, C503.2, C504.2, C505.2, C506.2, C507.2, C509.2, C510.2, C512.2, C514.2, C516.2, C517.2, C518.1, C519.2, C520.1, C521.2, C522.1, C523.2, C524.1, C525.2, C526.1, C527.2, C528.1, C601.2, C602.2, C603.2, C604.2, C605.2, C607.2, C608.2, C609.2, C610.2, C611.2, C612.2, C613.2, C614.1, C616.2, C617.2, C618.1, C619.2, C620.2, C621.1, C701.2, C702.2, C703.2, C704.2, C705.2, C706.2, C708.2, C709.2, C710.2, C711.2, C718.2, C719.2, C720.2, C721.2, C722.2, C723.2, C724.2, C725.2, C726.2, C801.2, C901.2, C902.2, C903.2, C904.2, C905.2, C906.2, C907.2, C1001.2, C1002.2, C1003.2, C1004.2, C1005.2, C1006.2, C1007.2, C1008.2, C1009.2, C1010.2, C1011.2, C1012.2, C1013.2, C1014.2, C1015.2, C1016.2, C1017.2, C1018.2, C1019.2, C1020.2, C1021.2, C1022.2, C1023.2, C1024.2, C1025.2, C1026.2, C1027.2, C1028.2, C1029.2, C1030.2, CON301.2, CON301.19, CON301.22, CON301.39, D101.1, D201.1, D301.4, D301.5, D301.6, D401.1, D401.2, D501.1, D701.1, D702.1, D1001.1, D1002.1, D1003.1, J701.1, J702.1, J703.1, Q801.2, Q802.2, R201.1, R301.1, R501.1, R509.1, R510.2, R511.1, R512.2, R601.1, R602.1, R603.1, R606.1, R701.1, R702.1, R706.1, R708.1, R710.1, R711.1, R714.1, R715.1, R716.1, R802.1, R901.1, R1001.1, R1002.1, R1004.1, R1008.1, R1011.1, R1014.1, R1015.1, RFCON401.GND@0, RFCON401.GND@1, RFCON401.GND@2, RFCON401.GND@3, RFCON501.GND@0, RFCON501.GND@1, RFCON501.GND@2, RFCON501.GND@3, RFCON502.P$1, RFCON502.P$2, TC101.3, TC201.3, U101.C7, U101.D4, U101.F9, U101.G3, U101.G9, U101.H6, U101.K4, U101.K7, U101.K10, U101.L7, U201.D2, U201.D5, U201.E5, U201.E6, U201.F5, U201.F6, U201.F7, U201.G4, U201.G5, U201.G6, U201.G7, U301.A4, U301.A12, U301.E7, U301.E15, U301.G7, U301.G8, U301.G9, U301.H7, U301.H8, U301.H9, U301.J7, U301.J8, U301.J9, U301.K2, U301.K7, U301.L15, U301.N8, U301.R7, U301.T4, U301.T12, U302.4, U401.3, U402.5, U402.8, U402.11, U402.15, U402.23, U402.31, U402.38, U402.46, U402.48, U402.49, U403.16, U403.33, U501.4, U501.5, U501.6, U501.15, U501.16, U501.19, U501.20, U501.33, U502.6, U502.19, U502.20, U502.25, U502.31, U502.41, U503.2, U503.4, U601.3, U602.8, U602.9, U602.11, U602.18, U602.21, U602.27, U602.31, U602.33, U701.8, U701.41, U702.3, U702.33, U801.11, U801.12, U801.13, U801.14, U801.15, U801.16, U801.17, U801.18, U801.19, U801.20, U801.21, U801.22, U801.23, U801.24, U801.25, U801.26, U801.27, U801.28, U801.29, U801.30, U801.31, U801.32, U801.43, U801.48, U801.49, U801.50, U901.3, U902.21, U1001.7, U1001.10, U1001.11, U1002.2, U1002.5, U1002.8, U1002.19, U1002.21, U1003.2, U1004.2, U1005.2, U1006.3, U1006.7, U1007.3, U1007.7, USB701.A1/B12, USB701.B1/A12, USB1001.A1/B12, USB1001.B1/A12, X401.1, X401.3, X901.1, X901.3
I2S_BRG_D+: D701.4, U702.4, USB701.A6, USB701.B6
I2S_BRG_D-: D701.3, U702.5, USB701.A7, USB701.B7
I2S_BRG_VBUS: C706.1, D701.2, R704.2, R705.2, USB701.A4/B9, USB701.B4/A9
I2S_BRG_VBUS_DET: R705.1, R706.2, U702.8
unnamed: R407.1, R412.1, TRF401.3
unnamed: C430.1, TRF401.4
unnamed: R406.1, R411.2, TRF401.1
unnamed: C508.2, C511.1, R506.2
unnamed: C429.1, TRF401.5
unnamed: C430.2, R413.1, R416.2
unnamed: C429.2, R413.2, R415.2
unnamed: C433.2, RFCON401.SIG
unnamed: C432.2, C433.1, D401.3
unnamed: C432.1, L403.2
unnamed: L403.1, U403.24
unnamed: C424.1, R405.1, R408.1, U403.6
unnamed: C427.1, R404.1, R410.1, U403.7
unnamed: C423.1, R409.2
unnamed: C507.1, R504.2, U501.10
unnamed: R402.2, U401.4
unnamed: C431.1, R414.2, U403.14
unnamed: R701.2, USB701.B5
unnamed: R702.2, USB701.A5
unnamed: L1004.1, U1002.4
unnamed: C712.2, L701.2, R709.1, R710.2
unnamed: C714.2, L705.2, R713.1, R714.2
unnamed: C713.2, L702.2, R711.2
unnamed: L1001.2, U1002.3
unnamed: C715.2, L706.2, R715.2
unnamed: C712.1, U701.38
unnamed: C713.1, U701.40
unnamed: R1001.2, USB1001.B5
unnamed: C714.1, U701.39
unnamed: R1002.2, USB1001.A5
unnamed: C717.1, L704.2, U701.32
unnamed: J703.4, U701.29
unnamed: C716.2, R708.2
unnamed: C717.2, R716.2
unnamed: C716.1, L703.2, U701.31
unnamed: C719.1, R709.2, R713.2, U701.30
unnamed: C715.1, U701.1
unnamed: F1001.2, USB1001.A4/B9, USB1001.B4/A9
unnamed: C515.2, RFCON501.SIG
unnamed: C508.1, U501.7
unnamed: L1002.1, U1001.1
unnamed: C614.2, L602.1, L604.1, R604.1, U602.13
unnamed: C618.2, L604.2, L606.1
unnamed: C613.1, L601.2, L603.1, R604.2, U602.12
unnamed: C617.1, L603.2, L605.1
unnamed: C620.1, C622.1, L605.2
unnamed: C621.2, C623.1, L606.2
unnamed: C518.2, L503.1, R510.1, U502.29
unnamed: C517.1, L502.1, R509.2, U502.28
unnamed: C522.2, L503.2, L507.1
unnamed: C521.1, L502.2, L506.1
unnamed: C505.1, U502.7
unnamed: C520.2, L505.1, R512.1, U502.22
unnamed: C519.1, L504.1, R511.2, U502.23
unnamed: C524.2, L505.2, L509.1
unnamed: C523.1, L504.2, L508.1
unnamed: C615.2, R605.1, R606.2
unnamed: R603.2, U602.22
unnamed: C513.1, R507.1
unnamed: C1009.1, D1001.2, F1001.1, L1003.1
unnamed: R1015.2, U1003.5
unnamed: L203.1, R202.1
unnamed: C218.1, R201.2, U201.C4
unnamed: C215.1, L201.2, U201.J7
unnamed: C216.1, L202.2, U201.B3
unnamed: Q802.3, R804.1
unnamed: Q801.3, R803.1
unnamed: Q801.1, Q802.1, R801.1, R802.2
unnamed: SJ201.2, TC201.7
unnamed: C516.1, U502.34
unnamed: D301.2, R302.2
unnamed: D301.1, R303.2
unnamed: D301.3, R304.2
unnamed: D101.2, R103.1
unnamed: D201.2, R203.1
unnamed: D501.2, R508.1
unnamed: D702.2, R704.1
unnamed: D1003.2, R1013.1
unnamed: D1002.2, R1012.1
RXADC_AIN+: C416.1, C419.1, R406.2, U402.6
RXADC_AIN-: C417.2, C419.2, R407.2, U402.7
RXADC_CLK: U301.P1, U402.10
RXADC_D0: U301.T11, U402.18
RXADC_D1: U301.R10, U402.19
RXADC_D2: U301.T10, U402.20
RXADC_D3: U301.T9, U402.21
RXADC_D4: U301.T8, U402.22
RXADC_D5: U301.T7, U402.26
RXADC_D6: U301.R6, U402.27
RXADC_D7: U301.T6, U402.28
RXADC_D8: U301.R5, U402.32
RXADC_D9: U301.T5, U402.33
RXADC_D10: U301.R4, U402.34
RXADC_D11: U301.R3, U402.35
RXADC_D12: U301.T3, U402.39
RXADC_D13: U301.R2, U402.40
RXADC_D14: U301.T2, U402.41
RXADC_D15: U301.T1, U402.42
RXADC_DITH: U101.K3, U402.17
RXADC_ENC+: C402.1, U402.9
RXADC_GAIN: U101.L3, U402.47
RXADC_OF: U301.R1, U402.43
RXADC_SENSE: R403.2, U402.1
RXADC_SHDN: R401.1, U101.J4, U402.16
RXADC_VCM: C425.1, C426.1, R411.1, R412.2, TRF401.2, U402.2
RXTUNER_DET1: C420.1, U403.4
RXTUNER_DET2: C422.1, U403.5
RXTUNER_I2C_SCL: R405.2, U101.L2
RXTUNER_I2C_SDA: R404.2, U101.K2
RXTUNER_IFN: R416.1, U403.12
RXTUNER_IFP: R415.1, U403.13
RXTUNER_IF_VAGC: R414.1, U101.L5
RXTUNER_PLL_CP: C428.1, R409.1, U403.15
RXTUNER_REFCLK_SEL: U101.J3, U401.1
RXTUNER_TF1N: L401.2, U403.21
RXTUNER_TF1P: L402.2, U403.22
RXTUNER_TF2N: L401.1, U403.19
RXTUNER_TF2P: L402.1, U403.20
RXTUNER_VDD_PLL: C415.1, U403.17
RXTUNER_XTALI: C410.1, R402.1, U403.8, X401.2
RXTUNER_XTALO: C412.1, U403.9, X401.4
SMC_LED: R103.2, U101.B1
SMC_LFXTAL_N: U101.L1, X101.2
SMC_LFXTAL_P: U101.K1, X101.1
SMC_MAIN_CLK: R909.1, U101.L9
SMC_SWCLK: TC101.4, U101.E8
SMC_SWDIO: TC101.2, U101.D8
SMC_SWO: TC101.6, U101.C8
SMC_VCORE: C111.1, U101.F11
SYS_I2C_SCL: R102.1, U101.B9, U801.44, U902.4
SYS_I2C_SDA: R101.1, U101.A9, U801.45, U902.5
TFT_BL_K1: R803.2, U801.2
TFT_BL_K2: R804.2, U801.3
TFT_BL_PWM: R801.2, U101.K11
TFT_DC: U101.J11, U801.37
TFT_SPI_MISO: U101.H5, U801.33
TFT_SPI_MOSI: U101.H4, U801.34
TFT_SPI_SCK: U101.J5, U801.36
TXDAC_AUXI: R513.2, U502.33
TXDAC_AUXQ: R514.2, U502.32
TXDAC_CLKIN: R502.2, U301.D2, U502.18
TXDAC_D0: U301.A7, U502.15
TXDAC_D1: U301.B7, U502.14
TXDAC_D2: U301.A6, U502.13
TXDAC_D3: U301.B6, U502.12
TXDAC_D4: U301.A5, U502.11
TXDAC_D5: U301.B5, U502.10
TXDAC_D6: U301.B4, U502.9
TXDAC_D7: U301.B3, U502.8
TXDAC_D8: U301.A2, U502.4
TXDAC_D9: U301.B2, U502.3
TXDAC_D10: U301.A1, U502.2
TXDAC_D11: U301.B1, U502.1
TXDAC_D12: U301.C2, U502.40
TXDAC_D13: U301.C1, U502.39
TXDAC_DCLK: R502.1, U301.D1, U502.16
TXDAC_RESET: R505.1, U101.A3, U502.35
TXDAC_SCLK: U101.C4, U502.36
TXDAC_SDIO: U101.B4, U502.37
TXMIXER_EN: R501.2, U101.A1, U501.12
TXMIXER_IBBN: C525.1, L506.2, R515.2, U501.14
TXMIXER_IBBP: C526.2, L507.2, R513.1, R515.1, U501.13
TXMIXER_LON: C622.2, U501.22
TXMIXER_LOP: C623.2, U501.21
TXMIXER_OUT: R506.1, RFCON502.P$3
TXMIXER_QBBN: C527.1, L508.2, R516.2, U501.17
TXMIXER_QBBP: C528.2, L509.2, R514.1, R516.1, U501.18
TXMIXER_TEMP: C510.1, R504.1, U101.H10
TXPA_BIAS_EN: R1014.2, U101.C3, U1003.3
TXPA_IN: C511.2, R507.2, U503.1
TXPA_OUT: C513.2, C515.1, L501.1, U503.3
TXPLL_CP_VOUT: C615.1, C616.1, R607.2, U602.7
TXPLL_EN: R601.2, U101.A6, U601.1, U602.4
TXPLL_FASTLOCK_SW: R605.2, U602.5
TXPLL_LE: U101.C5, U602.3
TXPLL_LOCK: U101.C6, U602.25
TXPLL_MUXOUT: U101.A5, U602.30
TXPLL_REF_ACC: C606.2, U602.29
TXPLL_REF_DCC: C606.1, U601.4
TXPLL_SCLK: U101.B5, U602.1
TXPLL_SDATA: U101.D6, U602.2
TXPLL_TEMP: C611.1, C612.1, U602.19
TXPLL_VCOM: C609.1, C610.1, U602.23
TXPLL_VREF: C607.1, C608.1, U602.24
TXPLL_VTUNE: C619.1, R607.1, U602.20
