vankxr/icyradio/firmware/a200t/icyradio.srcs/constrs_1/new/trx_pinout.xdc

# CTRL_IN
set_property IOSTANDARD LVCMOS25 [get_ports {TRX_CTRL_IN[0]}]
set_property IOSTANDARD LVCMOS25 [get_ports {TRX_CTRL_IN[1]}]
set_property IOSTANDARD LVCMOS25 [get_ports {TRX_CTRL_IN[2]}]
set_property IOSTANDARD LVCMOS25 [get_ports {TRX_CTRL_IN[3]}]
set_property PULLDOWN true [get_ports {TRX_CTRL_IN[0]}]
set_property PULLDOWN true [get_ports {TRX_CTRL_IN[1]}]
set_property PULLDOWN true [get_ports {TRX_CTRL_IN[2]}]
set_property PULLDOWN true [get_ports {TRX_CTRL_IN[3]}]
set_property PACKAGE_PIN M15 [get_ports {TRX_CTRL_IN[0]}]
set_property PACKAGE_PIN N18 [get_ports {TRX_CTRL_IN[1]}]
set_property PACKAGE_PIN N20 [get_ports {TRX_CTRL_IN[2]}]
set_property PACKAGE_PIN N19 [get_ports {TRX_CTRL_IN[3]}]
set_property DRIVE 4 [get_ports {TRX_CTRL_IN[0]}]
set_property DRIVE 4 [get_ports {TRX_CTRL_IN[1]}]
set_property DRIVE 4 [get_ports {TRX_CTRL_IN[2]}]
set_property DRIVE 4 [get_ports {TRX_CTRL_IN[3]}]
set_property SLEW SLOW [get_ports {TRX_CTRL_IN[0]}]
set_property SLEW SLOW [get_ports {TRX_CTRL_IN[1]}]
set_property SLEW SLOW [get_ports {TRX_CTRL_IN[2]}]
set_property SLEW SLOW [get_ports {TRX_CTRL_IN[3]}]

# CTRL_OUT
set_property IOSTANDARD LVCMOS25 [get_ports {TRX_CTRL_OUT[0]}]
set_property IOSTANDARD LVCMOS25 [get_ports {TRX_CTRL_OUT[1]}]
set_property IOSTANDARD LVCMOS25 [get_ports {TRX_CTRL_OUT[2]}]
set_property IOSTANDARD LVCMOS25 [get_ports {TRX_CTRL_OUT[3]}]
set_property IOSTANDARD LVCMOS25 [get_ports {TRX_CTRL_OUT[4]}]
set_property IOSTANDARD LVCMOS25 [get_ports {TRX_CTRL_OUT[5]}]
set_property IOSTANDARD LVCMOS25 [get_ports {TRX_CTRL_OUT[6]}]
set_property IOSTANDARD LVCMOS25 [get_ports {TRX_CTRL_OUT[7]}]
set_property PULLDOWN true [get_ports {TRX_CTRL_OUT[0]}]
set_property PULLDOWN true [get_ports {TRX_CTRL_OUT[1]}]
set_property PULLDOWN true [get_ports {TRX_CTRL_OUT[2]}]
set_property PULLDOWN true [get_ports {TRX_CTRL_OUT[3]}]
set_property PULLDOWN true [get_ports {TRX_CTRL_OUT[4]}]
set_property PULLDOWN true [get_ports {TRX_CTRL_OUT[5]}]
set_property PULLDOWN true [get_ports {TRX_CTRL_OUT[6]}]
set_property PULLDOWN true [get_ports {TRX_CTRL_OUT[7]}]
set_property PACKAGE_PIN N22 [get_ports {TRX_CTRL_OUT[0]}]
set_property PACKAGE_PIN D22 [get_ports {TRX_CTRL_OUT[1]}]
set_property PACKAGE_PIN D21 [get_ports {TRX_CTRL_OUT[2]}]
set_property PACKAGE_PIN D17 [get_ports {TRX_CTRL_OUT[3]}]
set_property PACKAGE_PIN G22 [get_ports {TRX_CTRL_OUT[4]}]
set_property PACKAGE_PIN E21 [get_ports {TRX_CTRL_OUT[5]}]
set_property PACKAGE_PIN D19 [get_ports {TRX_CTRL_OUT[6]}]
set_property PACKAGE_PIN E19 [get_ports {TRX_CTRL_OUT[7]}]

# TXDATA Port
set_property IOSTANDARD LVCMOS25 [get_ports {TRX_P0_TXDATA[0]}]
set_property IOSTANDARD LVCMOS25 [get_ports {TRX_P0_TXDATA[1]}]
set_property IOSTANDARD LVCMOS25 [get_ports {TRX_P0_TXDATA[2]}]
set_property IOSTANDARD LVCMOS25 [get_ports {TRX_P0_TXDATA[3]}]
set_property IOSTANDARD LVCMOS25 [get_ports {TRX_P0_TXDATA[4]}]
set_property IOSTANDARD LVCMOS25 [get_ports {TRX_P0_TXDATA[5]}]
set_property IOSTANDARD LVCMOS25 [get_ports {TRX_P0_TXDATA[6]}]
set_property IOSTANDARD LVCMOS25 [get_ports {TRX_P0_TXDATA[7]}]
set_property IOSTANDARD LVCMOS25 [get_ports {TRX_P0_TXDATA[8]}]
set_property IOSTANDARD LVCMOS25 [get_ports {TRX_P0_TXDATA[9]}]
set_property IOSTANDARD LVCMOS25 [get_ports {TRX_P0_TXDATA[10]}]
set_property IOSTANDARD LVCMOS25 [get_ports {TRX_P0_TXDATA[11]}]
set_property PULLDOWN true [get_ports {TRX_P0_TXDATA[0]}]
set_property PULLDOWN true [get_ports {TRX_P0_TXDATA[1]}]
set_property PULLDOWN true [get_ports {TRX_P0_TXDATA[2]}]
set_property PULLDOWN true [get_ports {TRX_P0_TXDATA[3]}]
set_property PULLDOWN true [get_ports {TRX_P0_TXDATA[4]}]
set_property PULLDOWN true [get_ports {TRX_P0_TXDATA[5]}]
set_property PULLDOWN true [get_ports {TRX_P0_TXDATA[6]}]
set_property PULLDOWN true [get_ports {TRX_P0_TXDATA[7]}]
set_property PULLDOWN true [get_ports {TRX_P0_TXDATA[8]}]
set_property PULLDOWN true [get_ports {TRX_P0_TXDATA[9]}]
set_property PULLDOWN true [get_ports {TRX_P0_TXDATA[10]}]
set_property PULLDOWN true [get_ports {TRX_P0_TXDATA[11]}]
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
set_property DRIVE 4 [get_ports {TRX_P1_RXDATA[0]}]
set_property DRIVE 4 [get_ports {TRX_P1_RXDATA[1]}]
set_property DRIVE 4 [get_ports {TRX_P1_RXDATA[2]}]
set_property DRIVE 4 [get_ports {TRX_P1_RXDATA[3]}]
set_property DRIVE 4 [get_ports {TRX_P1_RXDATA[4]}]
set_property DRIVE 4 [get_ports {TRX_P1_RXDATA[5]}]
set_property DRIVE 4 [get_ports {TRX_P1_RXDATA[6]}]
set_property DRIVE 4 [get_ports {TRX_P1_RXDATA[7]}]
set_property DRIVE 4 [get_ports {TRX_P1_RXDATA[8]}]
set_property DRIVE 4 [get_ports {TRX_P1_RXDATA[9]}]
set_property DRIVE 4 [get_ports {TRX_P1_RXDATA[10]}]
set_property DRIVE 4 [get_ports {TRX_P1_RXDATA[11]}]
set_property SLEW SLOW [get_ports {TRX_P1_RXDATA[0]}]
set_property SLEW SLOW [get_ports {TRX_P1_RXDATA[1]}]
set_property SLEW SLOW [get_ports {TRX_P1_RXDATA[2]}]
set_property SLEW SLOW [get_ports {TRX_P1_RXDATA[3]}]
set_property SLEW SLOW [get_ports {TRX_P1_RXDATA[4]}]
set_property SLEW SLOW [get_ports {TRX_P1_RXDATA[5]}]
set_property SLEW SLOW [get_ports {TRX_P1_RXDATA[6]}]
set_property SLEW SLOW [get_ports {TRX_P1_RXDATA[7]}]
set_property SLEW SLOW [get_ports {TRX_P1_RXDATA[8]}]
set_property SLEW SLOW [get_ports {TRX_P1_RXDATA[9]}]
set_property SLEW SLOW [get_ports {TRX_P1_RXDATA[10]}]
set_property SLEW SLOW [get_ports {TRX_P1_RXDATA[11]}]

# Clocks
set_property IOSTANDARD LVCMOS25 [get_ports TRX_DATA_CLK]
set_property IOSTANDARD LVCMOS25 [get_ports TRX_FBCLK]
set_property IOSTANDARD LVCMOS25 [get_ports TRX_CLK_OUT]
set_property PULLDOWN true [get_ports TRX_DATA_CLK]
set_property PULLDOWN true [get_ports TRX_FBCLK]
set_property PULLDOWN true [get_ports TRX_CLK_OUT]
set_property PACKAGE_PIN K18 [get_ports TRX_DATA_CLK]
set_property PACKAGE_PIN J19 [get_ports TRX_FBCLK]
set_property PACKAGE_PIN J20 [get_ports TRX_CLK_OUT]

# Change to 16.27 ns for 61.44 MHz TRX_DATA_CLK
create_clock -name TRX_DATA_CLK -period 8.13 [get_ports TRX_DATA_CLK]
#create_clock -name TRX_CLK_OUT -period 3.125 [get_ports TRX_CLK_OUT]

# Control IOs
set_property IOSTANDARD LVCMOS25 [get_ports {TRX_RESETn[0]}]
set_property IOSTANDARD LVCMOS25 [get_ports TRX_EN]
set_property IOSTANDARD LVCMOS25 [get_ports TRX_TXNRX]
set_property IOSTANDARD LVCMOS25 [get_ports {TRX_EN_AGC[0]}]
set_property IOSTANDARD LVCMOS25 [get_ports TRX_RXFRAME]
set_property IOSTANDARD LVCMOS25 [get_ports TRX_TXFRAME]
set_property IOSTANDARD LVCMOS25 [get_ports {TRX_SYNC_IN[0]}]
set_property PULLDOWN true [get_ports {TRX_RESETn[0]}]
set_property PULLDOWN true [get_ports TRX_EN]
set_property PULLDOWN true [get_ports TRX_TXNRX]
set_property PULLDOWN true [get_ports {TRX_EN_AGC[0]}]
set_property PULLDOWN true [get_ports TRX_RXFRAME]
set_property PULLDOWN true [get_ports TRX_TXFRAME]
set_property PULLDOWN true [get_ports {TRX_SYNC_IN[0]}]
set_property PACKAGE_PIN G16 [get_ports {TRX_RESETn[0]}]
set_property PACKAGE_PIN F16 [get_ports TRX_EN]
set_property PACKAGE_PIN F14 [get_ports TRX_TXNRX]
set_property PACKAGE_PIN F15 [get_ports {TRX_EN_AGC[0]}]
set_property PACKAGE_PIN K22 [get_ports TRX_RXFRAME]
set_property PACKAGE_PIN K21 [get_ports TRX_TXFRAME]
set_property PACKAGE_PIN F18 [get_ports {TRX_SYNC_IN[0]}]
set_property DRIVE 4 [get_ports {TRX_RESETn[0]}]
set_property DRIVE 4 [get_ports TRX_EN]
set_property DRIVE 4 [get_ports TRX_TXNRX]
set_property DRIVE 4 [get_ports {TRX_EN_AGC[0]}]
set_property DRIVE 4 [get_ports {TRX_SYNC_IN[0]}]
set_property SLEW SLOW [get_ports {TRX_RESETn[0]}]
set_property SLEW SLOW [get_ports TRX_EN]
set_property SLEW SLOW [get_ports TRX_TXNRX]
set_property SLEW SLOW [get_ports {TRX_EN_AGC[0]}]
set_property SLEW SLOW [get_ports {TRX_SYNC_IN[0]}]

# SPI
set_property IOSTANDARD LVCMOS25 [get_ports TRX_SPI_io0_io]
set_property IOSTANDARD LVCMOS25 [get_ports TRX_SPI_io1_io]
set_property IOSTANDARD LVCMOS25 [get_ports TRX_SPI_sck_io]
set_property IOSTANDARD LVCMOS25 [get_ports {TRX_SPI_ss_io[0]}]
set_property PULLDOWN true [get_ports TRX_SPI_io0_io]
set_property PULLUP true [get_ports TRX_SPI_io1_io]
set_property PULLDOWN true [get_ports TRX_SPI_sck_io]
set_property PULLUP true [get_ports {TRX_SPI_ss_io[0]}]
set_property PACKAGE_PIN G17 [get_ports TRX_SPI_io0_io]
set_property PACKAGE_PIN G18 [get_ports TRX_SPI_io1_io]
set_property PACKAGE_PIN G15 [get_ports TRX_SPI_sck_io]
set_property PACKAGE_PIN G13 [get_ports {TRX_SPI_ss_io[0]}]
set_property DRIVE 4 [get_ports TRX_SPI_io0_io]
set_property DRIVE 4 [get_ports TRX_SPI_io1_io]
set_property DRIVE 4 [get_ports TRX_SPI_sck_io]
set_property DRIVE 4 [get_ports {TRX_SPI_ss_io[0]}]
set_property SLEW SLOW [get_ports TRX_SPI_io0_io]
set_property SLEW SLOW [get_ports TRX_SPI_io1_io]
set_property SLEW SLOW [get_ports TRX_SPI_sck_io]
set_property SLEW SLOW [get_ports {TRX_SPI_ss_io[0]}]

create_generated_clock -name TRX_SPI_SCK -source [get_pins -hier "*axi_spi_0/aclk"] -divide_by 4 [get_ports TRX_SPI_sck_io]
set_multicycle_path 4 -setup -from TRX_SPI_SCK -to [get_clocks -of_objects [get_pins -hier "*axi_spi_0/aclk"]]
set_multicycle_path 3 -hold -end -from TRX_SPI_SCK -to [get_clocks -of_objects [get_pins -hier "*axi_spi_0/aclk"]]
set_multicycle_path 4 -setup -start -from [get_clocks -of_objects [get_pins -hier "*axi_spi_0/aclk"]] -to TRX_SPI_SCK
set_multicycle_path 3 -hold -from [get_clocks -of_objects [get_pins -hier "*axi_spi_0/aclk"]] -to TRX_SPI_SCK

# I/O Delays
## Datasheet parameters (fill from datasheet timing tables)
set tco_min   3
set tco_max   8
set tsu       2
set thd       1

## PCB delays (fill from board estimates or PCB tool)
set pcb_clk   0.235
set pcb_data  0.203

## Derived delays
set in_delay_min  [expr {$tco_min + $pcb_data + $pcb_clk}]
set in_delay_max  [expr {$tco_max + $pcb_data + $pcb_clk}]
set out_delay_min [expr {-$thd + $pcb_data - $pcb_clk}]
set out_delay_max [expr {$tsu + $pcb_data - $pcb_clk}]

set_input_delay -clock TRX_SPI_SCK -clock_fall -max $in_delay_max [get_ports TRX_SPI_io0_io]
set_input_delay -clock TRX_SPI_SCK -clock_fall -min $in_delay_min [get_ports TRX_SPI_io0_io]
set_input_delay -clock TRX_SPI_SCK -clock_fall -max $in_delay_max [get_ports TRX_SPI_io1_io]
set_input_delay -clock TRX_SPI_SCK -clock_fall -min $in_delay_min [get_ports TRX_SPI_io1_io]

set_output_delay -clock TRX_SPI_SCK -max $out_delay_max [get_ports TRX_SPI_io0_io]
set_output_delay -clock TRX_SPI_SCK -min $out_delay_min [get_ports TRX_SPI_io0_io]
set_output_delay -clock TRX_SPI_SCK -max $out_delay_max [get_ports TRX_SPI_io1_io]
set_output_delay -clock TRX_SPI_SCK -min $out_delay_min [get_ports TRX_SPI_io1_io]
