vankxr/icyradio/firmware/a100t/icyradio.gen/sources_1/bd/icyradio/ip/icyradio_gpio_slice_trx_ctrl_out_0/synth/icyradio_gpio_slice_trx_ctrl_out_0.v

// (c) Copyright 1986-2022 Xilinx, Inc. All Rights Reserved.
// (c) Copyright 2022-2025 Advanced Micro Devices, Inc. All rights reserved.
// 
// This file contains confidential and proprietary information
// of AMD and is protected under U.S. and international copyright
// and other intellectual property laws.
// 
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
// CRITICAL APPLICATIONS
// AMD products are not designed or intended to be fail-
// safe, or for use in any application requiring fail-safe
// performance, such as life-support or safety devices or
// systems, Class III medical devices, nuclear facilities,
// applications related to the deployment of airbags, or any
// other applications that could lead to death, personal
// injury, or severe property or environmental damage
// (individually and collectively, "Critical
// Applications"). Customer assumes the sole risk and
// liability of any use of AMD products in Critical
// Applications, subject only to applicable laws and
// regulations governing limitations on product liability.
// 
// THIS COPYRIGHT NOTICE AND DISCLAIMER MUST BE RETAINED AS
// PART OF THIS FILE AT ALL TIMES.
// 
// DO NOT MODIFY THIS FILE.


// IP VLNV: xilinx.com:ip:xlslice:1.0
// IP Revision: 3

(* X_CORE_INFO = "xlslice_v1_0_3_xlslice,Vivado 2023.2" *)
(* CHECK_LICENSE_TYPE = "icyradio_gpio_slice_trx_ctrl_out_0,xlslice_v1_0_3_xlslice,{}" *)
(* CORE_GENERATION_INFO = "icyradio_gpio_slice_trx_ctrl_out_0,xlslice_v1_0_3_xlslice,{x_ipProduct=Vivado 2023.2,x_ipVendor=xilinx.com,x_ipLibrary=ip,x_ipName=xlslice,x_ipVersion=1.0,x_ipCoreRevision=3,x_ipLanguage=VERILOG,x_ipSimLanguage=MIXED,DIN_WIDTH=32,DIN_FROM=3,DIN_TO=0}" *)
(* DowngradeIPIdentifiedWarnings = "yes" *)
module icyradio_gpio_slice_trx_ctrl_out_0 (
  Din,
  Dout
);

input wire [31 : 0] Din;
output wire [3 : 0] Dout;

  xlslice_v1_0_3_xlslice #(
    .DIN_WIDTH(32),
    .DIN_FROM(3),
    .DIN_TO(0)
  ) inst (
    .Din(Din),
    .Dout(Dout)
  );
endmodule
