vankxr/icyradio/firmware/a100t/icyradio.srcs/constrs_1/new/ext_io_pinout.xdc

# Header 1 (Near DDR)
## EXT_IO_1_1
#set_property IOSTANDARD LVCMOS33 [get_ports EXT_IO_1_1]
#set_property PACKAGE_PIN AA9 [get_ports EXT_IO_1_1]
set_property IOSTANDARD LVCMOS33 [get_ports EXT_I2C_scl_io]
set_property PULLUP true [get_ports EXT_I2C_scl_io]
set_property PACKAGE_PIN AA9 [get_ports EXT_I2C_scl_io]
## EXT_IO_1_2
#set_property IOSTANDARD LVCMOS33 [get_ports EXT_IO_1_2]
#set_property PACKAGE_PIN AA11 [get_ports EXT_IO_1_2]
set_property IOSTANDARD LVCMOS33 [get_ports EXT_I2C_sda_io]
set_property PULLUP true [get_ports EXT_I2C_sda_io]
set_property PACKAGE_PIN AA11 [get_ports EXT_I2C_sda_io]
## EXT_IO_1_3
#set_property IOSTANDARD LVCMOS33 [get_ports EXT_IO_1_3]
#set_property PACKAGE_PIN AB10 [get_ports EXT_IO_1_3]
## EXT_IO_1_4
#set_property IOSTANDARD LVCMOS33 [get_ports EXT_IO_1_4]
#set_property PACKAGE_PIN AB11 [get_ports EXT_IO_1_4]
## EXT_IO_1_5
#set_property IOSTANDARD LVCMOS33 [get_ports EXT_IO_1_5]
#set_property PACKAGE_PIN AA10 [get_ports EXT_IO_1_5]
## EXT_IO_1_6 - GND

# Header 2 (Near RFIC)
## EXT_IO_2_1 - GND
## EXT_IO_2_2
#set_property IOSTANDARD LVCMOS25 [get_ports EXT_IO_2_2]
#set_property PACKAGE_PIN A16 [get_ports EXT_IO_2_2]
## EXT_IO_2_3 - Clock from clock manager
## EXT_IO_2_4
#set_property IOSTANDARD LVCMOS25 [get_ports EXT_IO_2_4]
#set_property PACKAGE_PIN A15 [get_ports EXT_IO_2_4]
## EXT_IO_2_5 - GND
## EXT_IO_2_6
#set_property IOSTANDARD LVCMOS25 [get_ports EXT_IO_2_6]
#set_property PACKAGE_PIN A14 [get_ports EXT_IO_2_6]
