vankxr/icyradio/firmware/a100t/icyradio.srcs/constrs_1/new/misc.xdc

set_property CFGBVS VCCO [current_design]
set_property CONFIG_VOLTAGE 3.3 [current_design]
set_property CONFIG_MODE SPIx4 [current_design]

set_property BITSTREAM.GENERAL.COMPRESS TRUE [current_design]
set_property BITSTREAM.CONFIG.CONFIGRATE 66 [current_design]
set_property BITSTREAM.CONFIG.DONEPIN PULLNONE [current_design]
set_property BITSTREAM.CONFIG.CCLKPIN PULLNONE [current_design]
set_property BITSTREAM.CONFIG.INITPIN PULLNONE [current_design]
set_property BITSTREAM.CONFIG.M1PIN PULLNONE [current_design]
set_property BITSTREAM.CONFIG.M2PIN PULLDOWN [current_design]
set_property BITSTREAM.CONFIG.M0PIN PULLNONE [current_design]
set_property BITSTREAM.CONFIG.SPI_BUSWIDTH 4 [current_design]
set_property BITSTREAM.CONFIG.USR_ACCESS AABBCCDD [current_design]
