vankxr/icyradio/(commit log)

2019-09-21 Added SPI slave with lots of registers Changed some names and comments Added IRQ logic
    [icyradio.brd, icyradio.sch]
2019-09-27 Add testbenches Change toolchain flow
    [icyradio.brd, icyradio.sch]
2019-10-01 Huge PCB layout progress
    [icyradio.brd, icyradio.sch]
2019-10-03 Nothing to do
    [icyradio.brd, icyradio.sch]
2019-10-05 PCB needs machine gunning
    [icyradio.brd, icyradio.sch]
2019-10-06 I think it dun
    [icyradio.brd, icyradio.sch]
2019-10-07 Added FPGA SPI memory
    [icyradio.brd, icyradio.sch]
2019-10-07 Fixed FPGA VCC_2V5 connected to 1V2
    [icyradio.brd, icyradio.sch]
2019-10-08 Production ready, ordered
    [icyradio.brd, icyradio.sch, icyradio.xlsx]
2019-10-09 Added interpolation CIC filter (needs testing)
2019-10-10 Forgot to connect DAC common-mode, easy hardware fix tho
    [icyradio.brd, icyradio.sch, icyradio.xlsx]
2019-10-11 Added LNA/Bias T board
    [icyradio-lna.brd, icyradio-lna.sch, icyradio-main.brd, icyradio-main.sch, icyradio-main.xlsx]
2019-10-18 Remove useless files Some updates
    [icyradio-main.brd, icyradio-main.sch]
2019-10-18 Change FIR Filter coefficients
2019-10-27 Change DSP main clock to 12 MHz Added clock frequency calculations on DSP
    [icyradio-main.sch]
2019-11-09 Changed FIR size to 32 (max) Added correct SAM NVIC interrupt vectors@
2019-12-21 Remove wrong LCSC item numbers
    [icyradio-main.brd, icyradio-main.sch]
2019-12-27 Update libraries
    [icyradio-main.brd, icyradio-main.sch]
2019-12-30 Sync library updates on LNA PCB
    [icyradio-lna.brd, icyradio-lna.sch]
2019-12-30 Sync library updates on main PCB
    [icyradio-main.sch]
2020-01-02 Fix silkscreen error
    [icyradio-main.brd]
2020-01-02 Fix TRS Jack name on tPlace
    [icyradio-main.brd, icyradio-main.sch]
2020-01-04 Change wrong RGB LED package Change wrong DSC12x package Add extra 100nF capacitor Add extra 10K pullup on FPGA_CDONE Update schematic PDF Update board images Work on software Work on HDL
    [icyradio-main.brd, icyradio-main.sch]
2020-01-08 FPGA bitstream load function finished Started reworking CMU API Started reworking SI5351 API Add more FPGA test code Add a SI5351 simulator utility
    [icyradio-main.brd]
2020-02-02 Finished SI5351 library (almost) Finished new CMU library Added R820T2 tuner library First FFT with raw ADC data
2020-02-02 Change FPGA_CBSEL0 signal name to FPGA_SMC_IRQ Added AD9117 library Extensively tested (lol) R820T2 library Added ARM CMSIS DSP functions to compute FFT in the SMC Small changes to the Verilog design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
    [icyradio-main.brd, icyradio-main.sch]
2020-02-03 Added ADF4351 library First TX chain test, successful Added a sine wave LUT to better test the DAC
2020-02-09 Work on DSP peripheral libraries First FM demodulation, success! Added IQ swap control bit to the DDC Changed the control SPI MISO so be Hi-Z if not selected Fixed corrupted reads Fixed corrupted wri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
    [icyradio-main.sch]
2020-02-15 Reworked FIR coefficient generator to a full DSP chain analyzer Implemented DMA circular buffers in the DSP Implemented a basic anti-aliasing filter in the DSP Implemented a performance analyzer in t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
    [main.c]
2020-02-20 Fixed CDC issues Changed DAC LUT to 512 samples
    [main.c]
2020-02-24 Display ADC FFT
2020-03-04 Add TXPLL filter details
2020-03-16 Fix TFT orientation bug Increase CODEC PLL charge pump currents Decrease FPGA control SPI clock
    [main.c]
2020-03-17 Finally fix output audio noise (reduce CODEC SDM rate) Optimize DSP code by using CMSIS DSP functions in more places
    [main.c]
2020-03-18 Changed DDC CIC to 3 stages instead of 4 Changes to interpolating CIC (needs testing) Added QDUC Removed DAC Sine LUT Removed OF bit from ADC DPRAM Separated IRQ control, status and mask registers Re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
    [ddc.v, main.c]
2020-03-19 Fix dumb mistake in synchronizer module Optimize DDC and QDUC clock dividers QDUC was not working, applied a fix, needs testing Invert TxDAC output samples Fixed IRQ synchronization Simplified IRQ lo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
    [ddc.v, main.c]
2020-05-09 Fix big dumb and annoying mistake in DSP PIO macro Play around with QDUC
    [main.c]
2020-05-18 Tidy up HDL Add SSB modulation MATLAB script
    [icyradio-lna.sch, icyradio-main.brd, icyradio-main.sch, icyradio-upconverter.brd, icyradio-upconverter.sch]
2020-05-30 Move upconverter to other repository Small I2S master Verilog change Add dsp OpenOCD script
    [icyradio-upconverter.brd, icyradio-upconverter.sch]
2020-06-16 Added CP2615 code Misc software changes Sync libraries
    [icyradio-lna.brd, icyradio-lna.sch, icyradio-main.brd, icyradio-main.sch]
2020-07-03 Fix DSP generated baseband Add TX spectrum pictures
    [main.c]
2020-07-09 Remoce DAC AC swing limiting resistors Change PLL reference AC couple capacitor to 10pF
    [icyradio-main.brd, icyradio-main.sch]
2020-07-14 Fix IQ swap functionality on QDDC Remove unnecessary reset bit check
    [tuner.v]
2020-07-14 Add a tuner to the QDUC Fix indentation in FPGA library Reduce NCO LUT size to 512x4 instead of 1024x4 Disable QSPI Verilog module
    [tuner.v]
2020-07-15 Narower audio filter Implement oscillator
    [main.c]
2020-07-15 Add SPI slave interface to DSP
2020-07-15 Add DSP interface library to SMC software Fixed SPI write
    [main.c]
2020-07-15 Move SPI registers to DTCM Move SPI ISR to ITCM
2020-07-15 Add SPI macros
2020-07-17 Revert some SPI stuff since it was too much
    [main.c]
2020-07-21 Fix DSP cache macro Fix baseband I2S DMA init typo Moved all ISRs to ITCM memory Wait until XDMAC channel is disabled/enabled Fix error in xdmac_ch_get_remaining_xfers Re-add DSP SPI interface using 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
    [main.c]
2020-08-06 Updated block diagram Changed CICs to allow processing at a higher clock while working on completely different in/out sampling rates Removed QDDC FIR Re-enabled QSPI module Changed QDDC/QDUC NCO freq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
2020-08-07 Tune TX DAC DC offset Add DSP TRNG library Tiny renames and fixes
    [main.c]
2020-08-07 Remove DSP SPI completely
2020-08-10 Added sparse FIR filter API
2020-08-23 Add new sparse Hilbert filter Separate RX and TX DSP chains
2020-09-07 Small HDL changes Added RLE compression to FPGA bitstream Fixed overlapping text in schematic
    [icyradio-main.sch]
2020-09-09 Change final amplifier to ADL5610
    [icyradio-main.brd, icyradio-main.sch]
2020-09-16 Fixed line width
    [icyradio-main.brd]
2020-10-12 Forgot to add RLE library to stage
2020-10-12 Change TFT backlight PWM frequency to 50 kHz Remove RX Tuner frequency select and fix frequency to new 0.5ppm 32 MHz TCXO
    [main.c]
2020-10-13 Change TX PLL loop filter
    [icyradio-main.brd, icyradio-main.sch]
2020-10-13 Add TX PLL loop filter reports
2020-11-01 Add AFEC API to measure temperature (toasy IC)
2020-11-08 Add register to CIC output stage and truncate result to output size Changed DDC and DUC parameters
2020-11-08 Add CLI application to dump samples to stdout
2020-11-28 Implement PLL IP in HDL to reduce input frequency Run ADC at half the frequency to remove first QDDC CIC decimation stage Print HDL related frequencies on SMC startup
2020-11-28 Change baseband rate to 768 ksps Align cached buffers to 32 byte-boundary to prevent undefined behaviour when invalidating unaligned cache
    [main.c]
2020-12-19 Try to brute-force mixer temperature with unofficial information, seems to work better than before
2021-01-23 Fix wrong test datarate reports Add sample rate test report
2021-01-23 Use SI5351 PLL name macros Write SI5351 MultiSynth registers in the correct order to produce accurate clock frequencies
    [main.c]
2021-01-31 Update arm gcc toolchain
2021-02-01 Fix ADC stuck in low accuracy bias mode
2021-02-22 DSP USB callbacks, vendor requests moved to main.c New attempt at SPI control interface, added DSP base code, working so far
2021-02-22 New attempt at SPI control interface, added SMC base code, working so far Change DAC full scale current to prevent final amplifier saturation while mantaining 14-bit precision Changed RX IF configura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
    [main.c]
2021-03-30 Start hardware v2 schematic work
    [icyradio-main.brd, icyradio-main.sch, icyradio-main.xlsx]
2021-05-13 Change TCXO
    [icyradio-main.brd, icyradio-main.sch]
2021-06-08 Sync work
    [icyradio-main.brd, icyradio-main.sch]
2021-06-10 Work on PCB
    [icyradio-main.brd, icyradio-main.sch]
2021-07-27 Major design changes
    [icyradio-main.brd, icyradio-main.sch]
2021-09-15 Update FPGA Misc design changes
    [icyradio-main.brd, icyradio-main.sch]
2021-09-23 PCB Work
    [icyradio-main.brd, icyradio-main.sch]
2021-09-26 Add kernel driver development environment
2021-09-26 Work on schematic
    [icyradio-main.brd, icyradio-main.sch]
2021-11-27 Update Core CMSIS on DSP Fix unaligned assembly on exc_handler.c
2022-09-26 Work on Schematic and PCB
    [icyradio-main.brd, icyradio-main.sch]
2022-09-26 Add Eagle schematic rename scripts to gitibnore
2022-09-30 Update Device and Core CMSIS Add script to generate GCC defines for VSCode configuration
2022-10-02 Removed SMC and DSP software as they are no longer present in the v2 design
    [main.c, utils.h]
2022-10-22 Start DDR routing
    [icyradio-main.brd, icyradio-main.sch]
2022-10-22 Remove second DDR3 chip as it was impossible to route with a 6-layer board Update HDL project to reflect hardware changes
    [icyradio-main.brd, icyradio-main.sch]
2022-10-28 DDR3 routing finished Some more PCB progress
    [icyradio-main.brd, icyradio-main.sch]
2022-10-29 PCB routing
    [icyradio-main.brd, icyradio-main.sch]
2022-11-02 More routing
    [icyradio-main.brd, icyradio-main.sch]
2022-11-11 First nothing to do!
    [icyradio-main.brd, icyradio-main.sch]
2022-11-17 Some PCB touches
    [icyradio-main.brd, icyradio-main.sch]
2022-11-17 Add schematic PDF and first PCB renders
2023-01-08 Minor updates
    [icyradio-main.brd, icyradio-main.sch]
2023-01-13 Silk screen done
    [icyradio-main.brd, icyradio-main.sch]
2023-02-26 Minor changes
    [icyradio-main.brd, icyradio-main.sch]
2023-02-26 Remove dedicated DDR3 oscillator
    [icyradio-main.brd, icyradio-main.sch]
2023-02-26 Finish checklist and generate gerbers
    [icyradio-main.brd, icyradio-main.sch]
2023-03-05 Some PCB rectifications and removal of old gerbers
    [icyradio-main.brd, icyradio-main.sch]
2023-03-12 Set values for current limit switches Final touches for production Re-generate gerbers, schematic PDF and PCB pictures
    [icyradio-main.brd, icyradio-main.sch]
2023-09-18 Add Power Management Controller MCU software Start working on MCU peripheral libraries for the ATSAMD
2023-09-19 Add LT7182S library Progress in PMC software for basic board bringup
2023-09-19 Mention LT7182S WP pin errata
2023-09-21 Kernel driver work for basic board testing
2023-09-22 Add expansion board template
    [icyradio-exp-template.brd, icyradio-exp-template.sch]
2023-10-01 Basic kernel driver that implements mmap
2023-10-01 HDL Work Fix TRX_FB_CLK and TRX_DATA_CLK FPGA pin swap Fix AXI PCIe only asking for 1 MB at BAR2 while QSPI flash is 8 MB
    [icyradio_axi_gpio_0_0_sim_netlist.v, icyradio_axi_gpio_0_0_sim_netlist.vhdl, icyradio_axi_gpio_0_0_stub.v, icyradio_axi_gpio_0_0_stub.vhdl, icyradio_gpio_slice_trx_sync_in_0.v]
2023-10-01 Update PCB pad color
    [icyradio-main.brd]
2023-10-05 Change comments in kernel driver file to reflect HDL changes
2023-10-06 Change mmWave synth loop filter values Change mmWave synth CE pulldown value Remove mmWave synth nRESET pulldown (DNP)
    [icyradio-main.brd, icyradio-main.sch]
2023-10-06 Add expansion board PCB template
    [icyradio-exp-template.brd, icyradio-exp-template.sch]
2023-10-11 Work on kernel driver Add more fops Implement IRQs Implement DMA buffer allocation and mamping to userspace
2023-10-13 Fix bug in LT7182S library - L11 write Misc PMC software changes
    [main.c]
2023-10-13 Fix power tree in schematic
    [icyradio-main.sch]
2023-10-13 Add IOCTL to query number of IRQ lines allocated Misc driver changes
2023-10-15 Add IOCTL call to flush IRQs, allowing a blocked thread polling for interrupts to be unblocked Add udev rules Minor driver changes
2023-10-15 Fix board shutting down when CM4 reboots
    [main.c]
2023-10-26 Fix mmWave Synth not locking Change AXI Quad SPI select to bool
    [main.c]
2023-10-31 Add Kernel driver github workflow
2023-11-01 Build kernel driver DKMS debian package
2023-11-13 HDL: Add level/edge interrupt modes and polarity inversion HDL: Stop using IIC IP GPOs
2023-11-13 CLI Tool: Change time interval in AXI DMAC checks CLI Tool: Add timeouts to AXI IIC transactions CLI Tool: Fix AXI IIC race conditions and add workaround for IP Core bugs CLI Tool: Disable AXI IIC GP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
    [axi_gpio.h, main.c]
2023-11-13 Driver: Ignore dependency files
2023-11-13 PMC: Reboot CM4 instead of shutting system off to work around crappy SD Cards that won't allow it to properly reboot
    [main.c]
2023-11-13 Soapy: Change time interval in AXI DMAC checks Soapy: Add timeouts to AXI IIC transactions Soapy: Fix AXI IIC race conditions and add workaround for IP Core bugs Soapy: Disable AXI IIC GPOs Soapy: Al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
    [AXIGPIO.hpp, SoapySettings.cpp]
2023-11-13 Add expansion board template MCU firmware
2023-11-20 driver: Read the device DNA (serial) on probe driver: Add IOCTL call to retrieve the DNA for faster device enumeration and identification driver: Change initialization order when probing driver: Misc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
2023-11-20 pmc: Add integer versions of the ADC readout methods pmc: Fix bug in the NO_VOLTAGE_ENABLED macro pmc: Rework SERCOM library, adding support for slave I2C and multiple modes at the same time pmc: Add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
    [main.c]
2023-11-20 exp_template: Change optimization to O3 instead of Os since we are not space constrained exp_template: Add integer versions of the ADC readout methods exp_template: Rework SERCOM library, adding supp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
    [main.c]
2023-11-20 soapy: Use the new IOCTL call on enumeration soapy: Si5351: Move device ID/revision support checks to constructor instead of init function soapy: Si5351: Normalize phase to 0-360 instead of throwing 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
    [SoapySettings.cpp]
2024-02-19 hdl: New SPI/QSPI modules hdl: New GPIO modules hdl: Major changes
2024-02-19 soapy: mmWave Synth work soapy: Driver for new AXI GPIO module soapy: Driver for new AXI SPI module soapy: Fix typos in exception messages in AXI I2S soapy: Fix wrong clock divider calculation in AXI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
    [AXIGPIO.cpp, AXIGPIO.hpp, SoapySettings.cpp]
2024-02-19 pmc: Add ROM-like memory for reading via I2C pmc: Minor changes
2024-02-19 exp: Add ROM-like memory for reading via I2C
2024-02-21 driver: Fix build errors on kernel >6.3 driver: Bump RPi kernel branch to stable_20240124
    [icyradio.c]
2024-03-27 pmc: Enable pulldown on CM4_RUNNING pin
2024-03-27 driver: Ensure compatibility with newer kernel versions driver: Add IRQ noflush ioctl driver: Read DNA data from the kernel driver: Add IRQ spinlock driver: Add device table mutex and per-device mutex
2024-03-27 soapy: Major changes soapy: Use recursive mutexes where code density gets reduced soapy: Reduce default timeout on AD9361 calibrations soapy: Add AD9361 clear state before initialization soapy: Add A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
2024-03-27 Update soapy build flow
2024-03-27 driver: Use kernel built-in logging priorities
2026-03-26 soapy: Update AXI I2S core driver
